Cinthanh1998/Du-an-Foxconn/MVIMG_20251112_134305.jpg

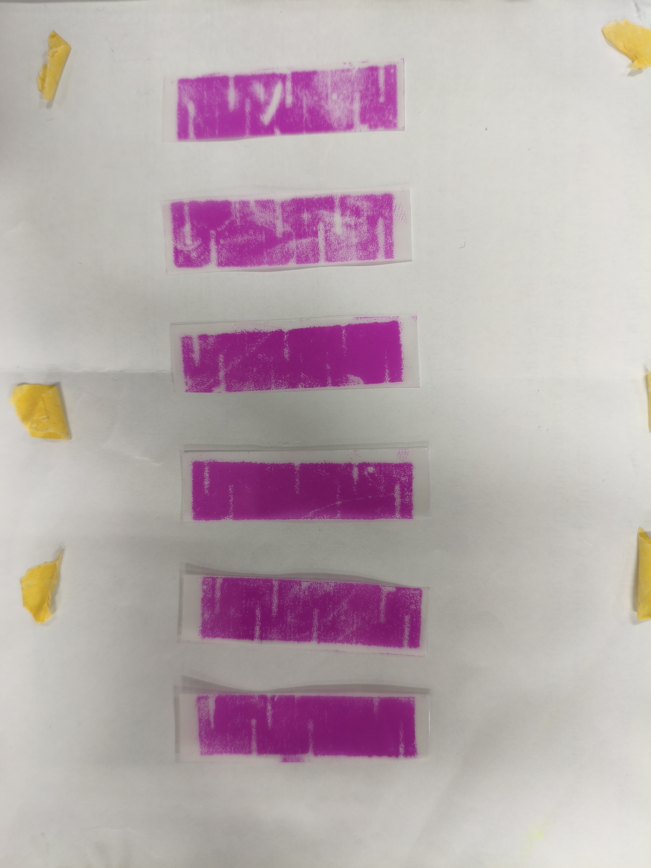
MVIMG_20251112_134305.jpg
