Cinthanh1998/Du-an-Foxconn/IMG_1768631609765_1768632025120.jpg

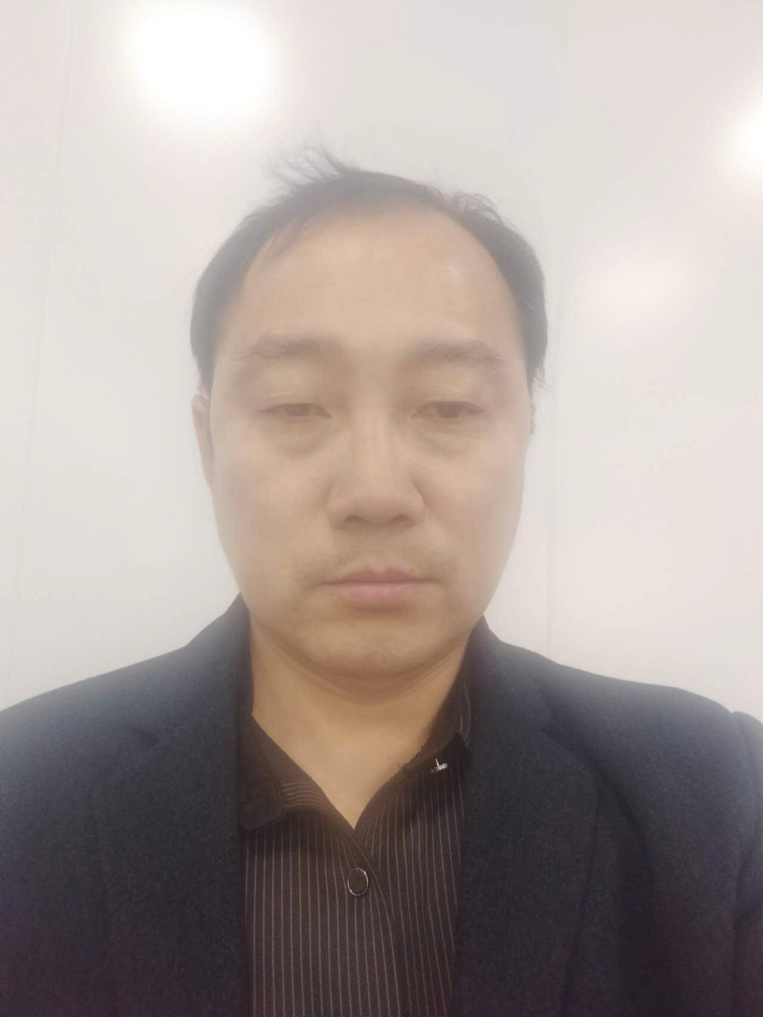
IMG_1768631609765_1768632025120.jpg
