Cinthanh1998/Du-an-Foxconn/ME weekly Report format.pptx

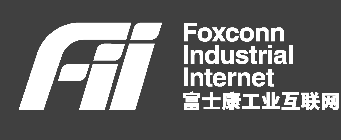
[picture p3: figure]

1.Weekly key job list Owner: Francis

NO | Work content | Description | Owner | status | Due date
1 | Giraffe Auto screw DFM | 1.Get all auto screw machine DFMs and reviewed with Lotus--->2/21 2. Give feedback to screw machine suppliers and ask them to update the DFM based on customer’s requests.---> 2/24 3. Send out the updated auto screw DFMs to customer by 2/28 and waiting for final approval.--->3/2 4. All the auto screw machine DFMs approved by customer--->3/4. | Francis | Closed | 3/2
2 | Giraffe overall auto line DFM | 1.Reviewed with Lotus half of the overall auto line DFMs--->2/21 2.Will plan to review the rest of DFMs with Lotus today--->2/22 3.Will update the DFMs based on customer’s request--->2/25 4.Cusomer has partially approved the overall DFM reports, target to get all machine DFMs approved by 3/5. 5.The overall auto line DFM approved by customer, several open items tracking is in-progress. | Francis/Lan Xiang | On-going | 3/10
3 | Giraffe FPC tray Design | 1.Vendor Mflex emailed us the cost will increase 30% if follow the tray CNT designed.--->2/14 2. Provided to customer an optimized tray design, waiting for customer’s final evaluation--->3/5 3. Mflex provided us an optimized tray design, we gave feedback to supplier, waiting for their modification.--->3/5 4. The final design was locked down and aligned by 2 suppliers.--->3/7 | Francis | Closed | 3/5
4 | FPC press machine meet target UPH solution | 1.Send out Giraffe FPC press machine design& fabrication schedule to customer, need get final press time spec by 4/20, waiting for customer’s DOE trail run plan.--->3/5 | Francis/Lan Xiang | On-going | 4/20
5 | CNT new solder paste validation | 1.The samples for SIR and electron transfer has send out to Su Zhou Lab, waiting for the test result. 1.The system MOC has sign-off --->2/21 2.Will send out the paper MOC to SMT technical department to sign--->2/22 3.The 2nd batch of solder paste cross-section & Dye pry test passed and sent to customer--->2/21 4. Delivered the validation report to Central global purchaser, waiting for her to provide quotation.--->3/15 5.Summaried the validation report and send out to customer, will discuss with Heison within this week, target to get approval by 3/5 5.Get the solder paste quotation from centr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 | Francis | On-going | 3/23
6 | Gazelle MLB & MIC Gerber DFM | 1.Customer has released the V1 of MLB and MIC Gerber.--->2/26 2.Provided the DFMs of MLB and MIC on 2/28, waiting for customer’s feedback.--->3/4 3.MLB and MIC Gerbers are almost locked down, waiting for customer’s final confirmation.--->3/8 | Francis | On-going | 3/4

## Slide 2

2. CNT 2nd solder paste implementation plan

Solder paste validation Milestone:

Scheme kick off

System and Paper MOC sign off

12/25

Validation kick off

1/20

Send customer validation report and approve

Large control run validation

12/5

12/14

3/10

New PN setup in Agile & SAP and maintain

Send report to customer and approve

3/11

3/24

Price and purchase environment maintain

Send control run report to customer and approve

Solder paste implementation completion

3/3

3/15

3/27

No. | Qualification Item | Detailed Qualification Plan | Start date | Due date | Actually Due date | Status
1 | Scheme kick off | 1. Solder paste type evaluation and selection. 2.New solder paste and current solder paste parameters comparison. 3. Improve printing and solder quality. | 12/1 | 12/5 | 12/5 | Closed
2 | Send report to customer and approve | 1.Send new solder paste evaluation report to customers. 2.Setup meeting to discuss with customer for the detailed qualification plan. | 12/6 | 12/14 | 12/14 | Closed
3 | System and Paper MOC sign off | 1.System and paper MOC sign off--->2/21 2.SMT E system new samples application sign off, SMT technical team confirmed the vendor will come to factory for the details to discuss.--->1/15 | 12/15 | 2/21 | 2/21 | On-going
4 | Validation kick off | 1. Small control run WO. 2.ORT test. --->1/20 3.Cross-section & Dye Pry test --->2/22 4.Send samples to Su Zhou Lab for SIR and electron transfer test--->3/23 | 12/26 | 3/23 | | On-going
6 | Send customer validation report and approve | 1.Send out the qualification summary report to customer on 2/25. 2. Waiting for Heison and his team’s final approval. | 2/23 | 3/10 | | On-going
7 | Large control run validation | Large control run WO to run samples. | 3/6 | 3/22
8 | Send control run report to customer and approve | Send yield report to customer and approve. | 3/23 | 3/24
9 | New PN setup in Agile & SAP and maintain | Setup new PN. Upload new PN to Agile and SAP systems. | 2/25 | 3/3 | 2/26 | Closed
9 | Price and purchase environment maintain | Price and purchase environment maintenance | 3/4 | 3/15 | 3/5 | Closed
10 | Solder paste implementation completion | Finished validation, Place PO, OK2P. | 3/11 | 3/27

## Slide 3

Analysis of L930 Damage Problems

Data analysis of L930 damaged parts, 2/28~3/5 cumulative damage parts 75PCS, production information is as follows:

Analysis of the bad phenomenon of L930 damaged parts
Bad pictures
Production source | L930 damaged before HDMI reflow | L930 damaged after HDMI reflow soldering
Non-performing rate | 2.7% | 97.3%

Manual assembly

Abnormal Production

WIP板

Board edge number 1#，2#，11#，12#

The occurrence time of damaged parts is concentrated on 2/28-3/1

Abnormal streamline*6pcs
Manual assembly*2pcs

Quantity

12

15

48

- Manually assembled damaged parts 12pcs, accounting for 18.2%
- After the BFT test, the abnormal flow line is 15pcs, accounting for 22.7%
- The WIP board is 39pcs, accounting for 59.1%, and the damaged parts increase with the increase of the WIP board

- The damaged parts of the main board are concentrated on the edge of the board, with a total of 43pcs, accounting for 57.3%, and the risk of board damage during the turnover process of the WIP board is very high.

Line distribution without concentration

WIP 78K

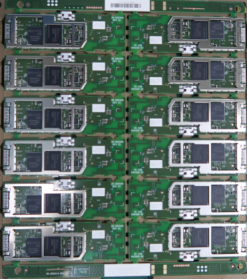
[picture p4: figure]

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
Abnormal streamline*9pcs
Manual assembly*3pcs

EPA7 for manual line

Summary:
1.According to the bad phenomenon analysis, L930 is mainly damaged after reflow and during assembly
2. The board number of defective products is concentrated on the edge of the board, and the risk of picking and placing the board is locked (22.7% of defective products are taken out after BFT test)
3.Through bad data analysis, manual assembly is confirmed, and manual testing is a high-risk workstation;
