Cinthanh1998/Du-an-Foxconn/Stick T-side heat sink Machine-DFM-20260123.pptx

CBD Calla panel
Automatic assembly line
--- Stick T-side heat sink Machine

Jan 23, 2026

## Slide 2

CBD Calla PCBA Assembly Line（New）

Line flow

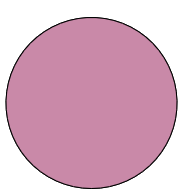
[picture p40: figure]

800

unit：mm

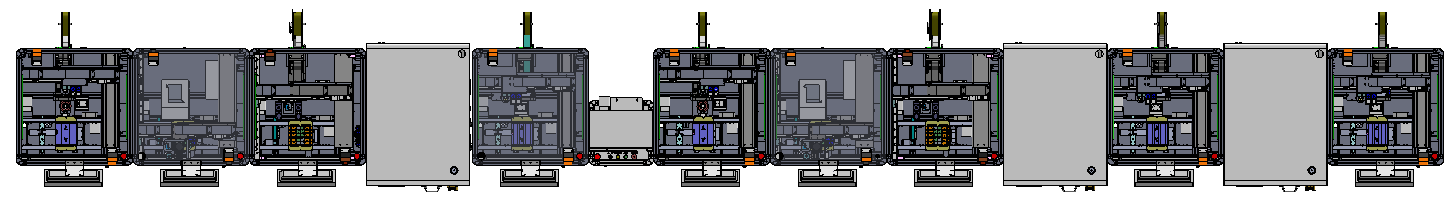
[picture p41: figure]

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
Item | 1 | 2 | 3 | 4 | 5 | 6 | 7 | 8 | 9 | 4 | 11 | 12 | 13
Equipment | Stick B-side EMI Machine | Point B-side heat dissipation paste Machine | Stick B-side heat sink Machine（Robot） | Pressing machine | Stick B-side foam Machine*2 | Flip Over Machine | Stick T-side EMI Machine | Point T-side heat dissipation paste Machine | Stick T-side heat sink Machine（Robot） | Pressing machine | Stick FSS Machine | Pressing FSS machine | Stick T-side foam Machine*2
New /Old | old | old | old | Gs | old | Gs | old | old | old | Gs | new | Gs | old
CT(S) | 6 | 6 | 6 | 4 | 6 | 6 | 6 | 6 | 6 | 4 | 6 | 4 | 6
Feeding method | reel | Plastic bucket | reel | / | reel | reel | / | Plastic bucket | reel | / | reel | / | reel

Automation Assembly Line UPH ：500PCS/H
Automation Assembly Line Dimension ： L 11020mm * W 1500mm * H 1620mm (For reference, according to the actual)

Auto machine(new)

Auto machine(old)

Auto machine（Guest supply）

## Slide 3

CBD Cony PCBA Assembly Line（Old）

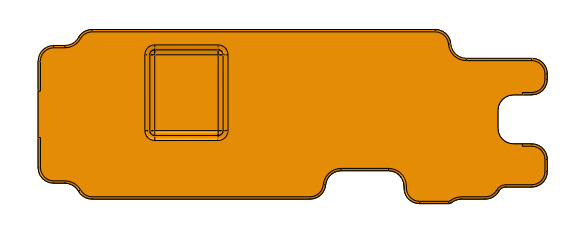
[picture p42: figure]
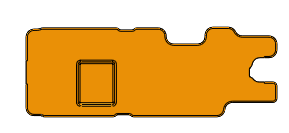
[picture p43: figure]

Line flow

Auto machine(old)

unit：mm

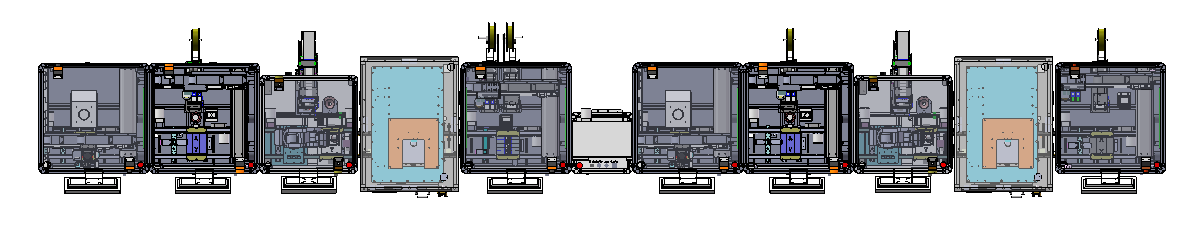
[picture p44: figure]

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
Item | 1 | 2 | 3 | 4 | 5 | 7 | 8 | 9 | 10 | 11 | 12
Equipment | Point B-side heat dissipation paste Machine | Stick B-side EMI Machine | Stick B-side heat sink Machine | Pressing machine | Stick B-side foam Machine*2 | Flip Over Machine | Point T-side heat dissipation paste Machine | Stick T-side EMI Machine | Stick T-side heat sink Machine | Pressing machine | Stick T-side foam Machine*1
New /Old | old | old | old | new | old | Gs | old | old | old | new | old
CT(S) | 4 | 5 | 6 | 3 | 6 | | 6 | 5 | 6 | 3 | 6
Feeding method | Plastic bucket | reel | reel | / | reel | / | Plastic bucket | reel | reel | / | reel

Automation Assembly Line UPH ：500PCS/H
Automation Assembly Line Dimension ： L 9300mm * W 1500mm * H 1620mm (For reference, according to the actual)

Auto machine(new)

Auto machine（Guest supply）

## Slide 4

Contents

Item | Description | DRI
1 | Historical Versions | Wang hao
2 | Machine performance design | Wang hao
3 | Product Change | Wang hao
4 | Equipment Layout | Wang hao
5 | The key components | Wang hao
6 | Key Fixture Design | Wang hao
7 | Action flow design | Wang hao
8 | Timing diagram | Wang hao

unit：mm

3

## Slide 5

1. Historical Versions

Version | Description | Date | DRI | Remark
V01 | Initial design version | 2026/01/23 | Wang hao

unit：mm

4

## Slide 6

2. Machine performance design

Function ：

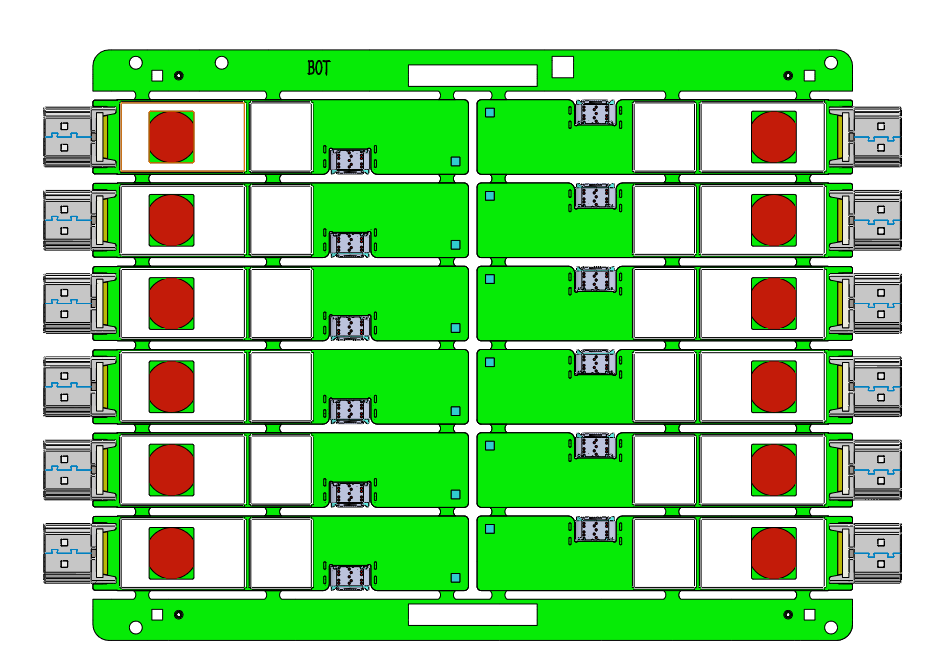
[picture p45: figure]
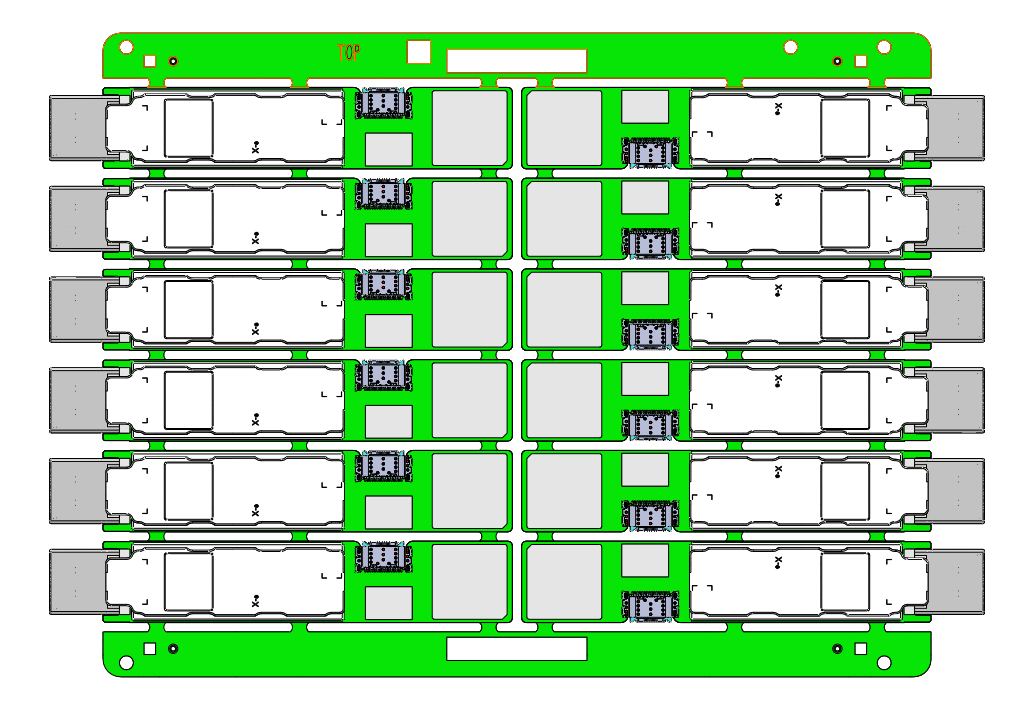
[picture p46: figure]

Attach the heat dissipation sheet*12 to the PCBA board

unit：mm

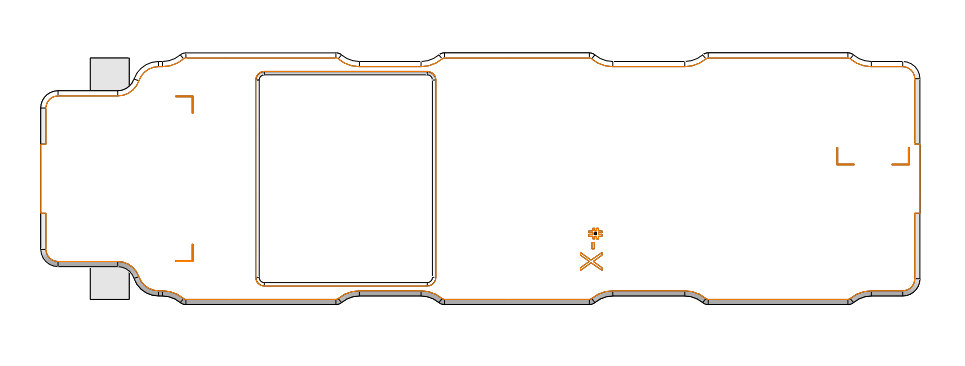
[picture p47: figure]

Heat sinks*12

PCBA board

purpose | Remove the heat dissipator*12 from the label dispenser and attach it to the PCBA board
PCBA board | 137.6*199.8mm
tool | TABLE Transfer components，Nozzle，CCD，Bid dispenser，Actuators
process | CCD calibration
UPH requirements | 900PCS

5

## Slide 7

3.Product Change

PCBA：

unit：mm

Cony

Calla

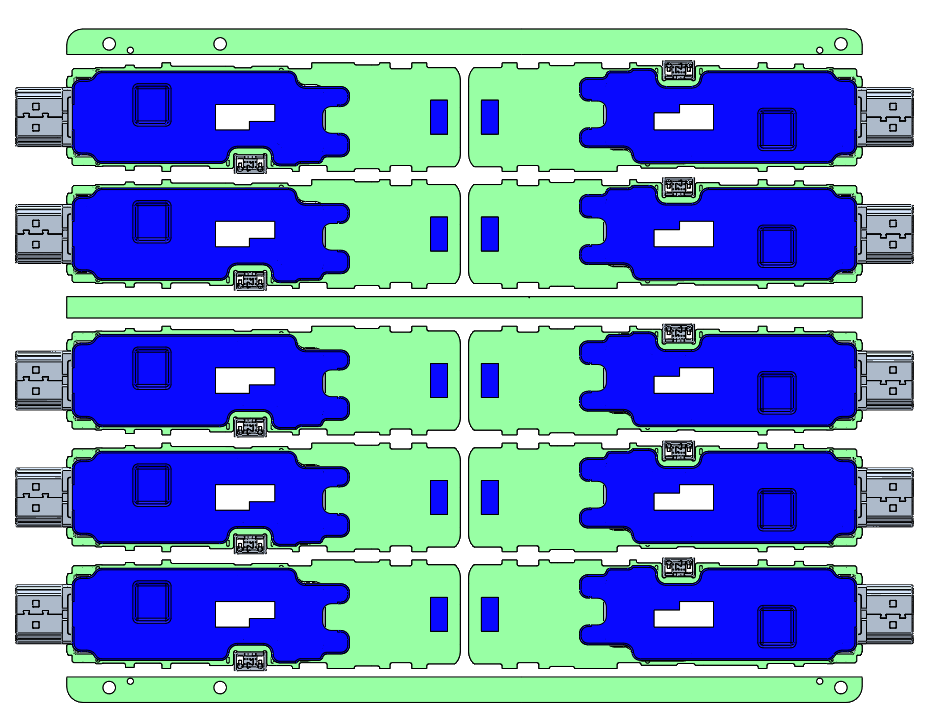
[picture p48: figure]

187.8mm

159mm

Need to change the image from Calla newest panel design Drw, the W reduce from 184mm to 177 mm

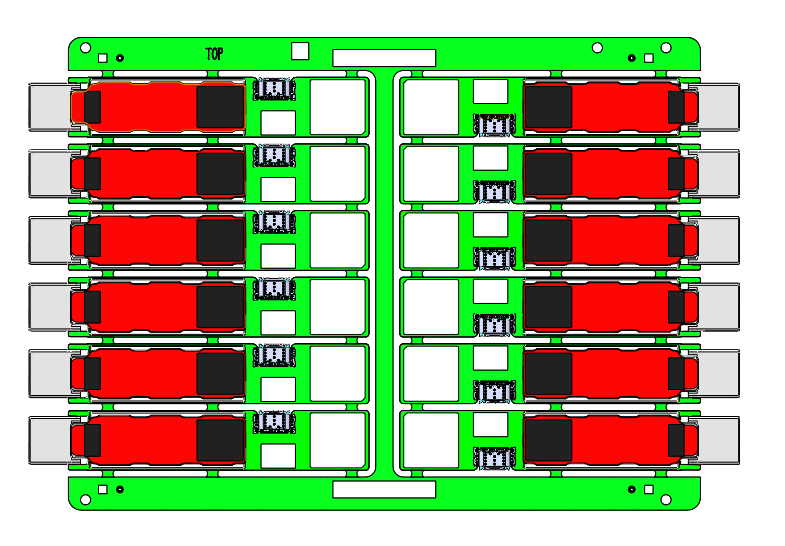
[picture p49: figure]

184mm

137.6mm

6

## Slide 8

4. Machine layout

335mm

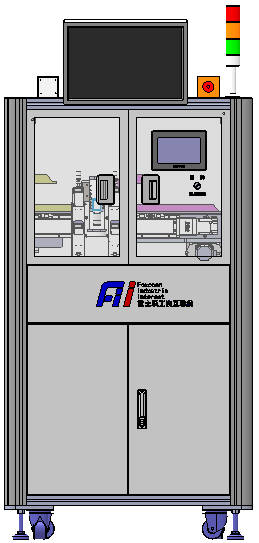
[picture p50: figure]
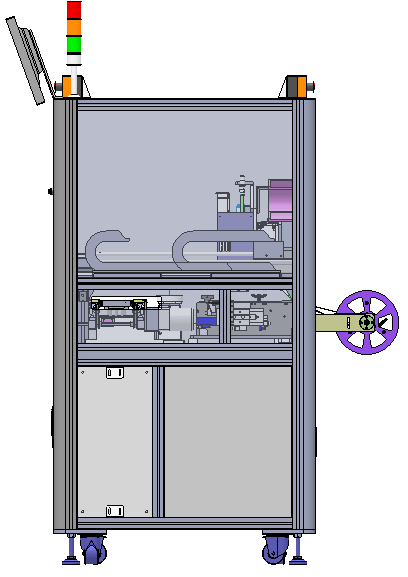
[picture p51: figure]

unit：mm

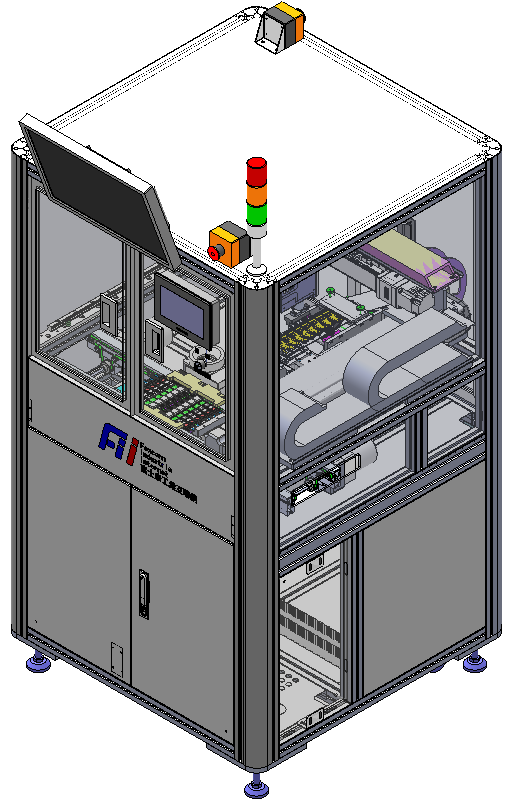
[picture p52: figure]

| automatic | manual
CT | 48.0S | /
UPH | 500PCS | /

PC

Touch screen

Tricolor lamp

1630mm

500mm

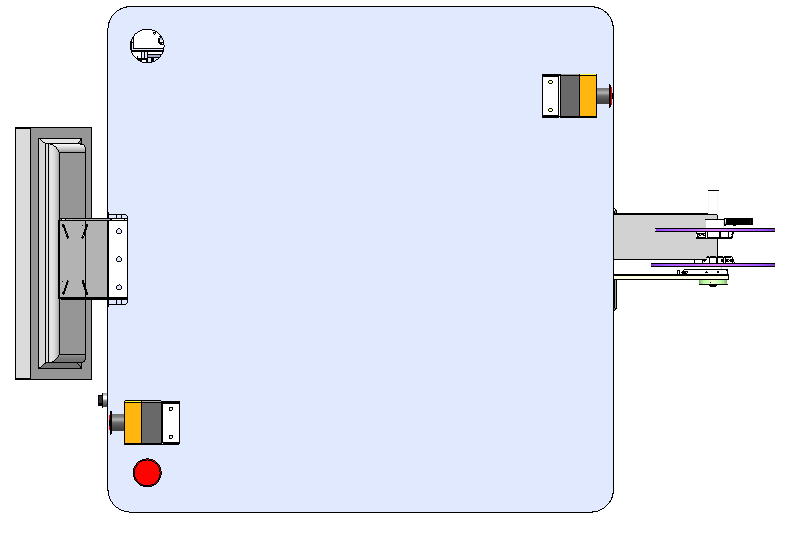
[picture p53: figure]

287.5mm

165.5mm

7

## Slide 9

4. Machine layout

unit：mm

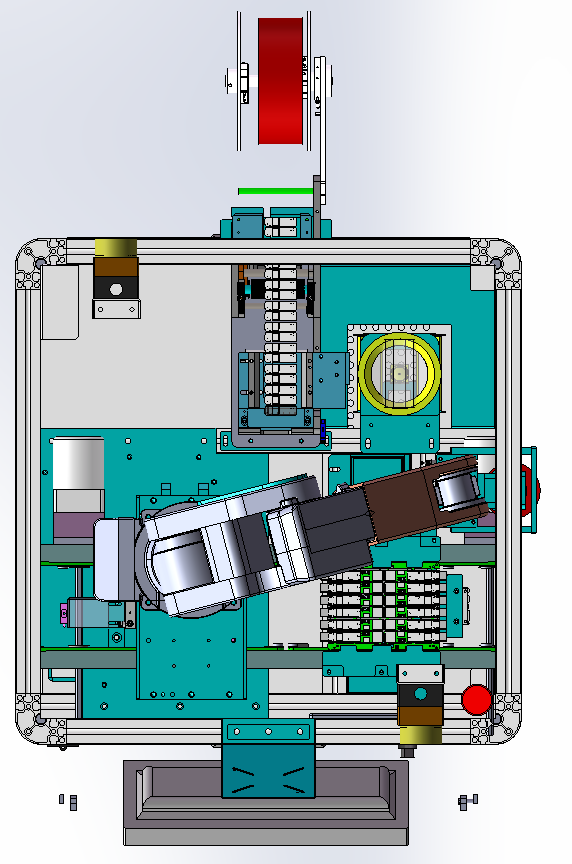
[picture p54: figure]

5

Bidding machine (feeding)

item | Process flow
1 | Conveyor line flow buffer
2 | Infeed conveyor line
3 | Position the component(Clamp the PCBA board)
4 | Robot
5 | Bidding machine (feeding)
6 | under CCD components(Label fills ）
7 | Upper CCD & Reclaiming Assembly(Product positioning ）
8 | Buffer after the flow of the conveyor line

4

Robot

6

under CCD components(Label fills ）

7

Upper CCD & Reclaiming Assembly(Product positioning ）

3

Position the component(Clamp the PCBA board)

8

Buffer after the flow of the conveyor line

2

Infeed conveyor line

1

Conveyor line flow buffer

8

## Slide 10

4. Machine layout

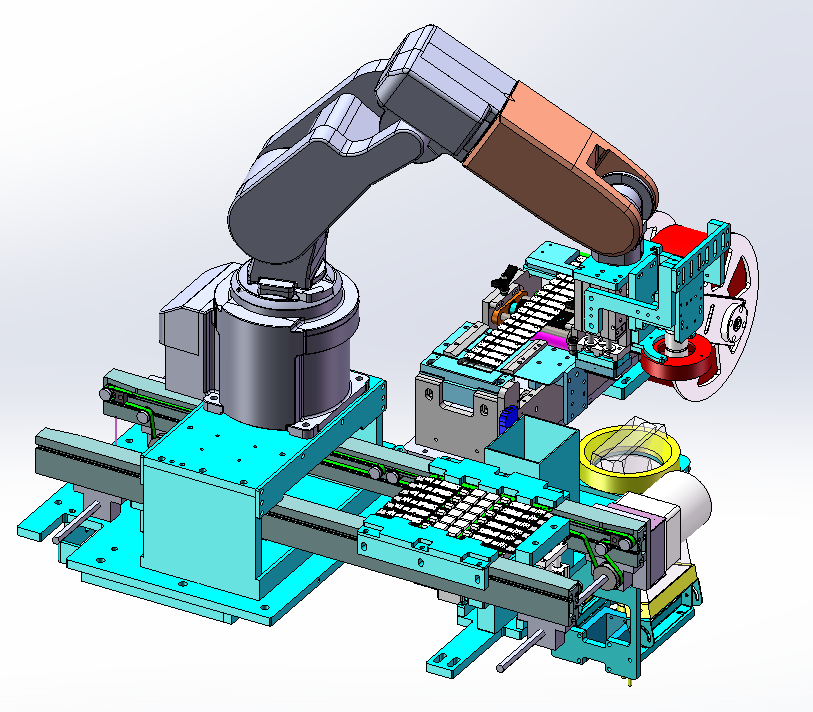
[picture p55: figure]

2

Robot

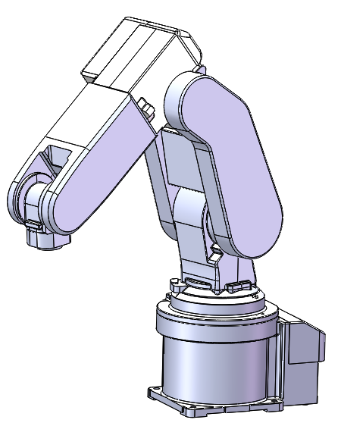
[picture p56: figure]

3

Upper CCD & Reclaiming Assembly

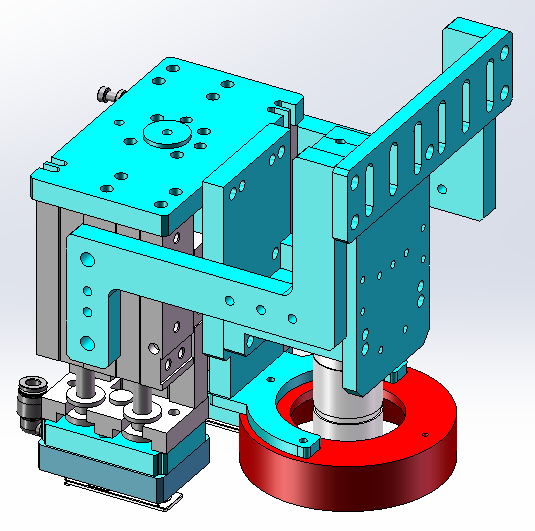
[picture p57: figure]

unit：mm

4

Bid dispenser

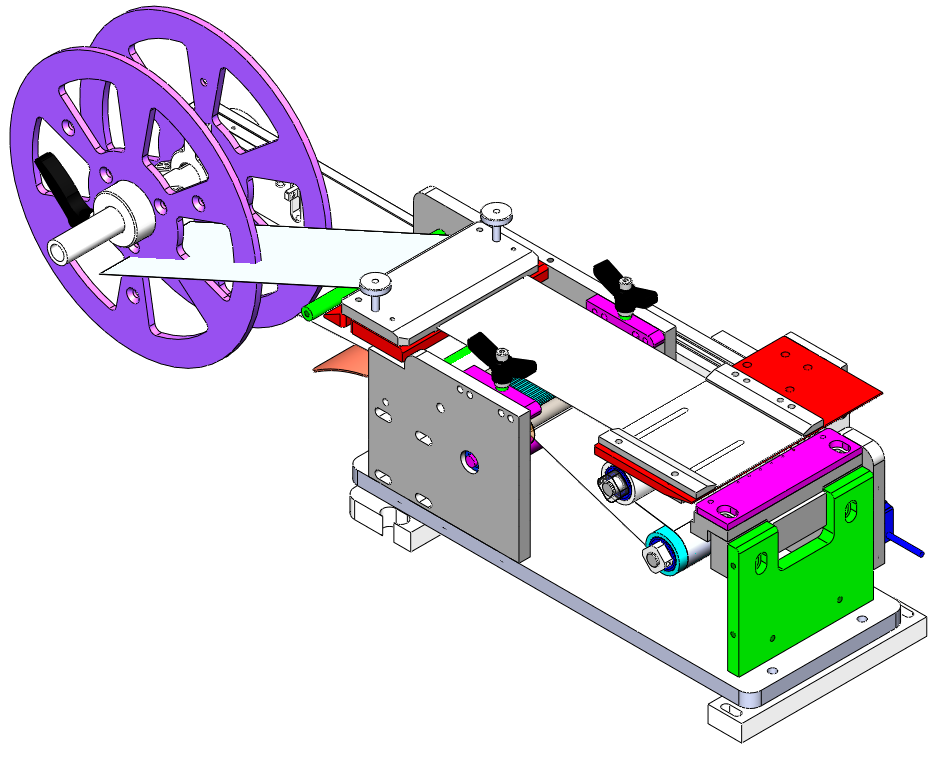
[picture p58: figure]

1

Infeed conveyor line

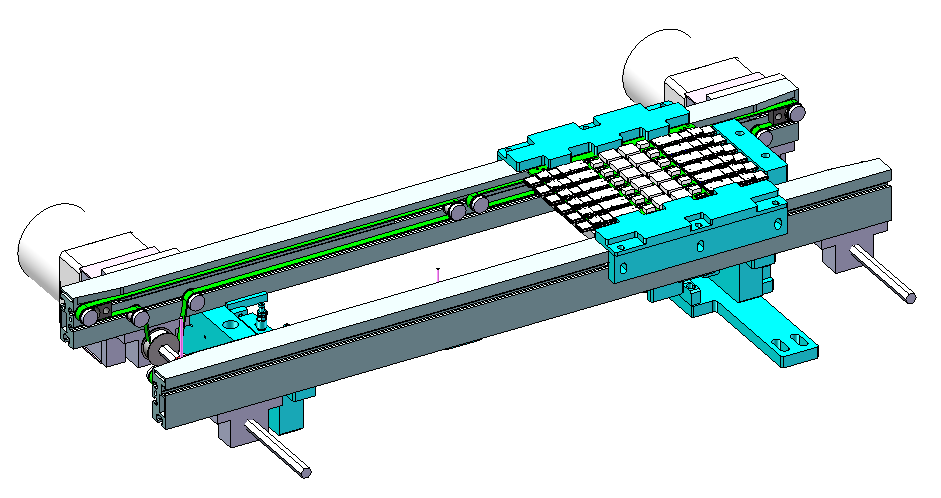
[picture p59: figure]

5

Under CCD

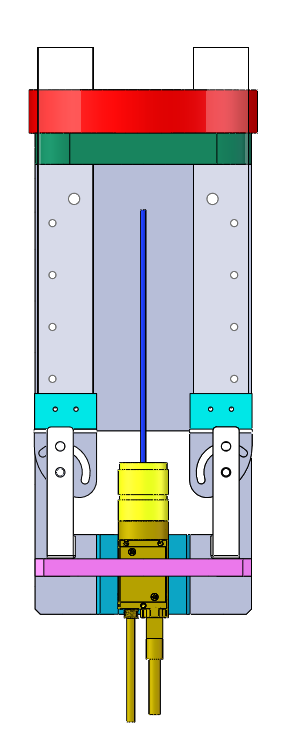
[picture p60: figure]

9

## Slide 11

5. The key components

5.1 Feed conveyor line

PCBA in place deceleration sensor

PCBA blocking cylinder

PCBA jacking cylinder

Motor

PCBA lifting limit component

PCBA support board

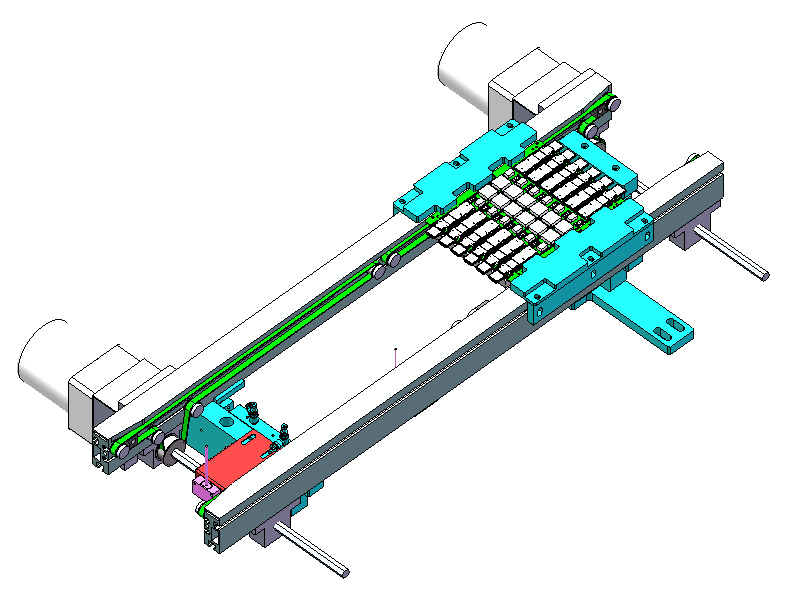
[picture p61: figure]

PCBA board positioning process:
1.The PCBA board flows into the conveyor line, and the CX-461A senses that the conveyor line
slows down and blocks the PCBA board from the blocking cylinder.
2.The lifting cylinder is pushed out to position the PCBA board.

Due to changes in the length
of the PCBA, need to
change the blocking block of
the blocking cylinder

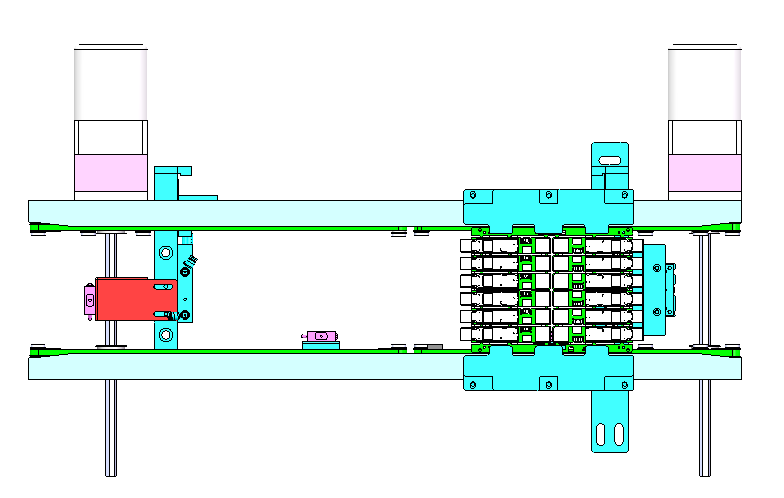
[picture p62: figure]

138.6mm

Sensor CX-461A
Detect whether the PCBA drives into the conveyor line

Sensor CX-461A
Detect whether the PCBA drives into the conveyor line

10

## Slide 12

5. The key components

5.1 Feed conveyor line

clamping position

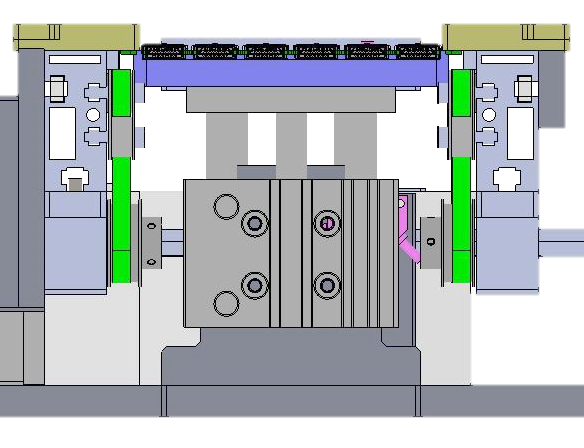
[picture p63: figure]

PCBA board clamping:
1. PCBA board arrives at the assembly position;
2, the block cylinder is blocked out3. At the same time, the support plate rises to support the PCBA board.

unit：mm

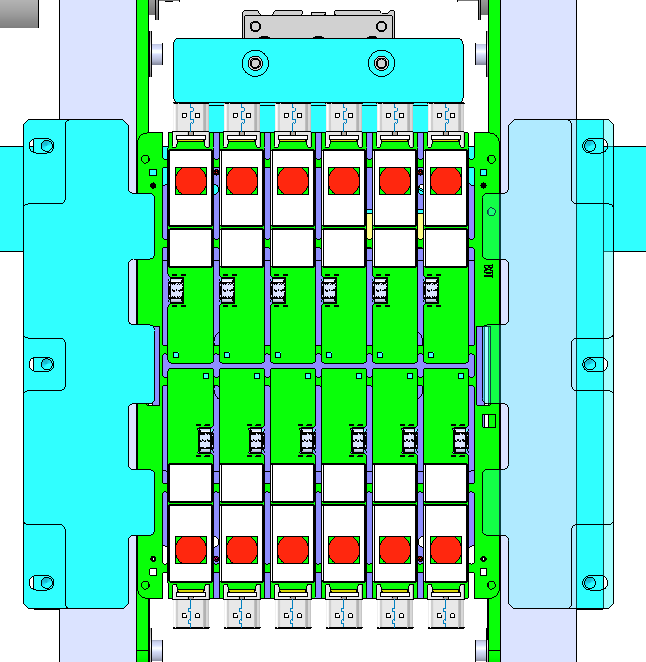
[picture p64: figure]

The clamp block is in contact with the edge strip of the connecting plate 3.8mm

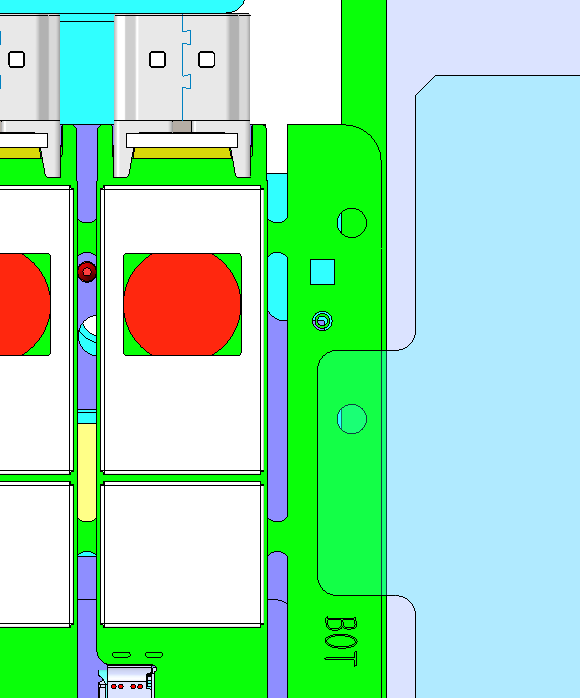
[picture p65: figure]

The distance between the connecting plate and the edge of the conveyor line is 0.5mm

11

## Slide 13

5. The key components

The PCB foam on the
front end is 1.1mm
away from the edge
of the avoidance slot

1.1mm

1.3mm

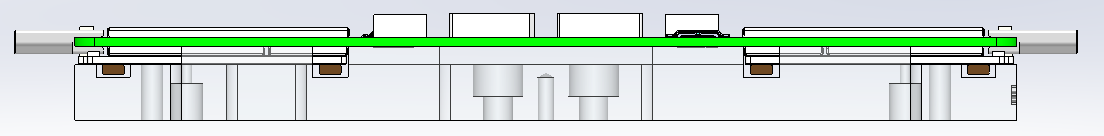
[picture p66: figure]

40mm

The size of the
scanner avoidance
slot is 18x40mm

The PCB foam on the
rear end is 1.3mm
away from the edge
of the avoidance slot

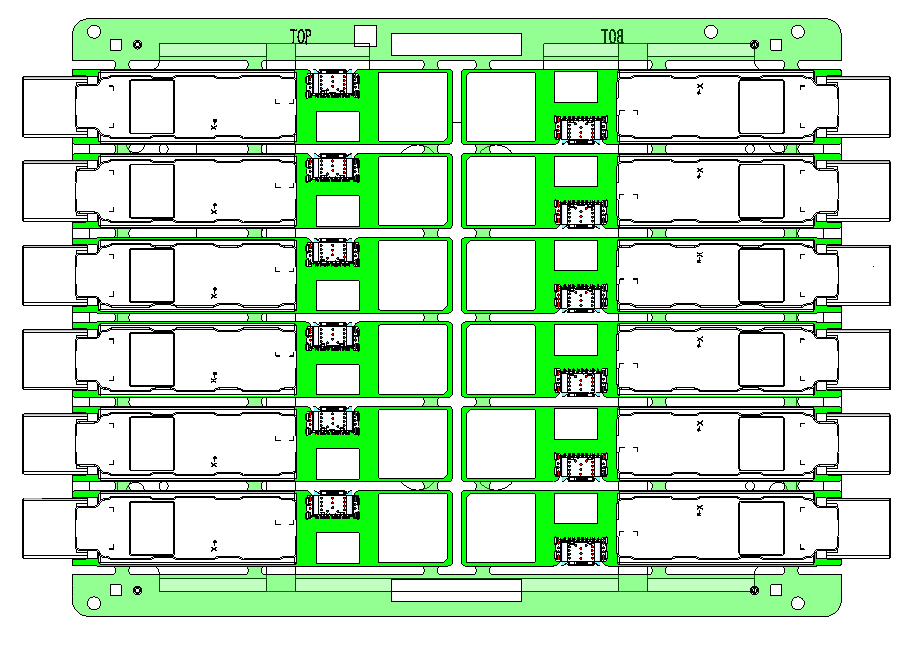
[picture p67: figure]

5.1 Feed conveyor line

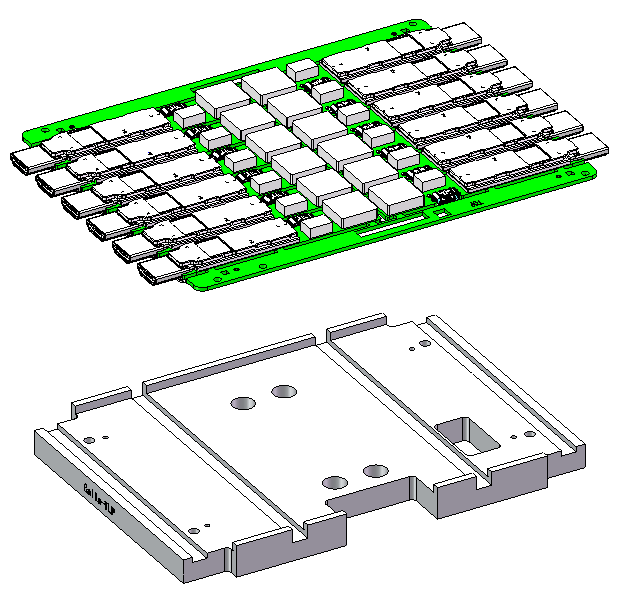
[picture p68: figure]

T-side jacking plate(A6061)

unit：mm

12

## Slide 14

5. The key components

5.2 Robot

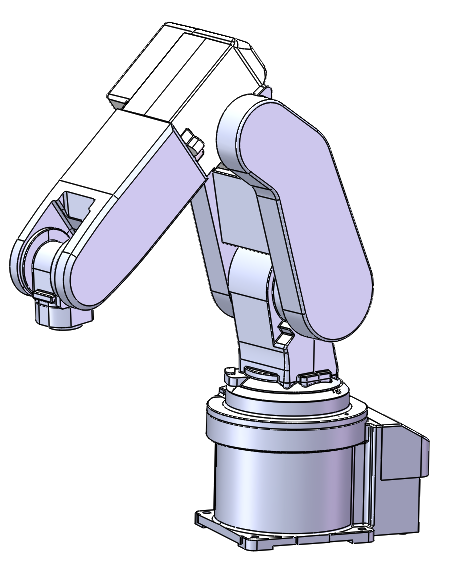
[picture p69: figure]

1

unit：mm

Maximum lifting weight 最大可搬重量 | 3KG
Arm length 臂長 | 504mm
Positional repeatability 位置重複精度 | ±0.02mm
Accuracy of software algorithm 软件算法精度 | ±0.02

位置重複精度 =±0.02mm；
Positional repeatability =±0.02mm；
組裝精度=位置重複精度 +下蓋CCD识别精度+PCB CCD识别精度+软件算法精度：±（0.02+0.0025+0.0025+0.02）=0.045mm。
Assembly accuracy = Positional repeatability + front housing CCD identification accuracy + PCB CCD identification accuracy+softwarealgorithmaccuracy:±(0.02+0.0025+0.0025+0.02) =0.045mm。

RV-2FR

13

## Slide 15

5. The key components

5.3 Material Fetching Component

Upper CCD

light source

Nozzle

1

unit：mm

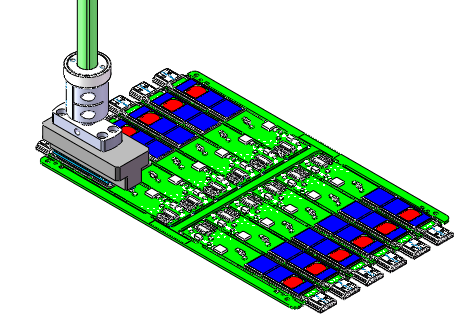
[picture p70: figure]

14

## Slide 16

5. The key components

5.4 Feeder

2

Bid dispenser
category | 120-Forward push type bid dispensing machine (standard machine）
UPH | 1s/pcs
The maximum diameter of the coil | 76mm
Maximum strip width | 69.855mm
The quantity of a single roll of material | estimate500

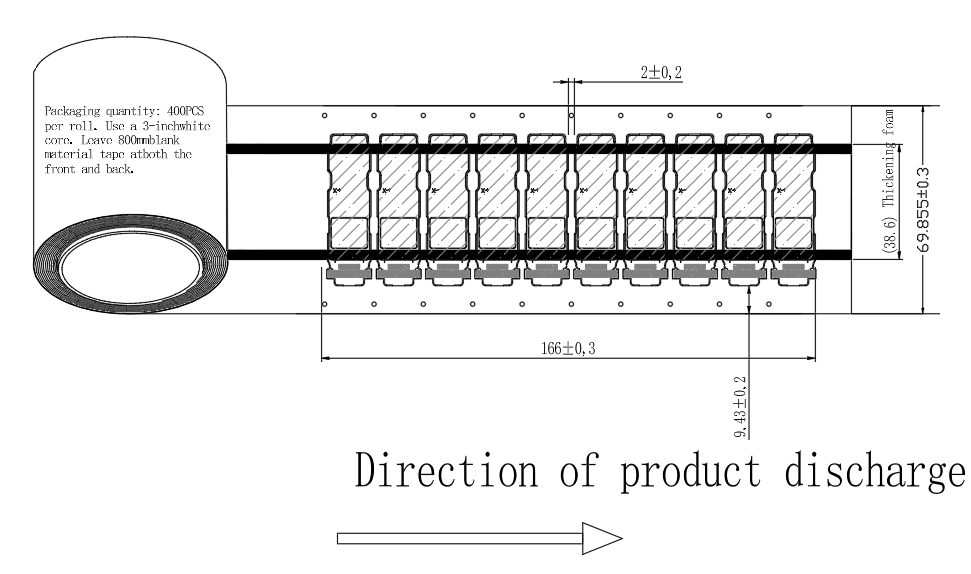
[picture p71: figure]

unit：mm

Schematic of coil material

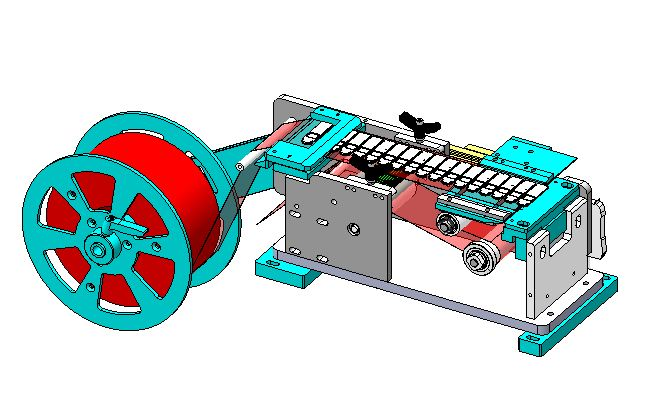
[picture p72: figure]

Material-sensing optical fibers

Reclaiming area

Note: It is recommended to manually wipe and clean the bidding platform with a dust-free cloth once per shift.

15

## Slide 17

5. The key components

5.5 Upper CCD

Hardware name | Model | quantity
camera | FM-GE500-22M | 1
lens | RICOH/FL-CC2514-2M | 1
Lap pick-up | not | 0
light source | Light source/Hua Zhou/LRS-90W60 | 1
Light source controller | DKZ2-24V-2-AC | 1

Camera mounting orientation | Turn your back to the man-machine↑
The distance between the camera surface → the product | 350±10 mm
The light source → the camera surface | 50±10mm
visual field | 72mm*54mm
Image pixel size | 2592*1944
Camera single-pixel accuracy | 0.028

1

layout：

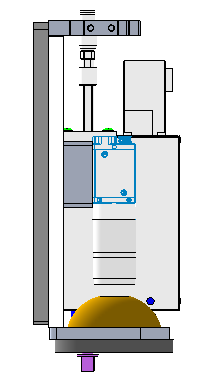
[picture p73: figure]

camera：FM-GE500-22M

camera lens：FL-CC1214A-2M

optical source：DRL-80W

50±10mm

350±10mm

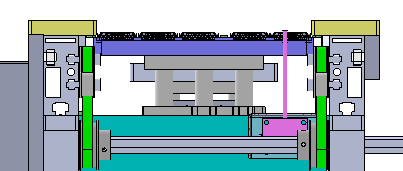
[picture p74: figure]

PCBA

unit：mm

## Slide 18

5. The key components

1.Take Mark1 and Mark2 to calculate the Mark center of the camera to find the position.
The image processing method is NCC Pattern + Fit Circle

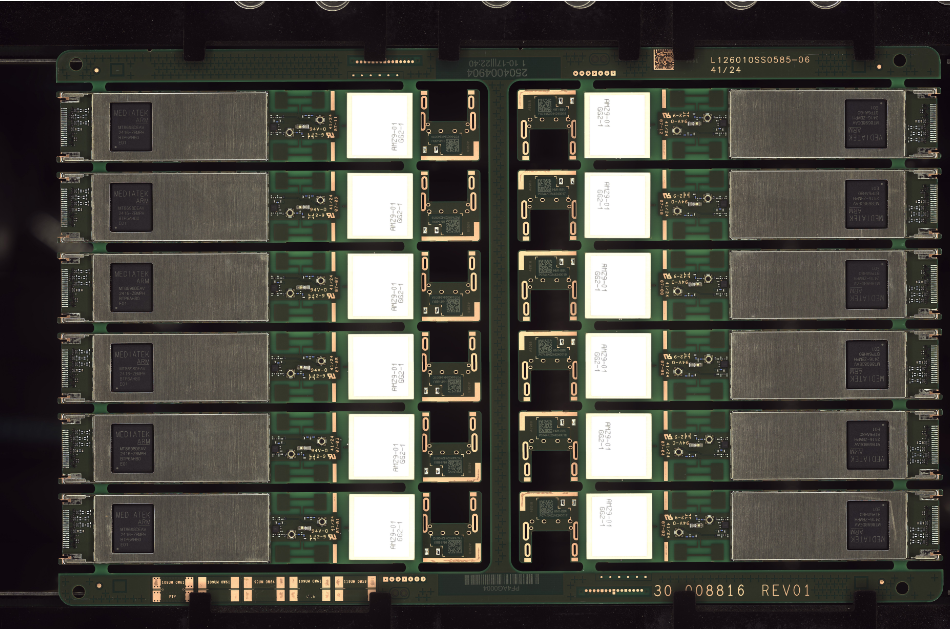
[picture p75: figure]

CCDUPMark1

CCDUPMark2

Need to change the image from Calla newest panel design Drw, the W reduce from 184mm to 177 mm

5.5 Upper CCD

UpCCD image processing:
1.UpCCDMark Photo Location
2.Check for putting EMI
3.Check for putting Heat sinks

2

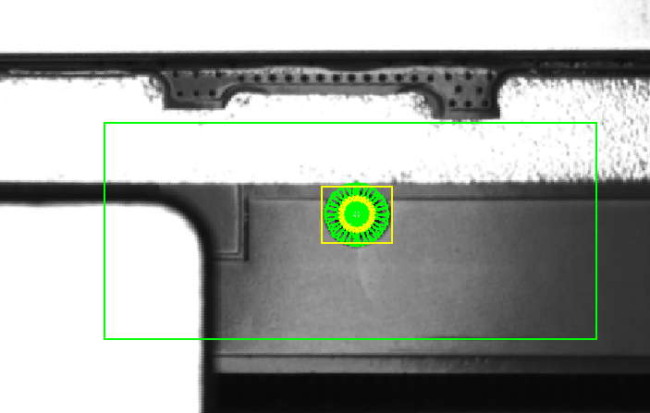
[picture p76: figure]

Mark image processing

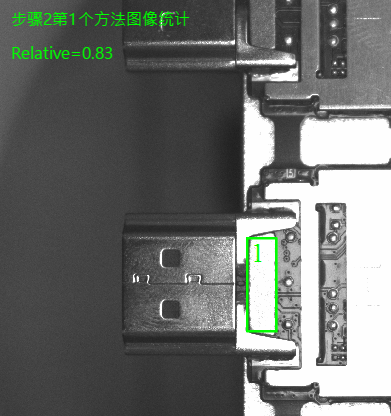
[picture p77: figure]

Bot Side

2.Check：Whether there is EMI & Heat sinks
The image processing method is Image Statistic / YoloV5 Object Detection

## Slide 19

5. The key components

5.5 Lower CCD

Hardware name | Model | quantity
camera | FM-GE500-22M | 1
lens | RICOH/FL-CC2514-2M | 1
Lap pick-up | not | 0
light source | Light source/Hua Zhou/LRS-132W30 | 1
| Light source/Hua Zhou/BAR-108W30 | 2
Light source controller | DKZ2-24V-2-AC | 1

Camera mounting orientation | Turn your back to the man-machine↓
The distance between the camera surface → the product | 350±10 mm
The light source → the camera surface | 40±10mm
The camera surface → a ring-light source | 215±10mm
visual field | 72mm*54mm
Image pixel size | 2592*1944
Camera single-pixel accuracy | 0.028

3

camera：FM-GE500-22M

layout：

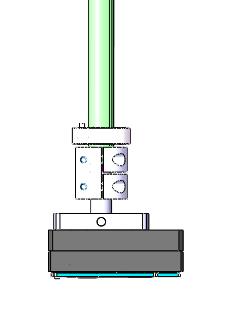
[picture p78: figure]

unit：mm

material
Heat sinks

215±10mm

optical source：LRS-132W30

350±10mm

optical source： BAR-108W30

40±10mm

camera lens：FL-CC3516-2M

## Slide 20

5. The key components

5.5 Lower CCD

DnCCD image processing:
1.DnCCDMark Photo Location

4

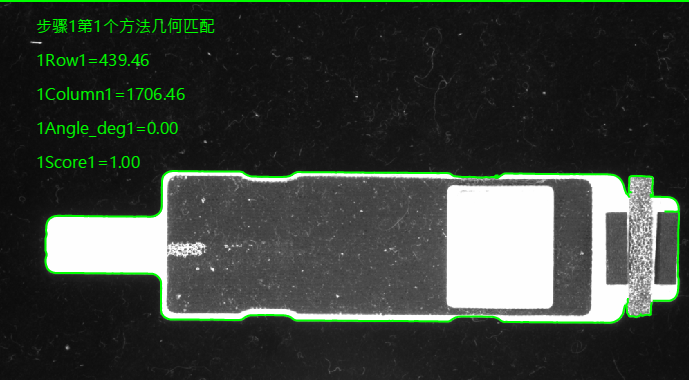
[picture p79: figure]

Take Mark1 to calculate the Mark center of the camera and the angle to find the position.
The image processing method is Shape Pattern

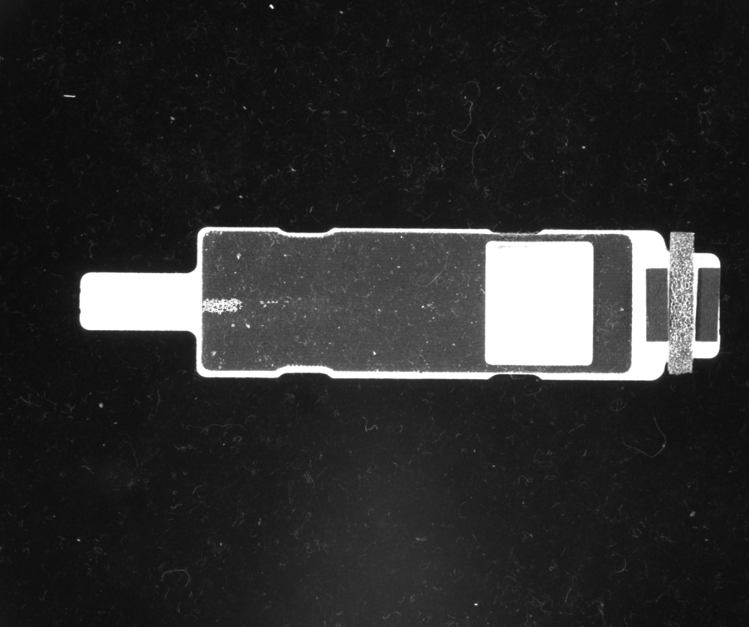
[picture p80: figure]

Need to change the Heatsink image of Calla instead of Cony

## Slide 21

6. The key components

6.1 Feed suction nozzle

1

unit：mm

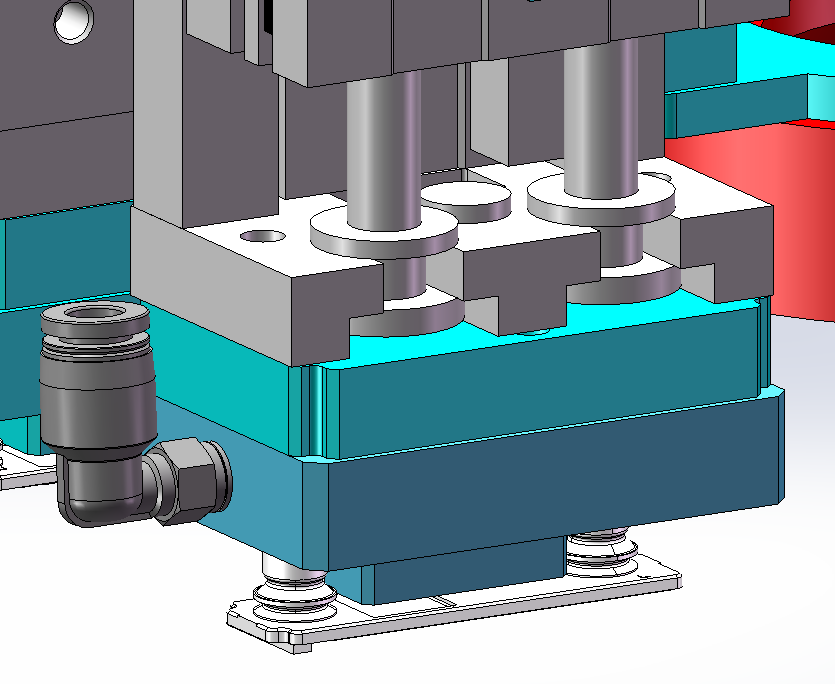
[picture p81: figure]
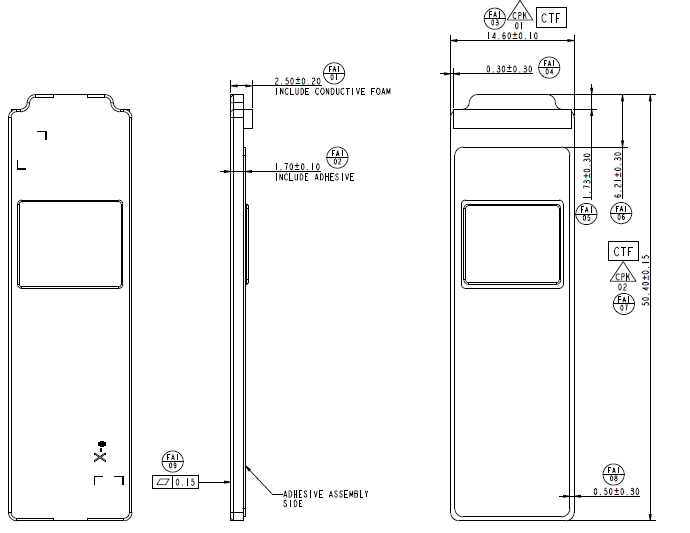
[picture p82: figure]
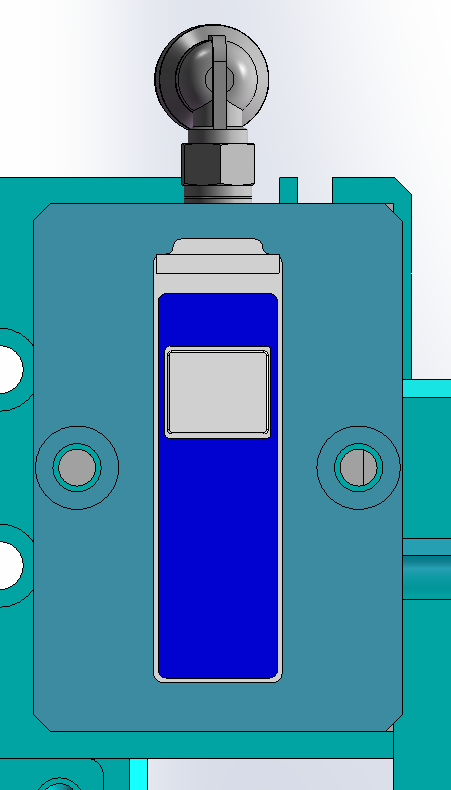
[picture p83: figure]

The adsorption surface is customized according to the shape of each excipient

20

## Slide 22

7. Action flow design

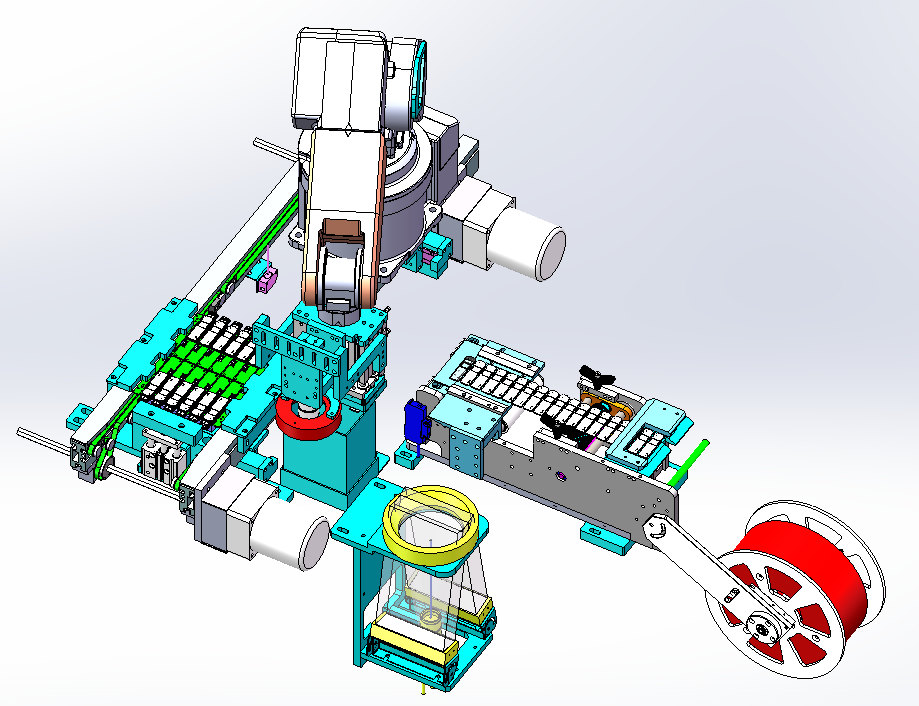
[picture p84: figure]

Step1: The PCBA board of the front transmission line flows in, blocking the cylinder from rising, the sensor in place responds, and the top cylinder rises, and the PCBA link is clamped to block the cylinder from descending

Step2: The CCD identifies and locates the Mark point of the PCBA

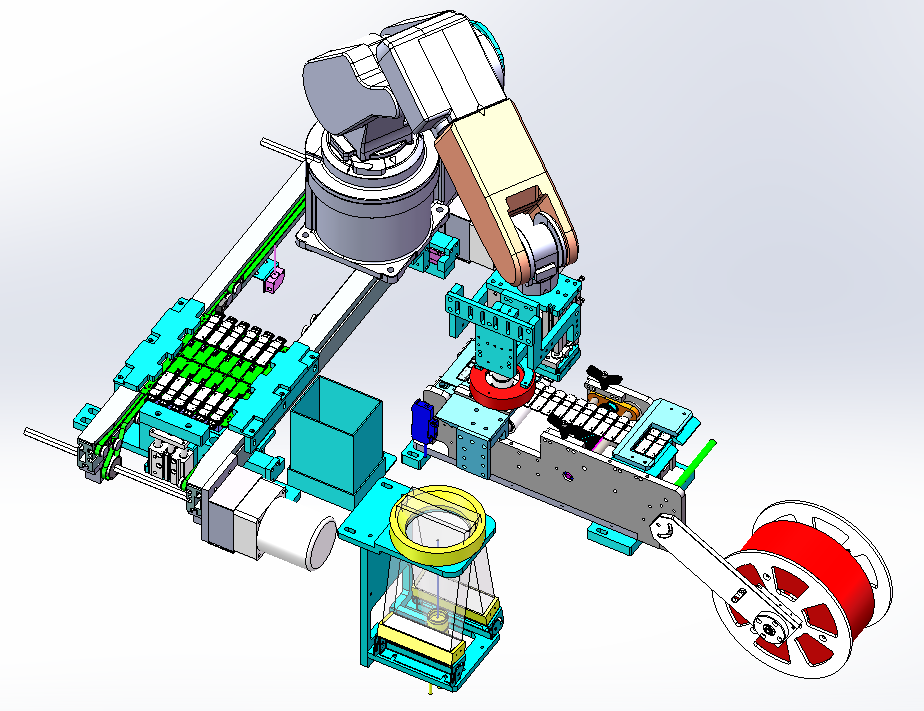
[picture p85: figure]

Step3: The placement head moves to the reclaiming area to pick up the loose heat sheets

unit：mm

Step5: The jacking cylinder descends, and the conveyor line at the back section of the PCBA board enters the next process

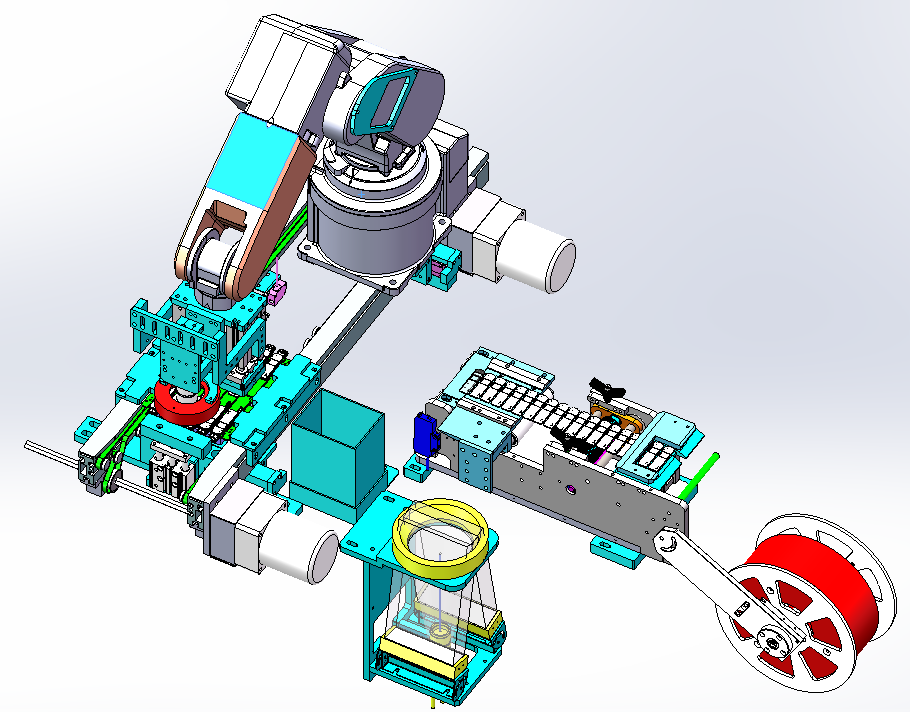
[picture p86: figure]

Step5: The placement head is moved to the placement area for placement

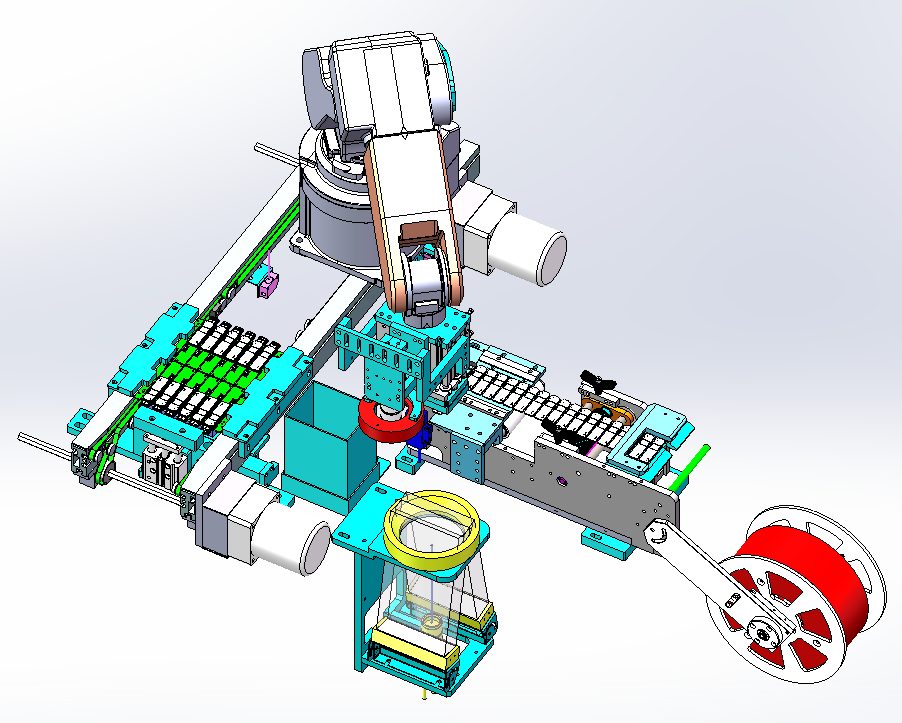
[picture p87: figure]

Step4: The placement head is moved to the lower CCD to identify EMI

21

## Slide 23

8. Timing diagram

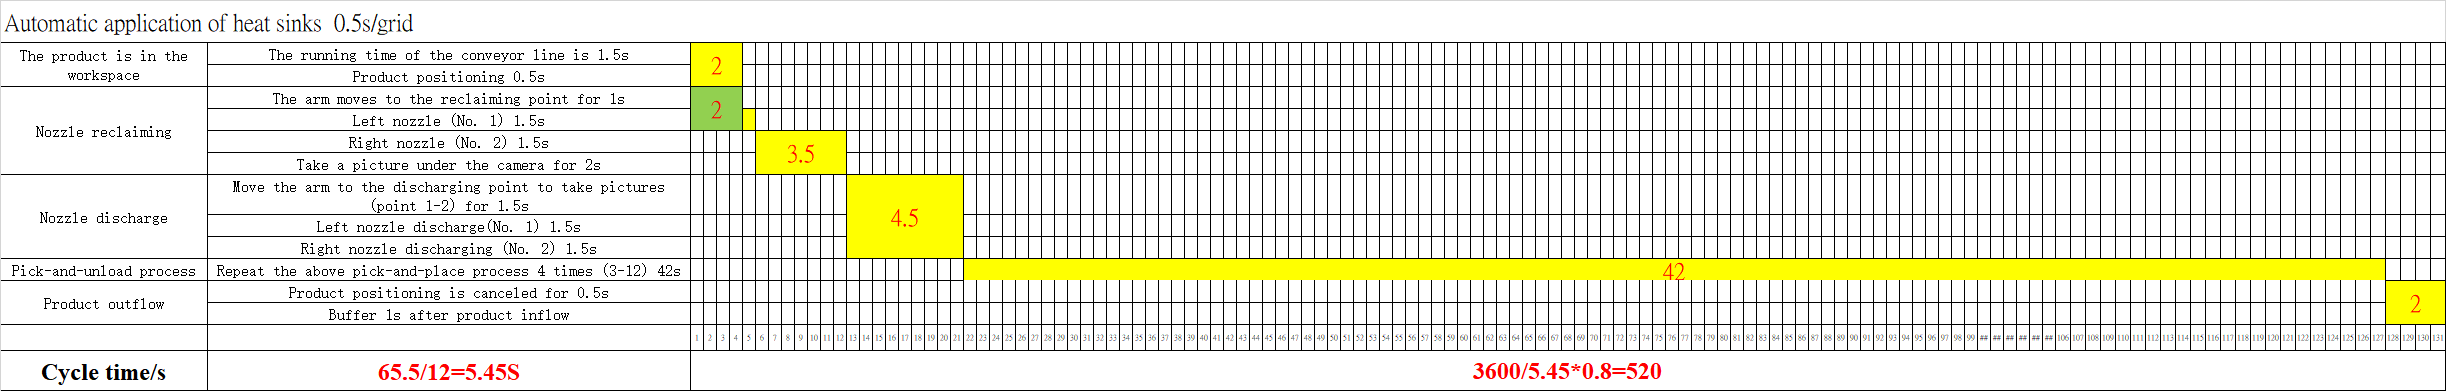
[picture p88: figure]

unit：mm

UPH≈3600/(65.5/12)*0.8 ≈520
Note：80% is estimated OEE, only for UPH calculation. not real product data

22

## Slide 24

Thank you

23
