Cinthanh1998/Du-an-Foxconn/Stick B-side EMI  Machine-DFM-20260123 .pptx

CBD Calla panel
Automatic assembly line
--- Stick B-side EMI Machine

Jan 23, 2026

## Slide 2

CBD Calla PCBA Assembly Line（New）

Line flow

900


unit：mm


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
Item | 1 | 2 | 3 | 4 | 5 | 6 | 7 | 8 | 9 | 4 | 11 | 12 | 13
Equipment | Stick B-side EMI Machine | Point B-side heat dissipation paste Machine | Stick B-side heat sink Machine（Robot） | Pressing machine | Stick B-side foam Machine*2 | Flip Over Machine | Stick T-side EMI Machine | Point T-side heat dissipation paste Machine | Stick T-side heat sink Machine（Robot） | Pressing machine | Stick FSS Machine | Pressing FSS machine | Stick T-side foam Machine*2
New /Old | old | old | old | Gs | old | Gs | old | old | old | Gs | new | Gs | old
CT(S) | 6 | 6 | 6 | 4 | 6 | 6 | 6 | 6 | 6 | 4 | 6 | 4 | 6
Feeding method | reel | Plastic bucket | reel | / | reel | reel | / | Plastic bucket | reel | / | reel | / | reel

Automation Assembly Line UPH ：500PCS/H
Automation Assembly Line Dimension ： L 11020mm * W 1500mm * H 1620mm (For reference, according to the actual)

Auto machine(new)

Auto machine(old)

Auto machine（Guest supply）

## Slide 3

CBD Cony PCBA Assembly Line（Old）


Line flow

unit：mm


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
Item | 1 | 2 | 3 | 4 | 5 | 7 | 8 | 9 | 10 | 11 | 12
Equipment | Point B-side heat dissipation paste Machine | Stick B-side EMI Machine | Stick B-side heat sink Machine | Pressing machine | Stick B-side foam Machine*2 | Flip Over Machine | Point T-side heat dissipation paste Machine | Stick T-side EMI Machine | Stick T-side heat sink Machine | Pressing machine | Stick T-side foam Machine*1
New /Old | old | old | old | new | old | Gs | old | old | old | new | old
CT(S) | 4 | 5 | 6 | 3 | 6 | | 6 | 5 | 6 | 3 | 6
Feeding method | Plastic bucket | reel | reel | / | reel | / | Plastic bucket | reel | reel | / | reel

Automation Assembly Line UPH ：500PCS/H
Automation Assembly Line Dimension ： L 9300mm * W 1500mm * H 1620mm (For reference, according to the actual)

Auto machine(new)

Auto machine(old)

Auto machine（Guest supply）

## Slide 4

Contents

Item | Description | DRI
1 | Historical version | Wang hao
2 | Machine performance design | Wang hao
3 | Product Change | Wang hao
4 | Equipment Layout | Wang hao
5 | The key components | Wang hao
6 | Key Fixture Design | Wang hao
7 | Action flow design | Wang hao
8 | Timing diagram | Wang hao

unit：mm

3

## Slide 5

1. Historical version

Version | Description | Date | DRI | Remark
V01 | Initial design version | 2026/01/23 | Wang hao

unit：mm

4

## Slide 6

2. Machine Performance Design

Function:

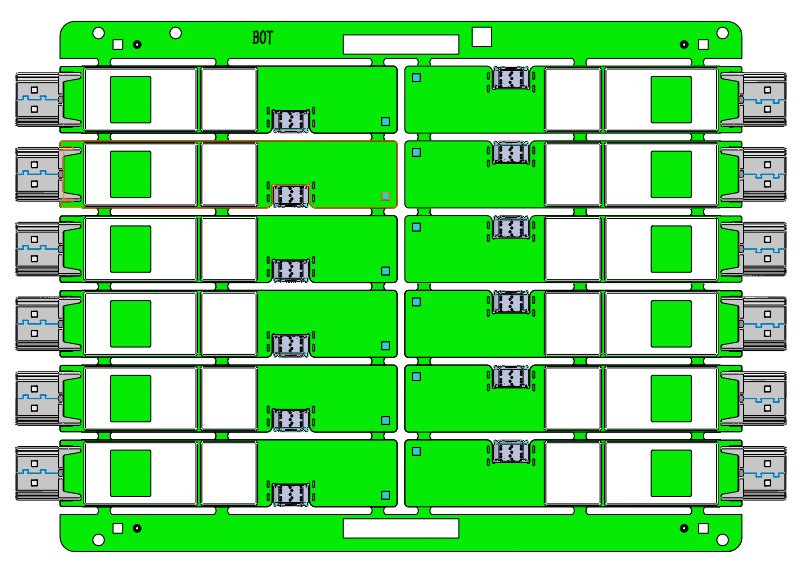
[picture p89: figure]
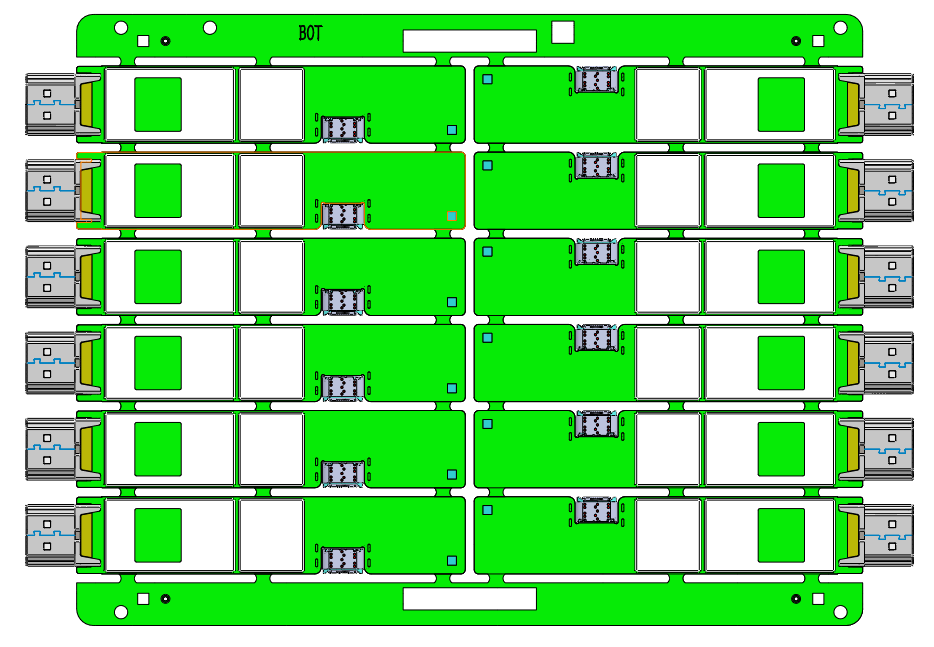
[picture p90: figure]

Attach EMI to PCBA board B-side

unit：mm

PCBA board

EMI

Purpose | Take out EMI from the Feeder and attach it to the PCBA board B-side
PCBA board | 137.6*199.8mm
Tool | TABLE Load transfer component，Suction nozzle，CCD，Feeder，Actuator
Process | CCD calibration
Process requirements | Alignment tolerance: +/- 0.13mm
UPH requirements | 640PCS

5

## Slide 7

3.Product Change

Need to change the image from newst Calla panel design Drw, the dimension from 184mm to 177 mm

PCBA：

unit：mm

Cony

Calla


187.8mm

159mm


184mm

137.6mm

6

## Slide 8

4.Equipment Layout

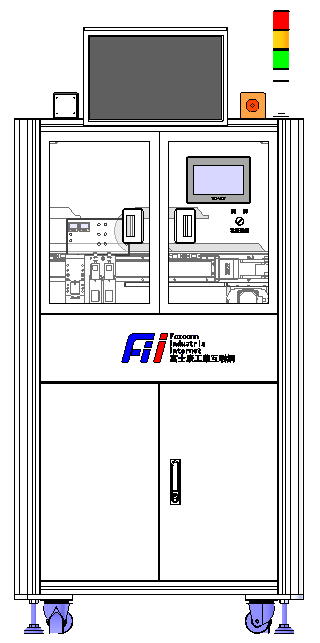
[picture p91: figure]
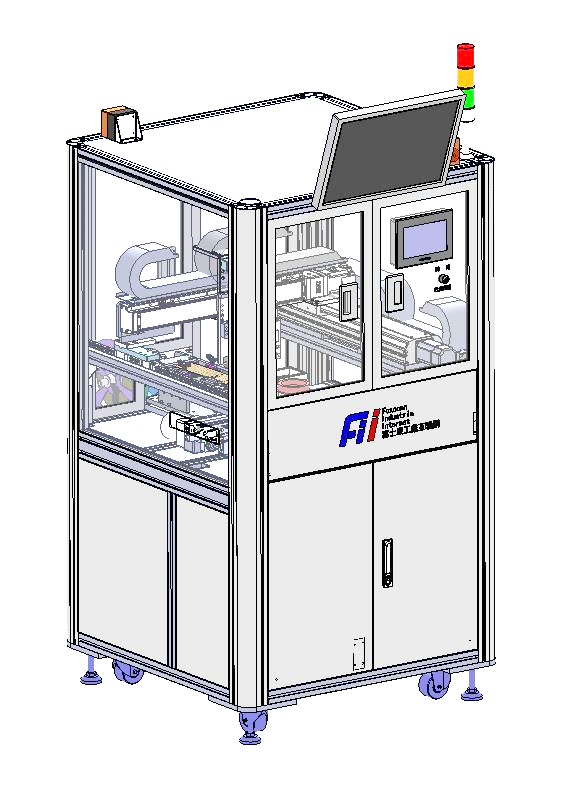
[picture p92: figure]

| automatic
CT | 4.5S
UPH | 640PCS

unit：mm

unit：mm

Tricolor lamp

PC

Touch screen

1600mm

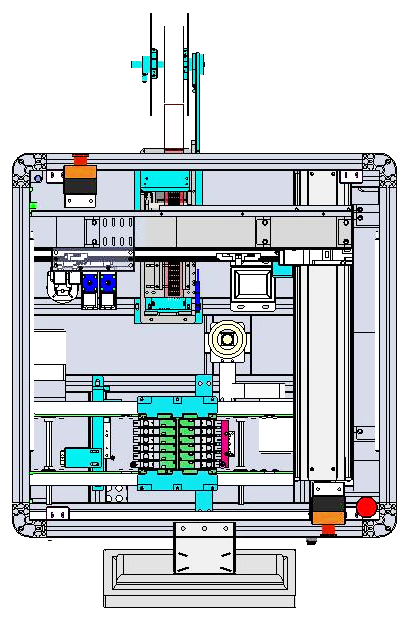
[picture p93: figure]

900mm

900mm

7

## Slide 9

4.Equipment Layout

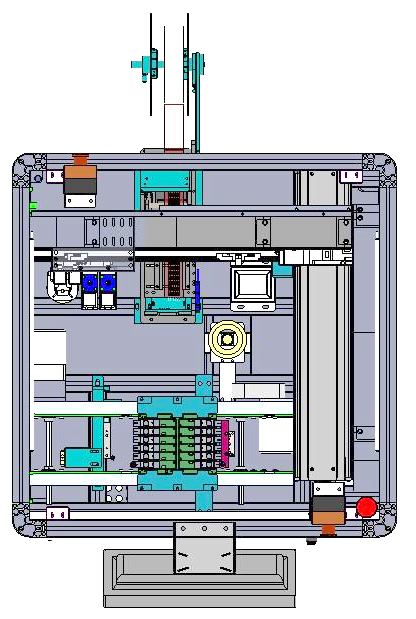
[picture p94: figure]

unit：mm

4

Feeder（Feeding）

3

X/Y TABLE Load transfer component
(material fetching

6

Upper CCD
(product positioning)

Lower CCD
(Label compensation position）

5

Positioning PCBA
(Clamping PCBA）

2

1

Into the PCBA
conveyor line(feed)

7

Conveyor line outflowPCBA

Item | Components
1 | Into the PCBA conveyor line(feed)
2 | Positioning PCBA (Clamping PCBA）
3 | X/Y TABLE Load transfer component (material fetching)
4 | Feeder（Feeding）
5 | Lower CCD (Label compensation position）
6 | Upper CCD (product positioning)
7 | Conveyor line outflowPCBA

8

## Slide 10

4.Equipment Layout

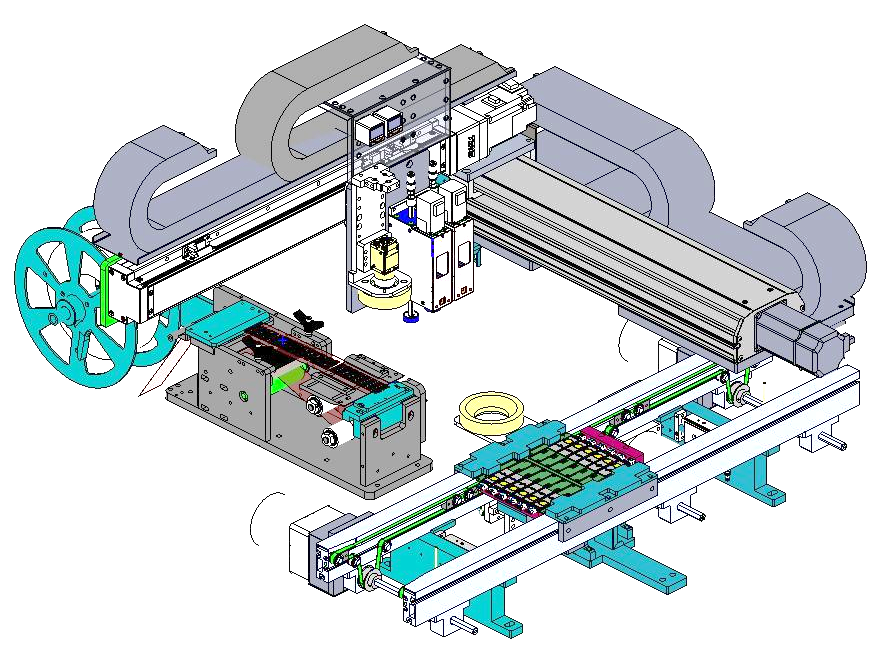
[picture p95: figure]

X-axis

3

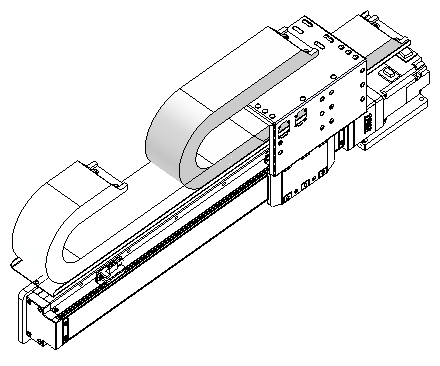
[picture p96: figure]

Transport module

6

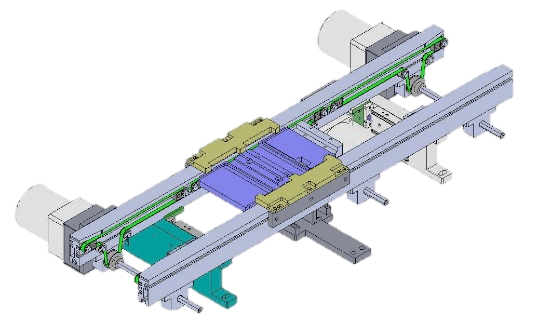
[picture p97: figure]
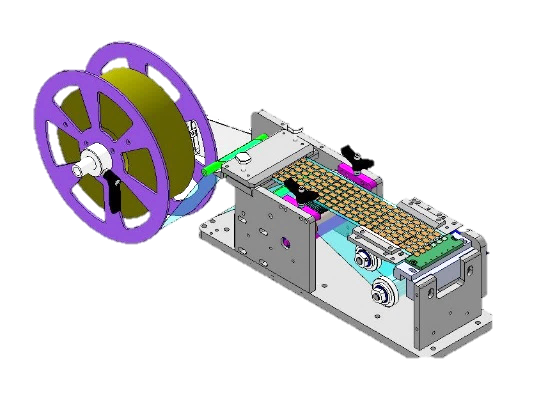
[picture p98: figure]

1

Feeder

Placement head

2

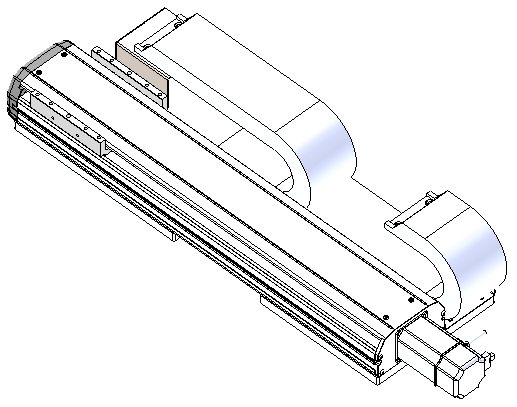
[picture p99: figure]

4

Y-axis

Lower CCD

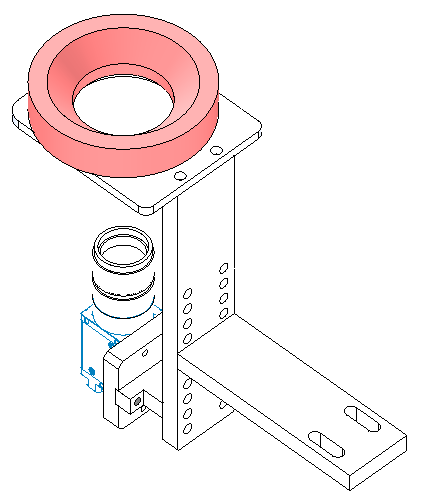
[picture p100: figure]

5

unit：mm

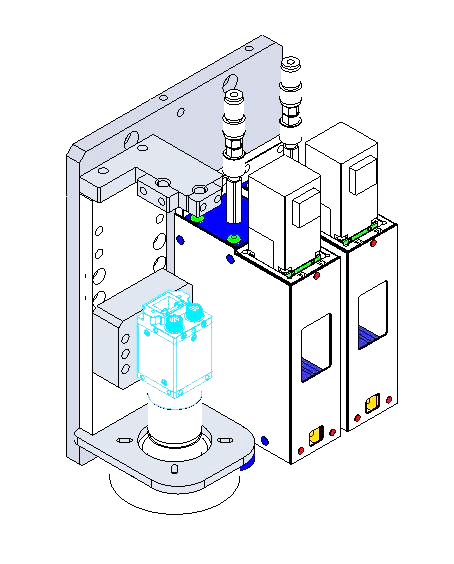
[picture p101: figure]

9

## Slide 11

5. The key components

5.1 Feed conveyor line

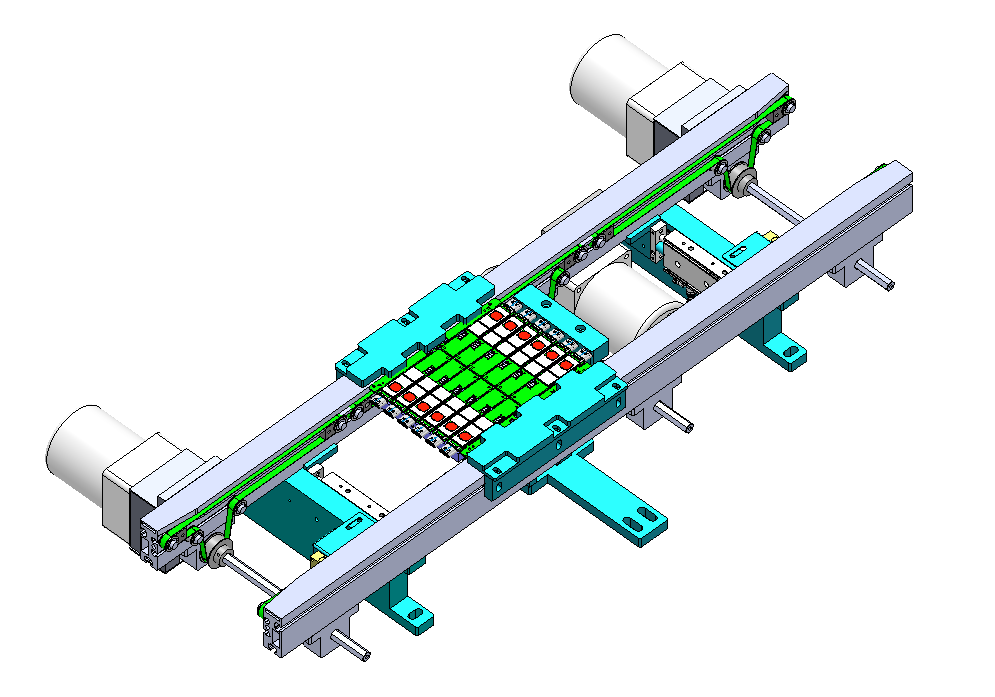
[picture p102: figure]

PCBA in place deceleration sensor

PCBA blocking cylinder

PCBA jacking cylinder

Motor

PCBA lifting limit component

PCBA support board

PCBA board positioning process:
1.The PCBA board flows into the conveyor line, and the CX-461A senses that the conveyor line
slows down and blocks the PCBA board from the blocking cylinder.
2.The lifting cylinder is pushed out to position the PCBA board.

Due to changes in the length
of the PCBA, need to
change the blocking block of
the blocking cylinder

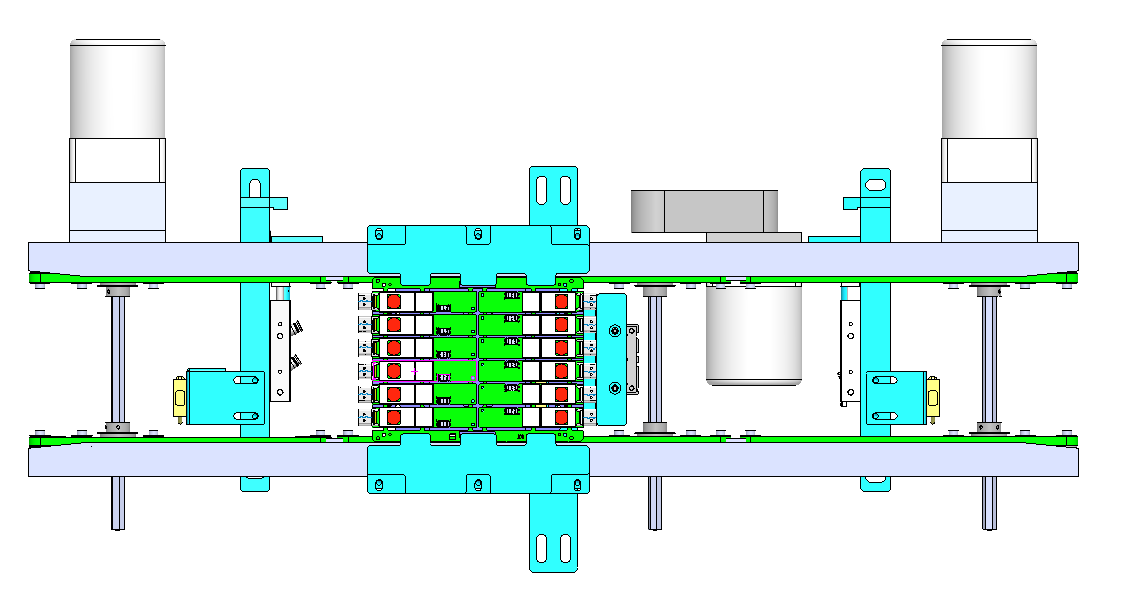
[picture p103: figure]

138.6mm

Sensor CX-461A
Detect whether the PCBA drives into the conveyor line

Sensor CX-461A
Detect whether the PCBA drives into the conveyor line

10

## Slide 12

5. The key components

5.1 Feed conveyor line

clamping position


PCBA board clamping:
1. PCBA board arrives at the assembly position;
2, the block cylinder is blocked out3. At the same time, the support plate rises to support the PCBA board.

unit：mm


The clamp block is in contact with the edge strip of the connecting plate 3.8mm


The distance between the connecting plate and the edge of the conveyor line is 0.5mm

11

## Slide 13

5. The key components

5.1 Feed conveyor line

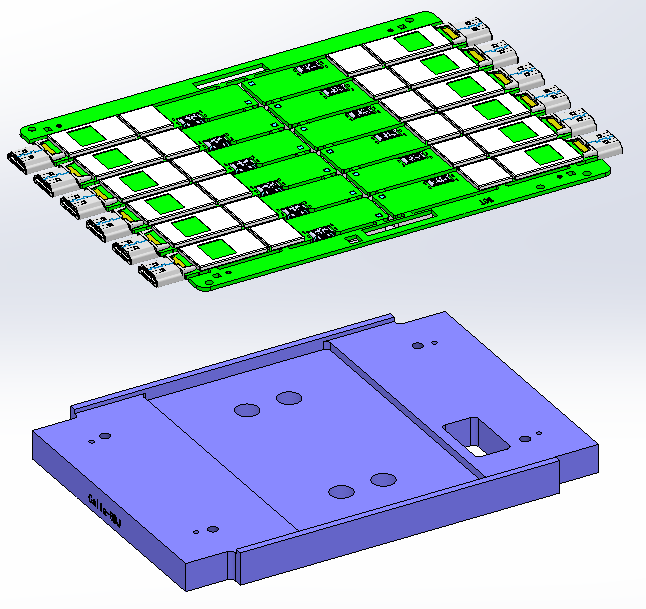
[picture p104: figure]

B-side jacking plate(A6061)

5.5mm

The TPYE-C port is
5.5mm from the front
of the avoidance slot

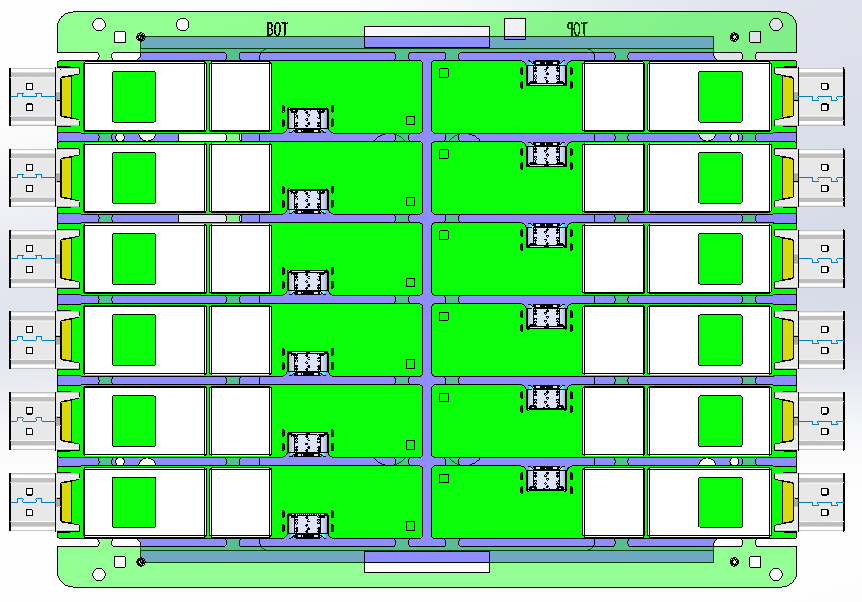
[picture p105: figure]

unit：mm

12

## Slide 14

5. The key components

5.2 TABLE Load transfer component

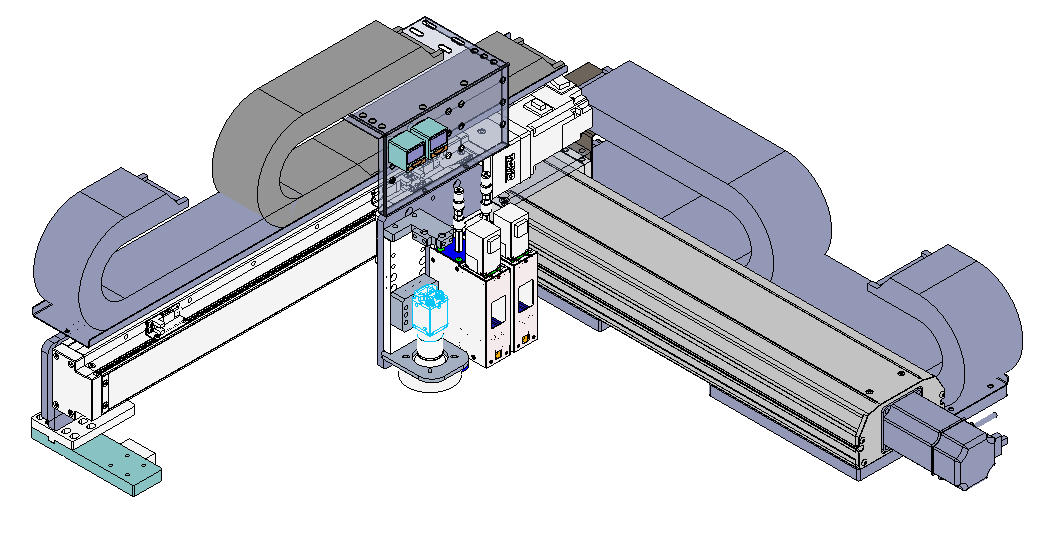
[picture p106: figure]

Vacuum negative pressure gauge

Y-axis slide table

X-axis transfer
Type | GTH8-L20-400-BC-S20-C4
Brand | TOYO
repeatability | ±0.005mm
Position accuracy | ±0.01mm
Travel distance | 250mm
Max speed | 1000mm/s
Work speed | 800mm/s
Maximum load | 18kg
Work load | 5kg

Y-axis transfer
Type | ETH14-L32-500-BC-S40-A2
Brand | TOYO
repeatability | ±0.005mm
Position accuracy | ±0.01mm
Travel distance | 500mm
Max speed | 1600mm/s
Work speed | 1280mm/s
Maximum load | 15kg
Work load | 10.5kg

unit：mm

X-axis slide table

Servo actuator

Upper CCD

Suction nozzle

Z-axis transfer
Type | ZRB-MM8-P10-S50-M28-EC
Brand | SCAUTO
repeatability | ±0.01mm
Position accuracy | ±0.02mm
Travel distance | 50mm
Max speed | 200mm/s
Work speed | 150mm/s
Maximum load | 300g
Work load | 50g

Main structure: sliding table, servo actuator, CCD, suction nozzle

13

## Slide 15

5. The key components

5.2 TABLE Load transfer component

X-axis GTH8-L20-400-BC-S20-C4

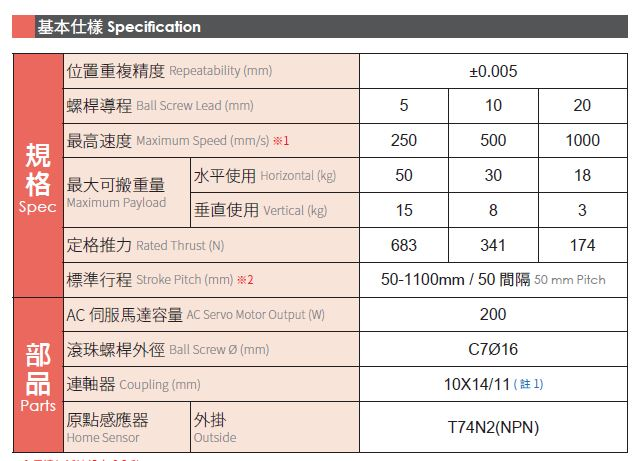
[picture p107: figure]

unit：mm

Y-axis ETH14-L32-500-BC-S40-A2

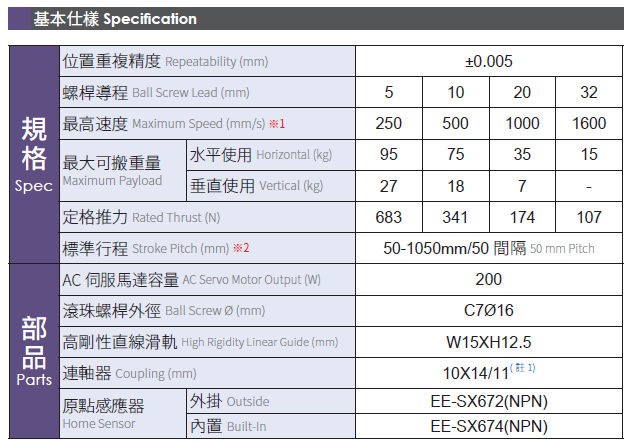
[picture p108: figure]

14

## Slide 16

5. The key components

5.3 Feeder

Feeder
category | 120- Pullback marking machine (standard machine)
UPH | 1s/pcs
Diameter of roll | 180mm
Strip width | 44mm
Quantity | Estimated 10K

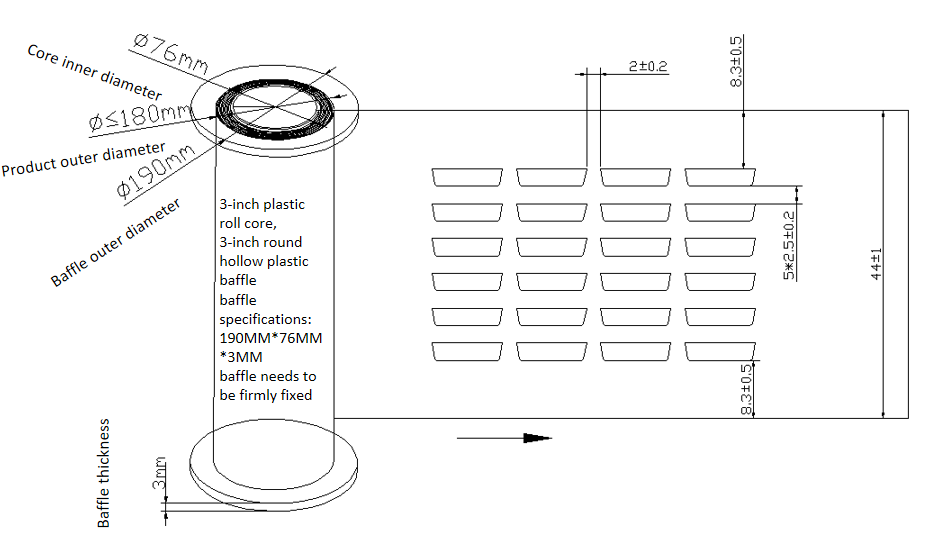
[picture p109: figure]

unit：mm

Roll material indication

sensing fiber

Retrieval area

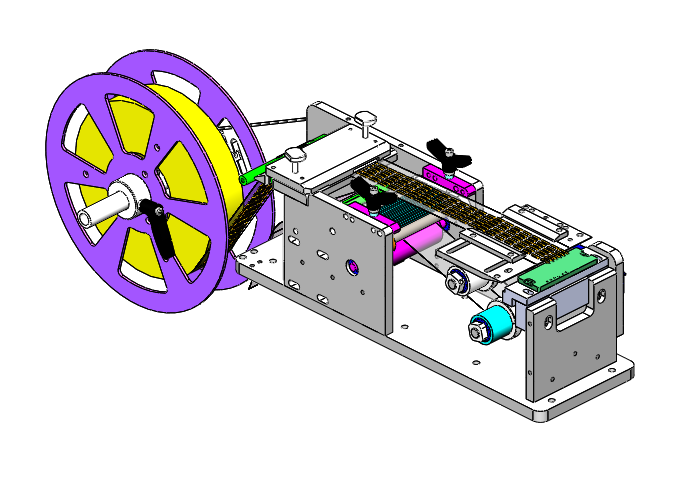
[picture p110: figure]

Note: It is recommended that the bidding platform be manually wiped and cleaned with a dust-free cloth once per shift.

15

## Slide 17

5. The key components

5.4 Upper CCD

Hardware name | Model | quantity
camera | FM-GE500-22M | 1
lens | RICOH/FL-CC1214A-2M | 1
Close up adaptor | 无 | 0
optical source | 光源/華周/HRS-70R60 | 1
optical source controller | DKZ2-24V-2-AC | 1

Camera mounting orientation | back to the human machine ↑
The distance between the camera surface → the product | 135±10 mm
The distance between the camera surface → optical source | 30±10mm
visual field | 56*42mm
Image pixel size | 2592*1944
Camera single-pixel accuracy | 0.021

layout：

camera：FM-GE500-22M

lens：FL-CC1214A-2M

optical source：HRS-70R60

30±10mm

135±10mm

PCBA

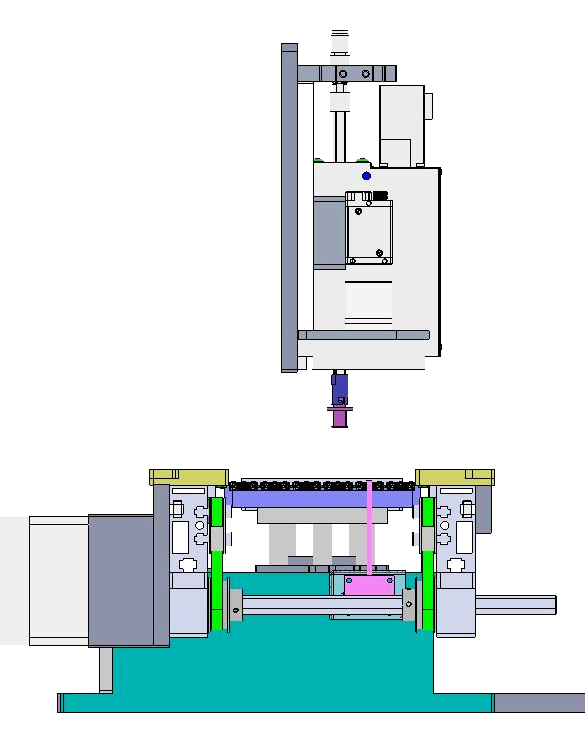
[picture p111: figure]

unit：mm

## Slide 18

5. The key components

5.4 Lower CCD

Hardware name | Model | quantity
camera | FM-GE500-22M | 1
lens | RICOH/FL-CC3516-2M | 1
Close up adaptor | 5mm | 1
optical source | 光源/華周LRS-90R30 | 1
optical source controller | DKZ2-24V-2-AC | 1

Camera mounting orientation | against sheet metal ↓
The distance between the camera surface → the product | 195±10 mm
The distance between the camera surface → optical source | 30±10mm
visual field | 27*20mm
Image pixel size | 2592*1944
Camera single-pixel accuracy | 0.01

ingredients

camera：FM-GE500-22M

layout：

optical source：LRS-90R30

30±10mm

195±10mm

lens：FL-CC3516-2M

unit：mm

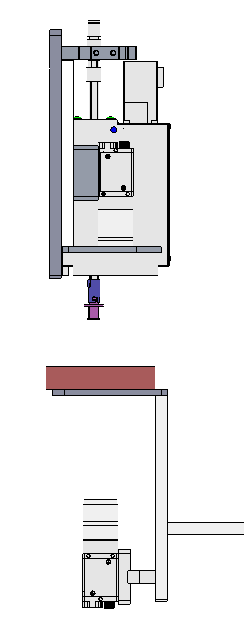
[picture p112: figure]

## Slide 19

5. The key components

5.5 Process requirements

unit：mm

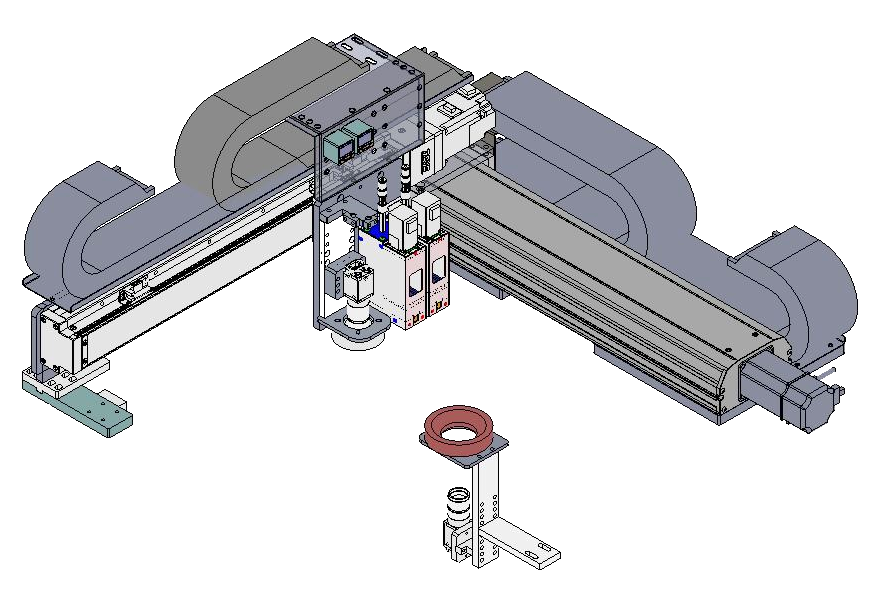
[picture p113: figure]

X axis module accuracy | ±0.01
Y axis module accuracy | ±0.01
Z axis module accuracy | ±0.02
Upper CCD Recognition accuracy | ±0.06
Lower CCD Recognition accuracy | ±0.03

Positioning accuracy = X axis module accuracy + Y axis module accuracy + Z axis module accuracy：±（0.01+0.01+0.02）= ±0.04mm；
Placement accuracy = Positioning accuracy + Upper CCD Recognition accuracy + Lower CCD Recognition accuracy ：±（0.04+0.06+0.03）= ± 0.13mm。

18

## Slide 20

6.Key fixture design

6.1Material fetching mechanism

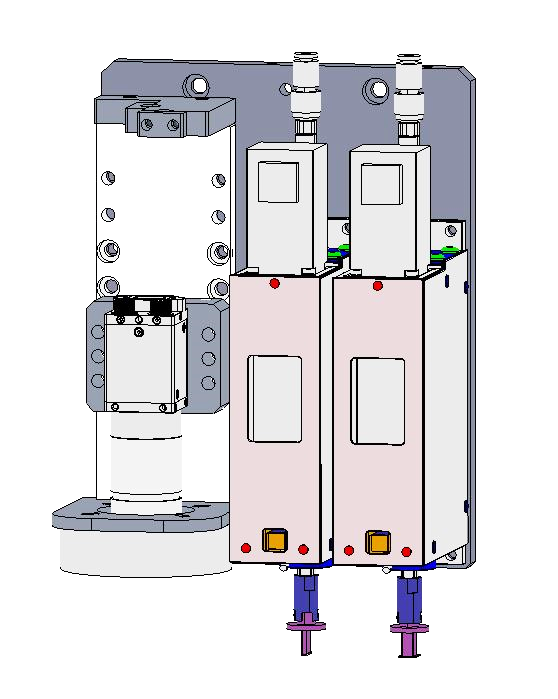
[picture p114: figure]

Upper CCD

ZRB-MM8-P10-S50-M28-EC
（ Rated thrust20N ）

optical source

Suction nozzle

unit：mm

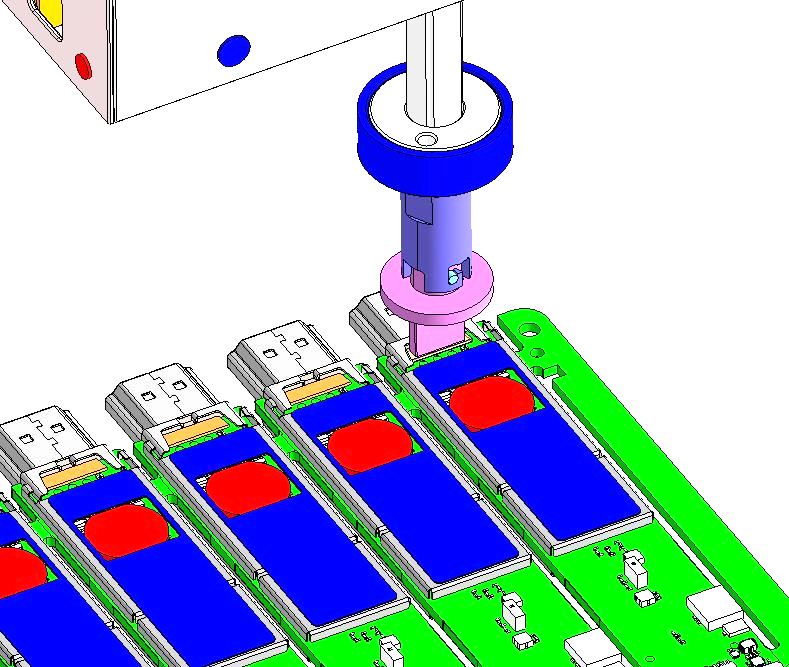
[picture p115: figure]

19

## Slide 21

6.Key fixture design

6.1Material fetching mechanism

unit：mm

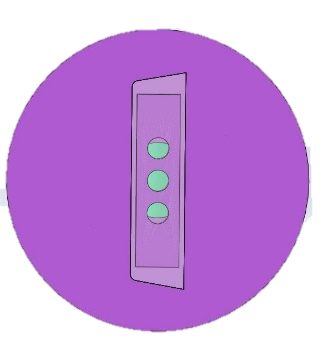
[picture p116: figure]

8mm

2mm

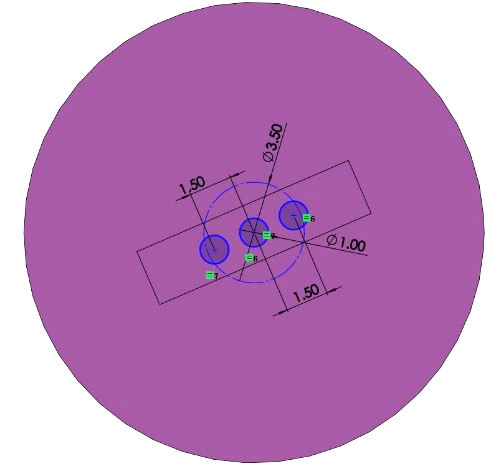
[picture p117: figure]

Universal structure, built-in spring as placement buffer, placement pressure of 8-16N.

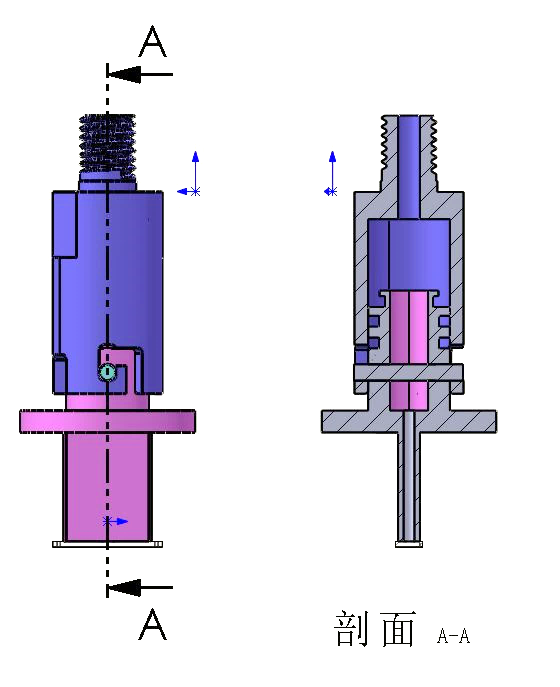
[picture p118: figure]

The adsorption surface is customized according to the shape of each excipient

9mm

2.48mm

10.07mm

EMI

20

## Slide 22

7.Action flow design

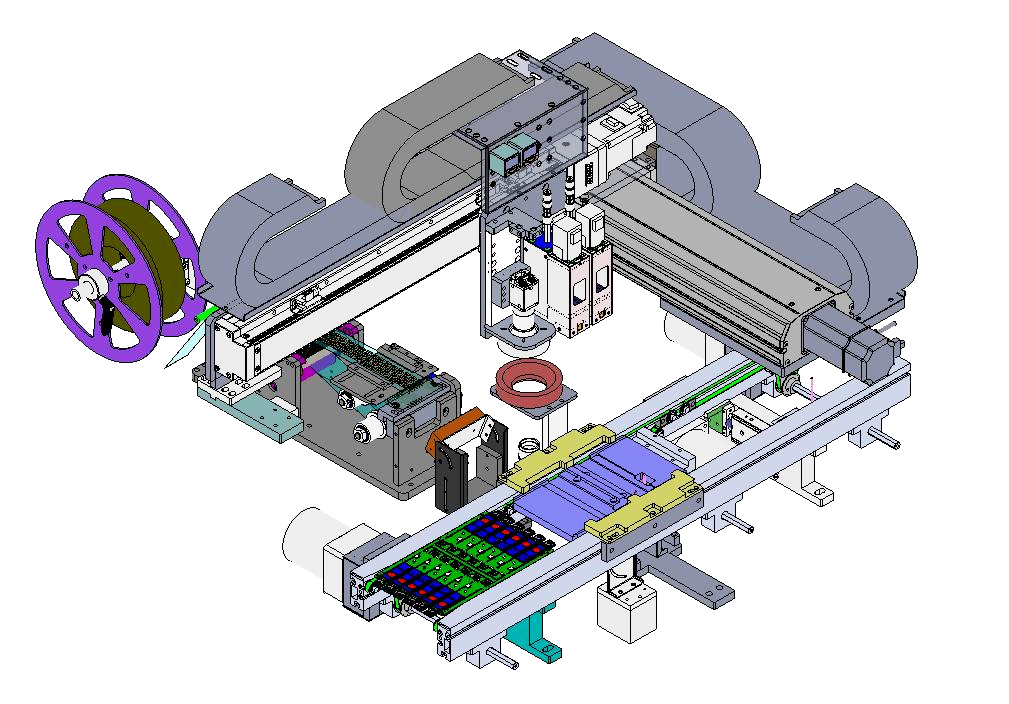
[picture p119: figure]
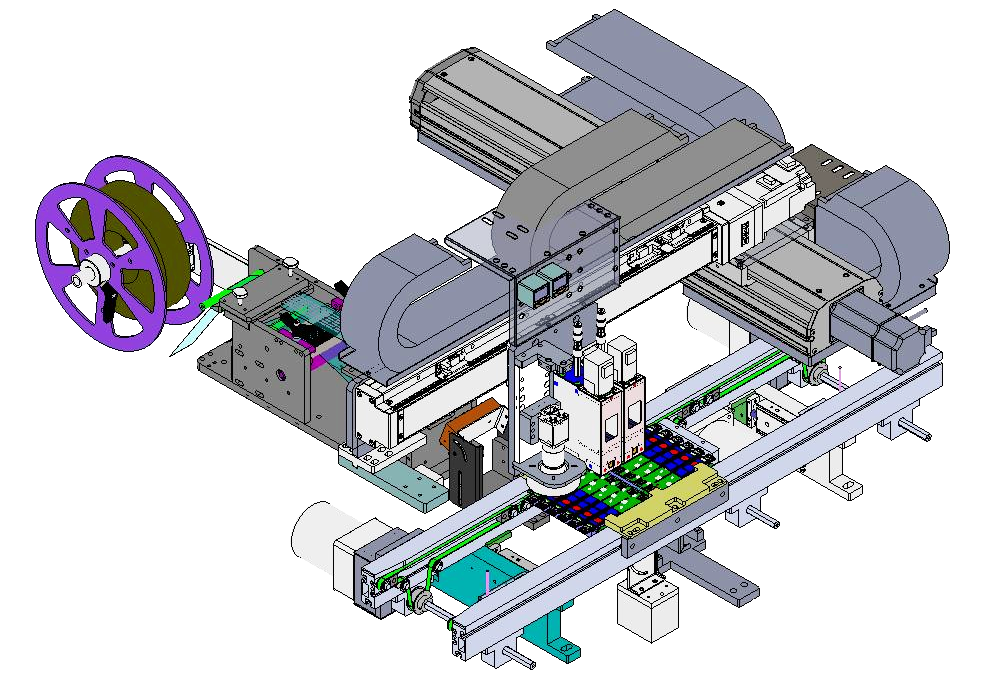
[picture p120: figure]
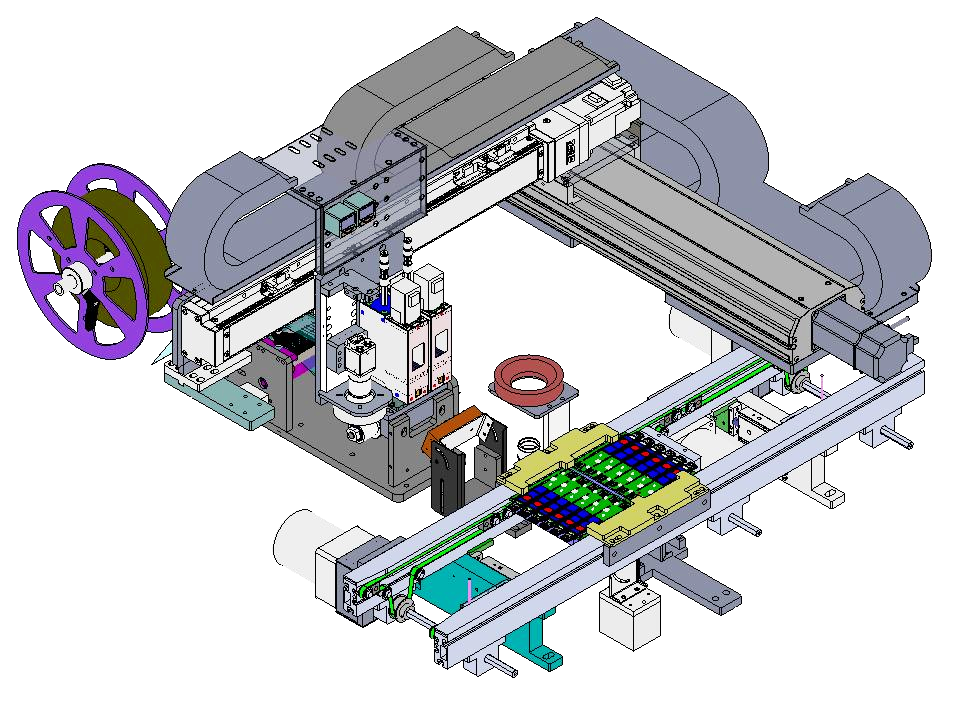
[picture p121: figure]

unit：mm

Step1: The PCBA board of the front conveyor line flows in, blocking the cylinder from rising, and the sensor responds in place, and the jacking cylinder rises and clamps the PCBA continuous wrench

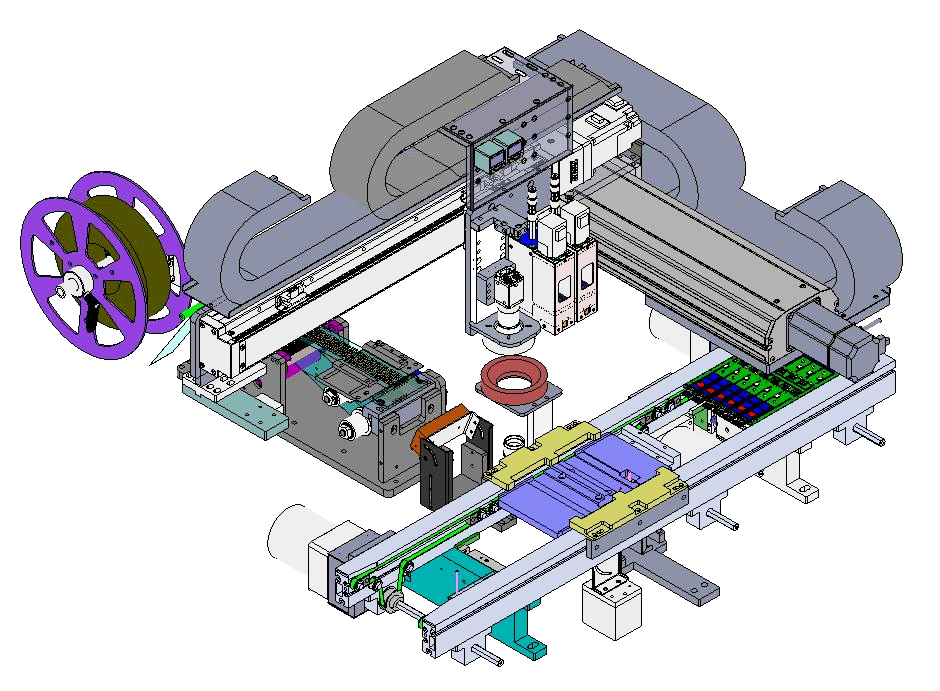
[picture p122: figure]

Step6: Blocking the cylinder and jacking cylinder to descend, the PCBA board flows out of the equipment and enters the next process

Step2: Upper CCD identifies and locates the Mark point of the PCBA

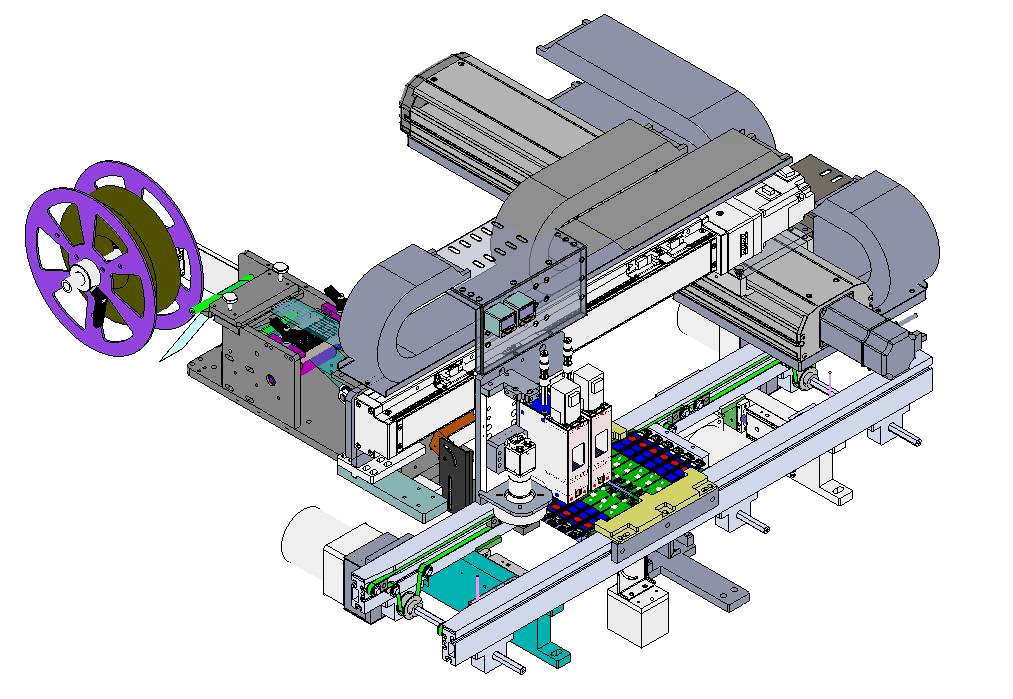
[picture p123: figure]

Step5:The placement head is moved to the placement area for placement

Step3: The placement head moves to the reclaiming area to absorb EMI

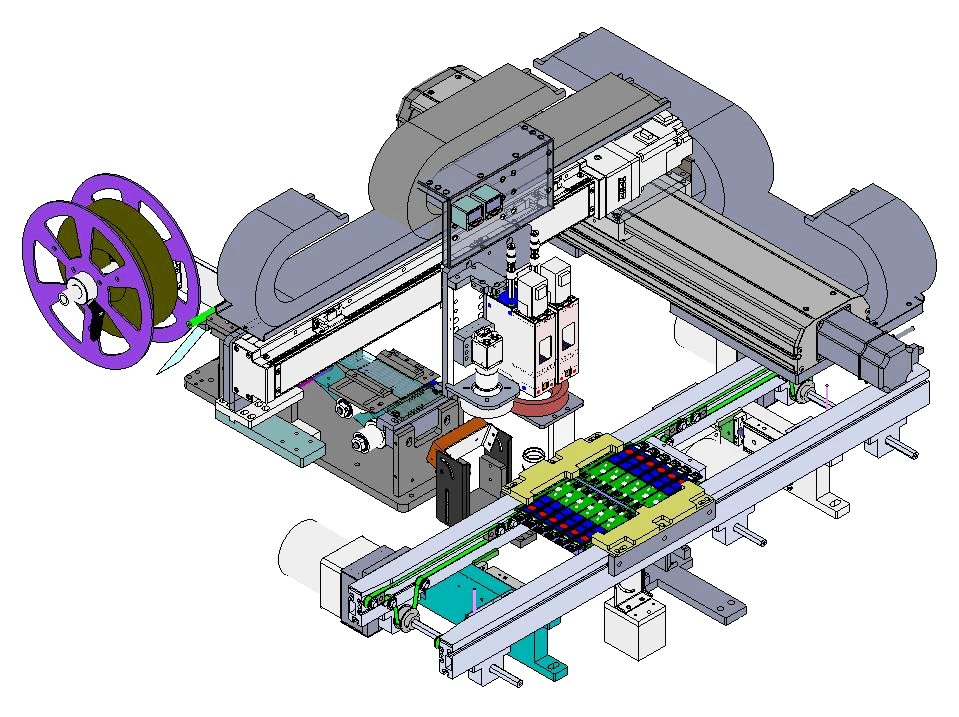
[picture p124: figure]

Step4:The placement head is moved to the lower CCD to identify EMI

21

## Slide 23

8. Timing diagram

Automatic EMI 0.5s/grid
Product entry into the workspace 產品入工作區 | Running time of the conveyor line is 1.5 seconds 輸送線運轉時間1.5s | 2
| Product positioning 0.5s 產品定位 0.5s
Take photos of the material collection point 取料點拍照 | Move the slide to the material collection point for 0.5s 滑台移動至取料點 0.5s | 1.5
| Take photos of the material collection point for 1 second 取料點拍照 1s
Suction nozzle feeding 吸嘴取料 | Left suction nozzle feeding (No.1) for 1.5s 左吸嘴取料（1號） 1.5s | | | | | 3
| Right suction nozzle feeding (No.2) for 1.5s 右吸嘴取料（2號） 1.5s
Product photography 產品拍照 | Slide moves to Mark point for 1.5s to take photos 滑台移動至Mark點拍照 1.5s | | | | | | | | | | 1.5
| Take photos of the discharge point (points 1-10) for 8 seconds 放料點拍照（1-10號點）8s | | | | | | | | | | | | | 8
Suction nozzle discharge 吸嘴放料 | Left suction nozzle discharge (No.1) for 1.5s 左吸嘴放料（1號） 1.5s | | | | | | | | | | | | | | | | | | | | | | | | | | | | | 3
| Right suction nozzle discharge (No.2) for 1.5s 右吸嘴放料（2號） 1.5s
Material collection and discharge process 取放料流程 | Move the slide to the material collection point for 0.5s 滑台移動至取料點 0.5s | | | | | | | | | | | | | | | | | | | | | | | | | | | | | | | | | | | 35
| Left suction nozzle feeding (No.3) for 1.5s 左吸嘴取料（3號） 1.5s
| Right suction nozzle feeding (No. 4) for 1.5s 右吸嘴取料（4號） 1.5s
| Move the slide to the discharge point for 0.5s 滑台移動至放料點 0.5s
| Left suction nozzle discharge (No.3) for 1.5s 左吸嘴放料（3號） 1.5s
| Right suction nozzle discharge (No. 4) for 1.5s 右吸嘴放料（4號） 1.5s
| Repeat the above material collection and discharge process 3 times (No. 5-10) for 21 seconds 重複以上取放料流程3次(5-10號) 21s
Product outflow 產品流出 | Cancel product positioning for 0.5s 產品定位取消 0.5s | | | | | | | | | | | | | | | | | | | | | | | | | | | | | | | | | | | | | | | | | | | | | | | | | | | | | | | | | | | | | | | | | | | | | | | | | | | | | | | | | | | | | | | | | | | | | | | | | | | | | | | | | 1.5
| Buffer 1 second after product inflow 產品流入后buffer 1s
| | 1 | 2 | 3 | 4 | 5 | 6 | 7 | 8 | 9 | 10 | 11 | 12 | 13 | 14 | 15 | 16 | 17 | 18 | 19 | 20 | 21 | 22 | 23 | 24 | 25 | 26 | 27 | 28 | 29 | 30 | 31 | 32 | 33 | 34 | 35 | 36 | 37 | 38 | 39 | 40 | 41 | 42 | 43 | 44 | 45 | 46 | 47 | 48 | 49 | 50 | 51 | 52 | 53 | 54 | 55 | 56 | 57 | 58 | 59 | 60 | 61 | 62 | 63 | 64 | 65 | 66 | 67 | 68 | 69 | 70 | 71 | 72 | 73 | 74 | 75 | 76 | 77 | 78 | 79 | 80 | 81 | 82 | 83 | 84 | 85 | 86 | 87 | 88 | 89 | 90 | 91 | 92 | 93 | 94 | 95 | 96 | 97 | 98 | 99 | ## | ## | ## | ## | ## | ## | ## | ##
Cycle time/s | 53.5/12=4.5S | UPH: 3600/4.5*0.8=640 (Pcs)

UPH≈3600/4.5*0.8=640
Note：80% is estimated OEE, only for UPH calculation. not real product data

unit：mm

22

## Slide 24

Thank you

23
