Cinthanh1998/Du-an-Foxconn/治具修改问题点11026.pptx

第三压合治具

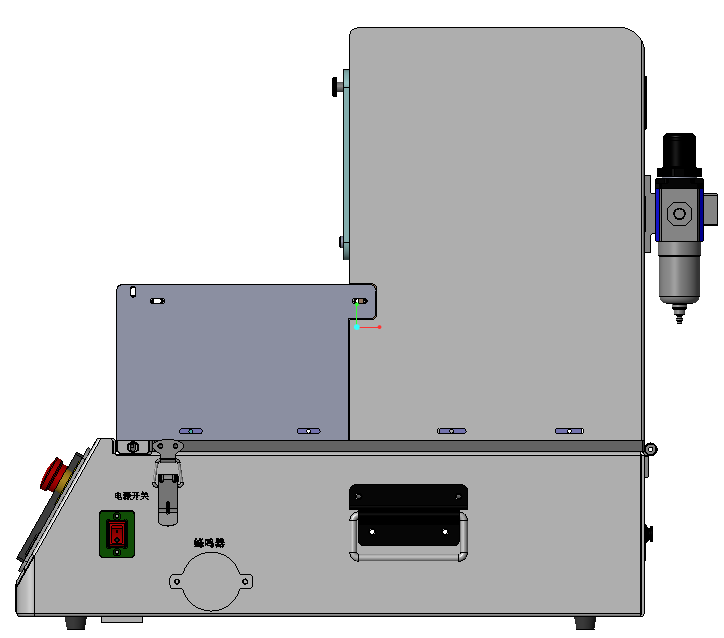
[picture p154: figure]
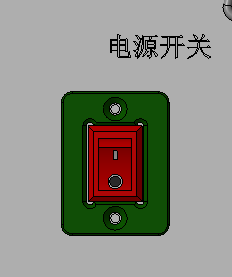
[picture p155: figure]

没有电源开关

距离太大（ 1.438mm）需要增加固定点在两边左右保证距离是0.075mm

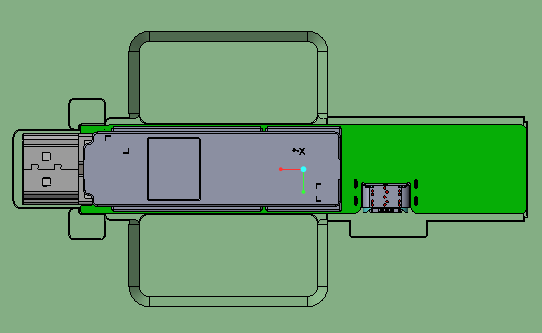
[picture p156: figure]
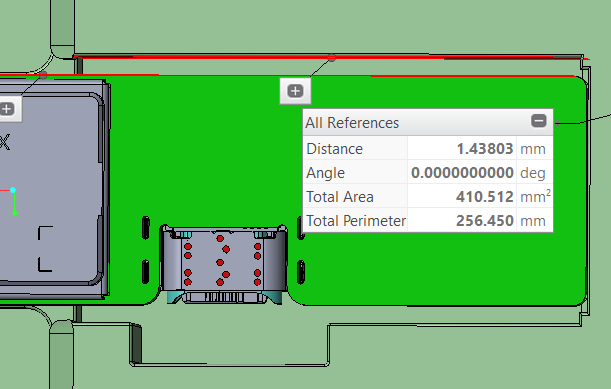
[picture p157: figure]
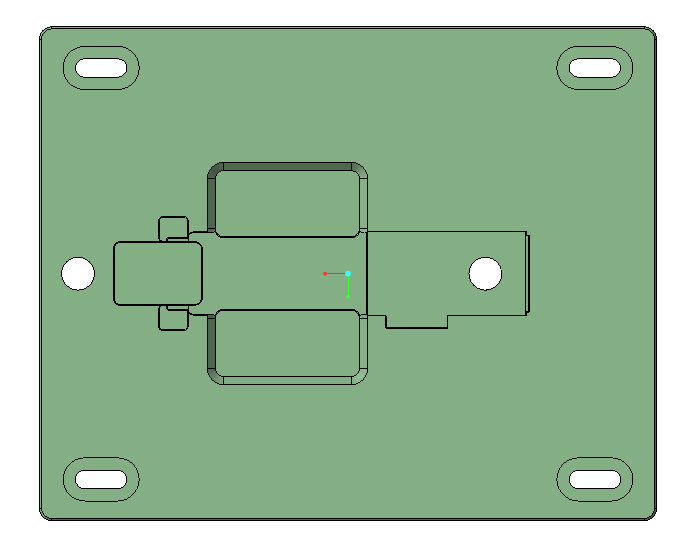
[picture p158: figure]
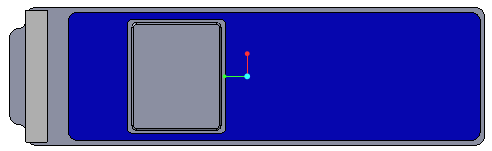
[picture p159: figure]
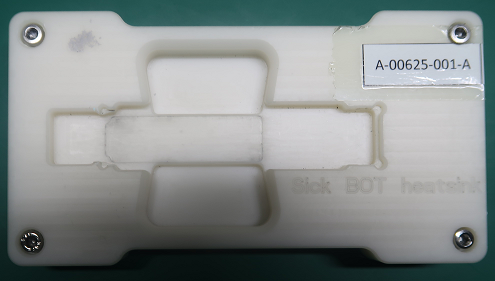
[picture p160: figure]

辅助治具要打孔在里面中间保证能把散热铝片固定然后装PCBA上面的。

## Slide 2

第五压合治具

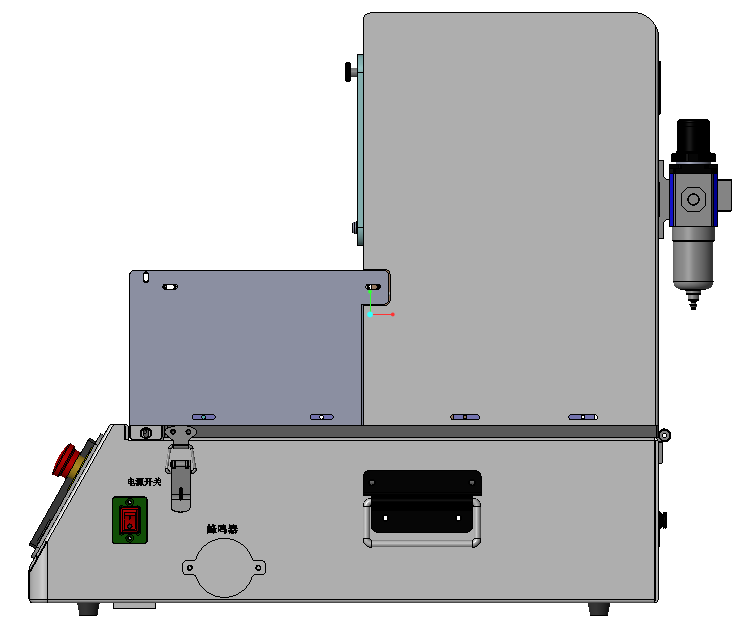
[picture p161: figure]

没有电源开关

距离太大（ 1.438mm）需要增加固定点在两边左右保证距离是0.075mm

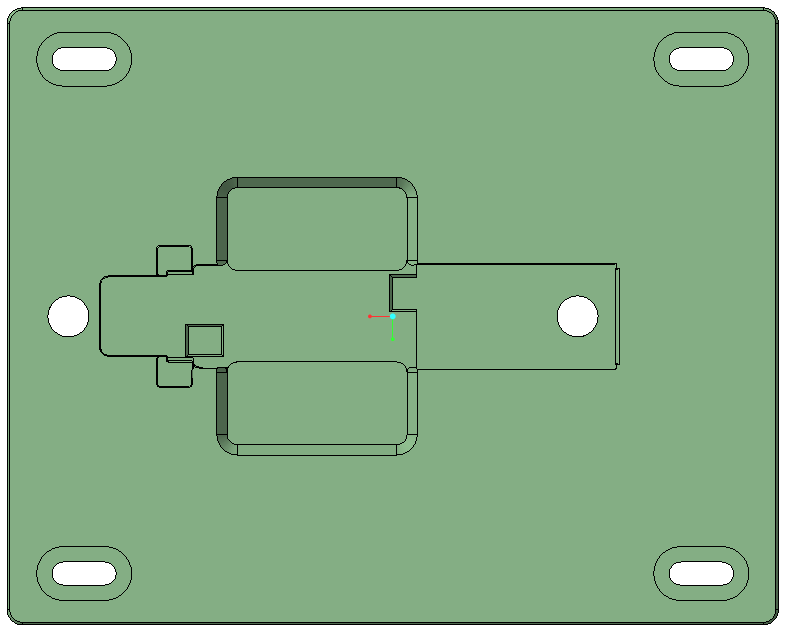
[picture p162: figure]
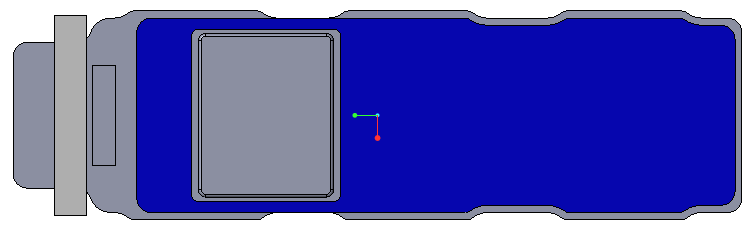
[picture p163: figure]

辅助治具要打孔在里面中间保证能把散热铝片固定然后装PCBA上面的。

## Slide 3

第六压合治具

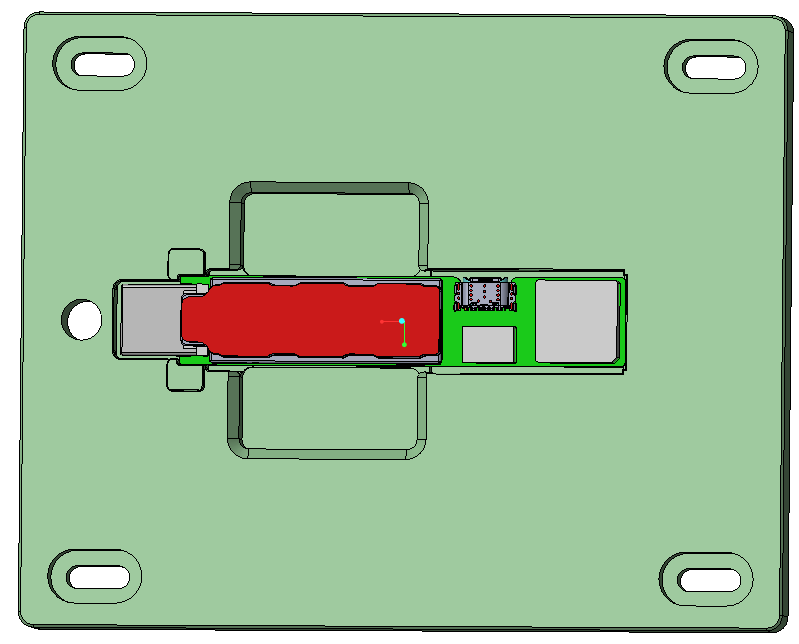
[picture p164: figure]
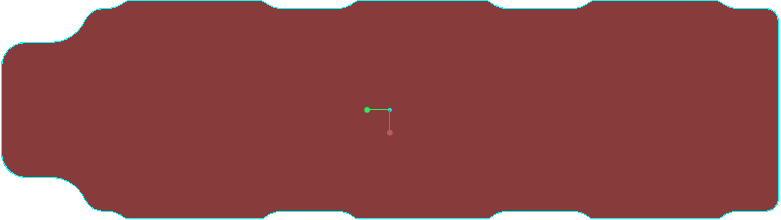
[picture p165: figure]

辅助治具要打孔在里面中间保证能把散热铝片固定然后装PCBA上面的。

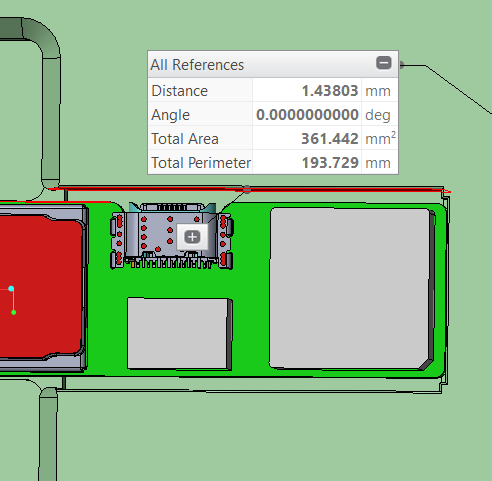
[picture p166: figure]

距离太大（ 1.438mm）需要增加固定点在两边左右保证距离是0.075mm

## Slide 4

第八压合治具

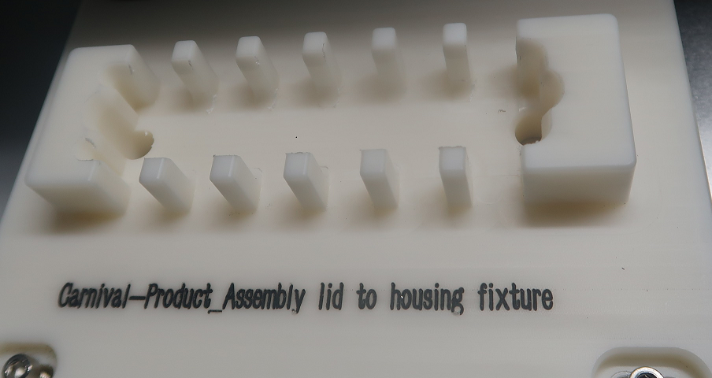
[picture p167: figure]

这个HDMI位置需要开孔才能放产品进去

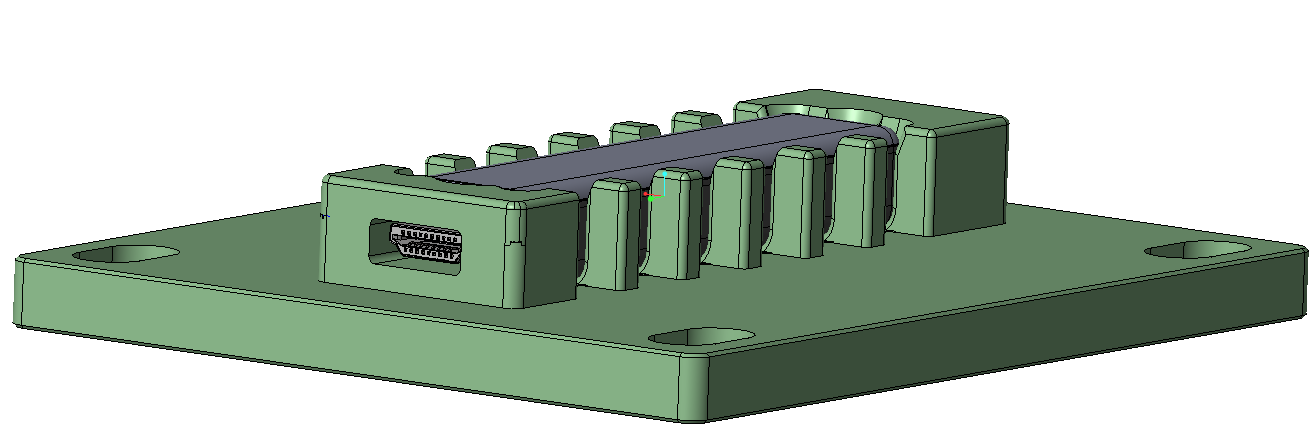
[picture p168: figure]
