Cinthanh1998/Du-an-Foxconn/Calgary_Press_Bot_Copper_Foil_Fixture_DFM_20250630.pptx

Calgary Press Bot Copper Foil Fixture DFM
Ver 2.0

CNT
2025.06.30

## Calgary Press Bot Copper Foil Fixture

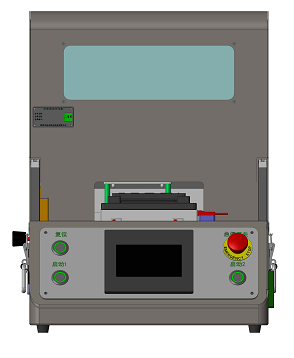
[picture p169: figure]
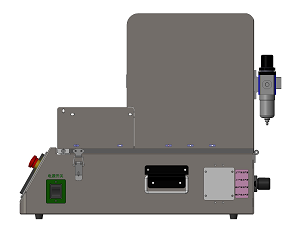
[picture p170: figure]
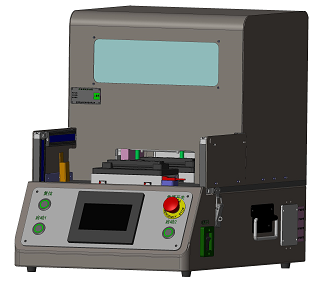
[picture p171: figure]

overview

471mm

350mm

573mm

Summary: The dimension of this fixture is L*W*H=350mm*573mm*471mm.

## Slide 3

Calgary Press Bot Copper Foil Fixture

- Electric control module

Air structure

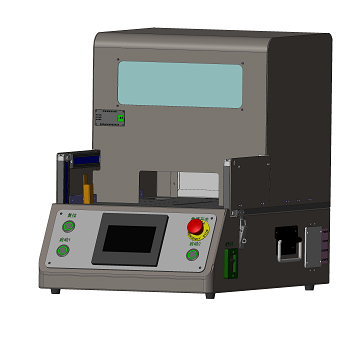
[picture p172: figure]

Protect

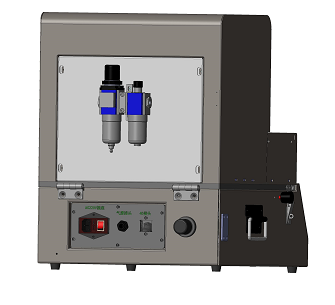
[picture p173: figure]

Electric control box

Light curtain

Power outlet

Control button

Internet connector

Air connector

Touch screen

Power button

Air pressure control valve

Regulator

Barometer

## Slide 4

Calgary Press Bot Copper Foil Fixture

- Press module

Press cylinder

PLC

Backplane（A7075）

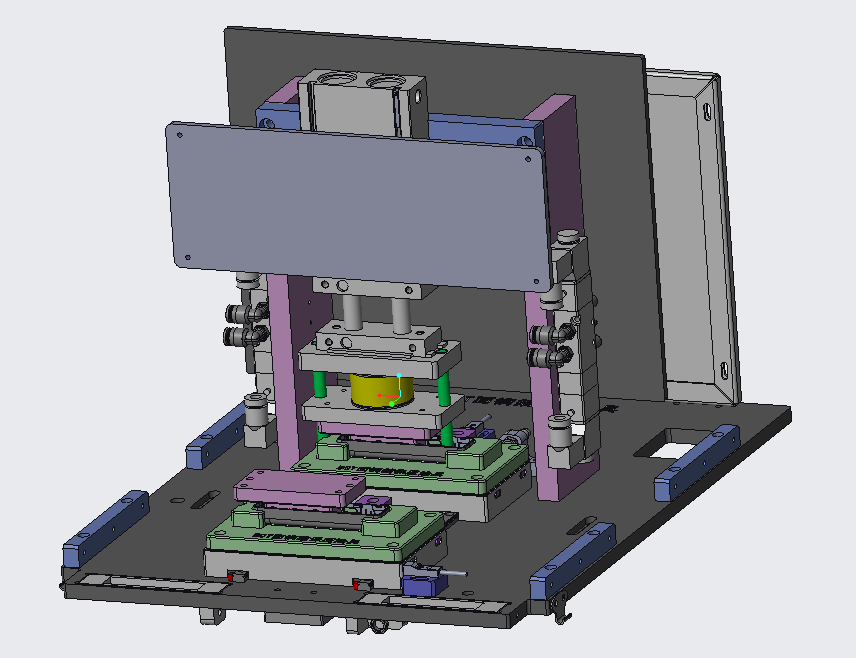
[picture p174: figure]

Electric control plate

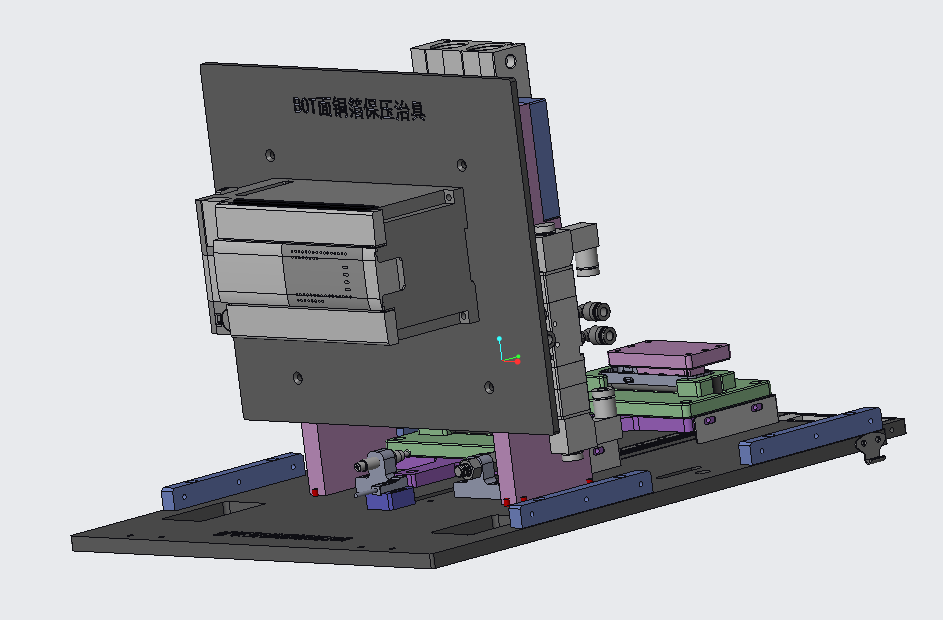
[picture p175: figure]

Vertical plate（A7075）

Bottom plate
(A7075)

Pressure sensor

Cylinder

Solenoid valve

Limitation module

Location sensor

Linear guide

## Slide 5

Calgary Press Bot Copper Foil Fixture

- Press cylinder size(TR25x50s)

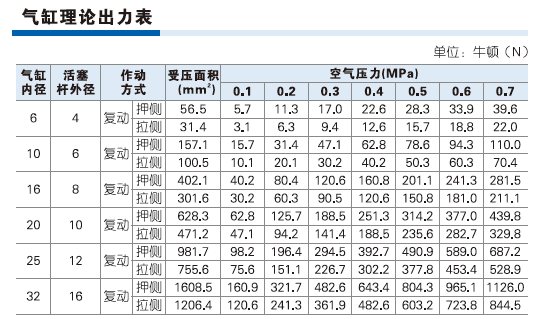
[picture p176: figure]

Air pressure | 0.38Mpa
Press force | 37kg

## Slide 6

Calgary Press Bot Copper Foil Fixture

- Holder design

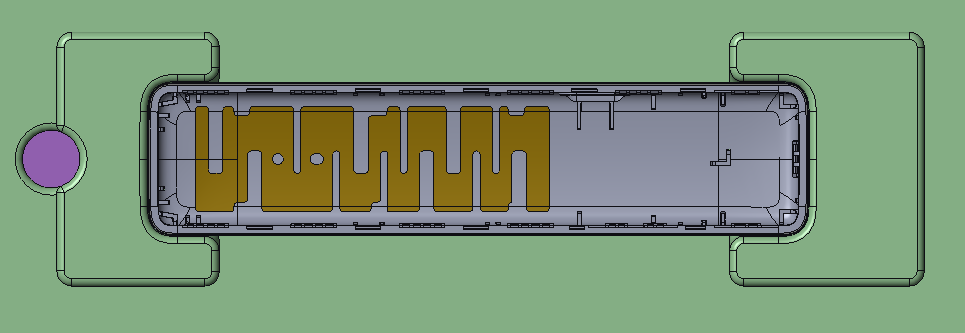
[picture p177: figure]

- Press head design

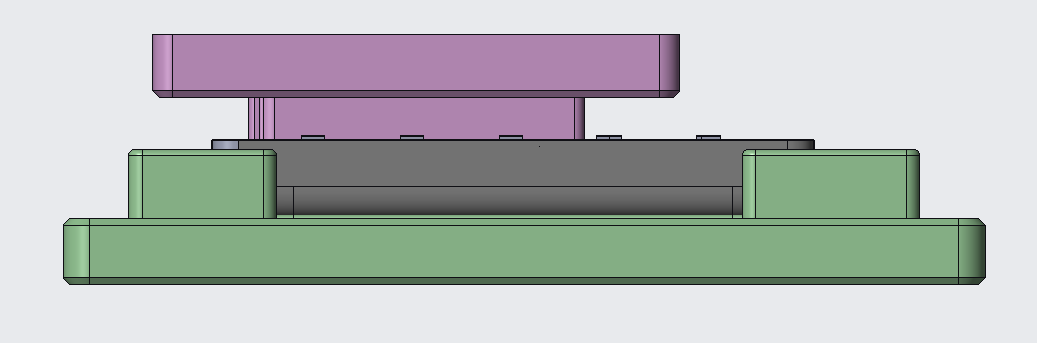
[picture p178: figure]
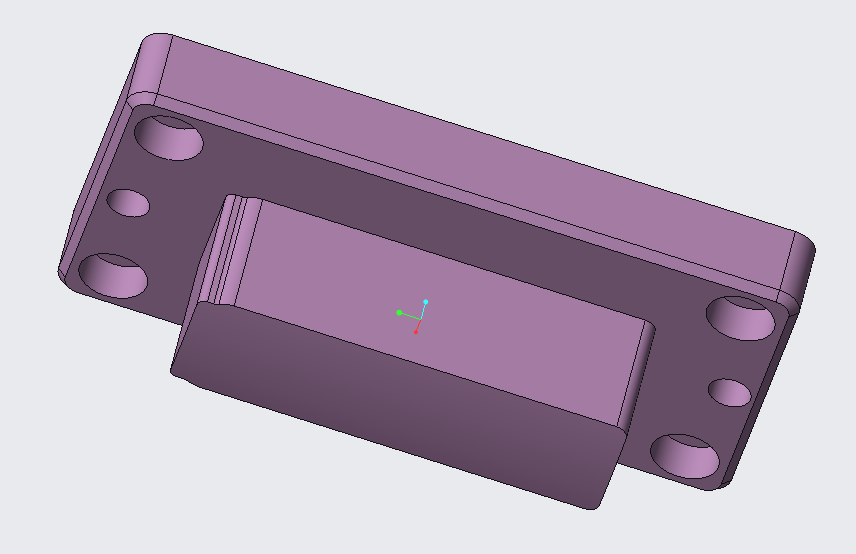
[picture p179: figure]

Al+1mm rubber, 70A

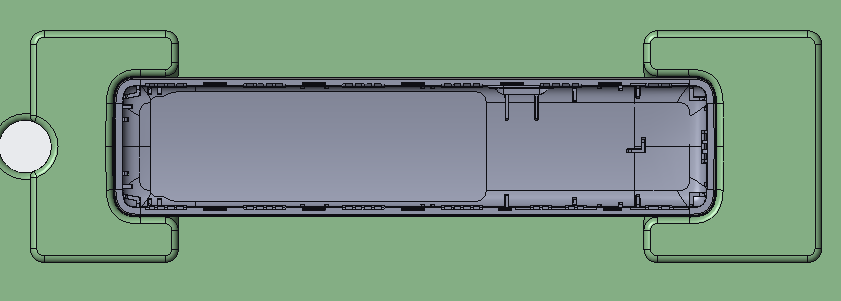
[picture p180: figure]
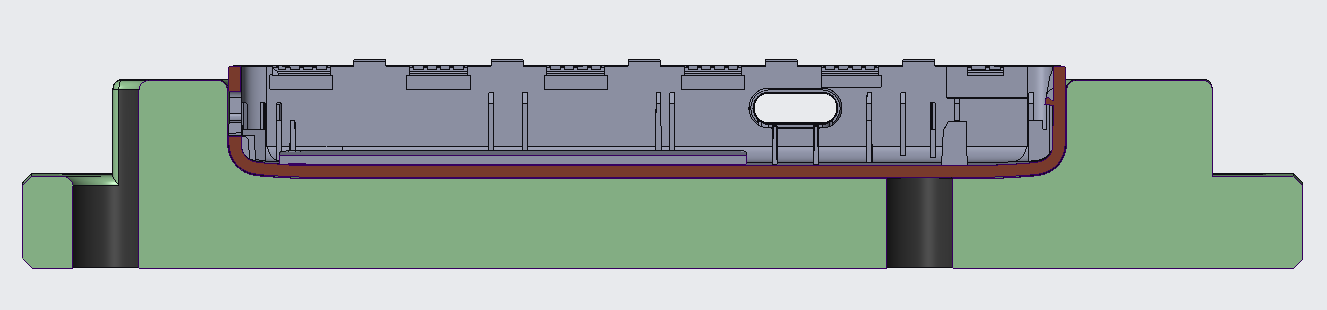
[picture p181: figure]

X direction

Y direction

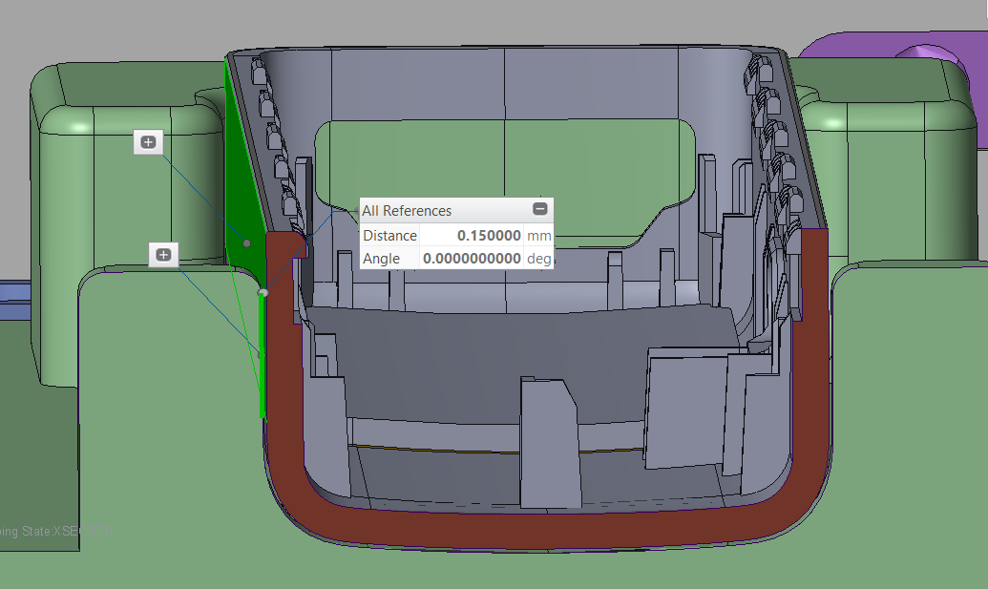
[picture p182: figure]

The gap between housing and holder is 0.15mm.

No interference with housing

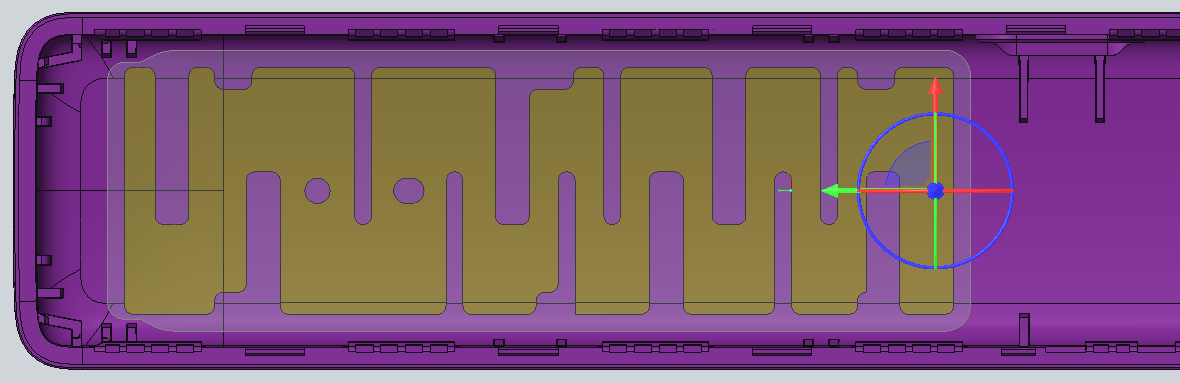
[picture p183: figure]

Press head is 0.5mm larger then copper foil.

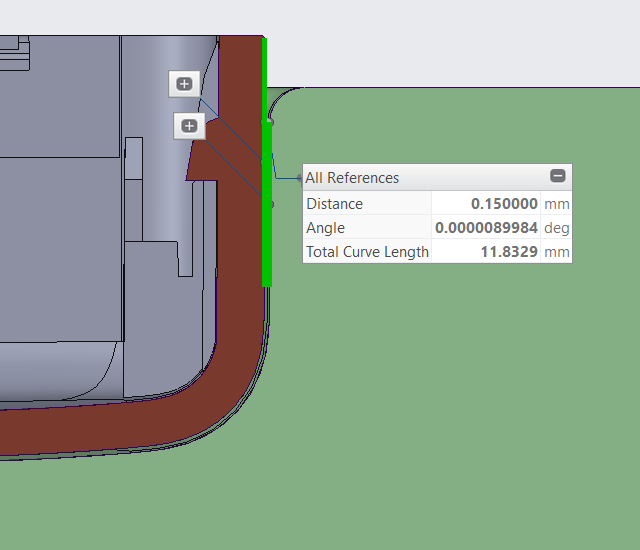
[picture p184: figure]

## Slide 7

Calgary Press Bot Copper Foil Fixture

- Holder and press head alignment

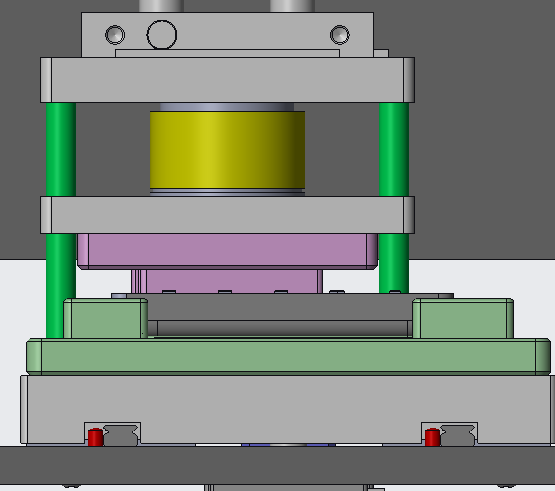
[picture p185: figure]
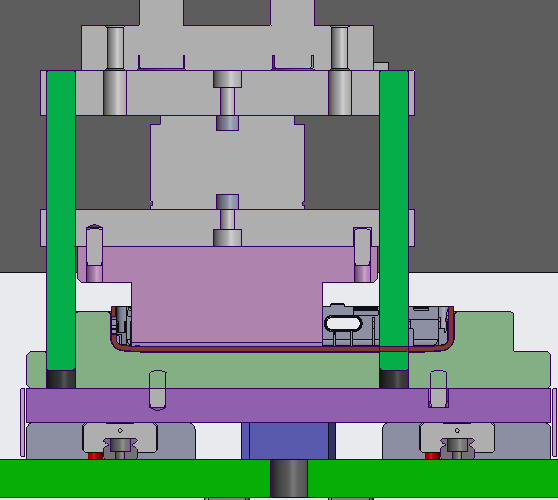
[picture p186: figure]

Alignment pin.

Press head plate

Press head

pin

The press head is aligned with press head plate by pin, then we use alignment pin to do alignment during fixture adjustment.

## Slide 8

Calgary Press Bot Copper Foil Fixture

- Work procedures

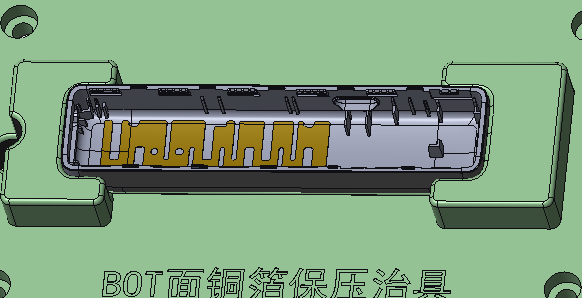
[picture p187: figure]

1.Put housing on holder

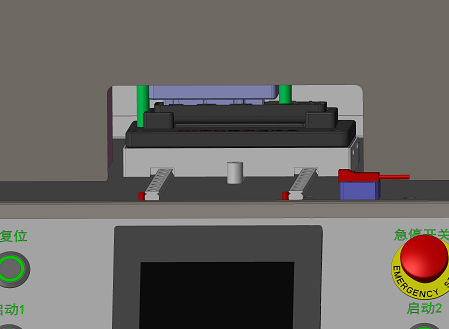
[picture p188: figure]

3.Press copper foil

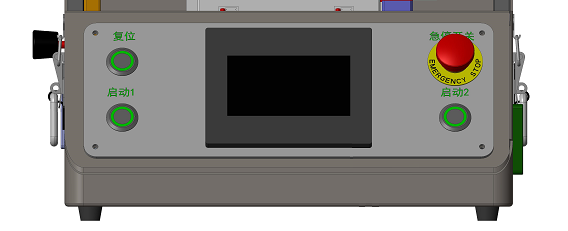
[picture p189: figure]

2.Press start button to start fixture

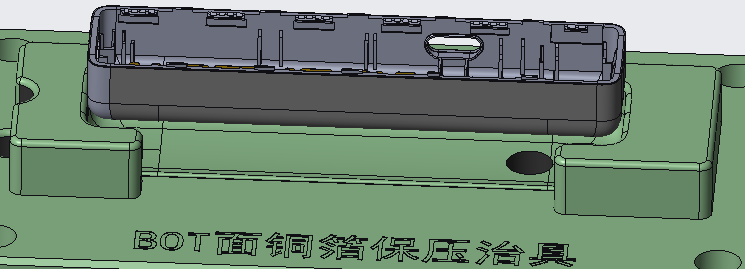
[picture p190: figure]

4.Take out device
