Cinthanh1998/Du-an-Foxconn/Calgary_Dispensing_Bot_Thermal_Gel_Fixture_DFM_20240911.pptx

Dispensing bot thermal gel fixture Ver2.0

CNT
2025.07.11

## Dispensing bot thermal gel fixture

- Fixture overview

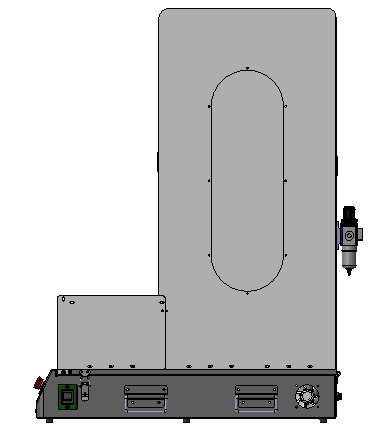
[picture p191: figure]
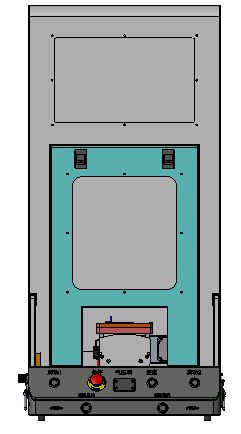
[picture p192: figure]

360mm

975mm

767mm

Summary: The fixture size is L*W*H=360mm*767mm*975mm.

## Dispensing bot thermal gel fixture

- Fixture parts

Protect

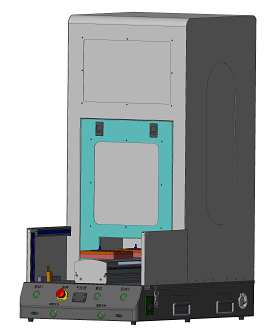
[picture p193: figure]

Extrude cylinder

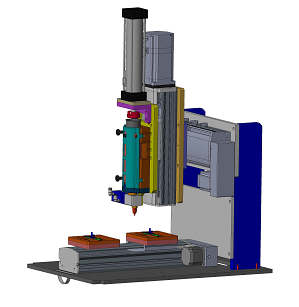
[picture p194: figure]

Light curtain

Z axis motor

Putty bottle fix structure

Vacuum value

X axis

Control button

Dispensing nozzle

Emergency stop

Power button

Y axis

holder

Y axis motor

## Slide 4

Dispensing bot thermal gel fixture

- Holder design

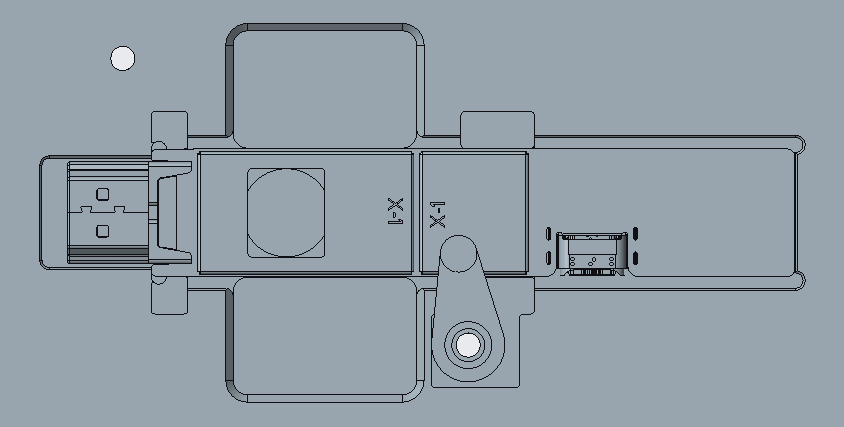
[picture p195: figure]
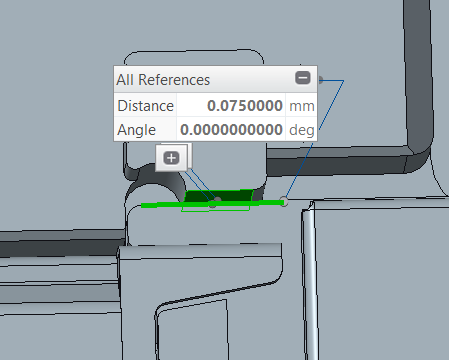
[picture p196: figure]
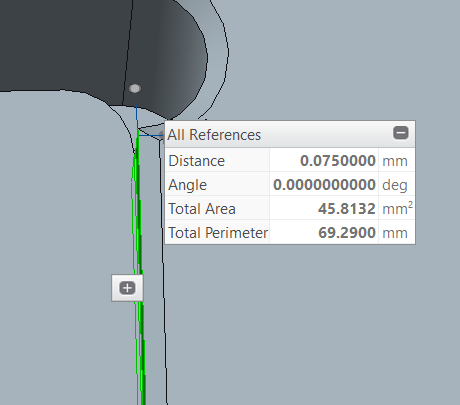
[picture p197: figure]

The gap between PCBA and holder is 0.075mm.

Material: AL7075

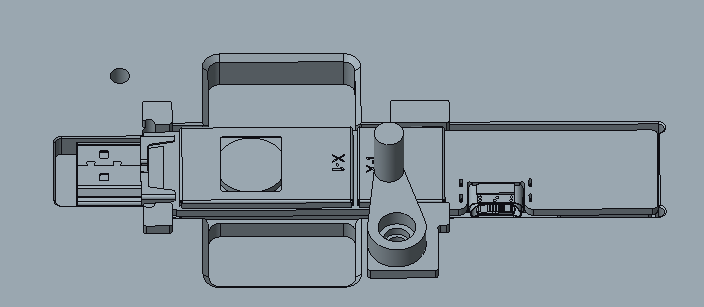
[picture p198: figure]

Added a buckle to press PCBA

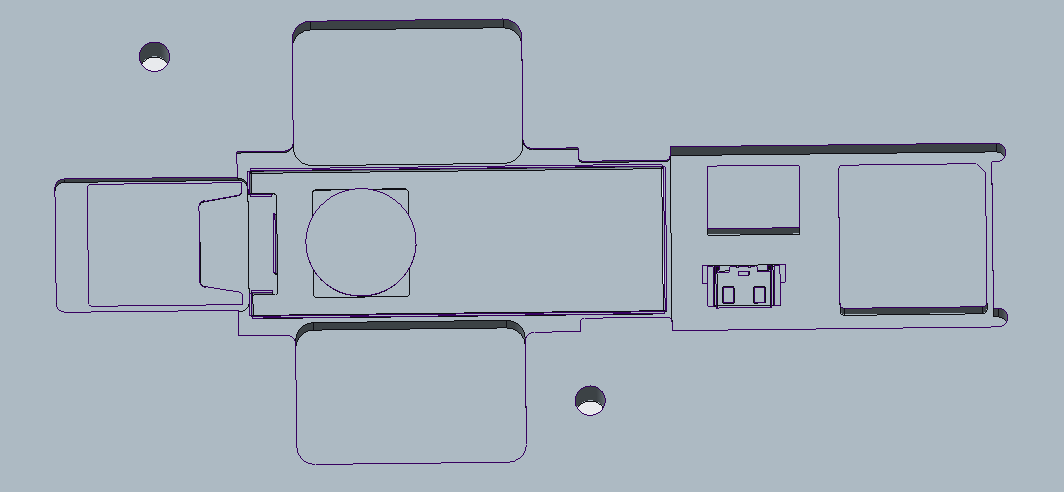
[picture p199: figure]

No interference between PCBA and holder

## Slide 5

Dispensing bot thermal gel fixture

- Work procedures

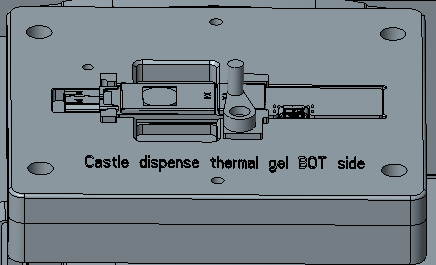
[picture p200: figure]

1.Put PCBA to holder and using buckle to press PCBA

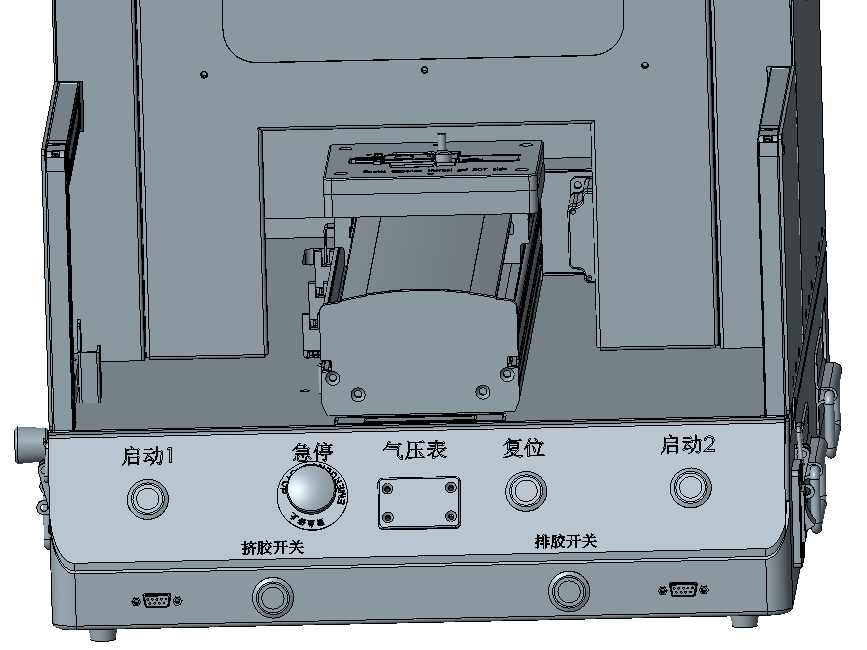
[picture p201: figure]

2.Press start button to start dispensing

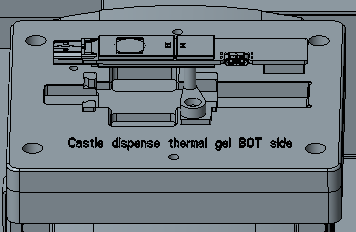
[picture p202: figure]

3.Take out PCBA
