Cinthanh1998/Du-an-Foxconn/30_bai_giao_tiep_thong_dung_nhat_0106.pdf

## Bài học 2 Bạn có nói tiếng Anh không?

Xin l i, b n là ng i M ph i không? ỗ ạ | ườ | ỹ ả
Excuse (http://vdict.com/Excuse,1,0,0.html) me, (http://vdict.com/me,1,0,0.html) are (http://vdict.com/are,1,0,0.html) you (http://vdict.com/you,1,0,0.html) American? (http://vdict.com/American,1,0,0.html)
Không.

## No. (http://vdict.com/No,1,0,0.html)

B n có nói ti ng Anh khôn ạ | ế | g?
Do (http://vdict.com/Do,1,0,0.html) you (http://vdict.com/you,1,0,0.html) speak (http://vdict.com/speak,1,0,0.html) English? (http://vdict.com/English,1,0,0.html)
M t chút, nh ng không gi i l m. ộ | ư | ỏ ắ
A (http://vdict.com/A,1,0,0.html) little, (http://vdict.com/little,1,0,0.html) but (http://vdict.com/but,1,0,0.html) not (http://vdict.com/not,1,0,0.html) very (http://vdict.com/very,1,0,0.html) well. (http://vdict.com/well,1,0,0.html)
B n đây bao lâu r i? ạ ở | ồ
How (http://vdict.com/How,1,0,0.html) long (http://vdict.com/long,1,0,0.html) have (http://vdict.com/have,1,0,0.html) you (http://vdict.com/you,1,0,0.html) been (http://vdict.com/been,1,0,0.html) here? (http://vdict.com/here,1,0,0.html)
Hai tháng.

## 2 (http://vdict.com/2,1,0,0.html) months. (http://vdict.com/months,1,0,0.html)

B n làm ngh gì? ạ | ề
What (http://vdict.com/What,1,0,0.html) do (http://vdict.com/do,1,0,0.html) you (http://vdict.com/you,1,0,0.html) do (http://vdict.com/do,1,0,0.html) for (http://vdict.com/for,1,0,0.html) work? (http://vdict.com/work,1,0,0.html)
Tôi là m t h c sinh. Còn b n? ộ ọ | ạ
I'm (http://vdict.com/I'm,1,0,0.html) a (http://vdict.com/a,1,0,0.html) student. (http://vdict.com/student,1,0,0.html) How (http://vdict.com/How,1,0,0.html) about (http://vdict.com/about,1,0,0.html) you? (http://vdict.com/you,1,0,0.html)
Tôi cũng là m t h c sinh. ộ ọ
I'm (http://vdict.com/I'm,1,0,0.html) a (http://vdict.com/a,1,0,0.html) student (http://vdict.com/student,1,0,0.html) too. (http://vdict.com/too,1,0,0.html)

## Bài học 3 Tên bạn là gì?

## John (http://vdict.com/John,1,0,0.html)

Xin l i, b n tên là gì? ỗ ạ
Excuse (http://vdict.com/Excuse,1,0,0.html) me, (http://vdict.com/me,1,0,0.html) what's (http://vdict.com/what's,1,0,0.html) your (http://vdict.com/your,1,0,0.html) name? (http://vdict.com/name,1,0,0.html)
Jessica (http://vdict.com/Jessica,1,0,0.html) | Tên tôi là Jessica. Còn tên c a b n? ủ ạ My (http://vdict.com/My,1,0,0.html) name (http://vdict.com/name,1,0,0.html) is (http://vdict.com/is,1,0,0.html) Jessica. (http://vdict.com/Jessica,1,0,0.html) What's (http://vdict.com/What's,1,0,0.html) yours? (http://vdict.com/yours,1,0,0.html)
John (http://vdict.com/John,1,0,0.html) | John. John. (http://vdict.com/John,1,0,0.html)
Jessica (http://vdict.com/Jessica,1,0,0.html) | B n nói ti ng Anh r t gi i. ạ ế ấ ỏ You (http://vdict.com/You,1,0,0.html) speak (http://vdict.com/speak,1,0,0.html) English (http://vdict.com/English,1,0,0.html) very (http://vdict.com/very,1,0,0.html) well. (http://vdict.com/well,1,0,0.html)
John (http://vdict.com/John,1,0,0.html) | Cám n. ơ Thank (http://vdict.com/Thank,1,0,0.html) you. (http://vdict.com/you,1,0,0.html)
Jessica (http://vdict.com/Jessica,1,0,0.html) | B n bi t bây gi là m y gi không? ạ ế ờ ấ ờ Do (http://vdict.com/Do,1,0,0.html) you (http://vdict.com/you,1,0,0.html) know (http://vdict.com/know,1,0,0.html) what (http://vdict.com/what,1,0,0.html) time (http://vdict.com/time,1,0,0.html) it (http://vdict.com/it,1,0,0.html) is? (http://vdict.com/is,1,0,0.html)
John (http://vdict.com/John,1,0,0.html) | Ch c r i. Bây gi là 5:10 chi u. ắ ồ ờ ề Sure. (http://vdict.com/Sure,1,0,0.html) It's (http://vdict.com/It's,1,0,0.html) 5:10PM. (http://vdict.com/510PM,1,0,0.html)
Jessica (http://vdict.com/Jessica,1,0,0.html) | B n nói gì? ạ What (http://vdict.com/What,1,0,0.html) did (http://vdict.com/did,1,0,0.html) you (http://vdict.com/you,1,0,0.html) say? (http://vdict.com/say,1,0,0.html)
John (http://vdict.com/John,1,0,0.html) | Tôi nói bây gi là 5:10 chi u. ờ ề I (http://vdict.com/I,1,0,0.html) said (http://vdict.com/said,1,0,0.html) it's (http://vdict.com/it's,1,0,0.html) 5:10PM. (http://vdict.com/510PM,1,0,0.html)
Jessica (http://vdict.com/Jessica,1,0,0.html) | Cám n. ơ Thanks. (http://vdict.com/Thanks,1,0,0.html)
John (http://vdict.com/John,1,0,0.html) | Không có gì. You're (http://vdict.com/You're,1,0,0.html) welcome. (http://vdict.com/welcome,1,0,0.html)

Bài học 4 Hỏi đường.

Amy (http://vdict.com/Amy,1,0,0.html) | Chào Michael. Hi (http://vdict.com/Hi,1,0,0.html) Michael.
Michael (http://vdict.com/Michael,1,0,0.html) | Chào Amy. Có chuy n gì v y? ệ ậ Hi (http://vdict.com/Hi,1,0,0.html) Amy. (http://vdict.com/Amy,1,0,0.html) What's (http://vdict.com/What's,1,0,0.html) up? (http://vdict.com/up,1,0,0.html)

## Amy (http://vdict.com/Amy,1,0,0.html)

Tôi đang tìm phi tr ng. B n có th nói cho ườ | ạ | ể
tôi bi t làm cách nào đ n đó đ c không? ế | | | ế | ượ
I'm (http://vdict.com/I'm,1,0,0.html) looking (http://vdict.com/looking,1,0,0.html) for (http://vdict.com/for,1,0,0.html) the (http://vdict.com/the,1,0,0.html) airport. (http://vdict.com/airport,1,0,0.html) Can (http://vdict.com/Can,1,0,0.html) you (http://vdict.com/you,1,0,0.html) tell (http://vdict.com/tell,1,0,0.html) me (http://vdict.com/me,1,0,0.html) how (http://vdict.com/how,1,0,0.html) to (http://vdict.com/to,1,0,0.html) get (http://vdict.com/get,1,0,0.html) there? (http://vdict.com/there,1,0,0.html)

## Michael (http://vdict.com/Michael,1,0,0.html)

Không, r t ti c. Tôi không bi t. ấ ế | ế
No, (http://vdict.com/No,1,0,0.html) sorry. (http://vdict.com/sorry,1,0,0.html) I (http://vdict.com/I,1,0,0.html) don't (http://vdict.com/don't,1,0,0.html) know. (http://vdict.com/know,1,0,0.html)

## Amy (http://vdict.com/Amy,1,0,0.html)

Tôi nghĩ tôi có th đi xe đi n ng m đ t i phi ể | ệ | ầ | ể ớ
tr ng. B n có bi t đu ng xe đi n ng m ườ | ạ | ế | ờ | ệ | ầ ở
đâu không?
I (http://vdict.com/I,1,0,0.html) think (http://vdict.com/think,1,0,0.html) I (http://vdict.com/I,1,0,0.html) can (http://vdict.com/can,1,0,0.html) take (http://vdict.com/take,1,0,0.html) the (http://vdict.com/the,1,0,0.html) subway (http://vdict.com/subway,1,0,0.html) to (http://vdict.com/to,1,0,0.html) the (http://vdict.com/the,1,0,0.html) airport. (http://vdict.com/airport,1,0,0.html) Do (http://vdict.com/Do,1,0,0.html) you (http://vdict.com/you,1,0,0.html) know (http://vdict.com/know,1,0,0.html) where (http://vdict.com/where,1,0,0.html) the (http://vdict.com/the,1,0,0.html) subway (http://vdict.com/subway,1,0,0.html) is? (http://vdict.com/is,1,0,0.html)
Michael (http://vdict.com/Michael,1,0,0.html) | Ch c r i. Nó đ ng kia. ắ ổ ở ằ Sure, (http://vdict.com/Sure,1,0,0.html) it's (http://vdict.com/it's,1,0,0.html) over (http://vdict.com/over,1,0,0.html) there. (http://vdict.com/there,1,0,0.html)
Amy (http://vdict.com/Amy,1,0,0.html) | Ở ấ đâu? Tôi không th y nó. Where? (http://vdict.com/Where,1,0,0.html) I (http://vdict.com/I,1,0,0.html) don't (http://vdict.com/don't,1,0,0.html) see (http://vdict.com/see,1,0,0.html) it. (http://vdict.com/it,1,0,0.html)
Michael (http://vdict.com/Michael,1,0,0.html) | Phía bên kia đ ng. ườ Across (http://vdict.com/Across,1,0,0.html) the (http://vdict.com/the,1,0,0.html) street. (http://vdict.com/street,1,0,0.html)
Amy (http://vdict.com/Amy,1,0,0.html) | Ô, bây gi tôi th y r i. Cám n. ờ ấ ồ ơ Oh, (http://vdict.com/Oh,1,0,0.html) I (http://vdict.com/I,1,0,0.html) see (http://vdict.com/see,1,0,0.html) it (http://vdict.com/it,1,0,0.html) now. (http://vdict.com/now,1,0,0.html) Thanks. (http://vdict.com/Thanks,1,0,0.html)

## Bai 1 ban tu dau toi

Xin chào.

## Hello. (http://vdict.com/Hello,1,0,0.html)

Xin chào.

## Hi. (http://vdict.com/Hi,1,0,0.html)

B n kh e không? ạ ỏ
How (http://vdict.com/How,1,0,0.html) are (http://vdict.com/are,1,0,0.html) you? (http://vdict.com/you,1,0,0.html)
Tôi kh e. B n kh e không? ỏ | ạ | ỏ
I'm (http://vdict.com/I'm,1,0,0.html) good. (http://vdict.com/good,1,0,0.html) How (http://vdict.com/How,1,0,0.html) are (http://vdict.com/are,1,0,0.html) you? (http://vdict.com/you,1,0,0.html)
Kh e. B n có nói ti ng An ỏ | ạ | ế | h không?
Good. (http://vdict.com/Good,1,0,0.html) Do (http://vdict.com/Do,1,0,0.html) you (http://vdict.com/you,1,0,0.html) speak (http://vdict.com/speak,1,0,0.html) English? (http://vdict.com/English,1,0,0.html)
M t chút. B n là ng i M h ? ộ | ạ | ườ | ỹ ả
A (http://vdict.com/A,1,0,0.html) little. (http://vdict.com/little,1,0,0.html) Are (http://vdict.com/Are,1,0,0.html) you (http://vdict.com/you,1,0,0.html) American? (http://vdict.com/American,1,0,0.html)
Vâng.

## Yes. (http://vdict.com/Yes,1,0,0.html)

B n t đâu t i? ạ ừ ớ
Where (http://vdict.com/Where,1,0,0.html) are (http://vdict.com/are,1,0,0.html) you (http://vdict.com/you,1,0,0.html) from? (http://vdict.com/from,1,0,0.html)
Tôi t California. ừ
I'm (http://vdict.com/I'm,1,0,0.html) from (http://vdict.com/from,1,0,0.html) California. (http://vdict.com/California,1,0,0.html)
R t vui đ c g p b n. ấ ượ ặ ạ
Nice (http://vdict.com/Nice,1,0,0.html) to (http://vdict.com/to,1,0,0.html) meet (http://vdict.com/meet,1,0,0.html) you. (http://vdict.com/you,1,0,0.html)
Tôi cũng r t vui đ c g p b n ấ ượ ặ ạ
Nice (http://vdict.com/Nice,1,0,0.html) to (http://vdict.com/to,1,0,0.html) meet (http://vdict.com/meet,1,0,0.html) you (http://vdict.com/you,1,0,0.html) too. (http://vdict.com/too,1,0,0.html)

## Michael (http://vdict.com/Michael,1,0,0.html)

Không có gì.

## No (http://vdict.com/No,1,0,0.html) problem. (http://vdict.com/problem,1,0,0.html)

## Amy (http://vdict.com/Amy,1,0,0.html)

B n bi t có nhà v sinh nào quanh đây không? ạ | ế | ệ
Do (http://vdict.com/Do,1,0,0.html) you (http://vdict.com/you,1,0,0.html) know (http://vdict.com/know,1,0,0.html) if (http://vdict.com/if,1,0,0.html) there's (http://vdict.com/there's,1,0,0.html) a (http://vdict.com/a,1,0,0.html) restroom (http://vdict.com/restroom,1,0,0.html) around (http://vdict.com/around,1,0,0.html)

## here? (http://vdict.com/here,1,0,0.html)

Michael (http://vdict.com/Michael,1,0,0.html) | Vâng. Có m t cái đây. Nó trong c a hàng. ộ ở ở ử Yes, (http://vdict.com/Yes,1,0,0.html) there's (http://vdict.com/there's,1,0,0.html) one (http://vdict.com/one,1,0,0.html) here. (http://vdict.com/here,1,0,0.html) It's (http://vdict.com/It's,1,0,0.html) in (http://vdict.com/in,1,0,0.html) the (http://vdict.com/the,1,0,0.html) store. (http://vdict.com/store,1,0,0.html)
Amy (http://vdict.com/Amy,1,0,0.html) | Cám n. ơ Thank (http://vdict.com/Thank,1,0,0.html) you. (http://vdict.com/you,1,0,0.html)
Michael (http://vdict.com/Michael,1,0,0.html) | T m bi t. ạ ệ Bye. (http://vdict.com/Bye,1,0,0.html)
Amy (http://vdict.com/Amy,1,0,0.html) | T m bi t. ạ ệ Bye (http://vdict.com/Bye,1,0,0.html) bye. (http://vdict.com/bye,1,0,0.html)

Bài học 5 Tôi đói.

Thomas (http://vdict.com/Thomas,1,0,0.html) | Chào Sarah, b n kh e không? ạ ỏ Hi (http://vdict.com/Hi,1,0,0.html) Sarah, (http://vdict.com/Sarah,1,0,0.html) how (http://vdict.com/how,1,0,0.html) are (http://vdict.com/are,1,0,0.html) you? (http://vdict.com/you,1,0,0.html)
Sarah (http://vdict.com/Sarah,1,0,0.html) | Kh e, b n th nào? ỏ ạ ế Fine, (http://vdict.com/Fine,1,0,0.html) how (http://vdict.com/how,1,0,0.html) are (http://vdict.com/are,1,0,0.html) you (http://vdict.com/you,1,0,0.html) doing? (http://vdict.com/doing,1,0,0.html)
Thomas (http://vdict.com/Thomas,1,0,0.html) | Đ c. ượ OK. (http://vdict.com/OK,1,0,0.html)
Sarah (http://vdict.com/Sarah,1,0,0.html) | B n mu n làm gì? ạ ố What (http://vdict.com/What,1,0,0.html) do (http://vdict.com/do,1,0,0.html) you (http://vdict.com/you,1,0,0.html) want (http://vdict.com/want,1,0,0.html) to (http://vdict.com/to,1,0,0.html) do? (http://vdict.com/do,1,0,0.html)
Thomas (http://vdict.com/Thomas,1,0,0.html) | Tôi đói. Tôi mu n ăn th gì đó. ố ứ I'm (http://vdict.com/I'm,1,0,0.html) hungry. (http://vdict.com/hungry,1,0,0.html) I'd (http://vdict.com/I'd,1,0,0.html) like (http://vdict.com/like,1,0,0.html) to (http://vdict.com/to,1,0,0.html) eat (http://vdict.com/eat,1,0,0.html) something. (http://vdict.com/something,1,0,0.html)
Sarah (http://vdict.com/Sarah,1,0,0.html) | B n mu n đi đâu? ạ ố Where (http://vdict.com/Where,1,0,0.html) do (http://vdict.com/do,1,0,0.html) you (http://vdict.com/you,1,0,0.html) want (http://vdict.com/want,1,0,0.html) to (http://vdict.com/to,1,0,0.html) go? (http://vdict.com/go,1,0,0.html)
Thomas (http://vdict.com/Thomas,1,0,0.html) | Tôi mu n đi t i m t nhà hàng Ý ố ớ ộ I'd (http://vdict.com/I'd,1,0,0.html) like (http://vdict.com/like,1,0,0.html) to (http://vdict.com/to,1,0,0.html) go (http://vdict.com/go,1,0,0.html) to (http://vdict.com/to,1,0,0.html) an (http://vdict.com/an,1,0,0.html) Italian (http://vdict.com/Italian,1,0,0.html) restaurant. (http://vdict.com/restaurant,1,0,0.html)
Sarah (http://vdict.com/Sarah,1,0,0.html) | B n thích lo i món ăn Ý nào? ạ ạ What (http://vdict.com/What,1,0,0.html) kind (http://vdict.com/kind,1,0,0.html) of (http://vdict.com/of,1,0,0.html) Italian (http://vdict.com/Italian,1,0,0.html) food (http://vdict.com/food,1,0,0.html) do (http://vdict.com/do,1,0,0.html) you (http://vdict.com/you,1,0,0.html) like? (http://vdict.com/like,1,0,0.html)
Thomas (http://vdict.com/Thomas,1,0,0.html) | Tôi thích spaghetti. B n có thích spaghetti ạ không? I (http://vdict.com/I,1,0,0.html) like (http://vdict.com/like,1,0,0.html) spaghetti. (http://vdict.com/spaghetti,1,0,0.html) Do (http://vdict.com/Do,1,0,0.html) you (http://vdict.com/you,1,0,0.html) like (http://vdict.com/like,1,0,0.html) spaghetti? (http://vdict.com/spaghetti,1,0,0.html)
Sara | Không, tôi không thích, nh ng tôi thích pizza. ư No, (http://vdict.com/No,1,0,0.html) I (http://vdict.com/I,1,0,0.html) don't, (http://vdict.com/don't,1,0,0.html) but (http://vdict.com/but,1,0,0.html) I (http://vdict.com/I,1,0,0.html) like (http://vdict.com/like,1,0,0.html) pizza. (http://vdict.com/pizza,1,0,0.html)

## Bài học 6 Bạn có muốn uống gì không?

Susan (http://vdict.com/Susan,1,0,0.html) | David, b n mu n ăn món gì không? ạ ố David, (http://vdict.com/David,1,0,0.html) would (http://vdict.com/would,1,0,0.html) you (http://vdict.com/you,1,0,0.html) like (http://vdict.com/like,1,0,0.html) something (http://vdict.com/something,1,0,0.html) to (http://vdict.com/to,1,0,0.html) eat? (http://vdict.com/eat,1,0,0.html)
David (http://vdict.com/David,1,0,0.html) | Không, tôi no r i. ồ No, (http://vdict.com/No,1,0,0.html) I'm (http://vdict.com/I'm,1,0,0.html) full. (http://vdict.com/full,1,0,0.html)

## Susan (http://vdict.com/Susan,1,0,0.html)

B n mu n u ng th gì không? ạ | ố ố | ứ
Do (http://vdict.com/Do,1,0,0.html) you (http://vdict.com/you,1,0,0.html) want (http://vdict.com/want,1,0,0.html) something (http://vdict.com/something,1,0,0.html) to (http://vdict.com/to,1,0,0.html) drink? (http://vdict.com/drink,1,0,0.html)

## David (http://vdict.com/David,1,0,0.html)

Vâng, tôi mu n m t ít cà phê. ố ộ
Yes, (http://vdict.com/Yes,1,0,0.html) I'd (http://vdict.com/I'd,1,0,0.html) like (http://vdict.com/like,1,0,0.html) some (http://vdict.com/some,1,0,0.html) coffee. (http://vdict.com/coffee,1,0,0.html)
Susan (http://vdict.com/Susan,1,0,0.html) | R t ti c, tôi không có cà phê. ấ ế Sorry, (http://vdict.com/Sorry,1,0,0.html) I (http://vdict.com/I,1,0,0.html) don't (http://vdict.com/don't,1,0,0.html) have (http://vdict.com/have,1,0,0.html) any (http://vdict.com/any,1,0,0.html) coffee. (http://vdict.com/coffee,1,0,0.html)
David (http://vdict.com/David,1,0,0.html) | Đ c thôi. Tôi s u ng m t ly n c. ượ ẽ ố ộ ướ That's (http://vdict.com/That's,1,0,0.html) OK. (http://vdict.com/OK,1,0,0.html) I'll (http://vdict.com/I'll,1,0,0.html) have (http://vdict.com/have,1,0,0.html) a (http://vdict.com/a,1,0,0.html) glass (http://vdict.com/glass,1,0,0.html) of (http://vdict.com/of,1,0,0.html) water. (http://vdict.com/water,1,0,0.html)
Susan (http://vdict.com/Susan,1,0,0.html) | Ly nh hay ly l n. ỏ ớ A (http://vdict.com/A,1,0,0.html) small (http://vdict.com/small,1,0,0.html) glass, (http://vdict.com/glass,1,0,0.html) or (http://vdict.com/or,1,0,0.html) a (http://vdict.com/a,1,0,0.html) big (http://vdict.com/big,1,0,0.html) one? (http://vdict.com/one,1,0,0.html)
David (http://vdict.com/David,1,0,0.html) | Làm n cho ly nh . ơ ỏ Small (http://vdict.com/Small,1,0,0.html) please. (http://vdict.com/please,1,0,0.html)
Susan (http://vdict.com/Susan,1,0,0.html) | Đây. Here (http://vdict.com/Here,1,0,0.html) you (http://vdict.com/you,1,0,0.html) go. (http://vdict.com/go,1,0,0.html)
David (http://vdict.com/David,1,0,0.html) | Cám n. ơ Thanks. (http://vdict.com/Thanks,1,0,0.html)
Susan (http://vdict.com/Susan,1,0,0.html) | Không có gì. You're (http://vdict.com/You're,1,0,0.html) welcome. (http://vdict.com/welcome,1,0,0.html)

Bài học 7 Muộn quá.

Richard (http://vdict.com/Richard,1,0,0.html) | Mary, b n mu n mua th gì đ ăn cùng v i ạ ố ứ ể ớ tôi không? Mary, (http://vdict.com/Mary,1,0,0.html) would (http://vdict.com/would,1,0,0.html) you (http://vdict.com/you,1,0,0.html) like (http://vdict.com/like,1,0,0.html) to (http://vdict.com/to,1,0,0.html) get (http://vdict.com/get,1,0,0.html) something (http://vdict.com/something,1,0,0.html) to (http://vdict.com/to,1,0,0.html) eat (http://vdict.com/eat,1,0,0.html) with (http://vdict.com/with,1,0,0.html) me? (http://vdict.com/me,1,0,0.html)
Mary (http://vdict.com/Mary,1,0,0.html) | Đ c, khi nào? ượ OK. (http://vdict.com/OK,1,0,0.html) When? (http://vdict.com/When,1,0,0.html)
Richard (http://vdict.com/Richard,1,0,0.html) | Lúc 10 giờ At (http://vdict.com/At,1,0,0.html) 10 (http://vdict.com/10,1,0,0.html) O'clock. (http://vdict.com/O'clock,1,0,0.html)
Mary (http://vdict.com/Mary,1,0,0.html) | 10 gi sáng h ? ờ ả 10 (http://vdict.com/10,1,0,0.html) in (http://vdict.com/in,1,0,0.html) the (http://vdict.com/the,1,0,0.html) morning? (http://vdict.com/morning,1,0,0.html)
Richard (http://vdict.com/Richard,1,0,0.html) | Không, t i. ố No, (http://vdict.com/No,1,0,0.html) at (http://vdict.com/at,1,0,0.html) night. (http://vdict.com/night,1,0,0.html)
Mary (http://vdict.com/Mary,1,0,0.html) | R t ti c, tr quá. Tôi th ng đi ng kho ng ấ ế ễ ườ ủ ả 10 gi t i. ờ ố Sorry, (http://vdict.com/Sorry,1,0,0.html) that's (http://vdict.com/that's,1,0,0.html) too (http://vdict.com/too,1,0,0.html) late. (http://vdict.com/late,1,0,0.html) I (http://vdict.com/I,1,0,0.html) usually (http://vdict.com/usually,1,0,0.html) go (http://vdict.com/go,1,0,0.html) to (http://vdict.com/to,1,0,0.html) bed (http://vdict.com/bed,1,0,0.html) around (http://vdict.com/around,1,0,0.html) 10:00PM. (http://vdict.com/1000PM,1,0,0.html)
Richard (http://vdict.com/Richard,1,0,0.html) | Đ c, 1:30 chi u thì sao? ượ ề OK, (http://vdict.com/OK,1,0,0.html) how (http://vdict.com/how,1,0,0.html) about (http://vdict.com/about,1,0,0.html) 1:30 (http://vdict.com/130,1,0,0.html) PM? (http://vdict.com/PM,1,0,0.html)
Mary (http://vdict.com/Mary,1,0,0.html) | Không, nh v y s m quá. Tôi v n còn đang ư ậ ớ ẫ làm vi c lúc đó. ệ No, (http://vdict.com/No,1,0,0.html) that's (http://vdict.com/that's,1,0,0.html) too (http://vdict.com/too,1,0,0.html) early. (http://vdict.com/early,1,0,0.html) I'll (http://vdict.com/I'll,1,0,0.html) still (http://vdict.com/still,1,0,0.html) be (http://vdict.com/be,1,0,0.html) at (http://vdict.com/at,1,0,0.html) work (http://vdict.com/work,1,0,0.html) then. (http://vdict.com/then,1,0,0.html)
Richard (http://vdict.com/Richard,1,0,0.html) | V y 5 gi chi u? ậ ờ ề How (http://vdict.com/How,1,0,0.html) about (http://vdict.com/about,1,0,0.html) 5:00PM? (http://vdict.com/500PM,1,0,0.html)
Mary (http://vdict.com/Mary,1,0,0.html) | T t l m. ố ắ That's (http://vdict.com/That's,1,0,0.html) fine. (http://vdict.com/fine,1,0,0.html)
Richard (http://vdict.com/Richard,1,0,0.html) | T t, g p b n lúc đó. ố ặ ạ OK, (http://vdict.com/OK,1,0,0.html) see (http://vdict.com/see,1,0,0.html) you (http://vdict.com/you,1,0,0.html) then. (http://vdict.com/then,1,0,0.html)

## Mary (http://vdict.com/Mary,1,0,0.html)

Đ c, t m bi t. ượ ạ ệ

## Alright. (http://vdict.com/Alright,1,0,0.html) Bye. (http://vdict.com/Bye,1,0,0.html)

Bài học 8 Định thời gian gặp nhau.

Charles (http://vdict.com/Charles,1,0,0.html) | Jennifer, b n có mu n ăn t i v i tôi không? ạ ố ố ớ Jennifer, (http://vdict.com/Jennifer,1,0,0.html) would (http://vdict.com/would,1,0,0.html) you (http://vdict.com/you,1,0,0.html) like (http://vdict.com/like,1,0,0.html) to (http://vdict.com/to,1,0,0.html) have (http://vdict.com/have,1,0,0.html) dinner (http://vdict.com/dinner,1,0,0.html) with (http://vdict.com/with,1,0,0.html) me? (http://vdict.com/me,1,0,0.html)
Jennifer (http://vdict.com/Jennifer,1,0,0.html) | Vâng, t t l m. B n mu n đi khi nào? ố ắ ạ ố Yes. (http://vdict.com/Yes,1,0,0.html) That (http://vdict.com/That,1,0,0.html) would (http://vdict.com/would,1,0,0.html) be (http://vdict.com/be,1,0,0.html) nice. (http://vdict.com/nice,1,0,0.html) When (http://vdict.com/When,1,0,0.html) do (http://vdict.com/do,1,0,0.html) you (http://vdict.com/you,1,0,0.html) want (http://vdict.com/want,1,0,0.html) to (http://vdict.com/to,1,0,0.html) go? (http://vdict.com/go,1,0,0.html)
Charles (http://vdict.com/Charles,1,0,0.html) | Hôm nay đ c không? ượ Is (http://vdict.com/Is,1,0,0.html) today (http://vdict.com/today,1,0,0.html) OK? (http://vdict.com/OK,1,0,0.html)
Jennifer (http://vdict.com/Jennifer,1,0,0.html) | R t ti c, tôi không th đi hôm nay. ấ ế ể Sorry, (http://vdict.com/Sorry,1,0,0.html) I (http://vdict.com/I,1,0,0.html) can't (http://vdict.com/can't,1,0,0.html) go (http://vdict.com/go,1,0,0.html) today. (http://vdict.com/today,1,0,0.html)
Charles (http://vdict.com/Charles,1,0,0.html) | T i mai thì sao? ố How (http://vdict.com/How,1,0,0.html) about (http://vdict.com/about,1,0,0.html) tomorrow (http://vdict.com/tomorrow,1,0,0.html) night? (http://vdict.com/night,1,0,0.html)
Jennifer (http://vdict.com/Jennifer,1,0,0.html) | Đ c, m y gi ? ượ ấ ờ Ok. (http://vdict.com/Ok,1,0,0.html) What (http://vdict.com/What,1,0,0.html) time? (http://vdict.com/time,1,0,0.html)
Charles (http://vdict.com/Charles,1,0,0.html) | 9 gi t i đ c không? ờ ố ượ Is (http://vdict.com/Is,1,0,0.html) 9:00PM (http://vdict.com/900PM,1,0,0.html) all (http://vdict.com/all,1,0,0.html) right? (http://vdict.com/right,1,0,0.html)
Jennifer (http://vdict.com/Jennifer,1,0,0.html) | Tôi nghĩ nh v y tr quá. ư ậ ễ I (http://vdict.com/I,1,0,0.html) think (http://vdict.com/think,1,0,0.html) that's (http://vdict.com/that's,1,0,0.html) too (http://vdict.com/too,1,0,0.html) late. (http://vdict.com/late,1,0,0.html)
Charles (http://vdict.com/Charles,1,0,0.html) | 6 gi chi u đ c không? ờ ề ượ Is (http://vdict.com/Is,1,0,0.html) 6:00PM (http://vdict.com/600PM,1,0,0.html) OK? (http://vdict.com/OK,1,0,0.html)
Jennifer (http://vdict.com/Jennifer,1,0,0.html) | T t r i. B n mu n đi đâu? ố ồ ạ ố Yes, (http://vdict.com/Yes,1,0,0.html) that's (http://vdict.com/that's,1,0,0.html) good. (http://vdict.com/good,1,0,0.html) Where (http://vdict.com/Where,1,0,0.html) would (http://vdict.com/would,1,0,0.html) you (http://vdict.com/you,1,0,0.html) like (http://vdict.com/like,1,0,0.html) to (http://vdict.com/to,1,0,0.html) go? (http://vdict.com/go,1,0,0.html)
Charles (http://vdict.com/Charles,1,0,0.html) | Nhà hàng Ý trên đ ng s 5. ườ ố The (http://vdict.com/The,1,0,0.html) Italian (http://vdict.com/Italian,1,0,0.html) restaurant (http://vdict.com/restaurant,1,0,0.html) on (http://vdict.com/on,1,0,0.html) 5th (http://vdict.com/5th,1,0,0.html) street. (http://vdict.com/street,1,0,0.html)
Jennifer (http://vdict.com/Jennifer,1,0,0.html) | Ồ, tôi không thích nhà hàng đó. Tôi không mu n đi t i đó. ố ớ Oh, (http://vdict.com/Oh,1,0,0.html) I (http://vdict.com/I,1,0,0.html) don't (http://vdict.com/don't,1,0,0.html) like (http://vdict.com/like,1,0,0.html) that (http://vdict.com/that,1,0,0.html) Restaurant. (http://vdict.com/Restaurant,1,0,0.html) I (http://vdict.com/I,1,0,0.html) don't (http://vdict.com/don't,1,0,0.html) want (http://vdict.com/want,1,0,0.html) to (http://vdict.com/to,1,0,0.html) go (http://vdict.com/go,1,0,0.html) there. (http://vdict.com/there,1,0,0.html)
Charles (http://vdict.com/Charles,1,0,0.html) | V y nhà hàng Hàn Qu c c nh đó thì sao? ậ ố ạ How (http://vdict.com/How,1,0,0.html) about (http://vdict.com/about,1,0,0.html) the (http://vdict.com/the,1,0,0.html) Korean (http://vdict.com/Korean,1,0,0.html) restaurant (http://vdict.com/restaurant,1,0,0.html) next (http://vdict.com/next,1,0,0.html) to (http://vdict.com/to,1,0,0.html) it? (http://vdict.com/it,1,0,0.html)
Jennifer (http://vdict.com/Jennifer,1,0,0.html) | Đ c, tôi thích n i đó. ượ ơ OK, (http://vdict.com/OK,1,0,0.html) I (http://vdict.com/I,1,0,0.html) like (http://vdict.com/like,1,0,0.html) that (http://vdict.com/that,1,0,0.html) place. (http://vdict.com/place,1,0,0.html)

## Bài học 9 Khi nào bạn muốn đi?

Linda (http://vdict.com/Linda,1,0,0.html) | Chào Mark. Hi (http://vdict.com/Hi,1,0,0.html) Mark.
Mark (http://vdict.com/Mark,1,0,0.html) | Chào. Hi. (http://vdict.com/Hi,1,0,0.html)
Linda (http://vdict.com/Linda,1,0,0.html) | B n d tính làm gì hôm nay? ạ ự What (http://vdict.com/What,1,0,0.html) are (http://vdict.com/are,1,0,0.html) you (http://vdict.com/you,1,0,0.html) planning (http://vdict.com/planning,1,0,0.html) to (http://vdict.com/to,1,0,0.html) do (http://vdict.com/do,1,0,0.html) today? (http://vdict.com/today,1,0,0.html)

## Mark (http://vdict.com/Mark,1,0,0.html)

Tôi ch a bi t ch c. ư | ế | ắ
I'm (http://vdict.com/I'm,1,0,0.html) not (http://vdict.com/not,1,0,0.html) sure (http://vdict.com/sure,1,0,0.html) yet. (http://vdict.com/yet,1,0,0.html)
Linda (http://vdict.com/Linda,1,0,0.html) | B n mu n ăn tr a v i tôi không? ạ ố ư ớ Would (http://vdict.com/Would,1,0,0.html) you (http://vdict.com/you,1,0,0.html) like (http://vdict.com/like,1,0,0.html) to (http://vdict.com/to,1,0,0.html) have (http://vdict.com/have,1,0,0.html) lunch (http://vdict.com/lunch,1,0,0.html) with (http://vdict.com/with,1,0,0.html) me? (http://vdict.com/me,1,0,0.html)
Mark (http://vdict.com/Mark,1,0,0.html) | Vâng, khi nào? Yes. (http://vdict.com/Yes,1,0,0.html) When? (http://vdict.com/When,1,0,0.html)
Linda (http://vdict.com/Linda,1,0,0.html) | 11:30 sáng đ c không? ượ Is (http://vdict.com/Is,1,0,0.html) 11:30AM (http://vdict.com/1130AM,1,0,0.html) OK? (http://vdict.com/OK,1,0,0.html)
Mark (http://vdict.com/Mark,1,0,0.html) | Xin l i tôi không nghe rõ. B n nói l i đ c ỗ ạ ạ ượ không? Sorry, (http://vdict.com/Sorry,1,0,0.html) I (http://vdict.com/I,1,0,0.html) didn't (http://vdict.com/didn't,1,0,0.html) hear (http://vdict.com/hear,1,0,0.html) you. (http://vdict.com/you,1,0,0.html) Can (http://vdict.com/Can,1,0,0.html) you (http://vdict.com/you,1,0,0.html) say (http://vdict.com/say,1,0,0.html) that (http://vdict.com/that,1,0,0.html) again (http://vdict.com/again,1,0,0.html) please? (http://vdict.com/please,1,0,0.html)
Linda (http://vdict.com/Linda,1,0,0.html) | Tôi nói là 11:30 sáng. I (http://vdict.com/I,1,0,0.html) said, (http://vdict.com/said,1,0,0.html) 11:30AM. (http://vdict.com/1130AM,1,0,0.html)
Mark (http://vdict.com/Mark,1,0,0.html) | Ồ ậ ể ặ ễ , khi đó tôi b n. Chúng ta có th g p nhau tr h n m t chút đ c không? ơ ộ ượ Oh, (http://vdict.com/Oh,1,0,0.html) I'm (http://vdict.com/I'm,1,0,0.html) busy (http://vdict.com/busy,1,0,0.html) then. (http://vdict.com/then,1,0,0.html) Can (http://vdict.com/Can,1,0,0.html) we (http://vdict.com/we,1,0,0.html) meet (http://vdict.com/meet,1,0,0.html) a (http://vdict.com/a,1,0,0.html) little (http://vdict.com/little,1,0,0.html) later? (http://vdict.com/later,1,0,0.html)
Linda (http://vdict.com/Linda,1,0,0.html) | Đ c, 12:30 tr a thì sao? ượ ư OK, (http://vdict.com/OK,1,0,0.html) how (http://vdict.com/how,1,0,0.html) about (http://vdict.com/about,1,0,0.html) 12:30PM? (http://vdict.com/1230PM,1,0,0.html)
Mark (http://vdict.com/Mark,1,0,0.html) | Đ c, đâu? ượ ở OK. (http://vdict.com/OK,1,0,0.html) Where? (http://vdict.com/Where,1,0,0.html)
Linda (http://vdict.com/Linda,1,0,0.html) | Nhà hàng h i s n Bill thì sao? ả ả How (http://vdict.com/How,1,0,0.html) about (http://vdict.com/about,1,0,0.html) Bill's (http://vdict.com/Bill's,1,0,0.html) Seafood (http://vdict.com/Seafood,1,0,0.html) Restaurant? (http://vdict.com/Restaurant,1,0,0.html)
Mark (http://vdict.com/Mark,1,0,0.html) | Đ c. Nó đâu? ượ ở Oh, (http://vdict.com/Oh,1,0,0.html) Where (http://vdict.com/Where,1,0,0.html) is (http://vdict.com/is,1,0,0.html) that? (http://vdict.com/that,1,0,0.html)
Linda (http://vdict.com/Linda,1,0,0.html) | Nó trên đ ng s 7. ở ườ ố It's (http://vdict.com/It's,1,0,0.html) on (http://vdict.com/on,1,0,0.html) 7th (http://vdict.com/7th,1,0,0.html) Street. (http://vdict.com/Street,1,0,0.html)
Mark (http://vdict.com/Mark,1,0,0.html) | Đ c, tôi s g p b n đó. ượ ẽ ặ ạ ở OK, (http://vdict.com/OK,1,0,0.html) I'll (http://vdict.com/I'll,1,0,0.html) meet (http://vdict.com/meet,1,0,0.html) you (http://vdict.com/you,1,0,0.html) there. (http://vdict.com/there,1,0,0.html)

Bài học 10 Gọi thức ăn.

Host (http://vdict.com/Host,1,0,0.html) | Xin chào ông, chào m ng đ n v i nhà hàng ừ ế ớ V n Pháp. Bao nhiêu ng i? ườ ườ Hello (http://vdict.com/Hello,1,0,0.html) sir, (http://vdict.com/sir,1,0,0.html) welcome (http://vdict.com/welcome,1,0,0.html) to (http://vdict.com/to,1,0,0.html) the (http://vdict.com/the,1,0,0.html) French (http://vdict.com/French,1,0,0.html) Garden (http://vdict.com/Garden,1,0,0.html) Restaurant. (http://vdict.com/Restaurant,1,0,0.html) How (http://vdict.com/How,1,0,0.html) many? (http://vdict.com/many,1,0,0.html)
Charles (http://vdict.com/Charles,1,0,0.html) | M t. ộ One. (http://vdict.com/One,1,0,0.html)

## Host (http://vdict.com/Host,1,0,0.html)

Ngay l i này. Xin m i ông ng i. M t lúc ố | ờ | ồ | ộ
n a cô ph c v s ti p ông. ữ | ụ ụ ẽ ế
Right (http://vdict.com/Right,1,0,0.html) this (http://vdict.com/this,1,0,0.html) way. (http://vdict.com/way,1,0,0.html) Please (http://vdict.com/Please,1,0,0.html) have (http://vdict.com/have,1,0,0.html) a (http://vdict.com/a,1,0,0.html) seat. (http://vdict.com/seat,1,0,0.html) Your (http://vdict.com/Your,1,0,0.html) waitress (http://vdict.com/waitress,1,0,0.html) will (http://vdict.com/will,1,0,0.html) be (http://vdict.com/be,1,0,0.html) with (http://vdict.com/with,1,0,0.html) you (http://vdict.com/you,1,0,0.html) in (http://vdict.com/in,1,0,0.html) a (http://vdict.com/a,1,0,0.html) moment. (http://vdict.com/moment,1,0,0.html)
Waitress (http://vdict.com/Waitress,1,0,0.html) | Xin chào ông, ông mu n g i món ăn bây gi ố ọ ờ không? Hello (http://vdict.com/Hello,1,0,0.html) sir, (http://vdict.com/sir,1,0,0.html) would (http://vdict.com/would,1,0,0.html) you (http://vdict.com/you,1,0,0.html) like (http://vdict.com/like,1,0,0.html) to (http://vdict.com/to,1,0,0.html) order (http://vdict.com/order,1,0,0.html) now? (http://vdict.com/now,1,0,0.html)
Charles (http://vdict.com/Charles,1,0,0.html) | Vâng, làm n. ơ Yes (http://vdict.com/Yes,1,0,0.html) please. (http://vdict.com/please,1,0,0.html)

## Waitress (http://vdict.com/Waitress,1,0,0.html)

Ông mu n u ng gì? ố ố
What (http://vdict.com/What,1,0,0.html) would (http://vdict.com/would,1,0,0.html) you (http://vdict.com/you,1,0,0.html) like (http://vdict.com/like,1,0,0.html) to (http://vdict.com/to,1,0,0.html) drink? (http://vdict.com/drink,1,0,0.html)
Charles (http://vdict.com/Charles,1,0,0.html) | Cô có nh ng th c u ng gì? ữ ứ ố What (http://vdict.com/What,1,0,0.html) do (http://vdict.com/do,1,0,0.html) you (http://vdict.com/you,1,0,0.html) have? (http://vdict.com/have,1,0,0.html)
Waitress (http://vdict.com/Waitress,1,0,0.html) | Chúng tôi có n c đóng chai, n c trái cây, ướ ướ và cô ca. We (http://vdict.com/We,1,0,0.html) have (http://vdict.com/have,1,0,0.html) bottled (http://vdict.com/bottled,1,0,0.html) water, (http://vdict.com/water,1,0,0.html) juice, (http://vdict.com/juice,1,0,0.html) and (http://vdict.com/and,1,0,0.html) Coke. (http://vdict.com/Coke,1,0,0.html)
Charles (http://vdict.com/Charles,1,0,0.html) | Làm n cho tôi m t chai n c. ơ ộ ướ I'll (http://vdict.com/I'll,1,0,0.html) have (http://vdict.com/have,1,0,0.html) a (http://vdict.com/a,1,0,0.html) bottle (http://vdict.com/bottle,1,0,0.html) of (http://vdict.com/of,1,0,0.html) water (http://vdict.com/water,1,0,0.html) please. (http://vdict.com/please,1,0,0.html)
Waitress (http://vdict.com/Waitress,1,0,0.html) | Ông mu n dùng món gì? ố What (http://vdict.com/What,1,0,0.html) would (http://vdict.com/would,1,0,0.html) you (http://vdict.com/you,1,0,0.html) like (http://vdict.com/like,1,0,0.html) to (http://vdict.com/to,1,0,0.html) eat? (http://vdict.com/eat,1,0,0.html)
Charles (http://vdict.com/Charles,1,0,0.html) | Tôi s dùng món bánh xăng uých cá ng và ẽ ừ m t chén súp rau. ộ I'll (http://vdict.com/I'll,1,0,0.html) have (http://vdict.com/have,1,0,0.html) a (http://vdict.com/a,1,0,0.html) tuna (http://vdict.com/tuna,1,0,0.html) fish (http://vdict.com/fish,1,0,0.html) sandwich (http://vdict.com/sandwich,1,0,0.html) and (http://vdict.com/and,1,0,0.html) a (http://vdict.com/a,1,0,0.html) bowl (http://vdict.com/bowl,1,0,0.html) of (http://vdict.com/of,1,0,0.html) vegetable (http://vdict.com/vegetable,1,0,0.html) soup. (http://vdict.com/soup,1,0,0.html)

## Bài học 11 Bây giờ hoặc sau?

Elizabeth (http://vdict.com/Elizabeth,1,0,0.html) | Chris, b n đang đi đâu v y? ạ ậ Chris, (http://vdict.com/Chris,1,0,0.html) where (http://vdict.com/where,1,0,0.html) are (http://vdict.com/are,1,0,0.html) you (http://vdict.com/you,1,0,0.html) going? (http://vdict.com/going,1,0,0.html)
Chris (http://vdict.com/Chris,1,0,0.html) | Tôi đi c a hàng. Tôi c n mua vài th . ử ầ ứ I'm (http://vdict.com/I'm,1,0,0.html) going (http://vdict.com/going,1,0,0.html) to (http://vdict.com/to,1,0,0.html) the (http://vdict.com/the,1,0,0.html) store. (http://vdict.com/store,1,0,0.html) I (http://vdict.com/I,1,0,0.html) need (http://vdict.com/need,1,0,0.html) to (http://vdict.com/to,1,0,0.html) buy (http://vdict.com/buy,1,0,0.html) something. (http://vdict.com/something,1,0,0.html)
Elizabeth (http://vdict.com/Elizabeth,1,0,0.html) | V y h ? Tôi cũng c n đi ra c a hàng. ậ ả ầ ử Really? (http://vdict.com/Really,1,0,0.html) I (http://vdict.com/I,1,0,0.html) need (http://vdict.com/need,1,0,0.html) to (http://vdict.com/to,1,0,0.html) go (http://vdict.com/go,1,0,0.html) to (http://vdict.com/to,1,0,0.html) the (http://vdict.com/the,1,0,0.html) store (http://vdict.com/store,1,0,0.html) too. (http://vdict.com/too,1,0,0.html)
Chris (http://vdict.com/Chris,1,0,0.html) | B n mu n đi v i tôi không? ạ ố ớ Would (http://vdict.com/Would,1,0,0.html) you (http://vdict.com/you,1,0,0.html) like (http://vdict.com/like,1,0,0.html) to (http://vdict.com/to,1,0,0.html) come (http://vdict.com/come,1,0,0.html) with (http://vdict.com/with,1,0,0.html) me? (http://vdict.com/me,1,0,0.html)

## Elizabeth (http://vdict.com/Elizabeth,1,0,0.html)

Vâng, chúng ta cùng đi.
Yeah, (http://vdict.com/Yeah,1,0,0.html) let's (http://vdict.com/let's,1,0,0.html) go (http://vdict.com/go,1,0,0.html) together. (http://vdict.com/together,1,0,0.html)
Chris (http://vdict.com/Chris,1,0,0.html) | B n mu n đi bây gi hay lát n a? ạ ố ờ ữ Would (http://vdict.com/Would,1,0,0.html) you (http://vdict.com/you,1,0,0.html) like (http://vdict.com/like,1,0,0.html) to (http://vdict.com/to,1,0,0.html) go (http://vdict.com/go,1,0,0.html) now (http://vdict.com/now,1,0,0.html) or (http://vdict.com/or,1,0,0.html) later? (http://vdict.com/later,1,0,0.html)
Elizabeth (http://vdict.com/Elizabeth,1,0,0.html) | Bây gi . ờ Now. (http://vdict.com/Now,1,0,0.html)
Chris (http://vdict.com/Chris,1,0,0.html) | Cái gì? What? (http://vdict.com/What,1,0,0.html)
Elizabeth (http://vdict.com/Elizabeth,1,0,0.html) | Bây gi thì t t h n. ờ ố ơ Now (http://vdict.com/Now,1,0,0.html) would (http://vdict.com/would,1,0,0.html) be (http://vdict.com/be,1,0,0.html) better. (http://vdict.com/better,1,0,0.html)
Chris (http://vdict.com/Chris,1,0,0.html) | Đ c, chúng ta hãy đi. ượ OK, (http://vdict.com/OK,1,0,0.html) let's (http://vdict.com/let's,1,0,0.html) go. (http://vdict.com/go,1,0,0.html)
Elizabeth (http://vdict.com/Elizabeth,1,0,0.html) | Chúng ta nên đi b không? ộ Should (http://vdict.com/Should,1,0,0.html) we (http://vdict.com/we,1,0,0.html) walk? (http://vdict.com/walk,1,0,0.html)
Chris (http://vdict.com/Chris,1,0,0.html) | Không, xa l m. Chúng ta hãy lái xe đi. ắ No, (http://vdict.com/No,1,0,0.html) it's (http://vdict.com/it's,1,0,0.html) too (http://vdict.com/too,1,0,0.html) far. (http://vdict.com/far,1,0,0.html) Let's (http://vdict.com/Let's,1,0,0.html) drive. (http://vdict.com/drive,1,0,0.html)

## Bài học 12 Bạn có đủ tiền không?

## Joe (http://vdict.com/Joe,1,0,0.html) Laura, bạn sẽ làm gì hôm nay?

Laura, (http://vdict.com/Laura,1,0,0.html) what (http://vdict.com/what,1,0,0.html) are (http://vdict.com/are,1,0,0.html) you (http://vdict.com/you,1,0,0.html) going (http://vdict.com/going,1,0,0.html) to (http://vdict.com/to,1,0,0.html) do (http://vdict.com/do,1,0,0.html)

## today? (http://vdict.com/today,1,0,0.html)

Laura (http://vdict.com/Laura,1,0,0.html) | Tôi sẽ đi mua sắm. I'm (http://vdict.com/I'm,1,0,0.html) going (http://vdict.com/going,1,0,0.html) shopping. (http://vdict.com/shopping,1,0,0.html)
Joe (http://vdict.com/Joe,1,0,0.html) | Mấy giờ bạn đi? What (http://vdict.com/What,1,0,0.html) time (http://vdict.com/time,1,0,0.html) are (http://vdict.com/are,1,0,0.html) you (http://vdict.com/you,1,0,0.html) leaving? (http://vdict.com/leaving,1,0,0.html)
Laura (http://vdict.com/Laura,1,0,0.html) | Tôi sẽ đi khoảng 4 giờ. I'm (http://vdict.com/I'm,1,0,0.html) going (http://vdict.com/going,1,0,0.html) to (http://vdict.com/to,1,0,0.html) leave (http://vdict.com/leave,1,0,0.html) around (http://vdict.com/around,1,0,0.html) 4 (http://vdict.com/4,1,0,0.html) O'clock. (http://vdict.com/O'clock,1,0,0.html)
Joe (http://vdict.com/Joe,1,0,0.html) | Bạn có thể mua cho tôi ổ bánh mì xăng uých giăm bông ở cửa hàng được không? Will (http://vdict.com/Will,1,0,0.html) you (http://vdict.com/you,1,0,0.html) buy (http://vdict.com/buy,1,0,0.html) a (http://vdict.com/a,1,0,0.html) ham (http://vdict.com/ham,1,0,0.html) sandwich (http://vdict.com/sandwich,1,0,0.html) for (http://vdict.com/for,1,0,0.html) me (http://vdict.com/me,1,0,0.html) at (http://vdict.com/at,1,0,0.html) the (http://vdict.com/the,1,0,0.html) store? (http://vdict.com/store,1,0,0.html)
Laura (http://vdict.com/Laura,1,0,0.html) | Được. OK. (http://vdict.com/OK,1,0,0.html)
Joe (http://vdict.com/Joe,1,0,0.html) | Bạn có đủ tiền không? Do (http://vdict.com/Do,1,0,0.html) you (http://vdict.com/you,1,0,0.html) have (http://vdict.com/have,1,0,0.html) enough (http://vdict.com/enough,1,0,0.html) money? (http://vdict.com/money,1,0,0.html)
Laura (http://vdict.com/Laura,1,0,0.html) | Tôi không chắc. I'm (http://vdict.com/I'm,1,0,0.html) not (http://vdict.com/not,1,0,0.html) sure. (http://vdict.com/sure,1,0,0.html)
Joe (http://vdict.com/Joe,1,0,0.html) | Bạn có bao nhiêu? How (http://vdict.com/How,1,0,0.html) much (http://vdict.com/much,1,0,0.html) do (http://vdict.com/do,1,0,0.html) you (http://vdict.com/you,1,0,0.html) have? (http://vdict.com/have,1,0,0.html)

## Laura (http://vdict.com/Laura,1,0,0.html)

## 25 đô. Bạn nghĩ rằng như vậy đủ không?

25 (http://vdict.com/25,1,0,0.html) dollars. (http://vdict.com/dollars,1,0,0.html) Do (http://vdict.com/Do,1,0,0.html) you (http://vdict.com/you,1,0,0.html) think (http://vdict.com/think,1,0,0.html) that's (http://vdict.com/that's,1,0,0.html)

## enough? (http://vdict.com/enough,1,0,0.html)

Joe (http://vdict.com/Joe,1,0,0.html) | Như vậy không nhiều lắm. That’s (http://vdict.com/That%E2%80%99s,1,0,0.html) not (http://vdict.com/not,1,0,0.html) very (http://vdict.com/very,1,0,0.html) much. (http://vdict.com/much,1,0,0.html)
Laura (http://vdict.com/Laura,1,0,0.html) | Tôi nghĩ được. Tôi cũng có 2 thẻ tín dụng. I (http://vdict.com/I,1,0,0.html) think (http://vdict.com/think,1,0,0.html) it's (http://vdict.com/it's,1,0,0.html) OK. (http://vdict.com/OK,1,0,0.html) I (http://vdict.com/I,1,0,0.html) also (http://vdict.com/also,1,0,0.html) have (http://vdict.com/have,1,0,0.html) two (http://vdict.com/two,1,0,0.html) credit (http://vdict.com/credit,1,0,0.html) cards. (http://vdict.com/cards,1,0,0.html)
Joe (http://vdict.com/Joe,1,0,0.html) | Để tôi đưa bạn thêm 10 đô. Let (http://vdict.com/Let,1,0,0.html) me (http://vdict.com/me,1,0,0.html) give (http://vdict.com/give,1,0,0.html) you (http://vdict.com/you,1,0,0.html) another (http://vdict.com/another,1,0,0.html) ten (http://vdict.com/ten,1,0,0.html) dollars. (http://vdict.com/dollars,1,0,0.html)
Laura (http://vdict.com/Laura,1,0,0.html) | Cám ơn. Gặp lại sau. Thanks. (http://vdict.com/Thanks,1,0,0.html) See (http://vdict.com/See,1,0,0.html) you (http://vdict.com/you,1,0,0.html) later. (http://vdict.com/later,1,0,0.html)
Joe (http://vdict.com/Joe,1,0,0.html) | Tạm biệt. Bye. (http://vdict.com/Bye,1,0,0.html)

## Bài học 13 Bạn đã ra sao?

Karen (http://vdict.com/Karen,1,0,0.html) | Chào Richard. Hello (http://vdict.com/Hello,1,0,0.html) Richard.
Richard (http://vdict.com/Richard,1,0,0.html) | Chào Karen. Hi (http://vdict.com/Hi,1,0,0.html) Karen.
Karen (http://vdict.com/Karen,1,0,0.html) | Bạn thế nào? How (http://vdict.com/How,1,0,0.html) have (http://vdict.com/have,1,0,0.html) you (http://vdict.com/you,1,0,0.html) been? (http://vdict.com/been,1,0,0.html)
Richard (http://vdict.com/Richard,1,0,0.html) | Không khỏe lắm. Not (http://vdict.com/Not,1,0,0.html) too (http://vdict.com/too,1,0,0.html) good. (http://vdict.com/good,1,0,0.html)
Karen (http://vdict.com/Karen,1,0,0.html) | Tại sao vậy? Why? (http://vdict.com/Why,1,0,0.html)
Richard (http://vdict.com/Richard,1,0,0.html) | Tôi bị ốm. I'm (http://vdict.com/I'm,1,0,0.html) sick. (http://vdict.com/sick,1,0,0.html)
Karen (http://vdict.com/Karen,1,0,0.html) | Rất tiếc nghe bạn ốm. Sorry (http://vdict.com/Sorry,1,0,0.html) to (http://vdict.com/to,1,0,0.html) hear (http://vdict.com/hear,1,0,0.html) that. (http://vdict.com/that,1,0,0.html)

## Richard (http://vdict.com/Richard,1,0,0.html)

## Được thôi. Không nghiêm trọng

đâu.
Its (http://vdict.com/Its,1,0,0.html) OK. (http://vdict.com/OK,1,0,0.html) Its (http://vdict.com/Its,1,0,0.html) not (http://vdict.com/not,1,0,0.html) serious. (http://vdict.com/serious,1,0,0.html)
Karen (http://vdict.com/Karen,1,0,0.html) | Tốt. Còn bà xã bạn khỏe không? That’s (http://vdict.com/That%E2%80%99s,1,0,0.html) good. (http://vdict.com/good,1,0,0.html) How's (http://vdict.com/How's,1,0,0.html) your (http://vdict.com/your,1,0,0.html) wife? (http://vdict.com/wife,1,0,0.html)
Richard (http://vdict.com/Richard,1,0,0.html) | Bà ấy khỏe. She's (http://vdict.com/She's,1,0,0.html) good. (http://vdict.com/good,1,0,0.html)
Karen (http://vdict.com/Karen,1,0,0.html) | Bây giờ bà ấy có ở Mỹ không? Is (http://vdict.com/Is,1,0,0.html) she (http://vdict.com/she,1,0,0.html) in (http://vdict.com/in,1,0,0.html) America (http://vdict.com/America,1,0,0.html) now? (http://vdict.com/now,1,0,0.html)
Richard (http://vdict.com/Richard,1,0,0.html) | Không, bà ấy chưa qua đây. No, (http://vdict.com/No,1,0,0.html) she's (http://vdict.com/she's,1,0,0.html) not (http://vdict.com/not,1,0,0.html) here (http://vdict.com/here,1,0,0.html) yet. (http://vdict.com/yet,1,0,0.html)
Karen (http://vdict.com/Karen,1,0,0.html) | Bà ấy ở đâu? Where (http://vdict.com/Where,1,0,0.html) is (http://vdict.com/is,1,0,0.html) she? (http://vdict.com/she,1,0,0.html)

## Richard (http://vdict.com/Richard,1,0,0.html)

## Bà ấy ở Canada với mấy đứa nhóc

của chúng tôi.
She's (http://vdict.com/She's,1,0,0.html) in (http://vdict.com/in,1,0,0.html) Canada (http://vdict.com/Canada,1,0,0.html) with (http://vdict.com/with,1,0,0.html) our (http://vdict.com/our,1,0,0.html) kids. (http://vdict.com/kids,1,0,0.html)
Karen (http://vdict.com/Karen,1,0,0.html) | Tôi hiểu. Tôi phải đi bây giờ. Cho tôi gửi lời chào bà xã của bạn. I (http://vdict.com/I,1,0,0.html) see. (http://vdict.com/see,1,0,0.html) I (http://vdict.com/I,1,0,0.html) have (http://vdict.com/have,1,0,0.html) to (http://vdict.com/to,1,0,0.html) go (http://vdict.com/go,1,0,0.html) now. (http://vdict.com/now,1,0,0.html) Please (http://vdict.com/Please,1,0,0.html) tell (http://vdict.com/tell,1,0,0.html) your (http://vdict.com/your,1,0,0.html) wife (http://vdict.com/wife,1,0,0.html) I (http://vdict.com/I,1,0,0.html) said (http://vdict.com/said,1,0,0.html) hi. (http://vdict.com/hi,1,0,0.html)
Richard (http://vdict.com/Richard,1,0,0.html) | Được, tôi sẽ nói chuyện với bạn
| sau. OK, (http://vdict.com/OK,1,0,0.html) I'll (http://vdict.com/I'll,1,0,0.html) talk (http://vdict.com/talk,1,0,0.html) to (http://vdict.com/to,1,0,0.html) you (http://vdict.com/you,1,0,0.html) later. (http://vdict.com/later,1,0,0.html)
Karen (http://vdict.com/Karen,1,0,0.html) | Tôi hy vọng bạn sẽ cảm thấy khỏe hơn. I (http://vdict.com/I,1,0,0.html) hope (http://vdict.com/hope,1,0,0.html) you (http://vdict.com/you,1,0,0.html) feel (http://vdict.com/feel,1,0,0.html) better. (http://vdict.com/better,1,0,0.html)

## Richard (http://vdict.com/Richard,1,0,0.html)

Cám ơn.

## Thanks. (http://vdict.com/Thanks,1,0,0.html)

Bài học 14 Giới thiệu một người bạn.

Michael (http://vdict.com/Michael,1,0,0.html) | Robert, đây là b n tôi, bà Smith. ạ Robert, (http://vdict.com/Robert,1,0,0.html) this (http://vdict.com/this,1,0,0.html) is (http://vdict.com/is,1,0,0.html) my (http://vdict.com/my,1,0,0.html) friend, (http://vdict.com/friend,1,0,0.html) Mrs. (http://vdict.com/Mrs,1,0,0.html) Smith. (http://vdict.com/Smith,1,0,0.html)
Robert (http://vdict.com/Robert,1,0,0.html) | Chào, r t vui g p b n. ấ ặ ạ Hi, (http://vdict.com/Hi,1,0,0.html) Nice (http://vdict.com/Nice,1,0,0.html) to (http://vdict.com/to,1,0,0.html) meet (http://vdict.com/meet,1,0,0.html) you. (http://vdict.com/you,1,0,0.html)
Mrs. (http://vdict.com/Mrs,1,0,0.html) Smith (http://vdict.com/Smith,1,0,0.html) | Cũng r t vui g p b n. ấ ặ ạ Nice (http://vdict.com/Nice,1,0,0.html) to (http://vdict.com/to,1,0,0.html) meet (http://vdict.com/meet,1,0,0.html) you (http://vdict.com/you,1,0,0.html) too. (http://vdict.com/too,1,0,0.html)
Robert (http://vdict.com/Robert,1,0,0.html) | Bà Smith, b n làm ngh gì? ạ ề Mrs. (http://vdict.com/Mrs,1,0,0.html) Smith, (http://vdict.com/Smith,1,0,0.html) what (http://vdict.com/what,1,0,0.html) do (http://vdict.com/do,1,0,0.html) you (http://vdict.com/you,1,0,0.html) do (http://vdict.com/do,1,0,0.html) for (http://vdict.com/for,1,0,0.html) work? (http://vdict.com/work,1,0,0.html)

## Mrs. (http://vdict.com/Mrs,1,0,0.html) Smith (http://vdict.com/Smith,1,0,0.html)

Tôi là bác sĩ.
I'm (http://vdict.com/I'm,1,0,0.html) a (http://vdict.com/a,1,0,0.html) doctor. (http://vdict.com/doctor,1,0,0.html)
Robert (http://vdict.com/Robert,1,0,0.html) | Ô, b n làm vi c đâu? ạ ệ ở Oh. (http://vdict.com/Oh,1,0,0.html) Where (http://vdict.com/Where,1,0,0.html) do (http://vdict.com/do,1,0,0.html) you (http://vdict.com/you,1,0,0.html) work? (http://vdict.com/work,1,0,0.html)
Mrs. (http://vdict.com/Mrs,1,0,0.html) Smith (http://vdict.com/Smith,1,0,0.html) | B nh vi n đ i h c New York thành ph ệ ệ ạ ọ ở ố New York. B n làm ngh gì? ạ ề New (http://vdict.com/New,1,0,0.html) York (http://vdict.com/York,1,0,0.html) University (http://vdict.com/University,1,0,0.html) hospital (http://vdict.com/hospital,1,0,0.html) in (http://vdict.com/in,1,0,0.html) New (http://vdict.com/New,1,0,0.html) York (http://vdict.com/York,1,0,0.html) City. (http://vdict.com/City,1,0,0.html) What (http://vdict.com/What,1,0,0.html) do (http://vdict.com/do,1,0,0.html) you (http://vdict.com/you,1,0,0.html) do? (http://vdict.com/do,1,0,0.html)
Robert (http://vdict.com/Robert,1,0,0.html) | Tôi là thày giáo. I'm (http://vdict.com/I'm,1,0,0.html) a (http://vdict.com/a,1,0,0.html) teacher. (http://vdict.com/teacher,1,0,0.html)
Mrs. (http://vdict.com/Mrs,1,0,0.html) Smith (http://vdict.com/Smith,1,0,0.html) | B n d y môn gì? ạ ạ What (http://vdict.com/What,1,0,0.html) do (http://vdict.com/do,1,0,0.html) you (http://vdict.com/you,1,0,0.html) teach? (http://vdict.com/teach,1,0,0.html)
Robert (http://vdict.com/Robert,1,0,0.html) | Tôi d y ti ng Anh. ạ ế I (http://vdict.com/I,1,0,0.html) teach (http://vdict.com/teach,1,0,0.html) English. (http://vdict.com/English,1,0,0.html)
Mrs. (http://vdict.com/Mrs,1,0,0.html) Smith (http://vdict.com/Smith,1,0,0.html) | Ở đâu? Where? (http://vdict.com/Where,1,0,0.html)

## Robert (http://vdict.com/Robert,1,0,0.html)

T i m t tr ng trung h c New Jersey. ạ ộ ườ | ọ ở
At (http://vdict.com/At,1,0,0.html) a (http://vdict.com/a,1,0,0.html) high (http://vdict.com/high,1,0,0.html) school (http://vdict.com/school,1,0,0.html) in (http://vdict.com/in,1,0,0.html) New (http://vdict.com/New,1,0,0.html) Jersey. (http://vdict.com/Jersey,1,0,0.html)
Mrs. (http://vdict.com/Mrs,1,0,0.html) Smith (http://vdict.com/Smith,1,0,0.html) | Th c là t t. B n bao nhiêu tu i? ự ố ạ ổ That's (http://vdict.com/That's,1,0,0.html) nice. (http://vdict.com/nice,1,0,0.html) How (http://vdict.com/How,1,0,0.html) old (http://vdict.com/old,1,0,0.html) are (http://vdict.com/are,1,0,0.html) you? (http://vdict.com/you,1,0,0.html)
Robert (http://vdict.com/Robert,1,0,0.html) | Tôi 32. I'm (http://vdict.com/I'm,1,0,0.html) 32. (http://vdict.com/32,1,0,0.html)

Bài học 15 Mua một cái áo sơ mi.

Dan (http://vdict.com/Dan,1,0,0.html) Xin l i. ỗ

## Excuse (http://vdict.com/Excuse,1,0,0.html) me. (http://vdict.com/me,1,0,0.html)

Maria (http://vdict.com/Maria,1,0,0.html) | Xin chào ông, tôi có th giúp gì ông? ể Hello (http://vdict.com/Hello,1,0,0.html) sir, (http://vdict.com/sir,1,0,0.html) may (http://vdict.com/may,1,0,0.html) I (http://vdict.com/I,1,0,0.html) help (http://vdict.com/help,1,0,0.html) you? (http://vdict.com/you,1,0,0.html)
Dan (http://vdict.com/Dan,1,0,0.html) | Vâng, tôi có th xem cái áo s mi trên k trên ể ơ ở ệ cùng không? Yes. (http://vdict.com/Yes,1,0,0.html) Can (http://vdict.com/Can,1,0,0.html) I (http://vdict.com/I,1,0,0.html) see (http://vdict.com/see,1,0,0.html) that (http://vdict.com/that,1,0,0.html) shirt (http://vdict.com/shirt,1,0,0.html) on (http://vdict.com/on,1,0,0.html) the (http://vdict.com/the,1,0,0.html) top (http://vdict.com/top,1,0,0.html) shelf (http://vdict.com/shelf,1,0,0.html) please? (http://vdict.com/please,1,0,0.html)
Maria (http://vdict.com/Maria,1,0,0.html) | Dĩ nhiên, nó đây. Sure. (http://vdict.com/Sure,1,0,0.html) Here (http://vdict.com/Here,1,0,0.html) it (http://vdict.com/it,1,0,0.html) is. (http://vdict.com/is,1,0,0.html)
Dan (http://vdict.com/Dan,1,0,0.html) | Nó giá bao nhiêu? How (http://vdict.com/How,1,0,0.html) much (http://vdict.com/much,1,0,0.html) does (http://vdict.com/does,1,0,0.html) it (http://vdict.com/it,1,0,0.html) cost? (http://vdict.com/cost,1,0,0.html)
Maria (http://vdict.com/Maria,1,0,0.html) | 50 đô. 50 (http://vdict.com/50,1,0,0.html) dollars. (http://vdict.com/dollars,1,0,0.html)
Dan (http://vdict.com/Dan,1,0,0.html) | 50 đô. Nh v y m c quá. ư ậ ắ 50 (http://vdict.com/50,1,0,0.html) dollars. (http://vdict.com/dollars,1,0,0.html) That's (http://vdict.com/That's,1,0,0.html) too (http://vdict.com/too,1,0,0.html) much. (http://vdict.com/much,1,0,0.html)
Maria (http://vdict.com/Maria,1,0,0.html) | Cái này thì sao? Nó gi m giá ch có 35 đô. ả ỉ How (http://vdict.com/How,1,0,0.html) about (http://vdict.com/about,1,0,0.html) this (http://vdict.com/this,1,0,0.html) one? (http://vdict.com/one,1,0,0.html) It's (http://vdict.com/It's,1,0,0.html) on (http://vdict.com/on,1,0,0.html) sale (http://vdict.com/sale,1,0,0.html) for (http://vdict.com/for,1,0,0.html) only (http://vdict.com/only,1,0,0.html) 35 (http://vdict.com/35,1,0,0.html) dollars. (http://vdict.com/dollars,1,0,0.html)

## Dan (http://vdict.com/Dan,1,0,0.html)

Tôi không thích cái đó.
I (http://vdict.com/I,1,0,0.html) don't (http://vdict.com/don't,1,0,0.html) like (http://vdict.com/like,1,0,0.html) that (http://vdict.com/that,1,0,0.html) one. (http://vdict.com/one,1,0,0.html)

## Maria (http://vdict.com/Maria,1,0,0.html)

Còn cái c nh đôi găng tay đen thì sao? Nó r t ạ | ấ
gi ng cái ông thích. ố
How (http://vdict.com/How,1,0,0.html) about (http://vdict.com/about,1,0,0.html) the (http://vdict.com/the,1,0,0.html) one (http://vdict.com/one,1,0,0.html) next (http://vdict.com/next,1,0,0.html) to (http://vdict.com/to,1,0,0.html) the (http://vdict.com/the,1,0,0.html) black (http://vdict.com/black,1,0,0.html) gloves? (http://vdict.com/gloves,1,0,0.html) It's (http://vdict.com/It's,1,0,0.html) very (http://vdict.com/very,1,0,0.html) similar (http://vdict.com/similar,1,0,0.html) to (http://vdict.com/to,1,0,0.html) the (http://vdict.com/the,1,0,0.html) one (http://vdict.com/one,1,0,0.html) you (http://vdict.com/you,1,0,0.html) like. (http://vdict.com/like,1,0,0.html)

## Dan (http://vdict.com/Dan,1,0,0.html)

Nó đ p đ y. Nó giá bao nhiêu? ẹ ấ
That’s (http://vdict.com/That%E2%80%99s,1,0,0.html) nice. (http://vdict.com/nice,1,0,0.html) How (http://vdict.com/How,1,0,0.html) much (http://vdict.com/much,1,0,0.html) is (http://vdict.com/is,1,0,0.html) it? (http://vdict.com/it,1,0,0.html)
Maria (http://vdict.com/Maria,1,0,0.html) | 30 đô. 30 (http://vdict.com/30,1,0,0.html) dollars. (http://vdict.com/dollars,1,0,0.html)
Dan (http://vdict.com/Dan,1,0,0.html) | T t l m. ố ắ That'll (http://vdict.com/That'll,1,0,0.html) be (http://vdict.com/be,1,0,0.html) fine. (http://vdict.com/fine,1,0,0.html)
Maria (http://vdict.com/Maria,1,0,0.html) | Màu này đ c không, hay ông thích màu khác? ượ Is (http://vdict.com/Is,1,0,0.html) this (http://vdict.com/this,1,0,0.html) color (http://vdict.com/color,1,0,0.html) OK, (http://vdict.com/OK,1,0,0.html) or (http://vdict.com/or,1,0,0.html) would (http://vdict.com/would,1,0,0.html) you (http://vdict.com/you,1,0,0.html) like (http://vdict.com/like,1,0,0.html) a (http://vdict.com/a,1,0,0.html) different (http://vdict.com/different,1,0,0.html) color? (http://vdict.com/color,1,0,0.html)

## Dan (http://vdict.com/Dan,1,0,0.html)

Cái màu xanh đó đ c r i. ượ ồ
That (http://vdict.com/That,1,0,0.html) blue (http://vdict.com/blue,1,0,0.html) one's (http://vdict.com/one's,1,0,0.html) fine. (http://vdict.com/fine,1,0,0.html)
Maria (http://vdict.com/Maria,1,0,0.html) | Ông còn c n thêm cái áo s mi nào gi ng nh ầ ơ ố ư v y n a không? ậ ữ Do (http://vdict.com/Do,1,0,0.html) you (http://vdict.com/you,1,0,0.html) need (http://vdict.com/need,1,0,0.html) any (http://vdict.com/any,1,0,0.html) more (http://vdict.com/more,1,0,0.html) of (http://vdict.com/of,1,0,0.html) these (http://vdict.com/these,1,0,0.html) shirts? (http://vdict.com/shirts,1,0,0.html)
Dan (http://vdict.com/Dan,1,0,0.html) | Vâng. Yes. (http://vdict.com/Yes,1,0,0.html)
Maria (http://vdict.com/Maria,1,0,0.html) | Ông mu n m y cái? ố ấ How (http://vdict.com/How,1,0,0.html) many (http://vdict.com/many,1,0,0.html) do (http://vdict.com/do,1,0,0.html) you (http://vdict.com/you,1,0,0.html) want? (http://vdict.com/want,1,0,0.html)
Dan (http://vdict.com/Dan,1,0,0.html) | Tôi s l y thêm 2 cái n a, m t cái đ và m t ẽ ấ ữ ộ ỏ ộ cái tr ng. ắ I'll (http://vdict.com/I'll,1,0,0.html) take (http://vdict.com/take,1,0,0.html) two (http://vdict.com/two,1,0,0.html) more, (http://vdict.com/more,1,0,0.html) a (http://vdict.com/a,1,0,0.html) red (http://vdict.com/red,1,0,0.html) one (http://vdict.com/one,1,0,0.html) and (http://vdict.com/and,1,0,0.html) a (http://vdict.com/a,1,0,0.html) white (http://vdict.com/white,1,0,0.html) one. (http://vdict.com/one,1,0,0.html)

Bài học 16 Hỏi địa điểm.

## Paul (http://vdict.com/Paul,1,0,0.html)

Xin l i, tôi đang tìm L Quán Holiday. B n ỗ | ữ | ạ
bi t nó đâu không? ế | ở
Excuse (http://vdict.com/Excuse,1,0,0.html) me, (http://vdict.com/me,1,0,0.html) I'm (http://vdict.com/I'm,1,0,0.html) looking (http://vdict.com/looking,1,0,0.html) for (http://vdict.com/for,1,0,0.html) the (http://vdict.com/the,1,0,0.html) Holiday (http://vdict.com/Holiday,1,0,0.html) Inn. (http://vdict.com/Inn,1,0,0.html) Do (http://vdict.com/Do,1,0,0.html) you (http://vdict.com/you,1,0,0.html) know (http://vdict.com/know,1,0,0.html) where (http://vdict.com/where,1,0,0.html) it (http://vdict.com/it,1,0,0.html) is? (http://vdict.com/is,1,0,0.html)
Nancy (http://vdict.com/Nancy,1,0,0.html) | Ch c r i. Nó d i con đ ng này phía bên ắ ồ ở ướ ườ trái. Sure. (http://vdict.com/Sure,1,0,0.html) It's (http://vdict.com/It's,1,0,0.html) down (http://vdict.com/down,1,0,0.html) this (http://vdict.com/this,1,0,0.html) street (http://vdict.com/street,1,0,0.html) on (http://vdict.com/on,1,0,0.html) the (http://vdict.com/the,1,0,0.html) left. (http://vdict.com/left,1,0,0.html)
Paul (http://vdict.com/Paul,1,0,0.html) | Nó có xa đây không? Is (http://vdict.com/Is,1,0,0.html) it (http://vdict.com/it,1,0,0.html) far (http://vdict.com/far,1,0,0.html) from (http://vdict.com/from,1,0,0.html) here? (http://vdict.com/here,1,0,0.html)
Nancy (http://vdict.com/Nancy,1,0,0.html) | Không, không xa đâu. No, (http://vdict.com/No,1,0,0.html) it's (http://vdict.com/it's,1,0,0.html) not (http://vdict.com/not,1,0,0.html) far. (http://vdict.com/far,1,0,0.html)
Paul (http://vdict.com/Paul,1,0,0.html) | Bao xa? How (http://vdict.com/How,1,0,0.html) far (http://vdict.com/far,1,0,0.html) is (http://vdict.com/is,1,0,0.html) it? (http://vdict.com/it,1,0,0.html)
Nancy (http://vdict.com/Nancy,1,0,0.html) | Kho ng m t d m r i. ả ộ ặ ưỡ About (http://vdict.com/About,1,0,0.html) a (http://vdict.com/a,1,0,0.html) mile (http://vdict.com/mile,1,0,0.html) and (http://vdict.com/and,1,0,0.html) a (http://vdict.com/a,1,0,0.html) half. (http://vdict.com/half,1,0,0.html)
Paul (http://vdict.com/Paul,1,0,0.html) | M t bao lâu đ t i đó? ấ ể ớ How (http://vdict.com/How,1,0,0.html) long (http://vdict.com/long,1,0,0.html) does (http://vdict.com/does,1,0,0.html) it (http://vdict.com/it,1,0,0.html) take (http://vdict.com/take,1,0,0.html) to (http://vdict.com/to,1,0,0.html) get (http://vdict.com/get,1,0,0.html) there? (http://vdict.com/there,1,0,0.html)
Nancy (http://vdict.com/Nancy,1,0,0.html) | Kho ng năm phút. ả 5 (http://vdict.com/5,1,0,0.html) minutes (http://vdict.com/minutes,1,0,0.html) or (http://vdict.com/or,1,0,0.html) so. (http://vdict.com/so,1,0,0.html)

## Paul (http://vdict.com/Paul,1,0,0.html)

Nó có g n đ ng xe đi n ng m không? ầ ườ | ệ | ầ
Is (http://vdict.com/Is,1,0,0.html) it (http://vdict.com/it,1,0,0.html) close (http://vdict.com/close,1,0,0.html) to (http://vdict.com/to,1,0,0.html) the (http://vdict.com/the,1,0,0.html) subway (http://vdict.com/subway,1,0,0.html) station? (http://vdict.com/station,1,0,0.html)

## Nancy (http://vdict.com/Nancy,1,0,0.html)

Vâng r t g n. Nhà ga xe đi n ng m bên c nh ấ ầ | ệ | ầ ở | ạ
khách s n. B n có th đi b t i đó. ạ | ạ | ể | ộ ớ
Yes, (http://vdict.com/Yes,1,0,0.html) it's (http://vdict.com/it's,1,0,0.html) very (http://vdict.com/very,1,0,0.html) close. (http://vdict.com/close,1,0,0.html) The (http://vdict.com/The,1,0,0.html) subway (http://vdict.com/subway,1,0,0.html) station (http://vdict.com/station,1,0,0.html) is (http://vdict.com/is,1,0,0.html) next (http://vdict.com/next,1,0,0.html) to (http://vdict.com/to,1,0,0.html) the (http://vdict.com/the,1,0,0.html) hotel. (http://vdict.com/hotel,1,0,0.html) You (http://vdict.com/You,1,0,0.html) can (http://vdict.com/can,1,0,0.html) walk (http://vdict.com/walk,1,0,0.html) there. (http://vdict.com/there,1,0,0.html)

## Paul (http://vdict.com/Paul,1,0,0.html)

Cám n r t nhi u. ơ ấ ề
Thanks (http://vdict.com/Thanks,1,0,0.html) a (http://vdict.com/a,1,0,0.html) lot. (http://vdict.com/lot,1,0,0.html)

## Bài học 17 Bạn có biết địa chỉ không?

Mark (http://vdict.com/Mark,1,0,0.html) | Xin l i. B n bi t đ ng nào đi t i khu mua ỗ ạ ế ườ ớ s m không? ắ Excuse (http://vdict.com/Excuse,1,0,0.html) me. (http://vdict.com/me,1,0,0.html) Do (http://vdict.com/Do,1,0,0.html) you (http://vdict.com/you,1,0,0.html) know (http://vdict.com/know,1,0,0.html) how (http://vdict.com/how,1,0,0.html) to (http://vdict.com/to,1,0,0.html) get (http://vdict.com/get,1,0,0.html) to (http://vdict.com/to,1,0,0.html) the (http://vdict.com/the,1,0,0.html) mall? (http://vdict.com/mall,1,0,0.html)

## Betty (http://vdict.com/Betty,1,0,0.html)

Bi t ch . Tôi t ng làm vi c đó. Đi th ng ế | ứ | ừ | ệ ở | ẳ
kho ng m t d m r i r trái ch đèn xanh đ . ả | ộ ặ ồ ẽ | ỗ | ỏ
Khu mua s m bên tay ph i. ắ ở | ả
Sure, (http://vdict.com/Sure,1,0,0.html) I (http://vdict.com/I,1,0,0.html) used (http://vdict.com/used,1,0,0.html) to (http://vdict.com/to,1,0,0.html) work (http://vdict.com/work,1,0,0.html) there. (http://vdict.com/there,1,0,0.html) Go (http://vdict.com/Go,1,0,0.html) straight (http://vdict.com/straight,1,0,0.html) for (http://vdict.com/for,1,0,0.html) about (http://vdict.com/about,1,0,0.html) a (http://vdict.com/a,1,0,0.html) mile, (http://vdict.com/mile,1,0,0.html) then (http://vdict.com/then,1,0,0.html) turn (http://vdict.com/turn,1,0,0.html) left (http://vdict.com/left,1,0,0.html) at (http://vdict.com/at,1,0,0.html) the (http://vdict.com/the,1,0,0.html) light. (http://vdict.com/light,1,0,0.html) The (http://vdict.com/The,1,0,0.html) mall (http://vdict.com/mall,1,0,0.html) will (http://vdict.com/will,1,0,0.html) be (http://vdict.com/be,1,0,0.html) on (http://vdict.com/on,1,0,0.html) the (http://vdict.com/the,1,0,0.html) right. (http://vdict.com/right,1,0,0.html)
Mark (http://vdict.com/Mark,1,0,0.html) | B n có bi t đ a ch không? ạ ế ị ỉ Do (http://vdict.com/Do,1,0,0.html) you (http://vdict.com/you,1,0,0.html) know (http://vdict.com/know,1,0,0.html) the (http://vdict.com/the,1,0,0.html) address? (http://vdict.com/address,1,0,0.html)
Betty (http://vdict.com/Betty,1,0,0.html) | Vâng, đ a ch là 541 đ ng Main. ị ỉ ườ Yes, (http://vdict.com/Yes,1,0,0.html) the (http://vdict.com/the,1,0,0.html) address (http://vdict.com/address,1,0,0.html) is (http://vdict.com/is,1,0,0.html) 541 (http://vdict.com/541,1,0,0.html) Main (http://vdict.com/Main,1,0,0.html) street. (http://vdict.com/street,1,0,0.html)
Mark (http://vdict.com/Mark,1,0,0.html) | B n có th vi t ra gi y cho tôi đ c không? ạ ể ế ấ ượ Can (http://vdict.com/Can,1,0,0.html) you (http://vdict.com/you,1,0,0.html) write (http://vdict.com/write,1,0,0.html) it (http://vdict.com/it,1,0,0.html) down (http://vdict.com/down,1,0,0.html) for (http://vdict.com/for,1,0,0.html) me (http://vdict.com/me,1,0,0.html) please? (http://vdict.com/please,1,0,0.html)
Betty (http://vdict.com/Betty,1,0,0.html) | Không thành v n đ . ấ ề No (http://vdict.com/No,1,0,0.html) problem. (http://vdict.com/problem,1,0,0.html)

## Mark (http://vdict.com/Mark,1,0,0.html)

Tôi đi theo đ i l Highland có nhanh h n ạ ộ | ơ
không?
Is (http://vdict.com/Is,1,0,0.html) it (http://vdict.com/it,1,0,0.html) faster (http://vdict.com/faster,1,0,0.html) if (http://vdict.com/if,1,0,0.html) I (http://vdict.com/I,1,0,0.html) take (http://vdict.com/take,1,0,0.html) Highland (http://vdict.com/Highland,1,0,0.html) avenue? (http://vdict.com/avenue,1,0,0.html)
Betty (http://vdict.com/Betty,1,0,0.html) | Không, l i đó lâu h n. Có nhi u đèn đ h n ố ơ ề ỏ ơ trên đ ng đó. ườ No, (http://vdict.com/No,1,0,0.html) that (http://vdict.com/that,1,0,0.html) way (http://vdict.com/way,1,0,0.html) is (http://vdict.com/is,1,0,0.html) longer. (http://vdict.com/longer,1,0,0.html) There (http://vdict.com/There,1,0,0.html) are (http://vdict.com/are,1,0,0.html) more (http://vdict.com/more,1,0,0.html) stop (http://vdict.com/stop,1,0,0.html) lights (http://vdict.com/lights,1,0,0.html) on (http://vdict.com/on,1,0,0.html) that (http://vdict.com/that,1,0,0.html) street. (http://vdict.com/street,1,0,0.html)
Mark (http://vdict.com/Mark,1,0,0.html) | Tôi nghĩ b n đúng. Cám n. ạ ơ I (http://vdict.com/I,1,0,0.html) think (http://vdict.com/think,1,0,0.html) you're (http://vdict.com/you're,1,0,0.html) right. (http://vdict.com/right,1,0,0.html) Thank (http://vdict.com/Thank,1,0,0.html) you. (http://vdict.com/you,1,0,0.html)

Bài học 18 Đi nghỉ mát ở Canada.

## George (http://vdict.com/George,1,0,0.html)

Hôm nay ngày m y? ấ
What's (http://vdict.com/What's,1,0,0.html) today's (http://vdict.com/today's,1,0,0.html) date? (http://vdict.com/date,1,0,0.html)

## Sandra (http://vdict.com/Sandra,1,0,0.html)

Mùng năm tháng b y. ả
It's (http://vdict.com/It's,1,0,0.html) July (http://vdict.com/July,1,0,0.html) 5th. (http://vdict.com/5th,1,0,0.html)

## George (http://vdict.com/George,1,0,0.html)

Khi nào b n đi ngh mát? ạ ỉ
When (http://vdict.com/When,1,0,0.html) are (http://vdict.com/are,1,0,0.html) you (http://vdict.com/you,1,0,0.html) going (http://vdict.com/going,1,0,0.html) on (http://vdict.com/on,1,0,0.html) vacation? (http://vdict.com/vacation,1,0,0.html)

## Sandra (http://vdict.com/Sandra,1,0,0.html)

Tôi s đi vào ch nh t. Chúng tôi s đi ẽ | ủ ậ | ẽ
Canada.
I'm (http://vdict.com/I'm,1,0,0.html) leaving (http://vdict.com/leaving,1,0,0.html) on (http://vdict.com/on,1,0,0.html) Sunday. (http://vdict.com/Sunday,1,0,0.html) We're (http://vdict.com/We're,1,0,0.html) going (http://vdict.com/going,1,0,0.html) to (http://vdict.com/to,1,0,0.html)

## Canada. (http://vdict.com/Canada,1,0,0.html)

## George (http://vdict.com/George,1,0,0.html)

V y h ? Ngày kia? Nh v y r t s m. ậ ả | | ư ậ ấ ớ
Really? (http://vdict.com/Really,1,0,0.html) The (http://vdict.com/The,1,0,0.html) day (http://vdict.com/day,1,0,0.html) after (http://vdict.com/after,1,0,0.html) tomorrow? (http://vdict.com/tomorrow,1,0,0.html) That's (http://vdict.com/That's,1,0,0.html) very (http://vdict.com/very,1,0,0.html)

## soon. (http://vdict.com/soon,1,0,0.html)

Sandra (http://vdict.com/Sandra,1,0,0.html) | Vâng tôi bi t. ế Yeah (http://vdict.com/Yeah,1,0,0.html) I (http://vdict.com/I,1,0,0.html) know. (http://vdict.com/know,1,0,0.html)
George (http://vdict.com/George,1,0,0.html) | B n s đó bao lâu? ạ ẽ ở How (http://vdict.com/How,1,0,0.html) long (http://vdict.com/long,1,0,0.html) are (http://vdict.com/are,1,0,0.html) you (http://vdict.com/you,1,0,0.html) going (http://vdict.com/going,1,0,0.html) to (http://vdict.com/to,1,0,0.html) stay (http://vdict.com/stay,1,0,0.html) there? (http://vdict.com/there,1,0,0.html)
Sandra (http://vdict.com/Sandra,1,0,0.html) | Kho ng 2 tu n. ả ầ About (http://vdict.com/About,1,0,0.html) 2 (http://vdict.com/2,1,0,0.html) weeks. (http://vdict.com/weeks,1,0,0.html)
George (http://vdict.com/George,1,0,0.html) | Khi nào b n tr v ? ạ ở ề When (http://vdict.com/When,1,0,0.html) are (http://vdict.com/are,1,0,0.html) you (http://vdict.com/you,1,0,0.html) coming (http://vdict.com/coming,1,0,0.html) back? (http://vdict.com/back,1,0,0.html)
Sandra (http://vdict.com/Sandra,1,0,0.html) | Tôi s tr v vào ngày 17. ẽ ở ề I'm (http://vdict.com/I'm,1,0,0.html) coming (http://vdict.com/coming,1,0,0.html) back (http://vdict.com/back,1,0,0.html) on (http://vdict.com/on,1,0,0.html) the (http://vdict.com/the,1,0,0.html) 17th. (http://vdict.com/17th,1,0,0.html)
George (http://vdict.com/George,1,0,0.html) | T t. Chúc b n có m t chuy n đi vui v . ố ạ ộ ế ẻ Alright. (http://vdict.com/Alright,1,0,0.html) Have (http://vdict.com/Have,1,0,0.html) a (http://vdict.com/a,1,0,0.html) nice (http://vdict.com/nice,1,0,0.html) trip. (http://vdict.com/trip,1,0,0.html)

## Bài học 19 Người phụ nữ đó là ai?

Donna (http://vdict.com/Donna,1,0,0.html) | Joseph, ng i ph n đó là ai v y? ườ ụ ữ ậ Joseph, (http://vdict.com/Joseph,1,0,0.html) who (http://vdict.com/who,1,0,0.html) is (http://vdict.com/is,1,0,0.html) that (http://vdict.com/that,1,0,0.html) woman? (http://vdict.com/woman,1,0,0.html)
Joseph (http://vdict.com/Joseph,1,0,0.html) | Đó là Susan. That's (http://vdict.com/That's,1,0,0.html) Susan. (http://vdict.com/Susan,1,0,0.html)
Donna (http://vdict.com/Donna,1,0,0.html) | Cô ta làm ngh gì? ề What (http://vdict.com/What,1,0,0.html) does (http://vdict.com/does,1,0,0.html) she (http://vdict.com/she,1,0,0.html) do (http://vdict.com/do,1,0,0.html) for (http://vdict.com/for,1,0,0.html) work? (http://vdict.com/work,1,0,0.html)
Joseph (http://vdict.com/Joseph,1,0,0.html) | Cô ta là lu t s . ậ ư She's (http://vdict.com/She's,1,0,0.html) a (http://vdict.com/a,1,0,0.html) lawyer. (http://vdict.com/lawyer,1,0,0.html)

## Donna (http://vdict.com/Donna,1,0,0.html)

Cô ta có ph i là ng i M không? ả | ườ | ỹ
Is (http://vdict.com/Is,1,0,0.html) she (http://vdict.com/she,1,0,0.html) American? (http://vdict.com/American,1,0,0.html)
Joseph (http://vdict.com/Joseph,1,0,0.html) | Không, nh ng cô ta nói ti ng Anh l u loát. ư ế ư No, (http://vdict.com/No,1,0,0.html) but (http://vdict.com/but,1,0,0.html) she (http://vdict.com/she,1,0,0.html) speaks (http://vdict.com/speaks,1,0,0.html) English (http://vdict.com/English,1,0,0.html) fluently. (http://vdict.com/fluently,1,0,0.html)
Donna (http://vdict.com/Donna,1,0,0.html) | Cô ta r t cao. B n có quen cô ta không? ấ ạ She's (http://vdict.com/She's,1,0,0.html) really (http://vdict.com/really,1,0,0.html) tall. (http://vdict.com/tall,1,0,0.html) Do (http://vdict.com/Do,1,0,0.html) you (http://vdict.com/you,1,0,0.html) know (http://vdict.com/know,1,0,0.html) her? (http://vdict.com/her,1,0,0.html)
Joseph (http://vdict.com/Joseph,1,0,0.html) | Có, tôi có quen cô ta. Chúng tôi là b n. ạ Yes, (http://vdict.com/Yes,1,0,0.html) I (http://vdict.com/I,1,0,0.html) know (http://vdict.com/know,1,0,0.html) her. (http://vdict.com/her,1,0,0.html) We're (http://vdict.com/We're,1,0,0.html) friends. (http://vdict.com/friends,1,0,0.html)
Donna (http://vdict.com/Donna,1,0,0.html) | Còn ng i đàn ông đ ng c nh cô ta là ai? ườ ứ ạ Who's (http://vdict.com/Who's,1,0,0.html) that (http://vdict.com/that,1,0,0.html) man (http://vdict.com/man,1,0,0.html) standing (http://vdict.com/standing,1,0,0.html) next (http://vdict.com/next,1,0,0.html) to (http://vdict.com/to,1,0,0.html) her? (http://vdict.com/her,1,0,0.html)
Joseph (http://vdict.com/Joseph,1,0,0.html) | Ng i đàn ông nào? ườ Which (http://vdict.com/Which,1,0,0.html) man? (http://vdict.com/man,1,0,0.html)

## Donna (http://vdict.com/Donna,1,0,0.html)

Ng i đàn ông th p phía bên trái cô ta. Tên ườ | ấ
anh ta là gì?
That (http://vdict.com/That,1,0,0.html) short (http://vdict.com/short,1,0,0.html) guy (http://vdict.com/guy,1,0,0.html) on (http://vdict.com/on,1,0,0.html) her (http://vdict.com/her,1,0,0.html) right. (http://vdict.com/right,1,0,0.html) What's (http://vdict.com/What's,1,0,0.html) his (http://vdict.com/his,1,0,0.html)

## name? (http://vdict.com/name,1,0,0.html) Joseph (http://vdict.com/Joseph,1,0,0.html)

Ô, đó là Matt.
Oh, (http://vdict.com/Oh,1,0,0.html) that's (http://vdict.com/that's,1,0,0.html) Matt. (http://vdict.com/Matt,1,0,0.html)

## Donna (http://vdict.com/Donna,1,0,0.html)

Anh ta th c s đ p trai. ự ự ẹ
He's (http://vdict.com/He's,1,0,0.html) really (http://vdict.com/really,1,0,0.html) good (http://vdict.com/good,1,0,0.html) looking. (http://vdict.com/looking,1,0,0.html)

## Joseph (http://vdict.com/Joseph,1,0,0.html)

Vâng.

## Yeah. (http://vdict.com/Yeah,1,0,0.html) Donna (http://vdict.com/Donna,1,0,0.html)

B n có quen anh ta không? ạ
Do (http://vdict.com/Do,1,0,0.html) you (http://vdict.com/you,1,0,0.html) know (http://vdict.com/know,1,0,0.html) him? (http://vdict.com/him,1,0,0.html)
Joseph (http://vdict.com/Joseph,1,0,0.html) | Tôi không quen anh ta, nh ng tôi nghĩ em gái ư tôi có quen. I (http://vdict.com/I,1,0,0.html) don't (http://vdict.com/don't,1,0,0.html) know (http://vdict.com/know,1,0,0.html) him, (http://vdict.com/him,1,0,0.html) but (http://vdict.com/but,1,0,0.html) I (http://vdict.com/I,1,0,0.html) think (http://vdict.com/think,1,0,0.html) my (http://vdict.com/my,1,0,0.html) sister (http://vdict.com/sister,1,0,0.html) does. (http://vdict.com/does,1,0,0.html)
Donna (http://vdict.com/Donna,1,0,0.html) | Anh ta có gia đình ch a? ư Is (http://vdict.com/Is,1,0,0.html) he (http://vdict.com/he,1,0,0.html) married? (http://vdict.com/married,1,0,0.html)
Joseph (http://vdict.com/Joseph,1,0,0.html) | Có, anh ta có gia đình. Yes, (http://vdict.com/Yes,1,0,0.html) he's (http://vdict.com/he's,1,0,0.html) married. (http://vdict.com/married,1,0,0.html)
Donna (http://vdict.com/Donna,1,0,0.html) | Bây gi tôi nh r i. Tôi đã g p anh ta tr c ờ ớ ồ ặ ướ đây. I (http://vdict.com/I,1,0,0.html) remember (http://vdict.com/remember,1,0,0.html) now. (http://vdict.com/now,1,0,0.html) I (http://vdict.com/I,1,0,0.html) met (http://vdict.com/met,1,0,0.html) him (http://vdict.com/him,1,0,0.html) before. (http://vdict.com/before,1,0,0.html)

Bài học 20 Những câu hỏi thông thường.

Carol (http://vdict.com/Carol,1,0,0.html) | Brian, b n bi t nói ti ng Anh không? ạ ế ế Brian, (http://vdict.com/Brian,1,0,0.html) do (http://vdict.com/do,1,0,0.html) you (http://vdict.com/you,1,0,0.html) know (http://vdict.com/know,1,0,0.html) how (http://vdict.com/how,1,0,0.html) to (http://vdict.com/to,1,0,0.html) speak (http://vdict.com/speak,1,0,0.html) English? (http://vdict.com/English,1,0,0.html)
Brian (http://vdict.com/Brian,1,0,0.html) | Có. Yes. (http://vdict.com/Yes,1,0,0.html)
Carol (http://vdict.com/Carol,1,0,0.html) | B n đã h c đâu? ạ ọ ở Where (http://vdict.com/Where,1,0,0.html) did (http://vdict.com/did,1,0,0.html) you (http://vdict.com/you,1,0,0.html) learn? (http://vdict.com/learn,1,0,0.html)
Brian (http://vdict.com/Brian,1,0,0.html) | Tôi h c đ i h c. ọ ở ạ ọ I (http://vdict.com/I,1,0,0.html) learned (http://vdict.com/learned,1,0,0.html) in (http://vdict.com/in,1,0,0.html) college. (http://vdict.com/college,1,0,0.html)
Carol (http://vdict.com/Carol,1,0,0.html) | B n nói gi i l m. ạ ỏ ắ You (http://vdict.com/You,1,0,0.html) speak (http://vdict.com/speak,1,0,0.html) really (http://vdict.com/really,1,0,0.html) well. (http://vdict.com/well,1,0,0.html)

## Brian (http://vdict.com/Brian,1,0,0.html)

Cám n. ơ

## Thank (http://vdict.com/Thank,1,0,0.html) you. (http://vdict.com/you,1,0,0.html) Carol (http://vdict.com/Carol,1,0,0.html)

B n đã M bao lâu r i? ạ | ở ỹ | ồ
How (http://vdict.com/How,1,0,0.html) long (http://vdict.com/long,1,0,0.html) have (http://vdict.com/have,1,0,0.html) you (http://vdict.com/you,1,0,0.html) been (http://vdict.com/been,1,0,0.html) in (http://vdict.com/in,1,0,0.html) the (http://vdict.com/the,1,0,0.html) US? (http://vdict.com/US,1,0,0.html)

## Brian (http://vdict.com/Brian,1,0,0.html)

3 tu n. ầ

## 3 (http://vdict.com/3,1,0,0.html) weeks. (http://vdict.com/weeks,1,0,0.html) Carol (http://vdict.com/Carol,1,0,0.html)

V b n có đi v i b n không? ợ ạ | | ớ ạ
Is (http://vdict.com/Is,1,0,0.html) your (http://vdict.com/your,1,0,0.html) wife (http://vdict.com/wife,1,0,0.html) with (http://vdict.com/with,1,0,0.html) you? (http://vdict.com/you,1,0,0.html)

## Brian (http://vdict.com/Brian,1,0,0.html)

Có, cô y v a t i đây hôm qua. ấ ừ ớ
Yes, (http://vdict.com/Yes,1,0,0.html) she (http://vdict.com/she,1,0,0.html) just (http://vdict.com/just,1,0,0.html) got (http://vdict.com/got,1,0,0.html) here (http://vdict.com/here,1,0,0.html) yesterday. (http://vdict.com/yesterday,1,0,0.html)

## Carol (http://vdict.com/Carol,1,0,0.html)

Tr c đây b n có t i California ch a? ướ | ạ | ớ | ư
Have (http://vdict.com/Have,1,0,0.html) you (http://vdict.com/you,1,0,0.html) been (http://vdict.com/been,1,0,0.html) to (http://vdict.com/to,1,0,0.html) California (http://vdict.com/California,1,0,0.html) before? (http://vdict.com/before,1,0,0.html)
Brian (http://vdict.com/Brian,1,0,0.html) | Ch a, tôi ch a bao gi t i đó. ư ư ờ ớ No. (http://vdict.com/No,1,0,0.html) I've (http://vdict.com/I've,1,0,0.html) never (http://vdict.com/never,1,0,0.html) been (http://vdict.com/been,1,0,0.html) there. (http://vdict.com/there,1,0,0.html)
Carol (http://vdict.com/Carol,1,0,0.html) | B n đã t ng t i Las Vegas ch a? ạ ừ ớ ư Have (http://vdict.com/Have,1,0,0.html) you (http://vdict.com/you,1,0,0.html) ever (http://vdict.com/ever,1,0,0.html) been (http://vdict.com/been,1,0,0.html) to (http://vdict.com/to,1,0,0.html) Las (http://vdict.com/Las,1,0,0.html) Vegas? (http://vdict.com/Vegas,1,0,0.html)
Brian (http://vdict.com/Brian,1,0,0.html) | Có. Tôi đã t i đó m t l n khi đi công vi c. ớ ộ ầ ệ Yes. (http://vdict.com/Yes,1,0,0.html) I (http://vdict.com/I,1,0,0.html) went (http://vdict.com/went,1,0,0.html) there (http://vdict.com/there,1,0,0.html) once (http://vdict.com/once,1,0,0.html) on (http://vdict.com/on,1,0,0.html) a (http://vdict.com/a,1,0,0.html) business (http://vdict.com/business,1,0,0.html) trip. (http://vdict.com/trip,1,0,0.html)

Bài học 21 Siêu thị đã đóng cửa.

## Sharon (http://vdict.com/Sharon,1,0,0.html)

Jeff, tôi s p đi siêu th . B n mu n đi v i tôi ắ | ị ạ | ố | ớ
không?
Jeff, (http://vdict.com/Jeff,1,0,0.html) I'm (http://vdict.com/I'm,1,0,0.html) going (http://vdict.com/going,1,0,0.html) to (http://vdict.com/to,1,0,0.html) the (http://vdict.com/the,1,0,0.html) supermarket. (http://vdict.com/supermarket,1,0,0.html) Do (http://vdict.com/Do,1,0,0.html) you (http://vdict.com/you,1,0,0.html) want (http://vdict.com/want,1,0,0.html) to (http://vdict.com/to,1,0,0.html) come (http://vdict.com/come,1,0,0.html) with (http://vdict.com/with,1,0,0.html) me? (http://vdict.com/me,1,0,0.html)

## Jeff (http://vdict.com/Jeff,1,0,0.html)

Tôi nghĩ gi này siêu th đóng c a r i. ờ | ị | ử ồ
I (http://vdict.com/I,1,0,0.html) think (http://vdict.com/think,1,0,0.html) the (http://vdict.com/the,1,0,0.html) supermarket (http://vdict.com/supermarket,1,0,0.html) is (http://vdict.com/is,1,0,0.html) closed (http://vdict.com/closed,1,0,0.html) now. (http://vdict.com/now,1,0,0.html)

## Sharon (http://vdict.com/Sharon,1,0,0.html)

Ô. Nó đóng c a lúc m y gi ? ử | ấ | ờ
Oh, (http://vdict.com/Oh,1,0,0.html) When (http://vdict.com/When,1,0,0.html) does (http://vdict.com/does,1,0,0.html) it (http://vdict.com/it,1,0,0.html) close? (http://vdict.com/close,1,0,0.html)

## Jeff (http://vdict.com/Jeff,1,0,0.html)

Nó đóng c a lúc 7 gi vào ch nh t ử | ờ | ủ ậ
It (http://vdict.com/It,1,0,0.html) closes (http://vdict.com/closes,1,0,0.html) at (http://vdict.com/at,1,0,0.html) 7:00 (http://vdict.com/700,1,0,0.html) on (http://vdict.com/on,1,0,0.html) Sundays. (http://vdict.com/Sundays,1,0,0.html)

## Sharon (http://vdict.com/Sharon,1,0,0.html)

T quá. ệ
That's (http://vdict.com/That's,1,0,0.html) too (http://vdict.com/too,1,0,0.html) bad. (http://vdict.com/bad,1,0,0.html)

## Jeff (http://vdict.com/Jeff,1,0,0.html)

Đ ng lo, chúng ta có th đi vào sáng mai. Nó ừ | ể
m c a lúc 8 gi . ở ử | ờ
Don't (http://vdict.com/Don't,1,0,0.html) worry, (http://vdict.com/worry,1,0,0.html) we (http://vdict.com/we,1,0,0.html) can (http://vdict.com/can,1,0,0.html) go (http://vdict.com/go,1,0,0.html) tomorrow (http://vdict.com/tomorrow,1,0,0.html) morning. (http://vdict.com/morning,1,0,0.html) It (http://vdict.com/It,1,0,0.html) opens (http://vdict.com/opens,1,0,0.html) at (http://vdict.com/at,1,0,0.html) 8:00. (http://vdict.com/800,1,0,0.html)

## Sharon (http://vdict.com/Sharon,1,0,0.html)

Thôi đ c. Bây gi b n mu n làm gì? ượ | ờ ạ | ố
Alright. (http://vdict.com/Alright,1,0,0.html) What (http://vdict.com/What,1,0,0.html) do (http://vdict.com/do,1,0,0.html) you (http://vdict.com/you,1,0,0.html) want (http://vdict.com/want,1,0,0.html) to (http://vdict.com/to,1,0,0.html) do (http://vdict.com/do,1,0,0.html) now? (http://vdict.com/now,1,0,0.html)

## Jeff (http://vdict.com/Jeff,1,0,0.html)

Chúng ta hãy đi d o n a ti ng. Em gái tôi s ạ ử ế | ẽ
t i đây kho ng 8:30 t i và r i t t c chúng ta ớ | ả | ố | ồ ấ ả
có th đi ra ngoài ăn t i. ể | ố
Lets (http://vdict.com/Lets,1,0,0.html) take (http://vdict.com/take,1,0,0.html) a (http://vdict.com/a,1,0,0.html) walk (http://vdict.com/walk,1,0,0.html) for (http://vdict.com/for,1,0,0.html) a (http://vdict.com/a,1,0,0.html) half (http://vdict.com/half,1,0,0.html) an (http://vdict.com/an,1,0,0.html) hour. (http://vdict.com/hour,1,0,0.html) My (http://vdict.com/My,1,0,0.html) sister (http://vdict.com/sister,1,0,0.html) will (http://vdict.com/will,1,0,0.html) get (http://vdict.com/get,1,0,0.html) here (http://vdict.com/here,1,0,0.html) at (http://vdict.com/at,1,0,0.html) about (http://vdict.com/about,1,0,0.html) 8:30PM (http://vdict.com/830PM,1,0,0.html) and (http://vdict.com/and,1,0,0.html) then (http://vdict.com/then,1,0,0.html) we (http://vdict.com/we,1,0,0.html) can (http://vdict.com/can,1,0,0.html) all (http://vdict.com/all,1,0,0.html) go (http://vdict.com/go,1,0,0.html) out (http://vdict.com/out,1,0,0.html) to (http://vdict.com/to,1,0,0.html) dinner. (http://vdict.com/dinner,1,0,0.html)
Sharon (http://vdict.com/Sharon,1,0,0.html) | Cô ta s ng đâu? ố ở Where (http://vdict.com/Where,1,0,0.html) does (http://vdict.com/does,1,0,0.html) she (http://vdict.com/she,1,0,0.html) live? (http://vdict.com/live,1,0,0.html)

## Jeff (http://vdict.com/Jeff,1,0,0.html)

Cô ta s ng San Francisco. ố ở
She (http://vdict.com/She,1,0,0.html) lives (http://vdict.com/lives,1,0,0.html) in (http://vdict.com/in,1,0,0.html) San (http://vdict.com/San,1,0,0.html) Francisco. (http://vdict.com/Francisco,1,0,0.html)

## Sharon (http://vdict.com/Sharon,1,0,0.html)

Cô ta đã s ng đó bao lâu r i? ố ở | ồ
How (http://vdict.com/How,1,0,0.html) long (http://vdict.com/long,1,0,0.html) has (http://vdict.com/has,1,0,0.html) she (http://vdict.com/she,1,0,0.html) lived (http://vdict.com/lived,1,0,0.html) there? (http://vdict.com/there,1,0,0.html)

## Jeff (http://vdict.com/Jeff,1,0,0.html)

Tôi nghĩ cô ta đã s ng đó kho ng 10 năm. ố ở ả
I (http://vdict.com/I,1,0,0.html) think (http://vdict.com/think,1,0,0.html) she's (http://vdict.com/she's,1,0,0.html) lived (http://vdict.com/lived,1,0,0.html) there (http://vdict.com/there,1,0,0.html) for (http://vdict.com/for,1,0,0.html) about (http://vdict.com/about,1,0,0.html) 10 (http://vdict.com/10,1,0,0.html) years. (http://vdict.com/years,1,0,0.html)

## Sharon (http://vdict.com/Sharon,1,0,0.html)

Đó là m t quãng th i gian dài. Tr c đó cô ta ộ | ờ | ướ
s ng đâu? ố ở
That's (http://vdict.com/That's,1,0,0.html) a (http://vdict.com/a,1,0,0.html) long (http://vdict.com/long,1,0,0.html) time. (http://vdict.com/time,1,0,0.html) Where (http://vdict.com/Where,1,0,0.html) did (http://vdict.com/did,1,0,0.html) she (http://vdict.com/she,1,0,0.html) live (http://vdict.com/live,1,0,0.html) before (http://vdict.com/before,1,0,0.html)

## that? (http://vdict.com/that,1,0,0.html) Jeff (http://vdict.com/Jeff,1,0,0.html)

San Diego.

## San (http://vdict.com/San,1,0,0.html) Diego. (http://vdict.com/Diego,1,0,0.html)

## Bài học 22 Bạn có con không?

Michelle (http://vdict.com/Michelle,1,0,0.html) | Charles, b n có con không? ạ Charles, (http://vdict.com/Charles,1,0,0.html) do (http://vdict.com/do,1,0,0.html) you (http://vdict.com/you,1,0,0.html) have (http://vdict.com/have,1,0,0.html) any (http://vdict.com/any,1,0,0.html) children? (http://vdict.com/children,1,0,0.html)
Charles (http://vdict.com/Charles,1,0,0.html) | Có. Yes. (http://vdict.com/Yes,1,0,0.html)
Michelle (http://vdict.com/Michelle,1,0,0.html) | B n có m y đ a con? ạ ấ ứ How (http://vdict.com/How,1,0,0.html) many (http://vdict.com/many,1,0,0.html) children (http://vdict.com/children,1,0,0.html) do (http://vdict.com/do,1,0,0.html) you (http://vdict.com/you,1,0,0.html) have? (http://vdict.com/have,1,0,0.html)

## Charles (http://vdict.com/Charles,1,0,0.html)

Tôi có hai đ a. M t trai m t gái. ứ | ộ | ộ
I (http://vdict.com/I,1,0,0.html) have (http://vdict.com/have,1,0,0.html) two (http://vdict.com/two,1,0,0.html) kids. (http://vdict.com/kids,1,0,0.html) A (http://vdict.com/A,1,0,0.html) boy (http://vdict.com/boy,1,0,0.html) and (http://vdict.com/and,1,0,0.html) a (http://vdict.com/a,1,0,0.html) girl. (http://vdict.com/girl,1,0,0.html)

## Michelle (http://vdict.com/Michelle,1,0,0.html)

Tên chúng nó là gì?
What (http://vdict.com/What,1,0,0.html) are (http://vdict.com/are,1,0,0.html) their (http://vdict.com/their,1,0,0.html) names? (http://vdict.com/names,1,0,0.html)

## Charles (http://vdict.com/Charles,1,0,0.html)

Jack và Stephanie.
Jack (http://vdict.com/Jack,1,0,0.html) and (http://vdict.com/and,1,0,0.html) Stephanie. (http://vdict.com/Stephanie,1,0,0.html)

## Michelle (http://vdict.com/Michelle,1,0,0.html)

Chúng nó m y tu i? ấ ổ
How (http://vdict.com/How,1,0,0.html) old (http://vdict.com/old,1,0,0.html) are (http://vdict.com/are,1,0,0.html) they? (http://vdict.com/they,1,0,0.html)

## Charles (http://vdict.com/Charles,1,0,0.html)

Stephanie 18 và Jack 24.
Stephanie (http://vdict.com/Stephanie,1,0,0.html) is (http://vdict.com/is,1,0,0.html) 18 (http://vdict.com/18,1,0,0.html) and (http://vdict.com/and,1,0,0.html) Jack (http://vdict.com/Jack,1,0,0.html) is (http://vdict.com/is,1,0,0.html) 24. (http://vdict.com/24,1,0,0.html)

## Michelle (http://vdict.com/Michelle,1,0,0.html)

Chúng nó còn đi h c không? ọ
Are (http://vdict.com/Are,1,0,0.html) they (http://vdict.com/they,1,0,0.html) in (http://vdict.com/in,1,0,0.html) school? (http://vdict.com/school,1,0,0.html)

## Charles (http://vdict.com/Charles,1,0,0.html)

Stephanie còn đi h c. Cô ta đi h c đ i h c ọ | ọ ạ ọ ở
Washington và Jack làm vi c Florida. ệ ở
Stephanie (http://vdict.com/Stephanie,1,0,0.html) is. (http://vdict.com/is,1,0,0.html) She (http://vdict.com/She,1,0,0.html) goes (http://vdict.com/goes,1,0,0.html) to (http://vdict.com/to,1,0,0.html) college (http://vdict.com/college,1,0,0.html) in (http://vdict.com/in,1,0,0.html) Washington (http://vdict.com/Washington,1,0,0.html) and (http://vdict.com/and,1,0,0.html) Jack (http://vdict.com/Jack,1,0,0.html) works (http://vdict.com/works,1,0,0.html) in (http://vdict.com/in,1,0,0.html) Florida. (http://vdict.com/Florida,1,0,0.html)

## Michelle (http://vdict.com/Michelle,1,0,0.html)

Stephanie h c gì? ọ
What (http://vdict.com/What,1,0,0.html) does (http://vdict.com/does,1,0,0.html) Stephanie (http://vdict.com/Stephanie,1,0,0.html) study? (http://vdict.com/study,1,0,0.html)

## Charles (http://vdict.com/Charles,1,0,0.html)

Cô ta h c ti ng Anh. ọ ế
She (http://vdict.com/She,1,0,0.html) studies (http://vdict.com/studies,1,0,0.html) English. (http://vdict.com/English,1,0,0.html)
Michelle (http://vdict.com/Michelle,1,0,0.html) | Bây gi cô ta có đây không? ờ Is (http://vdict.com/Is,1,0,0.html) she (http://vdict.com/she,1,0,0.html) here (http://vdict.com/here,1,0,0.html) now? (http://vdict.com/now,1,0,0.html)
Charles (http://vdict.com/Charles,1,0,0.html) | Không, cô ta đang tr ng. ở ườ No, (http://vdict.com/No,1,0,0.html) she's (http://vdict.com/she's,1,0,0.html) at (http://vdict.com/at,1,0,0.html) school. (http://vdict.com/school,1,0,0.html)

Bài học 23 Giúp phát âm.

## Kim (http://vdict.com/Kim,1,0,0.html)

William, b n có thích h c ti ng Anh không? ạ | ọ ế
William, (http://vdict.com/William,1,0,0.html) do (http://vdict.com/do,1,0,0.html) you (http://vdict.com/you,1,0,0.html) like (http://vdict.com/like,1,0,0.html) studying (http://vdict.com/studying,1,0,0.html) English? (http://vdict.com/English,1,0,0.html)

## William (http://vdict.com/William,1,0,0.html)

Tôi thích h c ti ng Anh, và tôi có th đ c khá, ọ ế | ể ọ
nh ng nói có th khó khăn. ư | | ể
I (http://vdict.com/I,1,0,0.html) like (http://vdict.com/like,1,0,0.html) studying (http://vdict.com/studying,1,0,0.html) English, (http://vdict.com/English,1,0,0.html) and (http://vdict.com/and,1,0,0.html) I (http://vdict.com/I,1,0,0.html) can (http://vdict.com/can,1,0,0.html) read (http://vdict.com/read,1,0,0.html) well, (http://vdict.com/well,1,0,0.html) but (http://vdict.com/but,1,0,0.html) speaking (http://vdict.com/speaking,1,0,0.html) can (http://vdict.com/can,1,0,0.html) be (http://vdict.com/be,1,0,0.html) difficult. (http://vdict.com/difficult,1,0,0.html)

## Kim (http://vdict.com/Kim,1,0,0.html)

Không t nh v y đâu. N u b n nói chuy n ệ ư ậ | ế ạ | ệ
v i nh ng ng i b n M c a b n m i ngày, ớ | ữ | ườ ạ | ỹ ủ ạ | ỗ
b n s h c nhanh. ạ ẽ ọ
It's (http://vdict.com/It's,1,0,0.html) not (http://vdict.com/not,1,0,0.html) that (http://vdict.com/that,1,0,0.html) bad. (http://vdict.com/bad,1,0,0.html) If (http://vdict.com/If,1,0,0.html) you (http://vdict.com/you,1,0,0.html) talk (http://vdict.com/talk,1,0,0.html) to (http://vdict.com/to,1,0,0.html) your (http://vdict.com/your,1,0,0.html) American (http://vdict.com/American,1,0,0.html) friends (http://vdict.com/friends,1,0,0.html) every (http://vdict.com/every,1,0,0.html) day, (http://vdict.com/day,1,0,0.html) you'll (http://vdict.com/you'll,1,0,0.html) learn (http://vdict.com/learn,1,0,0.html) quickly. (http://vdict.com/quickly,1,0,0.html)
William (http://vdict.com/William,1,0,0.html) | Tôi có th h i b n m t câu h i đ c không? ể ỏ ạ ộ ỏ ượ Can (http://vdict.com/Can,1,0,0.html) I (http://vdict.com/I,1,0,0.html) ask (http://vdict.com/ask,1,0,0.html) you (http://vdict.com/you,1,0,0.html) a (http://vdict.com/a,1,0,0.html) question? (http://vdict.com/question,1,0,0.html)
Kim (http://vdict.com/Kim,1,0,0.html) | Dĩ nhiên, b n mu n bi t đi u gì? ạ ố ế ề Sure, (http://vdict.com/Sure,1,0,0.html) what (http://vdict.com/what,1,0,0.html) do (http://vdict.com/do,1,0,0.html) you (http://vdict.com/you,1,0,0.html) want (http://vdict.com/want,1,0,0.html) to (http://vdict.com/to,1,0,0.html) know? (http://vdict.com/know,1,0,0.html)
William (http://vdict.com/William,1,0,0.html) | Tôi có quy n sách h c trong l p đây. B n ể ọ ớ ở ạ phát âm ch này nh th nào? ữ ư ế I (http://vdict.com/I,1,0,0.html) have (http://vdict.com/have,1,0,0.html) my (http://vdict.com/my,1,0,0.html) book (http://vdict.com/book,1,0,0.html) from (http://vdict.com/from,1,0,0.html) class (http://vdict.com/class,1,0,0.html) here. (http://vdict.com/here,1,0,0.html) How (http://vdict.com/How,1,0,0.html) do (http://vdict.com/do,1,0,0.html) you (http://vdict.com/you,1,0,0.html) say (http://vdict.com/say,1,0,0.html) this (http://vdict.com/this,1,0,0.html) word? (http://vdict.com/word,1,0,0.html)
Kim (http://vdict.com/Kim,1,0,0.html) | "Laptop" Laptop (http://vdict.com/Laptop,1,0,0.html)
William (http://vdict.com/William,1,0,0.html) | R t ti c, tôi không hi u. Nh v y có nghĩa gì? ấ ế ể ư ậ Sorry, (http://vdict.com/Sorry,1,0,0.html) I (http://vdict.com/I,1,0,0.html) don't (http://vdict.com/don't,1,0,0.html) understand. (http://vdict.com/understand,1,0,0.html) What (http://vdict.com/What,1,0,0.html) does (http://vdict.com/does,1,0,0.html) that (http://vdict.com/that,1,0,0.html) mean? (http://vdict.com/mean,1,0,0.html)

## Kim (http://vdict.com/Kim,1,0,0.html)

Laptop là m t lo i máy tính b n có th mang ộ ạ | ạ | ể
theo cùng v i b n. B n hi u không? ớ ạ | ạ | ể
A (http://vdict.com/A,1,0,0.html) laptop (http://vdict.com/laptop,1,0,0.html) is (http://vdict.com/is,1,0,0.html) a (http://vdict.com/a,1,0,0.html) type (http://vdict.com/type,1,0,0.html) of (http://vdict.com/of,1,0,0.html) computer (http://vdict.com/computer,1,0,0.html) that (http://vdict.com/that,1,0,0.html) you (http://vdict.com/you,1,0,0.html) can (http://vdict.com/can,1,0,0.html) carry (http://vdict.com/carry,1,0,0.html) with (http://vdict.com/with,1,0,0.html) you. (http://vdict.com/you,1,0,0.html) Do (http://vdict.com/Do,1,0,0.html) you (http://vdict.com/you,1,0,0.html) understand? (http://vdict.com/understand,1,0,0.html)

## William (http://vdict.com/William,1,0,0.html)

Vâng, tôi nghĩ v y. B n có th phát âm l i l n ậ | ạ | ể | ạ ầ
n a đ c không? ữ ượ
Yes, (http://vdict.com/Yes,1,0,0.html) I (http://vdict.com/I,1,0,0.html) think (http://vdict.com/think,1,0,0.html) so. (http://vdict.com/so,1,0,0.html) Can (http://vdict.com/Can,1,0,0.html) you (http://vdict.com/you,1,0,0.html) say (http://vdict.com/say,1,0,0.html) it (http://vdict.com/it,1,0,0.html) again? (http://vdict.com/again,1,0,0.html)
Kim (http://vdict.com/Kim,1,0,0.html) | Laptop Laptop. (http://vdict.com/Laptop,1,0,0.html)
William (http://vdict.com/William,1,0,0.html) | Laptop. Tôi phát âm nh v y có đúng không? ư ậ Laptop. (http://vdict.com/Laptop,1,0,0.html) Did (http://vdict.com/Did,1,0,0.html) I (http://vdict.com/I,1,0,0.html) pronounce (http://vdict.com/pronounce,1,0,0.html) that (http://vdict.com/that,1,0,0.html) correctly? (http://vdict.com/correctly,1,0,0.html)
Kim (http://vdict.com/Kim,1,0,0.html) | Đúng r i. T t l m. ồ ố ắ Yes, (http://vdict.com/Yes,1,0,0.html) that’s (http://vdict.com/that%E2%80%99s,1,0,0.html) right. (http://vdict.com/right,1,0,0.html) That's (http://vdict.com/That's,1,0,0.html) very (http://vdict.com/very,1,0,0.html) good. (http://vdict.com/good,1,0,0.html)
William (http://vdict.com/William,1,0,0.html) | Cám n. Còn ch này. B n phát âm ch này ơ ữ ạ ữ nh th nào? ư ế Thanks. (http://vdict.com/Thanks,1,0,0.html) And (http://vdict.com/And,1,0,0.html) this (http://vdict.com/this,1,0,0.html) word? (http://vdict.com/word,1,0,0.html) How (http://vdict.com/How,1,0,0.html) do (http://vdict.com/do,1,0,0.html) you (http://vdict.com/you,1,0,0.html) pronounce (http://vdict.com/pronounce,1,0,0.html) this? (http://vdict.com/this,1,0,0.html)
Kim (http://vdict.com/Kim,1,0,0.html) | Ch đó phát âm là "kitchen" ữ That (http://vdict.com/That,1,0,0.html) word (http://vdict.com/word,1,0,0.html) is (http://vdict.com/is,1,0,0.html) pronounced (http://vdict.com/pronounced,1,0,0.html) kitchen. (http://vdict.com/kitchen,1,0,0.html)
William (http://vdict.com/William,1,0,0.html) | Cám n r t nhi u. B n th c là m t thày giáo ơ ấ ề ạ ự ộ gi i. ỏ Thanks (http://vdict.com/Thanks,1,0,0.html) so (http://vdict.com/so,1,0,0.html) much. (http://vdict.com/much,1,0,0.html) You're (http://vdict.com/You're,1,0,0.html) a (http://vdict.com/a,1,0,0.html) good (http://vdict.com/good,1,0,0.html) teacher. (http://vdict.com/teacher,1,0,0.html)
Kim (http://vdict.com/Kim,1,0,0.html) | Cám n. ơ Thanks. (http://vdict.com/Thanks,1,0,0.html)

Bài học 24 Tôi bị mất ví.

## Steve (http://vdict.com/Steve,1,0,0.html)

Hê. M i vi c th nào? ọ ệ ế
Hey, (http://vdict.com/Hey,1,0,0.html) How's (http://vdict.com/How's,1,0,0.html) it (http://vdict.com/it,1,0,0.html) going? (http://vdict.com/going,1,0,0.html)

## Jessica (http://vdict.com/Jessica,1,0,0.html)

Không t t. Tôi m t ví r i. ố | ấ | ồ
Not (http://vdict.com/Not,1,0,0.html) good. (http://vdict.com/good,1,0,0.html) I (http://vdict.com/I,1,0,0.html) lost (http://vdict.com/lost,1,0,0.html) my (http://vdict.com/my,1,0,0.html) wallet. (http://vdict.com/wallet,1,0,0.html)

## Steve (http://vdict.com/Steve,1,0,0.html)

Ô, t quá. Nó b đánh c p h ? ệ | ị | ắ ả
Oh, (http://vdict.com/Oh,1,0,0.html) that’s (http://vdict.com/that%E2%80%99s,1,0,0.html) too (http://vdict.com/too,1,0,0.html) bad. (http://vdict.com/bad,1,0,0.html) Was (http://vdict.com/Was,1,0,0.html) it (http://vdict.com/it,1,0,0.html) stolen? (http://vdict.com/stolen,1,0,0.html)

## Jessica (http://vdict.com/Jessica,1,0,0.html)

Không, tôi nghĩ nó b r i ra kh i túi khi tôi ị ơ | ỏ
ng i trong t c xi. ồ | ắ
No, (http://vdict.com/No,1,0,0.html) I (http://vdict.com/I,1,0,0.html) think (http://vdict.com/think,1,0,0.html) it (http://vdict.com/it,1,0,0.html) came (http://vdict.com/came,1,0,0.html) out (http://vdict.com/out,1,0,0.html) of (http://vdict.com/of,1,0,0.html) my (http://vdict.com/my,1,0,0.html) pocket (http://vdict.com/pocket,1,0,0.html) when (http://vdict.com/when,1,0,0.html) I (http://vdict.com/I,1,0,0.html) was (http://vdict.com/was,1,0,0.html) in (http://vdict.com/in,1,0,0.html) the (http://vdict.com/the,1,0,0.html) taxi. (http://vdict.com/taxi,1,0,0.html)
Steve (http://vdict.com/Steve,1,0,0.html) | Tôi có th làm đi u gì không? ể ề Is (http://vdict.com/Is,1,0,0.html) there (http://vdict.com/there,1,0,0.html) anything (http://vdict.com/anything,1,0,0.html) I (http://vdict.com/I,1,0,0.html) can (http://vdict.com/can,1,0,0.html) do? (http://vdict.com/do,1,0,0.html)
Jessica (http://vdict.com/Jessica,1,0,0.html) | Tôi có th m n m t ít ti n đ c không? ể ượ ộ ề ượ Can (http://vdict.com/Can,1,0,0.html) I (http://vdict.com/I,1,0,0.html) borrow (http://vdict.com/borrow,1,0,0.html) some (http://vdict.com/some,1,0,0.html) money? (http://vdict.com/money,1,0,0.html)
Steve (http://vdict.com/Steve,1,0,0.html) | Dĩ nhiên. B n c n bao nhiêu? ạ ầ Sure, (http://vdict.com/Sure,1,0,0.html) how (http://vdict.com/how,1,0,0.html) much (http://vdict.com/much,1,0,0.html) do (http://vdict.com/do,1,0,0.html) you (http://vdict.com/you,1,0,0.html) need? (http://vdict.com/need,1,0,0.html)
Jessica (http://vdict.com/Jessica,1,0,0.html) | Kho ng 50 đô. ả About (http://vdict.com/About,1,0,0.html) 50 (http://vdict.com/50,1,0,0.html) dollars. (http://vdict.com/dollars,1,0,0.html)
Steve (http://vdict.com/Steve,1,0,0.html) | Không có v n đ gì? ấ ề That’s (http://vdict.com/That%E2%80%99s,1,0,0.html) no (http://vdict.com/no,1,0,0.html) problem. (http://vdict.com/problem,1,0,0.html)

## Jessica (http://vdict.com/Jessica,1,0,0.html)

Cám n. Tôi s tr l i b n vào th sáu. ơ | ẽ ả ạ ạ | | ứ
Thanks. (http://vdict.com/Thanks,1,0,0.html) I'll (http://vdict.com/I'll,1,0,0.html) pay (http://vdict.com/pay,1,0,0.html) you (http://vdict.com/you,1,0,0.html) back (http://vdict.com/back,1,0,0.html) on (http://vdict.com/on,1,0,0.html) Friday. (http://vdict.com/Friday,1,0,0.html)

## Steve (http://vdict.com/Steve,1,0,0.html)

Nh v y t t r i. Ti n đây. ư ậ ố ồ ề
That'll (http://vdict.com/That'll,1,0,0.html) be (http://vdict.com/be,1,0,0.html) fine. (http://vdict.com/fine,1,0,0.html) Here (http://vdict.com/Here,1,0,0.html) you (http://vdict.com/you,1,0,0.html) are. (http://vdict.com/are,1,0,0.html)

## Jessica (http://vdict.com/Jessica,1,0,0.html)

B n s làm gì bây gi . ạ ẽ | ờ
What (http://vdict.com/What,1,0,0.html) are (http://vdict.com/are,1,0,0.html) you (http://vdict.com/you,1,0,0.html) going (http://vdict.com/going,1,0,0.html) to (http://vdict.com/to,1,0,0.html) do (http://vdict.com/do,1,0,0.html) now? (http://vdict.com/now,1,0,0.html)

## Steve (http://vdict.com/Steve,1,0,0.html)

Tôi s mua vài cu n sách r i tôi s đi t i cây ẽ | ố | ồ | ẽ | ớ
xăng.
I'm (http://vdict.com/I'm,1,0,0.html) going (http://vdict.com/going,1,0,0.html) to (http://vdict.com/to,1,0,0.html) buy (http://vdict.com/buy,1,0,0.html) some (http://vdict.com/some,1,0,0.html) books (http://vdict.com/books,1,0,0.html) and (http://vdict.com/and,1,0,0.html) then (http://vdict.com/then,1,0,0.html) I'm (http://vdict.com/I'm,1,0,0.html) going (http://vdict.com/going,1,0,0.html) to (http://vdict.com/to,1,0,0.html) the (http://vdict.com/the,1,0,0.html) gas (http://vdict.com/gas,1,0,0.html) station. (http://vdict.com/station,1,0,0.html)
Jessica (http://vdict.com/Jessica,1,0,0.html) | N u b n ch m t chút tôi có th đi v i b n. ế ạ ờ ộ ể ớ ạ If (http://vdict.com/If,1,0,0.html) you (http://vdict.com/you,1,0,0.html) wait (http://vdict.com/wait,1,0,0.html) a (http://vdict.com/a,1,0,0.html) minute (http://vdict.com/minute,1,0,0.html) I (http://vdict.com/I,1,0,0.html) can (http://vdict.com/can,1,0,0.html) go (http://vdict.com/go,1,0,0.html) with (http://vdict.com/with,1,0,0.html) you. (http://vdict.com/you,1,0,0.html)
Steve (http://vdict.com/Steve,1,0,0.html) | Đ c. Tôi s ch b n. ượ ẽ ờ ạ OK. (http://vdict.com/OK,1,0,0.html) I'll (http://vdict.com/I'll,1,0,0.html) wait (http://vdict.com/wait,1,0,0.html) for (http://vdict.com/for,1,0,0.html) you. (http://vdict.com/you,1,0,0.html)

## Bài học 25 Cuộc gọi điện thoại tại nơi làm

việc.

James (http://vdict.com/James,1,0,0.html) | A lô? Hello? (http://vdict.com/Hello,1,0,0.html)
Linda (http://vdict.com/Linda,1,0,0.html) | Xin chào, James có đó không? Hi, (http://vdict.com/Hi,1,0,0.html) is (http://vdict.com/is,1,0,0.html) James (http://vdict.com/James,1,0,0.html) there (http://vdict.com/there,1,0,0.html) please? (http://vdict.com/please,1,0,0.html)
James (http://vdict.com/James,1,0,0.html) | Vâng, ai g i v y? ọ ậ Yes. (http://vdict.com/Yes,1,0,0.html) Who's (http://vdict.com/Who's,1,0,0.html) calling? (http://vdict.com/calling,1,0,0.html)

## Linda (http://vdict.com/Linda,1,0,0.html)

Linda.

## Linda. (http://vdict.com/Linda,1,0,0.html) James (http://vdict.com/James,1,0,0.html)

Xin ch m t chút. ờ ộ
One (http://vdict.com/One,1,0,0.html) moment (http://vdict.com/moment,1,0,0.html) please. (http://vdict.com/please,1,0,0.html)

## Linda (http://vdict.com/Linda,1,0,0.html)

Đ c. ượ

## OK. (http://vdict.com/OK,1,0,0.html)

James (http://vdict.com/James,1,0,0.html) | A lô? Hello? (http://vdict.com/Hello,1,0,0.html)
Linda (http://vdict.com/Linda,1,0,0.html) | Chào James, Linda đây. Hi (http://vdict.com/Hi,1,0,0.html) James, (http://vdict.com/James,1,0,0.html) it's (http://vdict.com/it's,1,0,0.html) Linda. (http://vdict.com/Linda,1,0,0.html)

## James (http://vdict.com/James,1,0,0.html)

Chào Linda.
Hi (http://vdict.com/Hi,1,0,0.html) Linda.

## Linda (http://vdict.com/Linda,1,0,0.html)

B n đang làm gì v y? ạ | ậ
What (http://vdict.com/What,1,0,0.html) are (http://vdict.com/are,1,0,0.html) you (http://vdict.com/you,1,0,0.html) doing (http://vdict.com/doing,1,0,0.html) now? (http://vdict.com/now,1,0,0.html)

## James (http://vdict.com/James,1,0,0.html)

Tôi đang làm vi c. ệ

## I'm (http://vdict.com/I'm,1,0,0.html) working. (http://vdict.com/working,1,0,0.html) Linda (http://vdict.com/Linda,1,0,0.html)

B n có b n không? ạ ậ
Are (http://vdict.com/Are,1,0,0.html) you (http://vdict.com/you,1,0,0.html) busy? (http://vdict.com/busy,1,0,0.html)
James (http://vdict.com/James,1,0,0.html) | Vâng, công vi c đây b n r n c ngày. ệ ở ậ ộ ả Yes. (http://vdict.com/Yes,1,0,0.html) It's (http://vdict.com/It's,1,0,0.html) been (http://vdict.com/been,1,0,0.html) really (http://vdict.com/really,1,0,0.html) busy (http://vdict.com/busy,1,0,0.html) here (http://vdict.com/here,1,0,0.html) all (http://vdict.com/all,1,0,0.html) day. (http://vdict.com/day,1,0,0.html)
Linda (http://vdict.com/Linda,1,0,0.html) | M y gi b n ngh làm vi c? ấ ờ ạ ỉ ệ What (http://vdict.com/What,1,0,0.html) time (http://vdict.com/time,1,0,0.html) do (http://vdict.com/do,1,0,0.html) you (http://vdict.com/you,1,0,0.html) get (http://vdict.com/get,1,0,0.html) off (http://vdict.com/off,1,0,0.html) of (http://vdict.com/of,1,0,0.html) work? (http://vdict.com/work,1,0,0.html)
James (http://vdict.com/James,1,0,0.html) | 8:30 t i. ố 8:30PM (http://vdict.com/830PM,1,0,0.html)
Linda (http://vdict.com/Linda,1,0,0.html) | Tôi s g i l i cho b n sau 8:30. ẽ ọ ạ ạ I'll (http://vdict.com/I'll,1,0,0.html) call (http://vdict.com/call,1,0,0.html) you (http://vdict.com/you,1,0,0.html) back (http://vdict.com/back,1,0,0.html) after (http://vdict.com/after,1,0,0.html) 8:30PM (http://vdict.com/830PM,1,0,0.html)
James (http://vdict.com/James,1,0,0.html) | Đ c. H n nói chuy n v i b n sau. ượ ẹ ệ ớ ạ OK. (http://vdict.com/OK,1,0,0.html) Talk (http://vdict.com/Talk,1,0,0.html) to (http://vdict.com/to,1,0,0.html) you (http://vdict.com/you,1,0,0.html) later. (http://vdict.com/later,1,0,0.html)
Linda (http://vdict.com/Linda,1,0,0.html) | Bái bai. Bye (http://vdict.com/Bye,1,0,0.html) bye. (http://vdict.com/bye,1,0,0.html)

Bài học 26 Chuyến đi của gia đình.

## Angela (http://vdict.com/Angela,1,0,0.html)

David, d o g n đây b n làm gì? ạ ầ ạ
David, (http://vdict.com/David,1,0,0.html) what (http://vdict.com/what,1,0,0.html) have (http://vdict.com/have,1,0,0.html) you (http://vdict.com/you,1,0,0.html) been (http://vdict.com/been,1,0,0.html) up (http://vdict.com/up,1,0,0.html) to (http://vdict.com/to,1,0,0.html) lately? (http://vdict.com/lately,1,0,0.html)

## David (http://vdict.com/David,1,0,0.html)

Tu n tr c tôi đi du l ch v i gia đình. ầ ướ | ị | ớ
I (http://vdict.com/I,1,0,0.html) went (http://vdict.com/went,1,0,0.html) on (http://vdict.com/on,1,0,0.html) a (http://vdict.com/a,1,0,0.html) trip (http://vdict.com/trip,1,0,0.html) with (http://vdict.com/with,1,0,0.html) my (http://vdict.com/my,1,0,0.html) family (http://vdict.com/family,1,0,0.html) last (http://vdict.com/last,1,0,0.html) week. (http://vdict.com/week,1,0,0.html)

## Angela (http://vdict.com/Angela,1,0,0.html)

V y h ? Các b n đi đâu? ậ ả ạ
Really? (http://vdict.com/Really,1,0,0.html) Where (http://vdict.com/Where,1,0,0.html) did (http://vdict.com/did,1,0,0.html) you (http://vdict.com/you,1,0,0.html) go? (http://vdict.com/go,1,0,0.html)

## David (http://vdict.com/David,1,0,0.html)

Chúng tôi đi Âu Châu.
We (http://vdict.com/We,1,0,0.html) went (http://vdict.com/went,1,0,0.html) to (http://vdict.com/to,1,0,0.html) Europe. (http://vdict.com/Europe,1,0,0.html)

## Angela (http://vdict.com/Angela,1,0,0.html)

Các b n đi thăm nh ng thành ph nào? ạ | ữ | ố
What (http://vdict.com/What,1,0,0.html) cities (http://vdict.com/cities,1,0,0.html) did (http://vdict.com/did,1,0,0.html) you (http://vdict.com/you,1,0,0.html) go (http://vdict.com/go,1,0,0.html) to? (http://vdict.com/to,1,0,0.html)

## David (http://vdict.com/David,1,0,0.html)

Luân Đôn, Pa ri và m t vài thành ph nh h n. ộ | ố ỏ ơ
London, (http://vdict.com/London,1,0,0.html) Paris (http://vdict.com/Paris,1,0,0.html) and (http://vdict.com/and,1,0,0.html) a (http://vdict.com/a,1,0,0.html) few (http://vdict.com/few,1,0,0.html) other (http://vdict.com/other,1,0,0.html) smaller (http://vdict.com/smaller,1,0,0.html) cities. (http://vdict.com/cities,1,0,0.html)

## Angela (http://vdict.com/Angela,1,0,0.html)

Các b n có đi Bá Linh không? ạ
Did (http://vdict.com/Did,1,0,0.html) you (http://vdict.com/you,1,0,0.html) go (http://vdict.com/go,1,0,0.html) to (http://vdict.com/to,1,0,0.html) Berlin? (http://vdict.com/Berlin,1,0,0.html)

## David (http://vdict.com/David,1,0,0.html)

Không, chúng tôi không đi đ n đó. Tôi mu n đi ế | ố
đ n đó l n t i. ế | ầ ớ
No, (http://vdict.com/No,1,0,0.html) We (http://vdict.com/We,1,0,0.html) didn't (http://vdict.com/didn't,1,0,0.html) go (http://vdict.com/go,1,0,0.html) there. (http://vdict.com/there,1,0,0.html) I'd (http://vdict.com/I'd,1,0,0.html) like (http://vdict.com/like,1,0,0.html) to (http://vdict.com/to,1,0,0.html) go (http://vdict.com/go,1,0,0.html) there (http://vdict.com/there,1,0,0.html)

## next (http://vdict.com/next,1,0,0.html) time. (http://vdict.com/time,1,0,0.html)

## Angela (http://vdict.com/Angela,1,0,0.html)

Tôi nghĩ mùa hè là th i đi m t t đ thăm Bá ờ ể ố ể
Linh. Đó là m t n i đ p và dân chúng r t đáng ộ ơ ẹ | ấ
yêu.
I (http://vdict.com/I,1,0,0.html) think (http://vdict.com/think,1,0,0.html) the (http://vdict.com/the,1,0,0.html) summer (http://vdict.com/summer,1,0,0.html) is (http://vdict.com/is,1,0,0.html) a (http://vdict.com/a,1,0,0.html) good (http://vdict.com/good,1,0,0.html) time (http://vdict.com/time,1,0,0.html) to (http://vdict.com/to,1,0,0.html) visit (http://vdict.com/visit,1,0,0.html) Berlin. (http://vdict.com/Berlin,1,0,0.html) It's (http://vdict.com/It's,1,0,0.html) a (http://vdict.com/a,1,0,0.html) beautiful (http://vdict.com/beautiful,1,0,0.html) place (http://vdict.com/place,1,0,0.html) and (http://vdict.com/and,1,0,0.html) the (http://vdict.com/the,1,0,0.html) people (http://vdict.com/people,1,0,0.html) there (http://vdict.com/there,1,0,0.html) are (http://vdict.com/are,1,0,0.html) very (http://vdict.com/very,1,0,0.html) nice. (http://vdict.com/nice,1,0,0.html)

## David (http://vdict.com/David,1,0,0.html)

Tôi đã nghe nh v y. ư ậ
That’s (http://vdict.com/That%E2%80%99s,1,0,0.html) what (http://vdict.com/what,1,0,0.html) I've (http://vdict.com/I've,1,0,0.html) heard. (http://vdict.com/heard,1,0,0.html)

## Angela (http://vdict.com/Angela,1,0,0.html)

Tôi đ n đó năm ngoái. N u b n mu n tôi s ế | ế ạ | ố | ẽ
cho b n m t s thông tin tôi có v thành ph . ạ | ộ ố | ề | ố
I (http://vdict.com/I,1,0,0.html) went (http://vdict.com/went,1,0,0.html) there (http://vdict.com/there,1,0,0.html) last (http://vdict.com/last,1,0,0.html) year. (http://vdict.com/year,1,0,0.html) If (http://vdict.com/If,1,0,0.html) you (http://vdict.com/you,1,0,0.html) want, (http://vdict.com/want,1,0,0.html) I (http://vdict.com/I,1,0,0.html) can (http://vdict.com/can,1,0,0.html) give (http://vdict.com/give,1,0,0.html) you (http://vdict.com/you,1,0,0.html) some (http://vdict.com/some,1,0,0.html) information (http://vdict.com/information,1,0,0.html) I (http://vdict.com/I,1,0,0.html) have (http://vdict.com/have,1,0,0.html) about (http://vdict.com/about,1,0,0.html) the (http://vdict.com/the,1,0,0.html) city. (http://vdict.com/city,1,0,0.html)

## David (http://vdict.com/David,1,0,0.html)

Cám n. ơ

## Thanks. (http://vdict.com/Thanks,1,0,0.html)

Bài học 27 Tôi đi mua sắm.

Tom (http://vdict.com/Tom,1,0,0.html) | Sarah, b n đã làm gì ngày hôm nay? ạ Sarah, (http://vdict.com/Sarah,1,0,0.html) what (http://vdict.com/what,1,0,0.html) did (http://vdict.com/did,1,0,0.html) you (http://vdict.com/you,1,0,0.html) do (http://vdict.com/do,1,0,0.html) today? (http://vdict.com/today,1,0,0.html)
Sarah (http://vdict.com/Sarah,1,0,0.html) | Tôi đi mua s m. ắ I (http://vdict.com/I,1,0,0.html) went (http://vdict.com/went,1,0,0.html) shopping. (http://vdict.com/shopping,1,0,0.html)
Tom (http://vdict.com/Tom,1,0,0.html) | B n đã mua gì không? ạ Did (http://vdict.com/Did,1,0,0.html) you (http://vdict.com/you,1,0,0.html) buy (http://vdict.com/buy,1,0,0.html) anything? (http://vdict.com/anything,1,0,0.html)
Sarah (http://vdict.com/Sarah,1,0,0.html) | Có, tôi mua m t vài món. ộ Yes, (http://vdict.com/Yes,1,0,0.html) I (http://vdict.com/I,1,0,0.html) bought (http://vdict.com/bought,1,0,0.html) a (http://vdict.com/a,1,0,0.html) few (http://vdict.com/few,1,0,0.html) things. (http://vdict.com/things,1,0,0.html)
Tom (http://vdict.com/Tom,1,0,0.html) | B n mua gì? ạ What (http://vdict.com/What,1,0,0.html) did (http://vdict.com/did,1,0,0.html) you (http://vdict.com/you,1,0,0.html) buy? (http://vdict.com/buy,1,0,0.html)
Sarah (http://vdict.com/Sarah,1,0,0.html) | Tôi mua cái áo choàng này. B n thích nó không? ạ I (http://vdict.com/I,1,0,0.html) bought (http://vdict.com/bought,1,0,0.html) this (http://vdict.com/this,1,0,0.html) coat. (http://vdict.com/coat,1,0,0.html) Do (http://vdict.com/Do,1,0,0.html) you (http://vdict.com/you,1,0,0.html) like (http://vdict.com/like,1,0,0.html) it? (http://vdict.com/it,1,0,0.html)

## Tom (http://vdict.com/Tom,1,0,0.html)

Vâng, tôi thích nó l m. Nó r t đ p. B n mua nó ắ | ấ ẹ | ạ
ở đâu?
Yeah, (http://vdict.com/Yeah,1,0,0.html) I (http://vdict.com/I,1,0,0.html) like (http://vdict.com/like,1,0,0.html) it (http://vdict.com/it,1,0,0.html) a (http://vdict.com/a,1,0,0.html) lot. (http://vdict.com/lot,1,0,0.html) It's (http://vdict.com/It's,1,0,0.html) very (http://vdict.com/very,1,0,0.html) pretty. (http://vdict.com/pretty,1,0,0.html) Where (http://vdict.com/Where,1,0,0.html) did (http://vdict.com/did,1,0,0.html) you (http://vdict.com/you,1,0,0.html) buy (http://vdict.com/buy,1,0,0.html) it? (http://vdict.com/it,1,0,0.html)

## Sarah (http://vdict.com/Sarah,1,0,0.html)

Ở | ắ | ườ | ứ khu mua s m trên đ ng th 5.
At (http://vdict.com/At,1,0,0.html) the (http://vdict.com/the,1,0,0.html) mall (http://vdict.com/mall,1,0,0.html) on (http://vdict.com/on,1,0,0.html) 5th (http://vdict.com/5th,1,0,0.html) street. (http://vdict.com/street,1,0,0.html)

## Tom (http://vdict.com/Tom,1,0,0.html)

Nó có đ t không? ắ
Was (http://vdict.com/Was,1,0,0.html) it (http://vdict.com/it,1,0,0.html) expensive? (http://vdict.com/expensive,1,0,0.html)

## Sarah (http://vdict.com/Sarah,1,0,0.html)

Không, nó không đ t. Nó gi m giá ch còn 20 ắ | ả | ỉ
đô.
No, (http://vdict.com/No,1,0,0.html) it (http://vdict.com/it,1,0,0.html) wasn't (http://vdict.com/wasn't,1,0,0.html) expensive. (http://vdict.com/expensive,1,0,0.html) It (http://vdict.com/It,1,0,0.html) was (http://vdict.com/was,1,0,0.html) on (http://vdict.com/on,1,0,0.html) sale (http://vdict.com/sale,1,0,0.html) for (http://vdict.com/for,1,0,0.html) 20 (http://vdict.com/20,1,0,0.html)

## dollars. (http://vdict.com/dollars,1,0,0.html) Tom (http://vdict.com/Tom,1,0,0.html)

R đ y. ẻ ấ

## That's (http://vdict.com/That's,1,0,0.html) cheap. (http://vdict.com/cheap,1,0,0.html)

## Sarah (http://vdict.com/Sarah,1,0,0.html)

Tôi bi t. Nó r t đáng giá. ế ấ
I (http://vdict.com/I,1,0,0.html) know. (http://vdict.com/know,1,0,0.html) It (http://vdict.com/It,1,0,0.html) was (http://vdict.com/was,1,0,0.html) a (http://vdict.com/a,1,0,0.html) really (http://vdict.com/really,1,0,0.html) good (http://vdict.com/good,1,0,0.html) deal. (http://vdict.com/deal,1,0,0.html)

## Tom (http://vdict.com/Tom,1,0,0.html)

Tôi không nghĩ là b n c n m c nó ngay đâu. ạ ầ | ặ
Tr i r t nóng d o g n đây. ờ ấ | ạ ầ
I (http://vdict.com/I,1,0,0.html) don't (http://vdict.com/don't,1,0,0.html) think (http://vdict.com/think,1,0,0.html) you'll (http://vdict.com/you'll,1,0,0.html) need (http://vdict.com/need,1,0,0.html) to (http://vdict.com/to,1,0,0.html) wear (http://vdict.com/wear,1,0,0.html) it (http://vdict.com/it,1,0,0.html) for (http://vdict.com/for,1,0,0.html) a (http://vdict.com/a,1,0,0.html) while. (http://vdict.com/while,1,0,0.html) It's (http://vdict.com/It's,1,0,0.html) been (http://vdict.com/been,1,0,0.html) really (http://vdict.com/really,1,0,0.html) hot (http://vdict.com/hot,1,0,0.html) lately. (http://vdict.com/lately,1,0,0.html)

## Bài học 28 Bạn thích loại nhạc gì?

Amy (http://vdict.com/Amy,1,0,0.html) | Paul, b n thích nghe lo i nh c nào? ạ ạ ạ Paul, (http://vdict.com/Paul,1,0,0.html) what (http://vdict.com/what,1,0,0.html) kind (http://vdict.com/kind,1,0,0.html) of (http://vdict.com/of,1,0,0.html) music (http://vdict.com/music,1,0,0.html) do (http://vdict.com/do,1,0,0.html) you (http://vdict.com/you,1,0,0.html) like (http://vdict.com/like,1,0,0.html) to (http://vdict.com/to,1,0,0.html) listen (http://vdict.com/listen,1,0,0.html) to? (http://vdict.com/to,1,0,0.html)
Paul (http://vdict.com/Paul,1,0,0.html) | M i th lo i, nh ng ph n l n là pop, r c và c ọ ể ạ ư ầ ớ ố ổ đi n. T i sao b n h i? ể ạ ạ ỏ All (http://vdict.com/All,1,0,0.html) kinds, (http://vdict.com/kinds,1,0,0.html) but (http://vdict.com/but,1,0,0.html) mostly (http://vdict.com/mostly,1,0,0.html) Pop, (http://vdict.com/Pop,1,0,0.html) rock (http://vdict.com/rock,1,0,0.html) and (http://vdict.com/and,1,0,0.html) classical. (http://vdict.com/classical,1,0,0.html) Why? (http://vdict.com/Why,1,0,0.html)
Amy (http://vdict.com/Amy,1,0,0.html) | Tôi có vé đ đi xem m t bu i trình di n. B n ể ộ ổ ễ ạ mu n đi v i tôi không? ố ớ I (http://vdict.com/I,1,0,0.html) have (http://vdict.com/have,1,0,0.html) tickets (http://vdict.com/tickets,1,0,0.html) to (http://vdict.com/to,1,0,0.html) a (http://vdict.com/a,1,0,0.html) show. (http://vdict.com/show,1,0,0.html) Do (http://vdict.com/Do,1,0,0.html) you (http://vdict.com/you,1,0,0.html) want (http://vdict.com/want,1,0,0.html) to (http://vdict.com/to,1,0,0.html) go (http://vdict.com/go,1,0,0.html) with (http://vdict.com/with,1,0,0.html) me? (http://vdict.com/me,1,0,0.html)
Paul (http://vdict.com/Paul,1,0,0.html) | Lo i nh c gì v y? ạ ạ ậ What (http://vdict.com/What,1,0,0.html) kind (http://vdict.com/kind,1,0,0.html) of (http://vdict.com/of,1,0,0.html) music (http://vdict.com/music,1,0,0.html) is (http://vdict.com/is,1,0,0.html) it? (http://vdict.com/it,1,0,0.html)
Amy (http://vdict.com/Amy,1,0,0.html) | Pop. Ca sĩ Mariah Carey. Pop. (http://vdict.com/Pop,1,0,0.html) It's (http://vdict.com/It's,1,0,0.html) Mariah (http://vdict.com/Mariah,1,0,0.html) Carey. (http://vdict.com/Carey,1,0,0.html)
Paul (http://vdict.com/Paul,1,0,0.html) | Khi nào v y? ậ When (http://vdict.com/When,1,0,0.html) is (http://vdict.com/is,1,0,0.html) it? (http://vdict.com/it,1,0,0.html)
Amy (http://vdict.com/Amy,1,0,0.html) | 8 gi t i mai. ờ ố At (http://vdict.com/At,1,0,0.html) 8PM (http://vdict.com/8PM,1,0,0.html) tomorrow (http://vdict.com/tomorrow,1,0,0.html) night. (http://vdict.com/night,1,0,0.html)
Paul (http://vdict.com/Paul,1,0,0.html) | Vâng, tôi thích đi. B n có nghĩ r ng chúng ta ạ ằ nên ăn t i tr c không? ố ướ Yeah, (http://vdict.com/Yeah,1,0,0.html) I'd (http://vdict.com/I'd,1,0,0.html) like (http://vdict.com/like,1,0,0.html) to (http://vdict.com/to,1,0,0.html) go. (http://vdict.com/go,1,0,0.html) Do (http://vdict.com/Do,1,0,0.html) you (http://vdict.com/you,1,0,0.html) think (http://vdict.com/think,1,0,0.html) we (http://vdict.com/we,1,0,0.html) should (http://vdict.com/should,1,0,0.html) have (http://vdict.com/have,1,0,0.html) dinner (http://vdict.com/dinner,1,0,0.html) first? (http://vdict.com/first,1,0,0.html)
Amy (http://vdict.com/Amy,1,0,0.html) | Vâng, đó là ý ki n hay. ế Yes, (http://vdict.com/Yes,1,0,0.html) that’s (http://vdict.com/that%E2%80%99s,1,0,0.html) a (http://vdict.com/a,1,0,0.html) good (http://vdict.com/good,1,0,0.html) idea. (http://vdict.com/idea,1,0,0.html)
Paul (http://vdict.com/Paul,1,0,0.html) | Chúng ta hãy ăn nhà hàng đ i di n v i căn h ở ố ệ ớ ộ c a tôi phía bên kia đ ng. ủ ườ Let's (http://vdict.com/Let's,1,0,0.html) eat (http://vdict.com/eat,1,0,0.html) at (http://vdict.com/at,1,0,0.html) the (http://vdict.com/the,1,0,0.html) restaurant (http://vdict.com/restaurant,1,0,0.html) across (http://vdict.com/across,1,0,0.html) the (http://vdict.com/the,1,0,0.html) street (http://vdict.com/street,1,0,0.html) from (http://vdict.com/from,1,0,0.html) my (http://vdict.com/my,1,0,0.html) apartment. (http://vdict.com/apartment,1,0,0.html)

## Amy (http://vdict.com/Amy,1,0,0.html)

Ô, tôi nghĩ tôi bi t n i b n nói r i. Chúng ta đã ế ơ ạ | ồ
ăn đó h i tháng tr c ph i không? ở | ồ | ướ | ả
Oh, (http://vdict.com/Oh,1,0,0.html) I (http://vdict.com/I,1,0,0.html) think (http://vdict.com/think,1,0,0.html) I (http://vdict.com/I,1,0,0.html) know (http://vdict.com/know,1,0,0.html) the (http://vdict.com/the,1,0,0.html) place (http://vdict.com/place,1,0,0.html) you (http://vdict.com/you,1,0,0.html) mean. (http://vdict.com/mean,1,0,0.html) We (http://vdict.com/We,1,0,0.html) ate (http://vdict.com/ate,1,0,0.html) there (http://vdict.com/there,1,0,0.html) last (http://vdict.com/last,1,0,0.html) month, (http://vdict.com/month,1,0,0.html) right? (http://vdict.com/right,1,0,0.html)

## Paul (http://vdict.com/Paul,1,0,0.html)

Đúng r i. B n có trí nh t t đó. ồ | ạ | ớ ố
Yes, (http://vdict.com/Yes,1,0,0.html) that’s (http://vdict.com/that%E2%80%99s,1,0,0.html) right. (http://vdict.com/right,1,0,0.html) You (http://vdict.com/You,1,0,0.html) have (http://vdict.com/have,1,0,0.html) a (http://vdict.com/a,1,0,0.html) good (http://vdict.com/good,1,0,0.html) memory. (http://vdict.com/memory,1,0,0.html) Bài học 29 Đi thư viện.

## Kevin (http://vdict.com/Kevin,1,0,0.html)

Lisa, b n có mu n đi th vi n v i tôi không? ạ | ố | ư ệ ớ
Lisa, (http://vdict.com/Lisa,1,0,0.html) would (http://vdict.com/would,1,0,0.html) you (http://vdict.com/you,1,0,0.html) like (http://vdict.com/like,1,0,0.html) to (http://vdict.com/to,1,0,0.html) go (http://vdict.com/go,1,0,0.html) to (http://vdict.com/to,1,0,0.html) the (http://vdict.com/the,1,0,0.html) library (http://vdict.com/library,1,0,0.html) with (http://vdict.com/with,1,0,0.html)

## me? (http://vdict.com/me,1,0,0.html)

## Lisa (http://vdict.com/Lisa,1,0,0.html)

Đ c, b n có nghĩ r ng chúng ta có th đi mua ượ | ạ | ằ | ể
m t t báo tr c không? ộ ờ | ướ
OK. (http://vdict.com/OK,1,0,0.html) Do (http://vdict.com/Do,1,0,0.html) you (http://vdict.com/you,1,0,0.html) think (http://vdict.com/think,1,0,0.html) we (http://vdict.com/we,1,0,0.html) can (http://vdict.com/can,1,0,0.html) go (http://vdict.com/go,1,0,0.html) buy (http://vdict.com/buy,1,0,0.html) a (http://vdict.com/a,1,0,0.html) newspaper (http://vdict.com/newspaper,1,0,0.html)

## first? (http://vdict.com/first,1,0,0.html)

## Kevin (http://vdict.com/Kevin,1,0,0.html)

Đ c ch . Chúng ta s đi mua báo tr c r i ượ | ứ | ẽ | ướ ồ
chúng ta đi th vi n. ư ệ
Sure. (http://vdict.com/Sure,1,0,0.html) First (http://vdict.com/First,1,0,0.html) we'll (http://vdict.com/we'll,1,0,0.html) go (http://vdict.com/go,1,0,0.html) buy (http://vdict.com/buy,1,0,0.html) a (http://vdict.com/a,1,0,0.html) newspaper (http://vdict.com/newspaper,1,0,0.html) and (http://vdict.com/and,1,0,0.html) then (http://vdict.com/then,1,0,0.html) we'll (http://vdict.com/we'll,1,0,0.html) go (http://vdict.com/go,1,0,0.html) to (http://vdict.com/to,1,0,0.html) the (http://vdict.com/the,1,0,0.html) library. (http://vdict.com/library,1,0,0.html)
Lisa (http://vdict.com/Lisa,1,0,0.html) | Chúng ta s đi b hay đi xe? ẽ ộ Are (http://vdict.com/Are,1,0,0.html) we (http://vdict.com/we,1,0,0.html) going (http://vdict.com/going,1,0,0.html) to (http://vdict.com/to,1,0,0.html) walk (http://vdict.com/walk,1,0,0.html) or (http://vdict.com/or,1,0,0.html) drive? (http://vdict.com/drive,1,0,0.html)
Kevin (http://vdict.com/Kevin,1,0,0.html) | Th i ti t hôm nay r t đ p. Chúng ta đi b đi. ờ ế ấ ẹ ộ The (http://vdict.com/The,1,0,0.html) weather (http://vdict.com/weather,1,0,0.html) is (http://vdict.com/is,1,0,0.html) really (http://vdict.com/really,1,0,0.html) nice (http://vdict.com/nice,1,0,0.html) today. (http://vdict.com/today,1,0,0.html) Let's (http://vdict.com/Let's,1,0,0.html) walk. (http://vdict.com/walk,1,0,0.html)

## Lisa (http://vdict.com/Lisa,1,0,0.html)

Th i ti t đ p ngay lúc này, nh ng tôi nghĩ tr i ờ ế ẹ | ư | ờ
có th m a chi u nay. ể ư | ề
The (http://vdict.com/The,1,0,0.html) weather (http://vdict.com/weather,1,0,0.html) is (http://vdict.com/is,1,0,0.html) good (http://vdict.com/good,1,0,0.html) now, (http://vdict.com/now,1,0,0.html) but (http://vdict.com/but,1,0,0.html) I (http://vdict.com/I,1,0,0.html) think (http://vdict.com/think,1,0,0.html) it's (http://vdict.com/it's,1,0,0.html) suppose (http://vdict.com/suppose,1,0,0.html) to (http://vdict.com/to,1,0,0.html) rain (http://vdict.com/rain,1,0,0.html) this (http://vdict.com/this,1,0,0.html) afternoon. (http://vdict.com/afternoon,1,0,0.html)
Kevin (http://vdict.com/Kevin,1,0,0.html) | Đ c thôi, v y thì chúng ta hãy mang theo dù. ượ ậ Anh c a b n có đi v i chúng ta không? ủ ạ ớ Alright, (http://vdict.com/Alright,1,0,0.html) then (http://vdict.com/then,1,0,0.html) let's (http://vdict.com/let's,1,0,0.html) take (http://vdict.com/take,1,0,0.html) an (http://vdict.com/an,1,0,0.html) umbrella. (http://vdict.com/umbrella,1,0,0.html) Is (http://vdict.com/Is,1,0,0.html) your (http://vdict.com/your,1,0,0.html) brother (http://vdict.com/brother,1,0,0.html) coming (http://vdict.com/coming,1,0,0.html) with (http://vdict.com/with,1,0,0.html) us? (http://vdict.com/us,1,0,0.html)
Lisa (http://vdict.com/Lisa,1,0,0.html) | Không, anh y còn đang ng . ấ ủ No, (http://vdict.com/No,1,0,0.html) he's (http://vdict.com/he's,1,0,0.html) still (http://vdict.com/still,1,0,0.html) sleeping. (http://vdict.com/sleeping,1,0,0.html)
Kevin (http://vdict.com/Kevin,1,0,0.html) | Ôi, 10 gi sáng r i. Ch c ch n là t i hôm qua ờ ồ ắ ắ ố anh ta đã th c khuya l m. ứ ắ Wow, (http://vdict.com/Wow,1,0,0.html) it's (http://vdict.com/it's,1,0,0.html) already (http://vdict.com/already,1,0,0.html) 10:00AM. (http://vdict.com/1000AM,1,0,0.html) He (http://vdict.com/He,1,0,0.html) must (http://vdict.com/must,1,0,0.html) have (http://vdict.com/have,1,0,0.html) been (http://vdict.com/been,1,0,0.html) up (http://vdict.com/up,1,0,0.html) late (http://vdict.com/late,1,0,0.html) last (http://vdict.com/last,1,0,0.html) night. (http://vdict.com/night,1,0,0.html)
Lisa (http://vdict.com/Lisa,1,0,0.html) | Vâng, mãi t i 12 gi đêm anh y m i v nhà. ớ ờ ấ ớ ề Yeah, (http://vdict.com/Yeah,1,0,0.html) he (http://vdict.com/he,1,0,0.html) didn't (http://vdict.com/didn't,1,0,0.html) come (http://vdict.com/come,1,0,0.html) home (http://vdict.com/home,1,0,0.html) until (http://vdict.com/until,1,0,0.html) 12:00AM. (http://vdict.com/1200AM,1,0,0.html)
Kevin (http://vdict.com/Kevin,1,0,0.html) | Tôi hy v ng anh y có th đ n sau. ọ ấ ể ế I (http://vdict.com/I,1,0,0.html) hope (http://vdict.com/hope,1,0,0.html) he (http://vdict.com/he,1,0,0.html) can (http://vdict.com/can,1,0,0.html) come (http://vdict.com/come,1,0,0.html) later. (http://vdict.com/later,1,0,0.html)
Lisa (http://vdict.com/Lisa,1,0,0.html) | Tôi cũng hy v ng v y. Tôi s g i anh y khi ọ ậ ẽ ọ ấ chúng ta t i đó. ớ I (http://vdict.com/I,1,0,0.html) hope (http://vdict.com/hope,1,0,0.html) so (http://vdict.com/so,1,0,0.html) too. (http://vdict.com/too,1,0,0.html) I'll (http://vdict.com/I'll,1,0,0.html) give (http://vdict.com/give,1,0,0.html) him (http://vdict.com/him,1,0,0.html) a (http://vdict.com/a,1,0,0.html) call (http://vdict.com/call,1,0,0.html) when (http://vdict.com/when,1,0,0.html) we (http://vdict.com/we,1,0,0.html) get (http://vdict.com/get,1,0,0.html) there. (http://vdict.com/there,1,0,0.html)
Kevin (http://vdict.com/Kevin,1,0,0.html) | T đây chúng ta đi th vi n l i nào? ừ ư ệ ố How (http://vdict.com/How,1,0,0.html) do (http://vdict.com/do,1,0,0.html) we (http://vdict.com/we,1,0,0.html) get (http://vdict.com/get,1,0,0.html) to (http://vdict.com/to,1,0,0.html) the (http://vdict.com/the,1,0,0.html) library (http://vdict.com/library,1,0,0.html) from (http://vdict.com/from,1,0,0.html) here? (http://vdict.com/here,1,0,0.html)

## Lisa (http://vdict.com/Lisa,1,0,0.html)

Đi th ng xu ng con đ ng này phía bên trái, ằ | ố | ườ
bên c nh b o tàng vi n. M t kho ng 10 phút. ạ | ả | ệ | ấ | ả
It's (http://vdict.com/It's,1,0,0.html) straight (http://vdict.com/straight,1,0,0.html) down (http://vdict.com/down,1,0,0.html) this (http://vdict.com/this,1,0,0.html) road (http://vdict.com/road,1,0,0.html) on (http://vdict.com/on,1,0,0.html) the (http://vdict.com/the,1,0,0.html) left, (http://vdict.com/left,1,0,0.html) next (http://vdict.com/next,1,0,0.html) to (http://vdict.com/to,1,0,0.html) the (http://vdict.com/the,1,0,0.html) museum. (http://vdict.com/museum,1,0,0.html) It (http://vdict.com/It,1,0,0.html) takes (http://vdict.com/takes,1,0,0.html) about (http://vdict.com/about,1,0,0.html) 10 (http://vdict.com/10,1,0,0.html) minutes. (http://vdict.com/minutes,1,0,0.html)

## Bài học 30 Bố mẹ bạn sống ở đâu?

Jason (http://vdict.com/Jason,1,0,0.html) | Chào Melissa, b n s v nhà cu i tu n này ạ ẽ ề | ố ầ
không?

| Hi (http://vdict.com/Hi,1,0,0.html) Melissa, (http://vdict.com/Melissa,1,0,0.html) are (http://vdict.com/are,1,0,0.html) you (http://vdict.com/you,1,0,0.html) going (http://vdict.com/going,1,0,0.html) home (http://vdict.com/home,1,0,0.html) this (http://vdict.com/this,1,0,0.html) weekend? (http://vdict.com/weekend,1,0,0.html)
Melissa (http://vdict.com/Melissa,1,0,0.html) | Không, cu i tu n này thì không. Tôi có nhi u ố ầ ề vi c ph i làm quá. ệ ả No, (http://vdict.com/No,1,0,0.html) not (http://vdict.com/not,1,0,0.html) this (http://vdict.com/this,1,0,0.html) weekend. (http://vdict.com/weekend,1,0,0.html) I (http://vdict.com/I,1,0,0.html) have (http://vdict.com/have,1,0,0.html) too (http://vdict.com/too,1,0,0.html) much (http://vdict.com/much,1,0,0.html) work (http://vdict.com/work,1,0,0.html) to (http://vdict.com/to,1,0,0.html) do. (http://vdict.com/do,1,0,0.html)
Jason (http://vdict.com/Jason,1,0,0.html) | B m b n s ng đâu? ố ẹ ạ ố ở Where (http://vdict.com/Where,1,0,0.html) do (http://vdict.com/do,1,0,0.html) your (http://vdict.com/your,1,0,0.html) parents (http://vdict.com/parents,1,0,0.html) live? (http://vdict.com/live,1,0,0.html)
Melissa (http://vdict.com/Melissa,1,0,0.html) | B tôi s ng Washington DC. ố ố ở My (http://vdict.com/My,1,0,0.html) father (http://vdict.com/father,1,0,0.html) lives (http://vdict.com/lives,1,0,0.html) in (http://vdict.com/in,1,0,0.html) Washington (http://vdict.com/Washington,1,0,0.html) DC. (http://vdict.com/DC,1,0,0.html)
Jason (http://vdict.com/Jason,1,0,0.html) | Còn m b n? ẹ ạ How (http://vdict.com/How,1,0,0.html) about (http://vdict.com/about,1,0,0.html) your (http://vdict.com/your,1,0,0.html) mother? (http://vdict.com/mother,1,0,0.html)
Melissa (http://vdict.com/Melissa,1,0,0.html) | M tôi m t cách đây hai năm r i. ẹ ấ ồ My (http://vdict.com/My,1,0,0.html) mother (http://vdict.com/mother,1,0,0.html) died (http://vdict.com/died,1,0,0.html) two (http://vdict.com/two,1,0,0.html) years (http://vdict.com/years,1,0,0.html) ago. (http://vdict.com/ago,1,0,0.html)
Jason (http://vdict.com/Jason,1,0,0.html) | Ô, tôi r t ti c nghe nh v y. B b n còn đi ấ ế ư ậ ố ạ làm không? Oh, (http://vdict.com/Oh,1,0,0.html) I (http://vdict.com/I,1,0,0.html) am (http://vdict.com/am,1,0,0.html) sorry (http://vdict.com/sorry,1,0,0.html) to (http://vdict.com/to,1,0,0.html) hear (http://vdict.com/hear,1,0,0.html) that. (http://vdict.com/that,1,0,0.html) Is (http://vdict.com/Is,1,0,0.html) your (http://vdict.com/your,1,0,0.html) father (http://vdict.com/father,1,0,0.html) still (http://vdict.com/still,1,0,0.html) working? (http://vdict.com/working,1,0,0.html)
Melissa (http://vdict.com/Melissa,1,0,0.html) | Không, ông y v h u r i. ấ ề ư ồ No, (http://vdict.com/No,1,0,0.html) he's (http://vdict.com/he's,1,0,0.html) retired. (http://vdict.com/retired,1,0,0.html)
Jason (http://vdict.com/Jason,1,0,0.html) | B n có h hàng đây không? ạ ọ ở Do (http://vdict.com/Do,1,0,0.html) you (http://vdict.com/you,1,0,0.html) have (http://vdict.com/have,1,0,0.html) any (http://vdict.com/any,1,0,0.html) family (http://vdict.com/family,1,0,0.html) here? (http://vdict.com/here,1,0,0.html)

## Melissa (http://vdict.com/Melissa,1,0,0.html)

Có, hai ng i trong s anh ch em h c a tôi ườ | ố | ị | ọ ủ
s ng đây và cô chú tôi s ng cách đây ố ở | ố
kho ng 30 d m. ả | ặ
Yes, (http://vdict.com/Yes,1,0,0.html) two (http://vdict.com/two,1,0,0.html) of (http://vdict.com/of,1,0,0.html) my (http://vdict.com/my,1,0,0.html) cousins (http://vdict.com/cousins,1,0,0.html) live (http://vdict.com/live,1,0,0.html) here (http://vdict.com/here,1,0,0.html) and (http://vdict.com/and,1,0,0.html) my (http://vdict.com/my,1,0,0.html) aunt (http://vdict.com/aunt,1,0,0.html) and (http://vdict.com/and,1,0,0.html) uncle (http://vdict.com/uncle,1,0,0.html) live (http://vdict.com/live,1,0,0.html) about (http://vdict.com/about,1,0,0.html) 30 (http://vdict.com/30,1,0,0.html) miles (http://vdict.com/miles,1,0,0.html) from (http://vdict.com/from,1,0,0.html)

## here. (http://vdict.com/here,1,0,0.html) Jason (http://vdict.com/Jason,1,0,0.html)

B n có anh ch em gì không? ạ | ị
Do (http://vdict.com/Do,1,0,0.html) you (http://vdict.com/you,1,0,0.html) have (http://vdict.com/have,1,0,0.html) any (http://vdict.com/any,1,0,0.html) brothers (http://vdict.com/brothers,1,0,0.html) or (http://vdict.com/or,1,0,0.html) sisters? (http://vdict.com/sisters,1,0,0.html)

## Melissa (http://vdict.com/Melissa,1,0,0.html)

Có, tôi có 2 ng i anh (em) s ng New York ườ | ố ở
và m t ng i ch (em gái) s ng Boston. ộ | ườ | ị | ố ở
Yes, (http://vdict.com/Yes,1,0,0.html) I (http://vdict.com/I,1,0,0.html) have (http://vdict.com/have,1,0,0.html) two (http://vdict.com/two,1,0,0.html) brothers (http://vdict.com/brothers,1,0,0.html) who (http://vdict.com/who,1,0,0.html) live (http://vdict.com/live,1,0,0.html) in (http://vdict.com/in,1,0,0.html) New (http://vdict.com/New,1,0,0.html) York (http://vdict.com/York,1,0,0.html) and (http://vdict.com/and,1,0,0.html) a (http://vdict.com/a,1,0,0.html) sister (http://vdict.com/sister,1,0,0.html) who (http://vdict.com/who,1,0,0.html) lives (http://vdict.com/lives,1,0,0.html) in (http://vdict.com/in,1,0,0.html) Boston. (http://vdict.com/Boston,1,0,0.html)

## Jason (http://vdict.com/Jason,1,0,0.html)

B n có th ng g p h không? ạ | ườ | ặ ọ
Do (http://vdict.com/Do,1,0,0.html) you (http://vdict.com/you,1,0,0.html) see (http://vdict.com/see,1,0,0.html) them (http://vdict.com/them,1,0,0.html) a (http://vdict.com/a,1,0,0.html) lot? (http://vdict.com/lot,1,0,0.html)

## Melissa (http://vdict.com/Melissa,1,0,0.html)

Không đ c nhi u nh tôi mu n.Th ng ch ượ | ề | ư | ố | ườ | ỉ
vào nh ng ngày ngh nh L T | n và Giáng ữ | ỉ ư ễ ạ Ơ
Sinh.
Not (http://vdict.com/Not,1,0,0.html) as (http://vdict.com/as,1,0,0.html) much (http://vdict.com/much,1,0,0.html) as (http://vdict.com/as,1,0,0.html) I'd (http://vdict.com/I'd,1,0,0.html) like (http://vdict.com/like,1,0,0.html) to. (http://vdict.com/to,1,0,0.html) Usually (http://vdict.com/Usually,1,0,0.html) just (http://vdict.com/just,1,0,0.html) on (http://vdict.com/on,1,0,0.html) holidays (http://vdict.com/holidays,1,0,0.html) like (http://vdict.com/like,1,0,0.html) Thanksgiving (http://vdict.com/Thanksgiving,1,0,0.html) and (http://vdict.com/and,1,0,0.html) Christmas. (http://vdict.com/Christmas,1,0,0.html)
