Cinthanh1998/Du-an-Foxconn/GRR-LX0959165825I.pdf

## 上海赫立智能机器有限公司

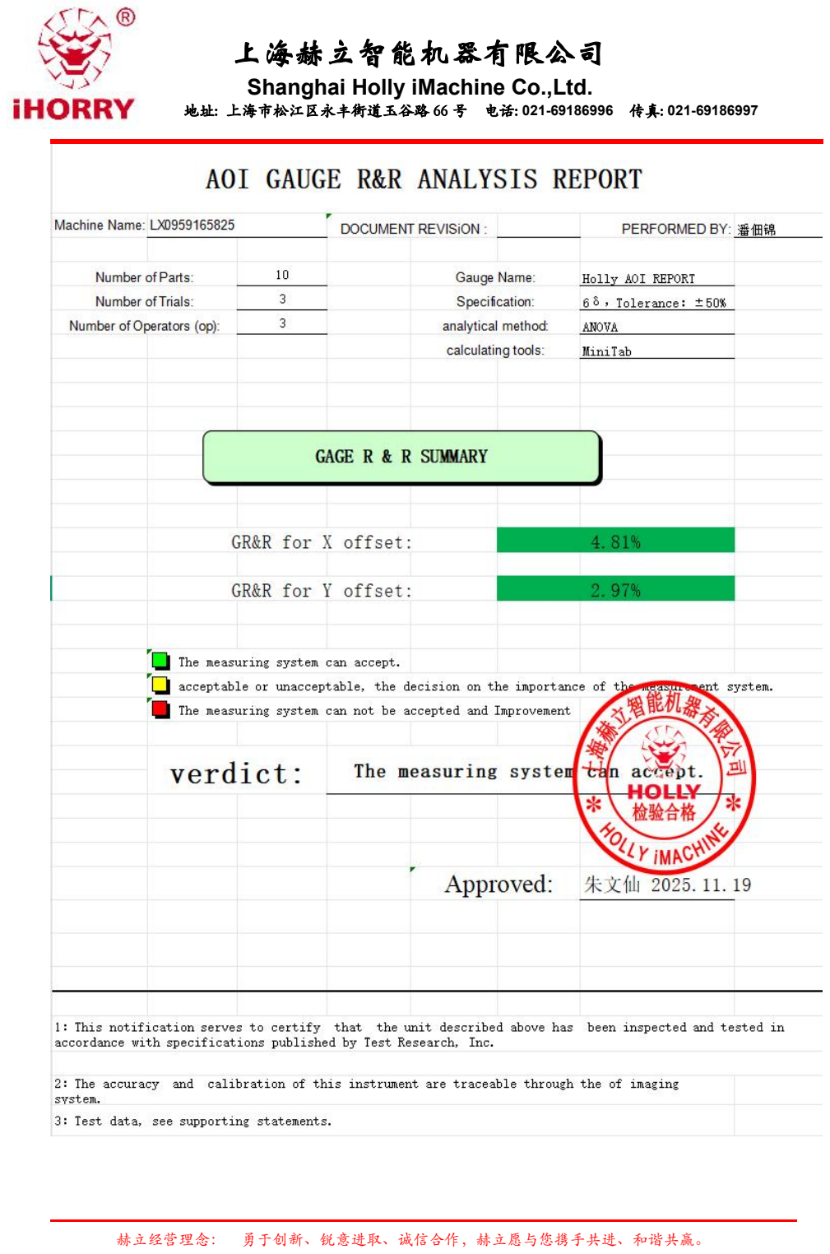
[picture p211: page 1]

Shanghai Holly iMachine Co.,Ltd. 地址: 上海市松江区永丰街道玉谷路 66 号 电话: 021-69186996 传真: 021-69186997

赫立经营理念： 勇于创新、锐意进取、诚信合作，赫立愿与您携手共进、和谐共赢。

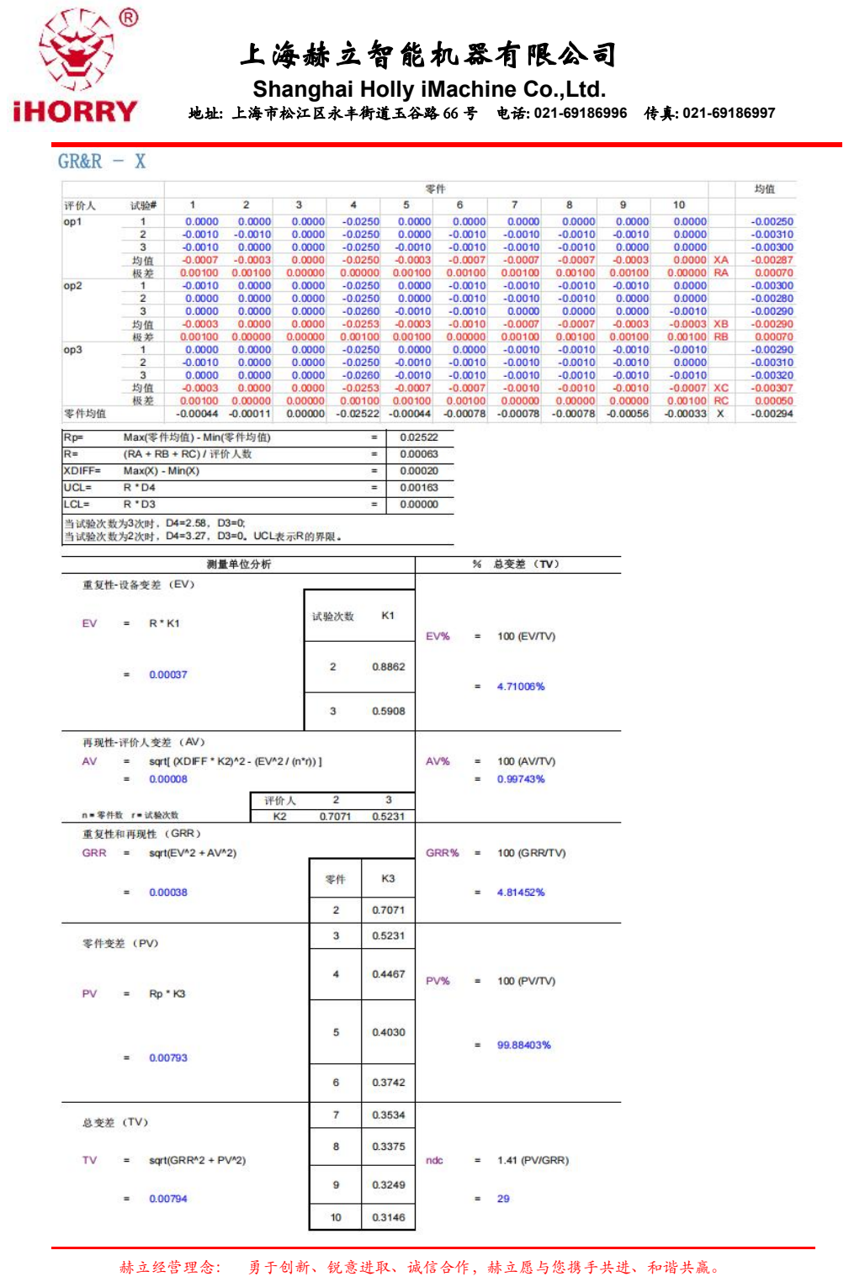
[picture p212: page 2]

Shanghai Holly iMachine Co.,Ltd. 地址: 上海市松江区永丰街道玉谷路 66 号 电话: 021-69186996 传真: 021-69186997

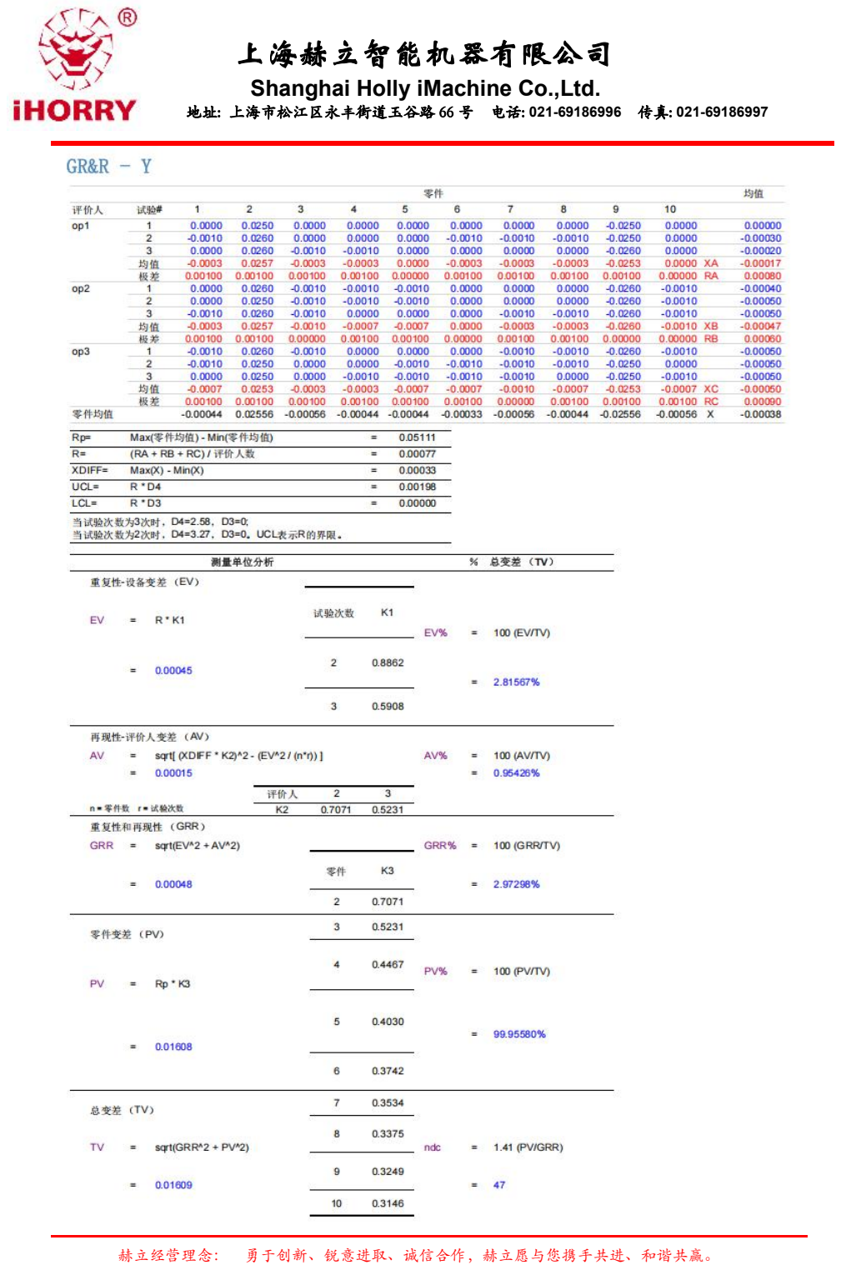
[picture p213: page 3]

Shanghai Holly iMachine Co.,Ltd. 地址: 上海市松江区永丰街道玉谷路 66 号 电话: 021-69186996 传真: 021-69186997
