Cinthanh1998/Du-an-Foxconn/FB_IMG_1772777492808.jpg

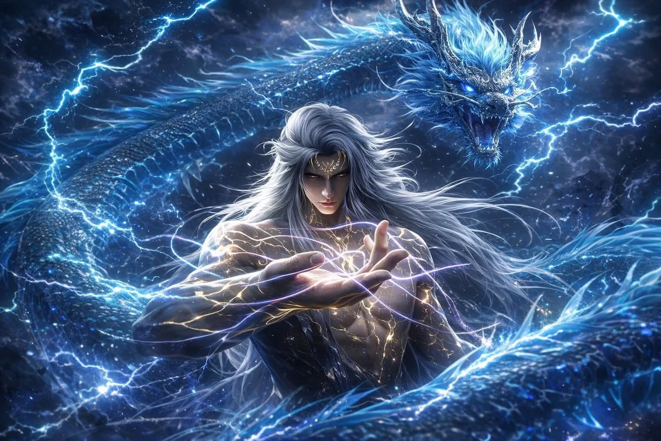
FB_IMG_1772777492808.jpg
