Cinthanh1998/Du-an-Foxconn/FB_IMG_1773026478077.jpg

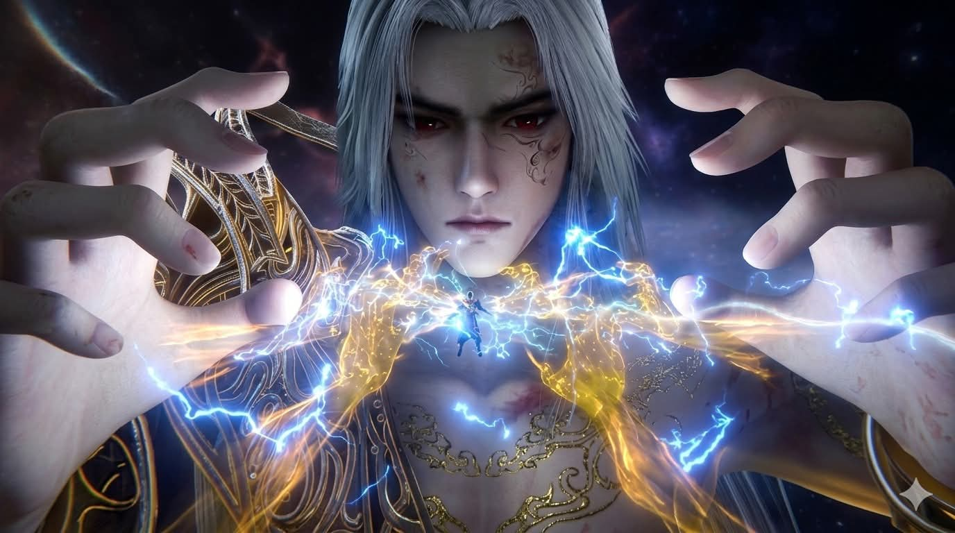
FB_IMG_1773026478077.jpg
