Cinthanh1998/Du-an-Foxconn/IMG_20251107_084648.jpg

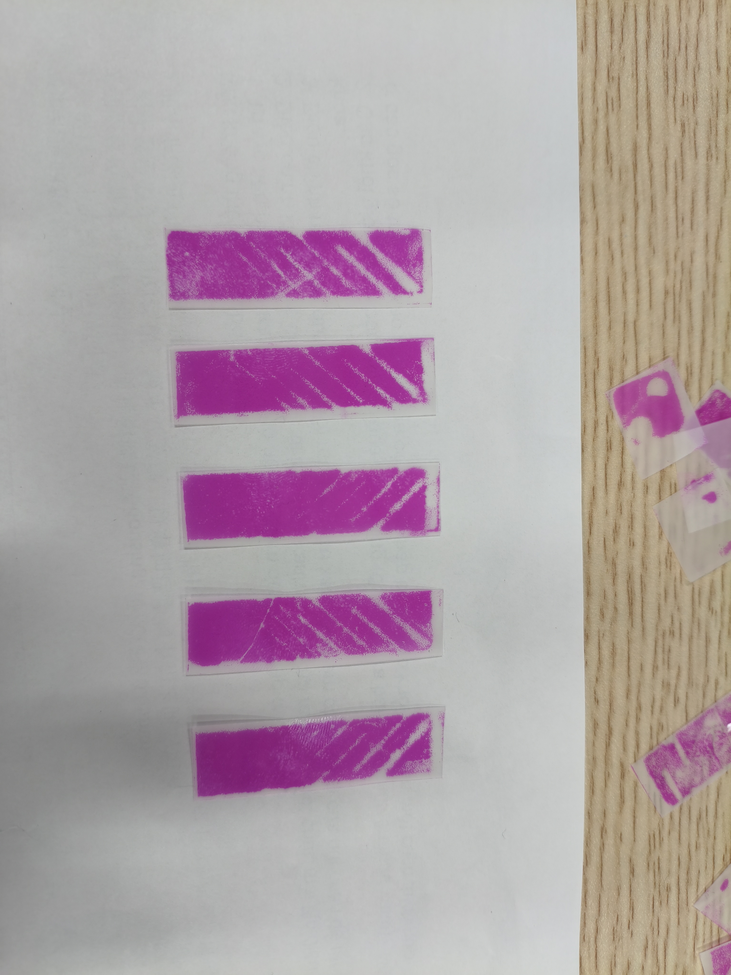
IMG_20251107_084648.jpg
