Cinthanh1998/Du-an-Foxconn/IMG_20251107_084933.jpg

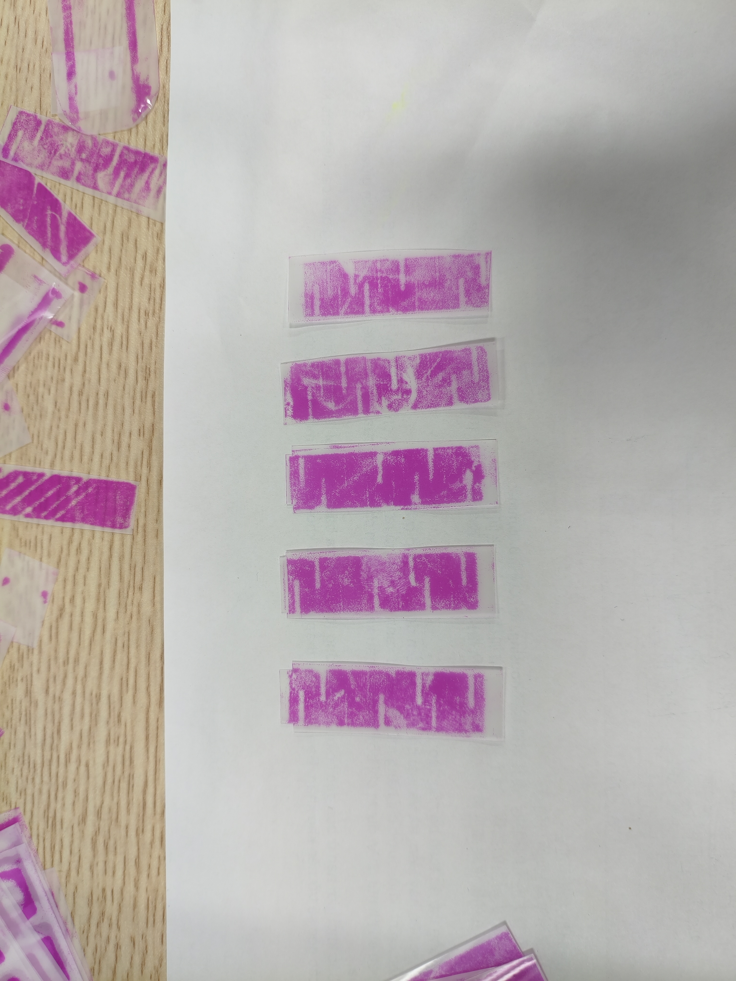
IMG_20251107_084933.jpg
