Cinthanh1998/Du-an-Foxconn/IMG_20251107_085649.jpg

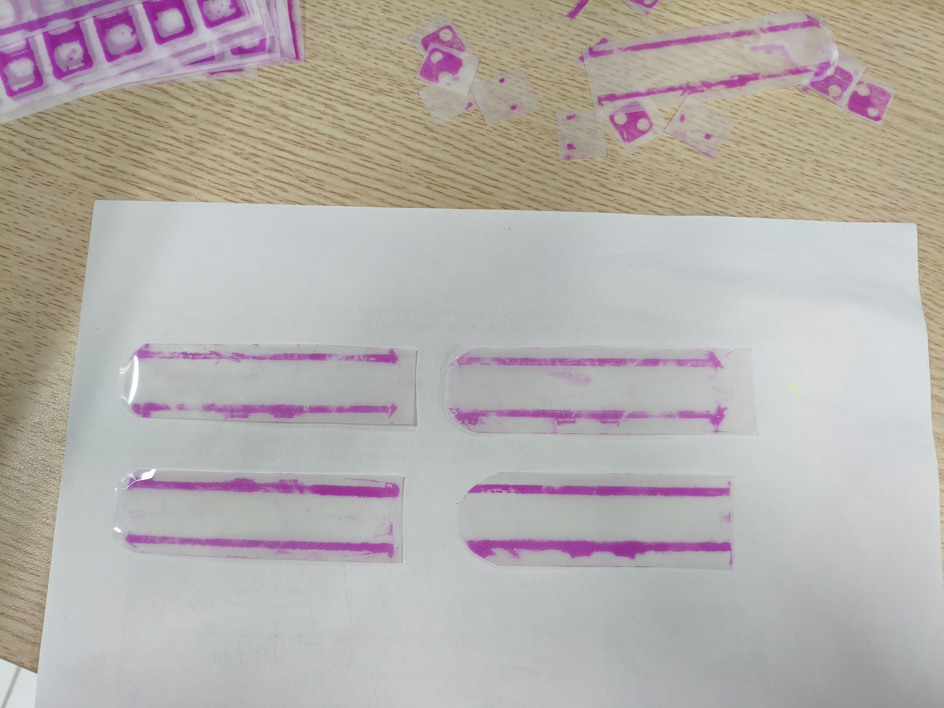
IMG_20251107_085649.jpg
