Cinthanh1998/Du-an-Foxconn/IMG_20251107_085923.jpg

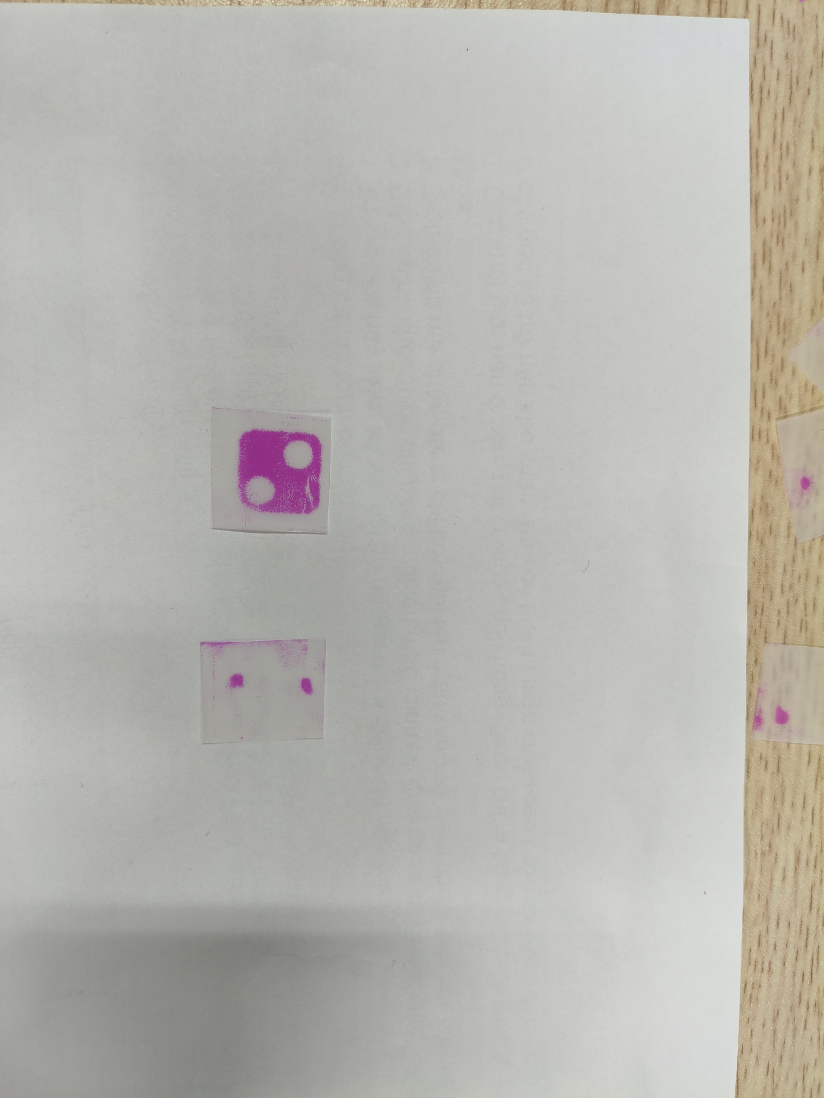
IMG_20251107_085923.jpg
