Cinthanh1998/Du-an-Foxconn/IMG_20251107_090314.jpg

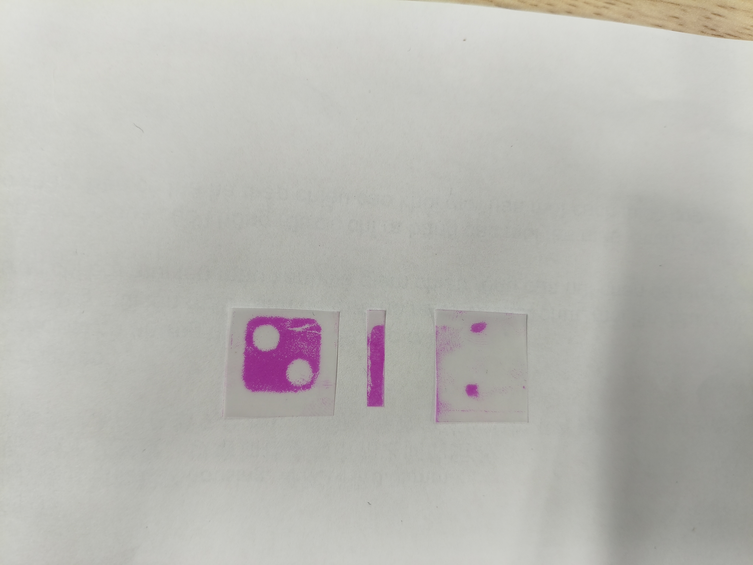
IMG_20251107_090314.jpg
