Cinthanh1998/Du-an-Foxconn/IMG_20251107_091633.jpg

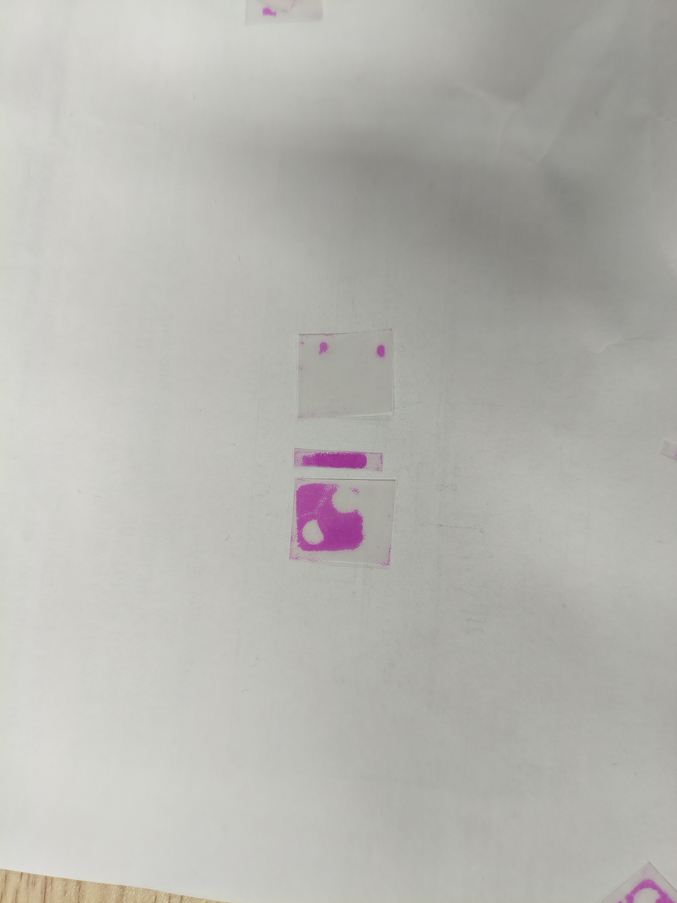
IMG_20251107_091633.jpg
