Cinthanh1998/Du-an-Foxconn/IMG_20251107_092137.jpg

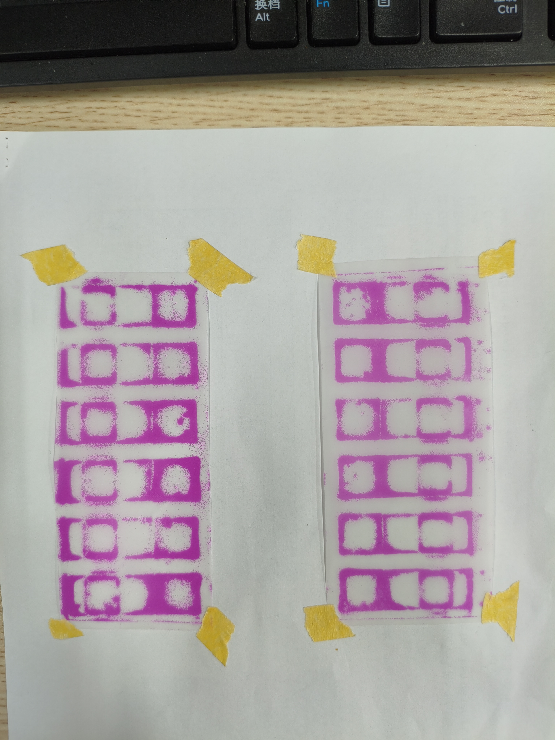
IMG_20251107_092137.jpg
