Cinthanh1998/Du-an-Foxconn/IMG_20251107_094845.jpg

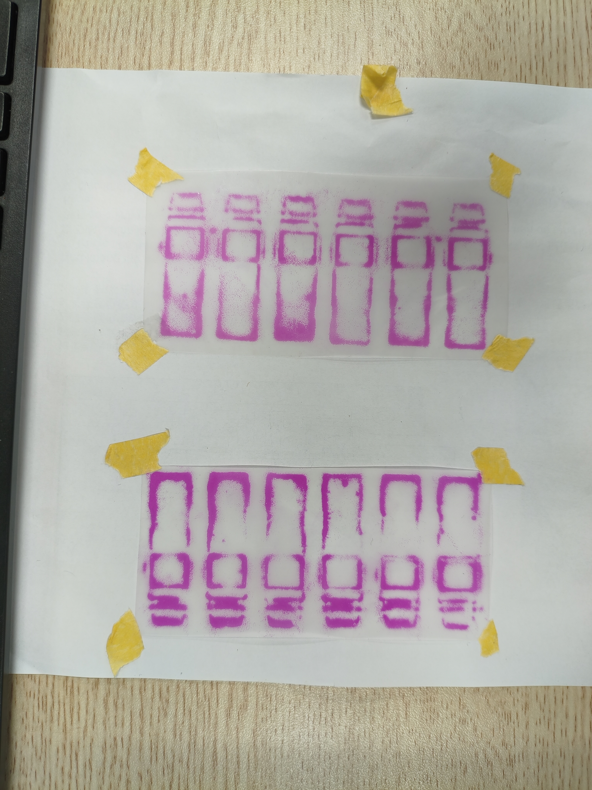
IMG_20251107_094845.jpg
