Cinthanh1998/Du-an-Foxconn/IMG_20251107_101546.jpg

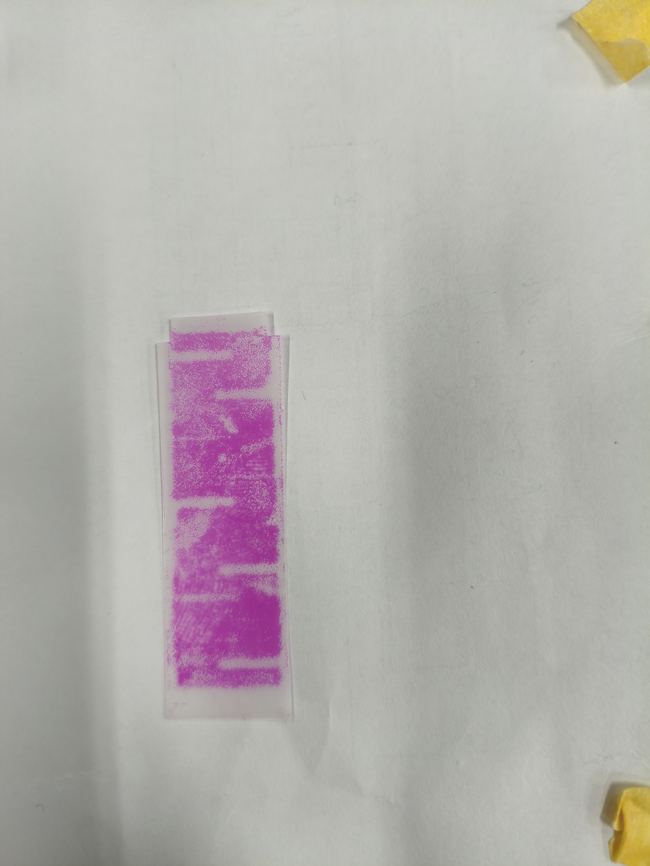
IMG_20251107_101546.jpg
