Cinthanh1998/Du-an-Foxconn/IMG_20251107_102354.jpg

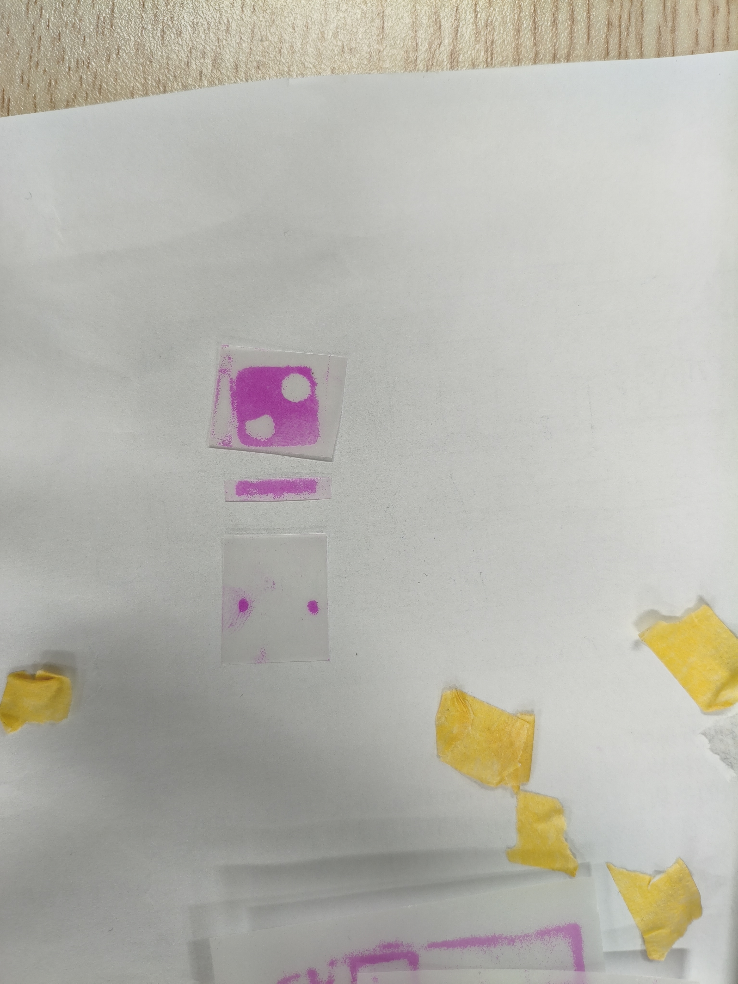
IMG_20251107_102354.jpg
