Cinthanh1998/Du-an-Foxconn/IMG_20251112_133734.jpg

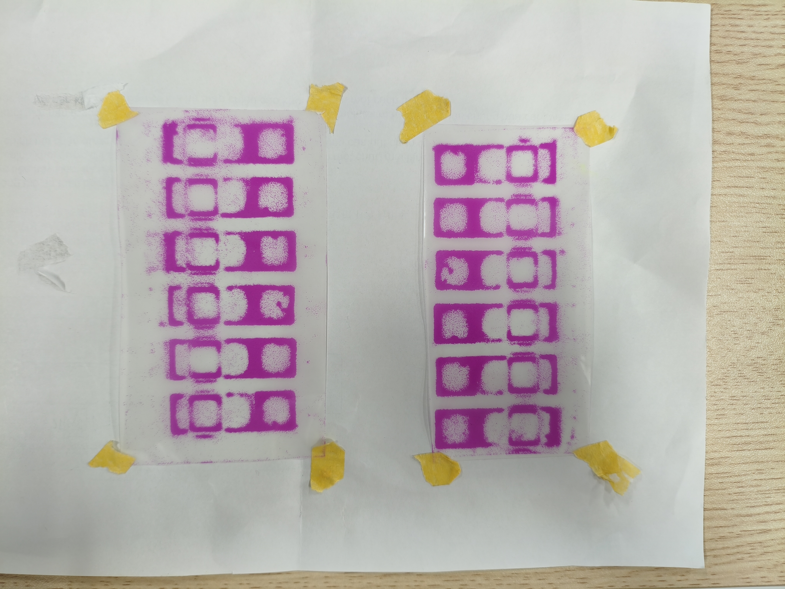
IMG_20251112_133734.jpg
