Cinthanh1998/Du-an-Foxconn/IMG_20260323_084946.jpg

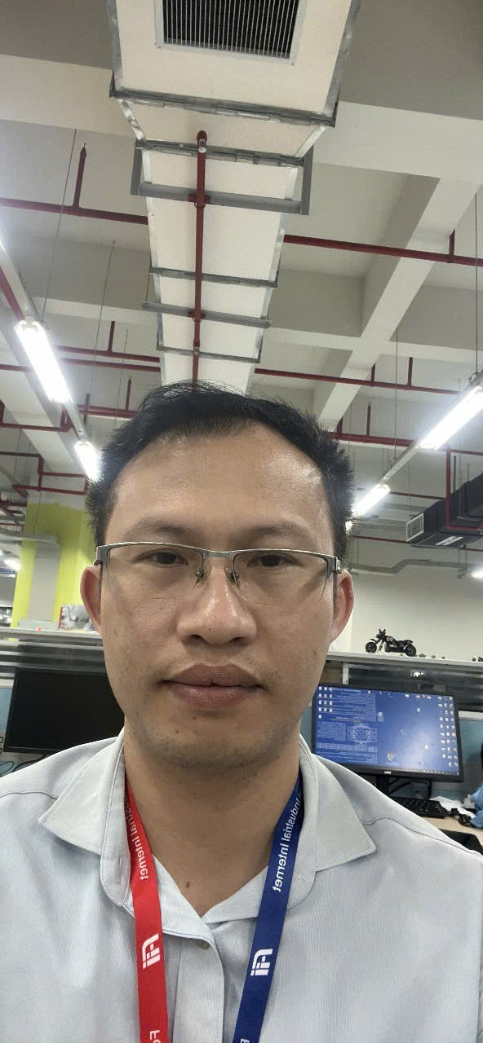
IMG_20260323_084946.jpg
