Cinthanh1998/Du-an-Foxconn/IMG_20260323_185206.jpg

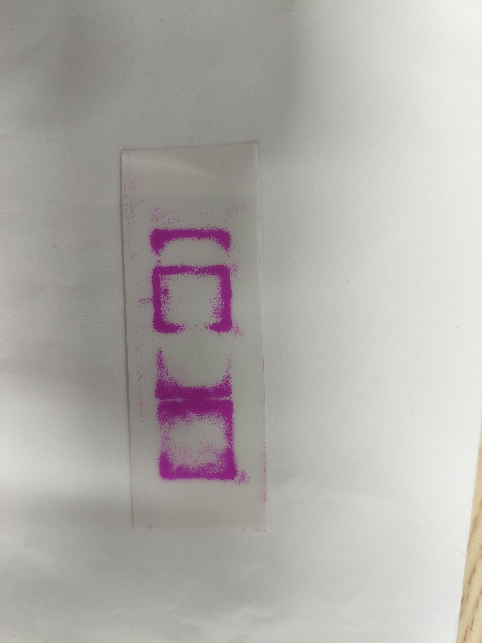
IMG_20260323_185206.jpg
