Cinthanh1998/Du-an-Foxconn/IMG_20260323_185226.jpg

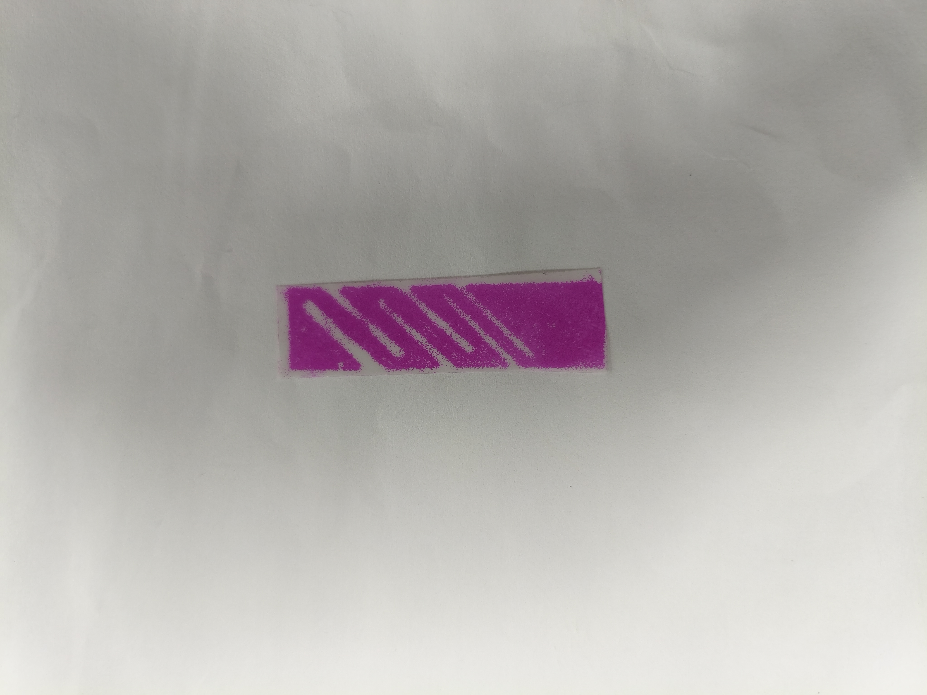
IMG_20260323_185226.jpg
