Cinthanh1998/Du-an-Foxconn/IMG_20260323_200658.jpg

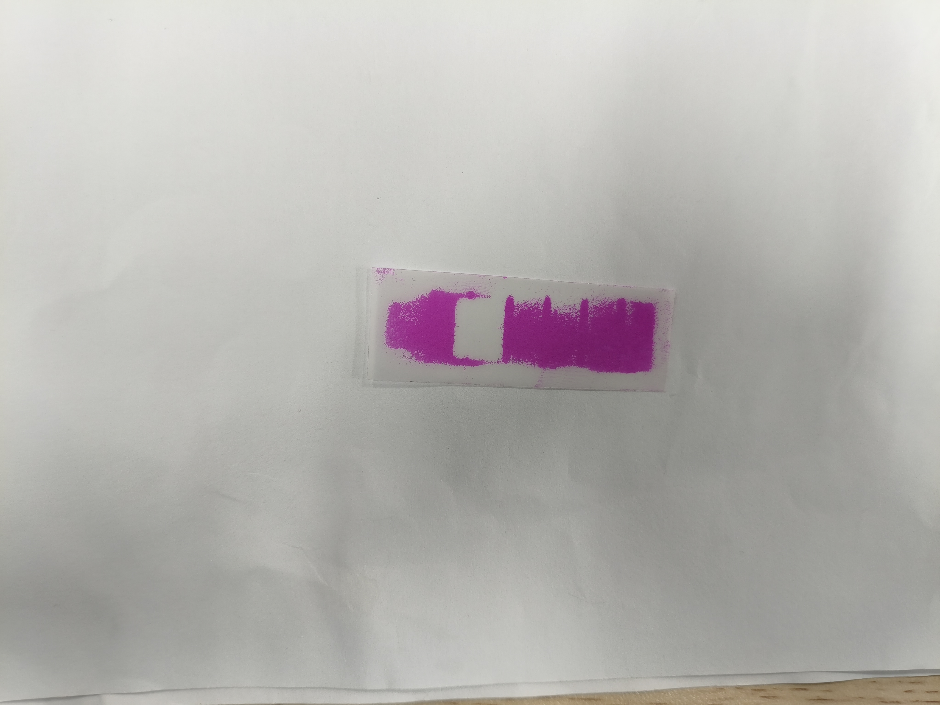
IMG_20260323_200658.jpg
