Cinthanh1998/Du-an-Foxconn/IMG_20260324_112529.jpg

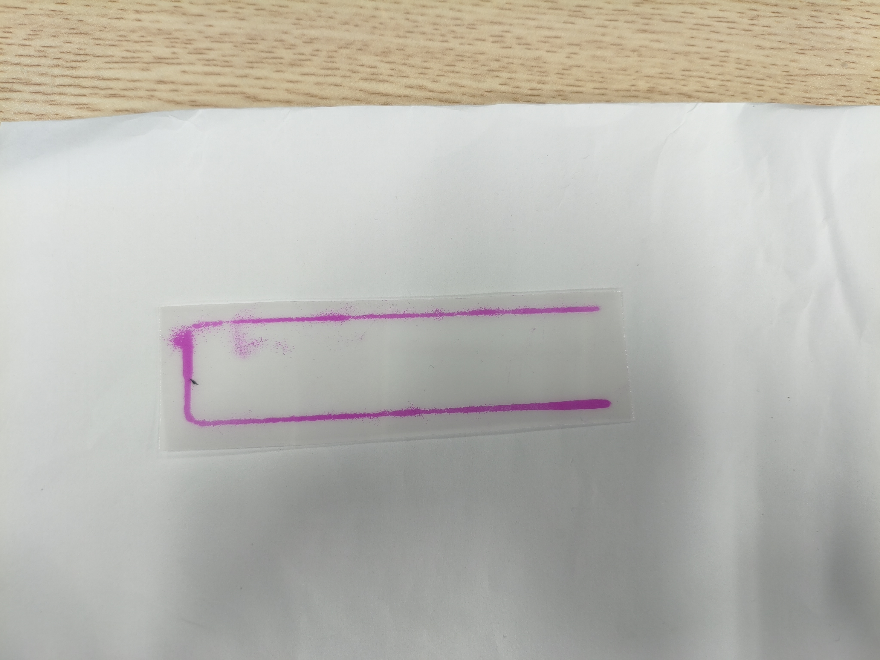
IMG_20260324_112529.jpg
