Cinthanh1998/Du-an-Foxconn/IMG_20260324_112621.jpg

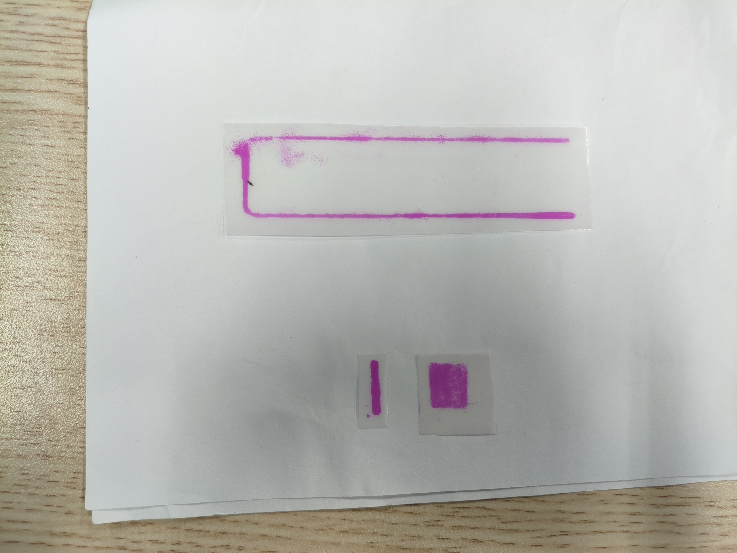
IMG_20260324_112621.jpg
