Cinthanh1998/Du-an-Foxconn/IMG_20260324_131015.jpg

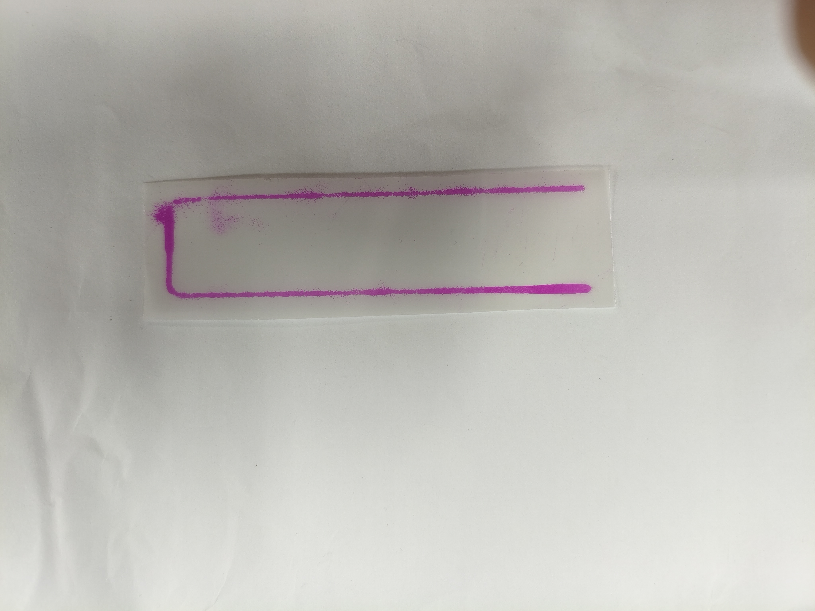
IMG_20260324_131015.jpg
