Cinthanh1998/Du-an-Foxconn/IMG_20260404_082910.jpg

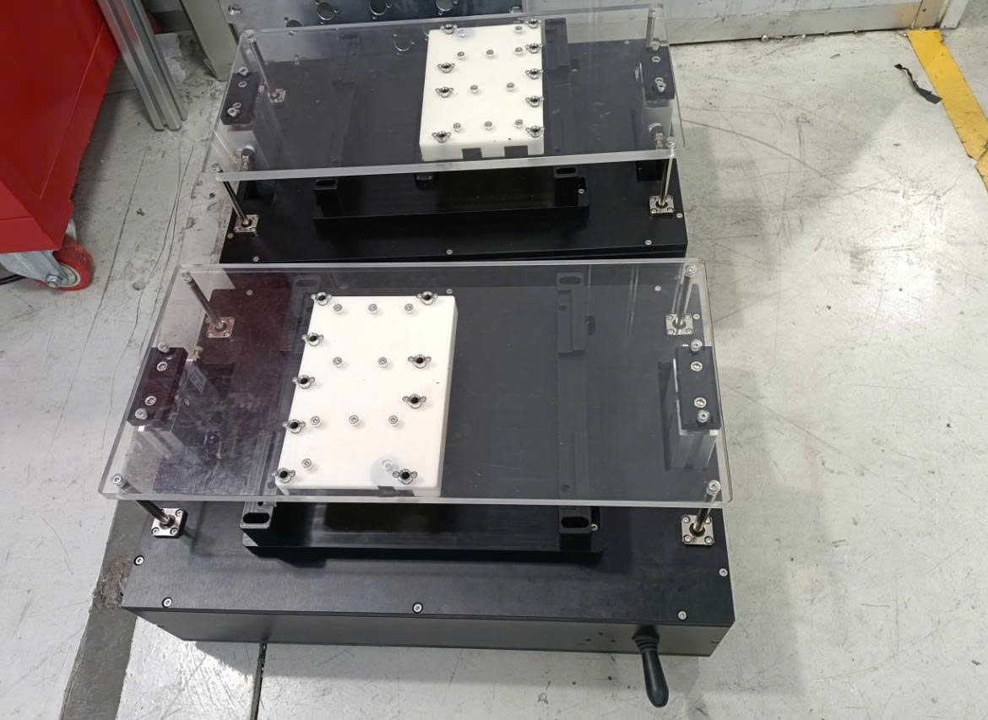
IMG_20260404_082910.jpg
