Cinthanh1998/Du-an-Foxconn/IMG_20260512_150322.jpg

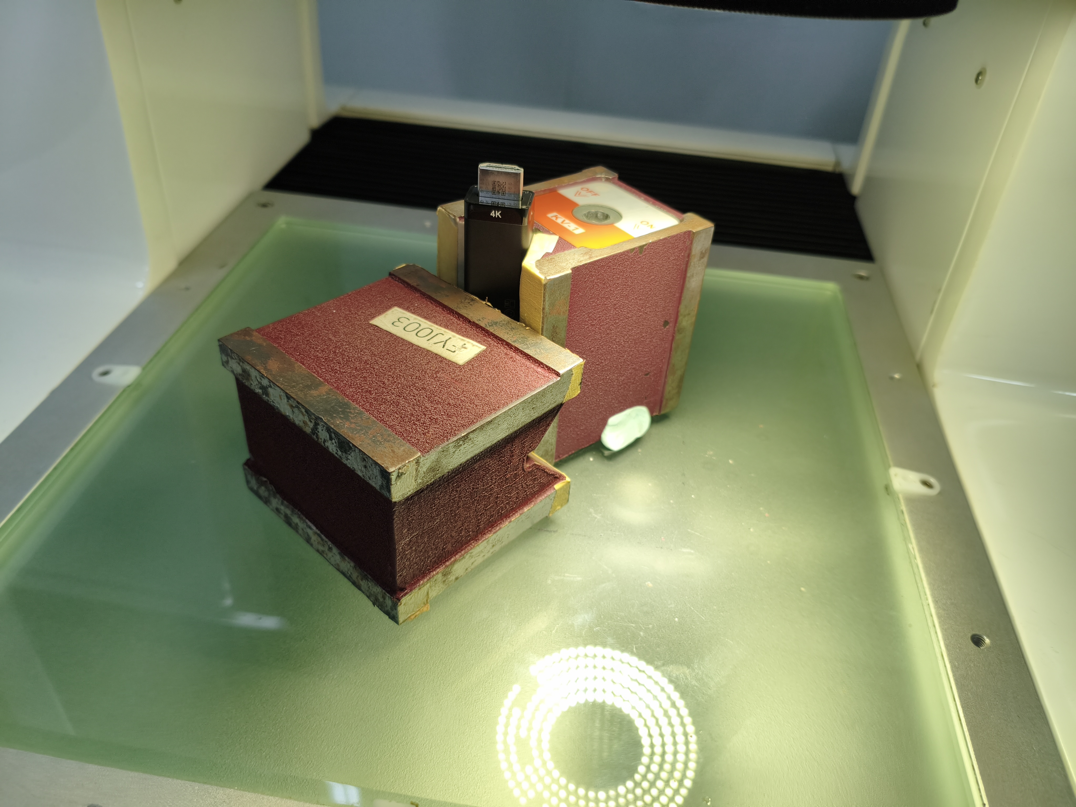
IMG_20260512_150322.jpg
