Cinthanh1998/Du-an-Foxconn/IMG_20260512_150334.jpg

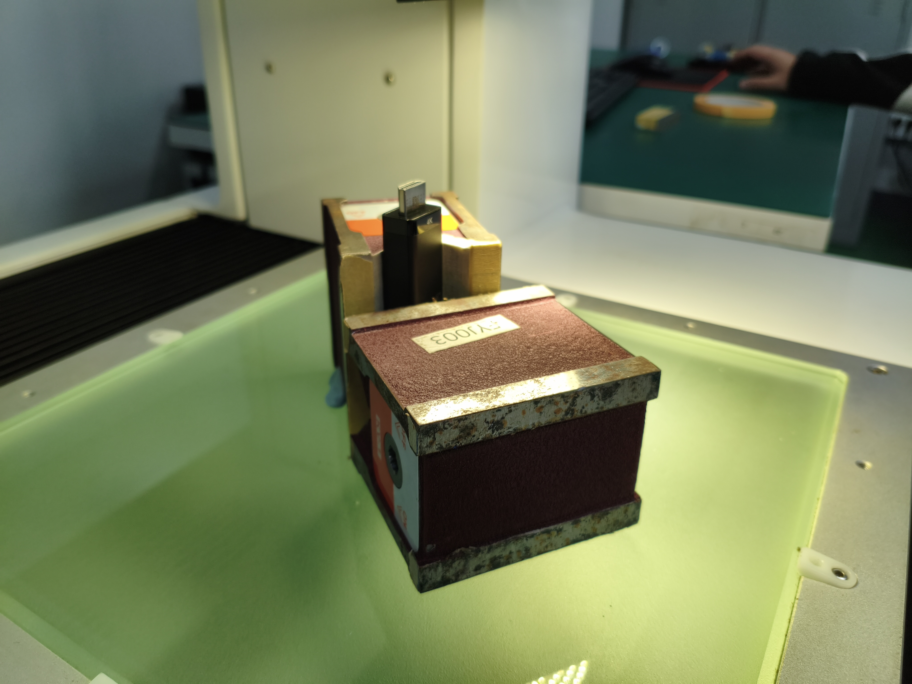
IMG_20260512_150334.jpg
