Cinthanh1998/Du-an-Foxconn/IMG_20260512_152406.jpg

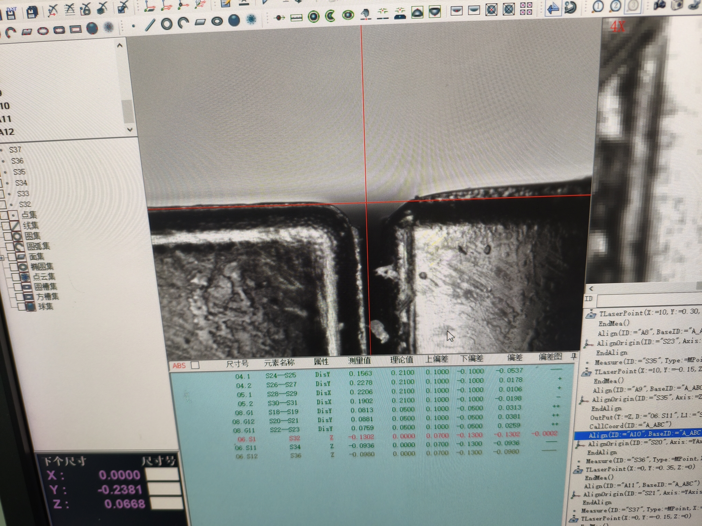
IMG_20260512_152406.jpg
