Cinthanh1998/Du-an-Foxconn/IMG_20260512_155213.jpg

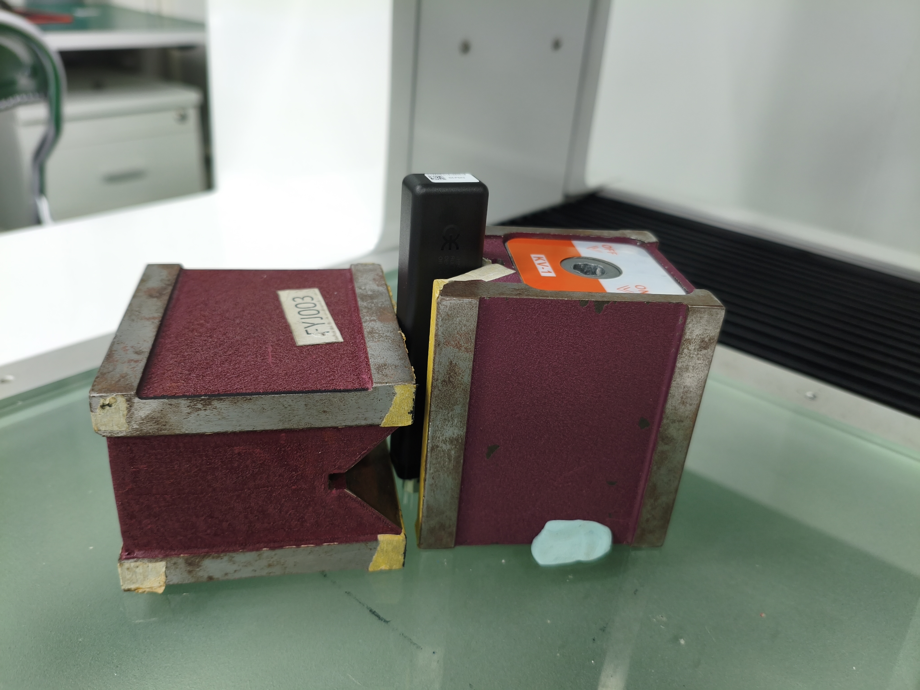
IMG_20260512_155213.jpg
