Cinthanh1998/Du-an-Foxconn/IMG_20260512_155958.jpg

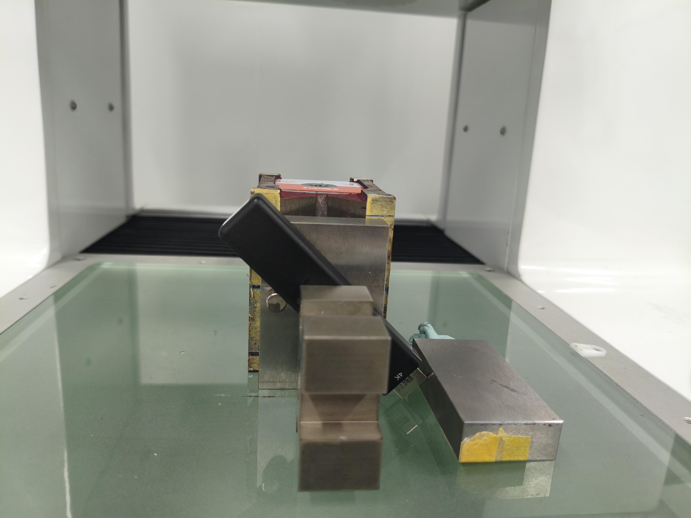
IMG_20260512_155958.jpg
