Cinthanh1998/Du-an-Foxconn/IMG_20260512_161253.jpg

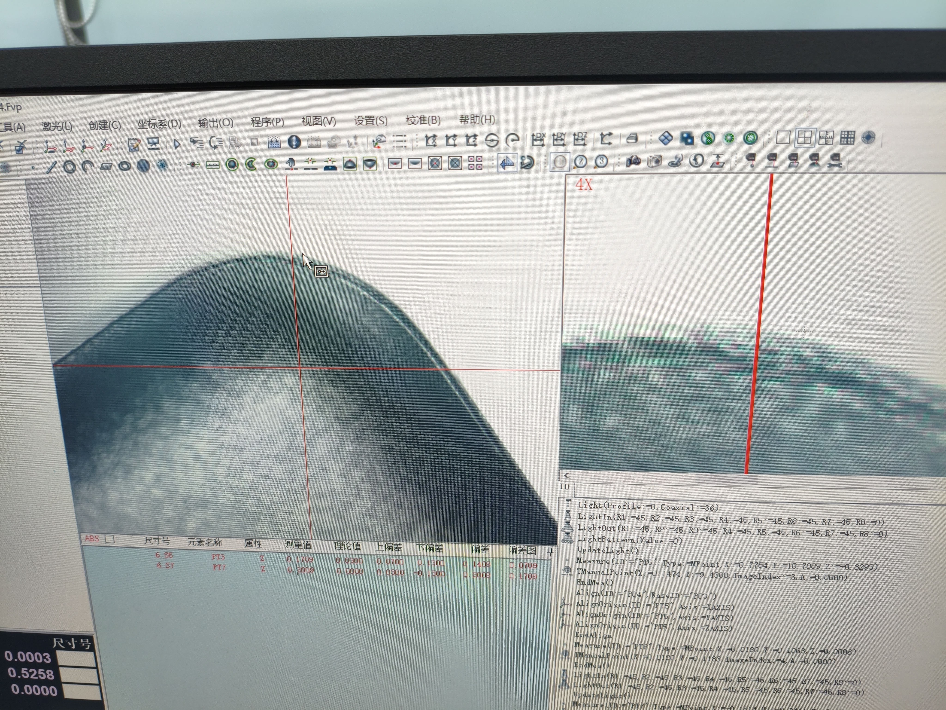
IMG_20260512_161253.jpg
