Cinthanh1998/Du-an-Foxconn/IMG_20260529_130939.jpg

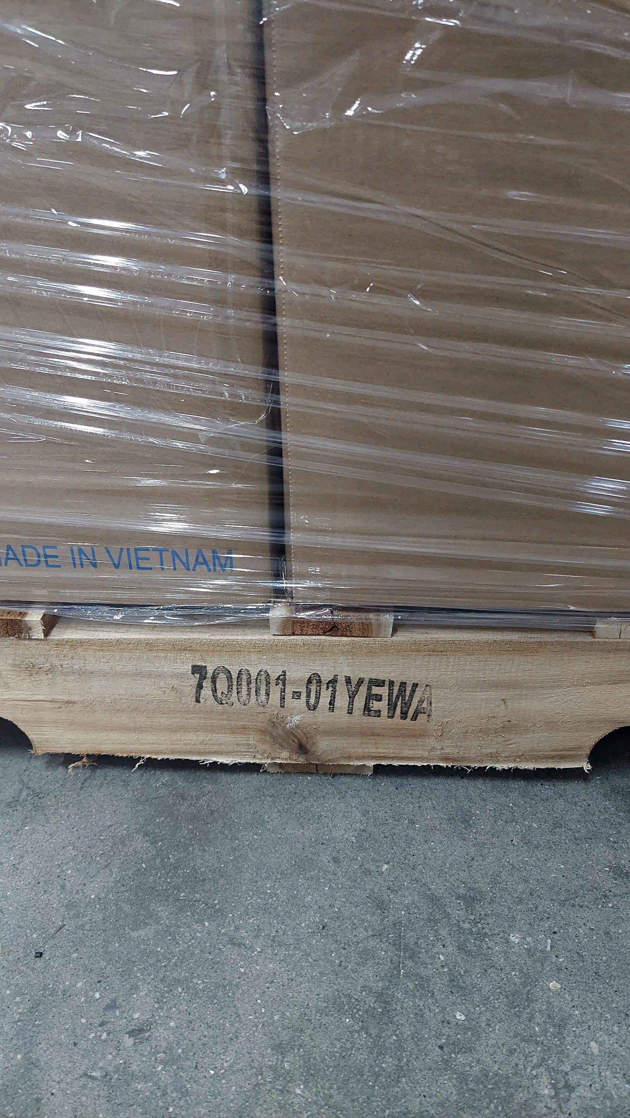
IMG_20260529_130939.jpg
