Cinthanh1998/Du-an-Foxconn/IMG_20260602_085258.jpg

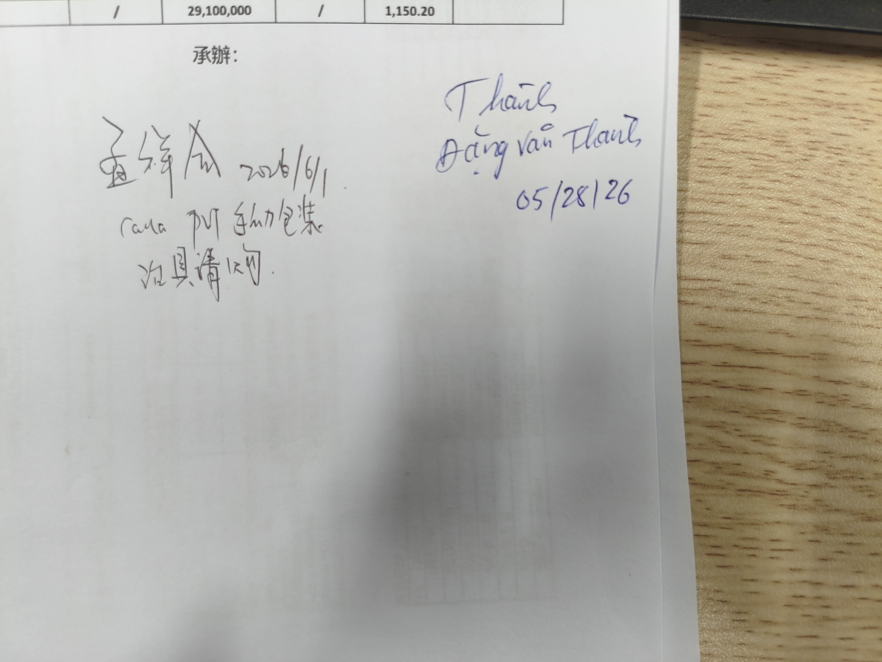
IMG_20260602_085258.jpg
