Cinthanh1998/Du-an-Foxconn/IMG_20260602_211830.jpg

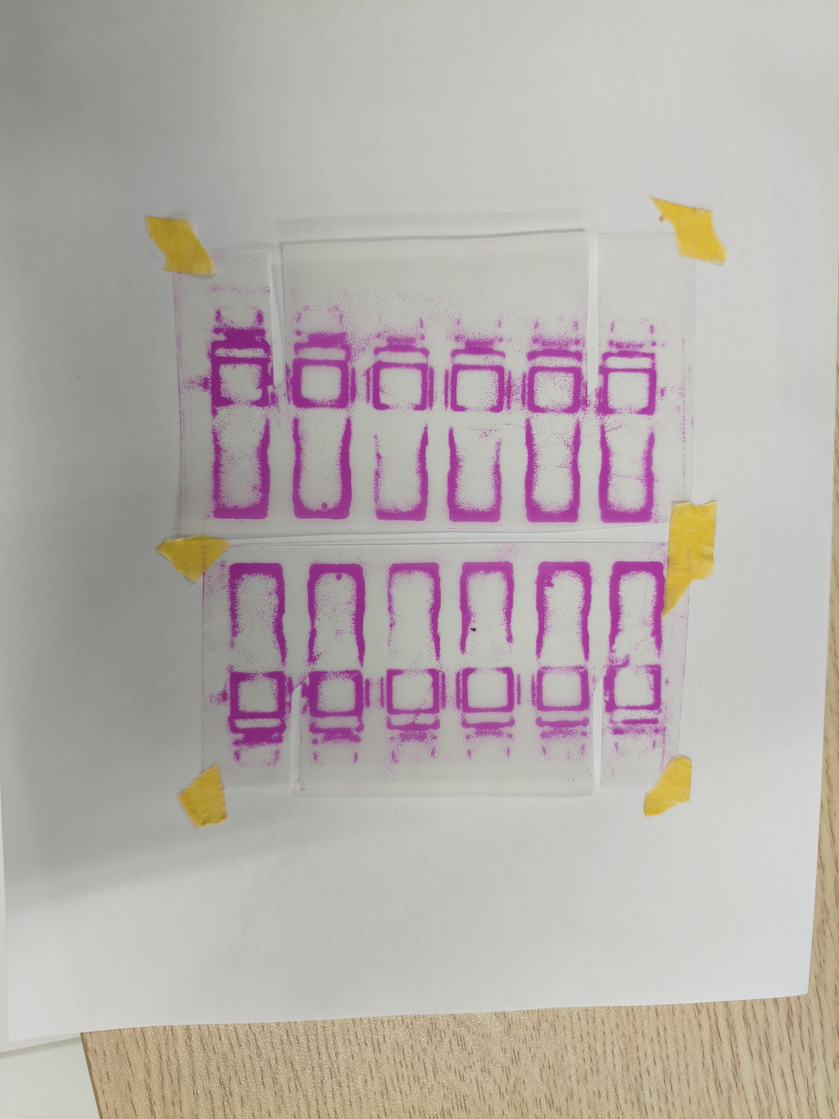
IMG_20260602_211830.jpg
