Cinthanh1998/Du-an-Foxconn/IMG_20260602_212044.jpg

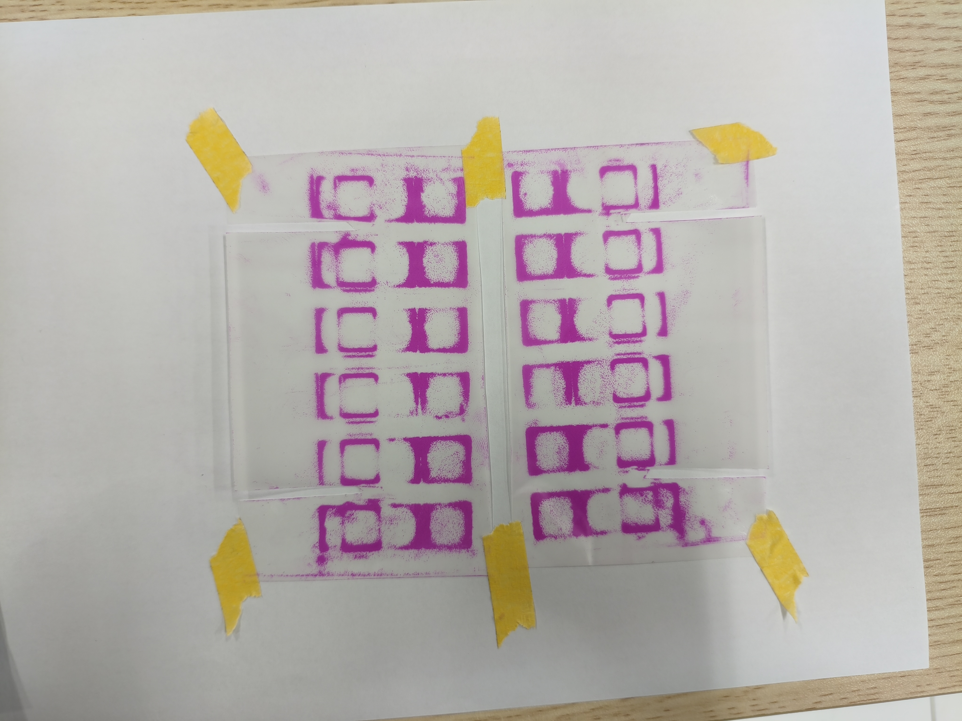
IMG_20260602_212044.jpg
