Cinthanh1998/Du-an-Foxconn/IMG_20260602_212300.jpg

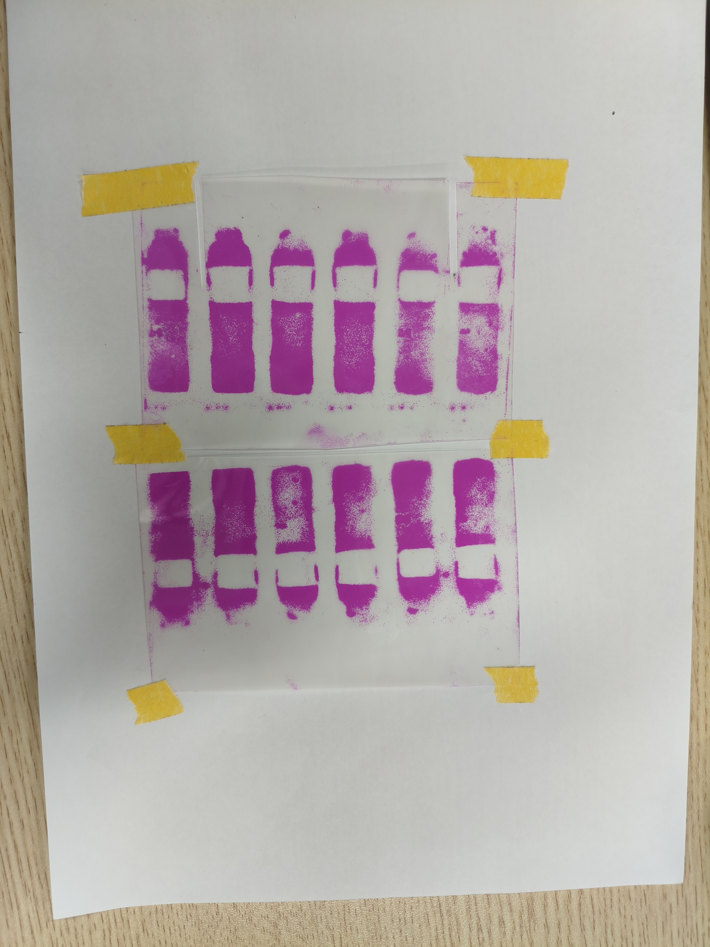
IMG_20260602_212300.jpg
