Cinthanh1998/Du-an-Foxconn/IMG_20260602_212521.jpg

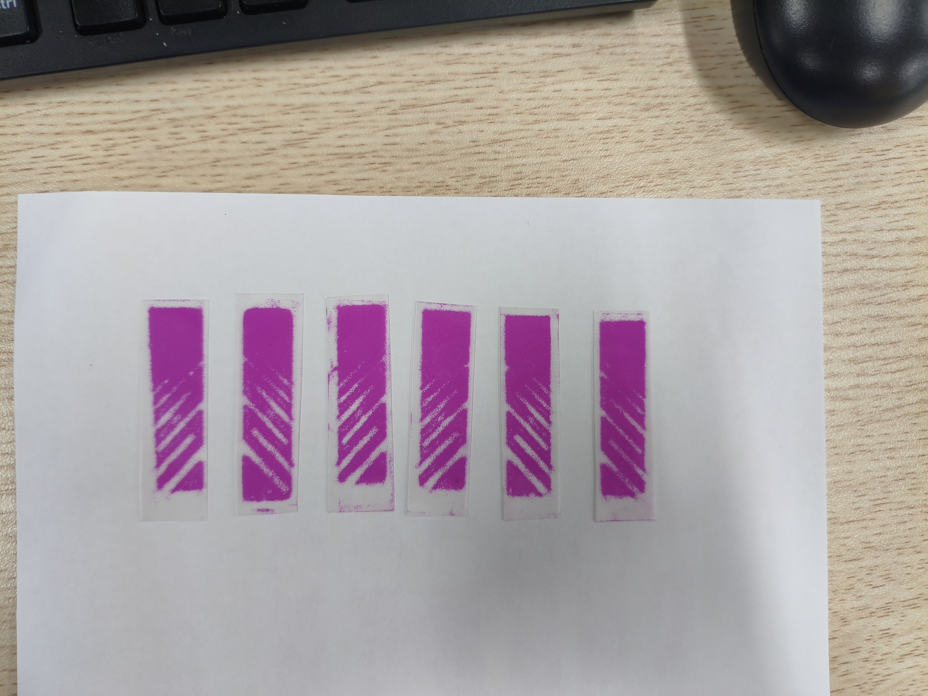
IMG_20260602_212521.jpg
