Cinthanh1998/Du-an-Foxconn/IMG_20260602_212754.jpg

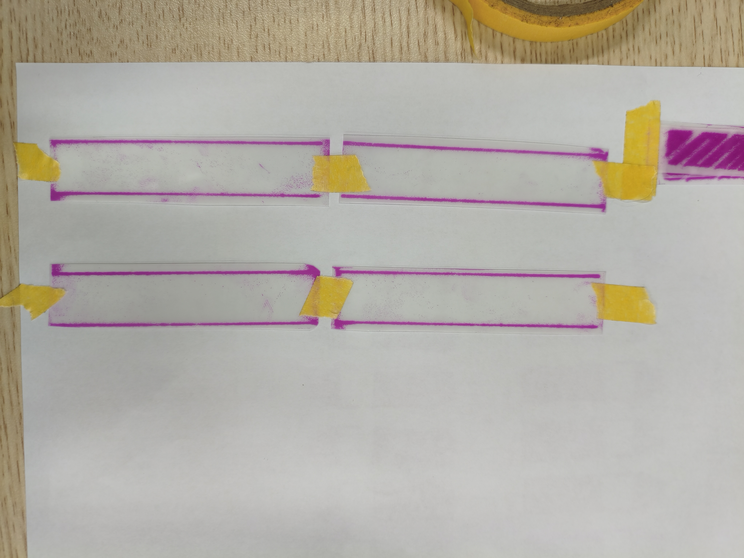
IMG_20260602_212754.jpg
