Cinthanh1998/Du-an-Foxconn/IMG_20260602_213123.jpg

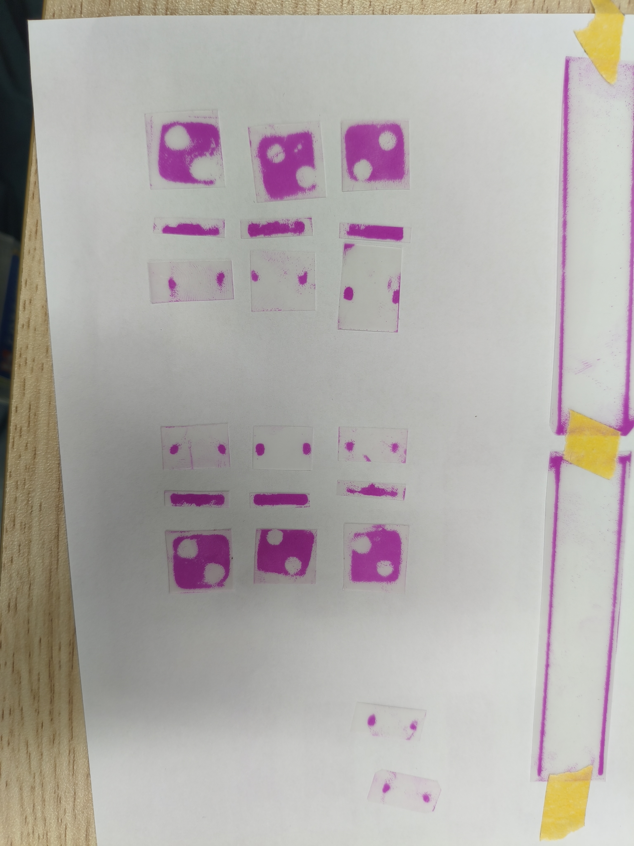
IMG_20260602_213123.jpg
