Cinthanh1998/Du-an-Foxconn/IMG_20260604_105146.jpg

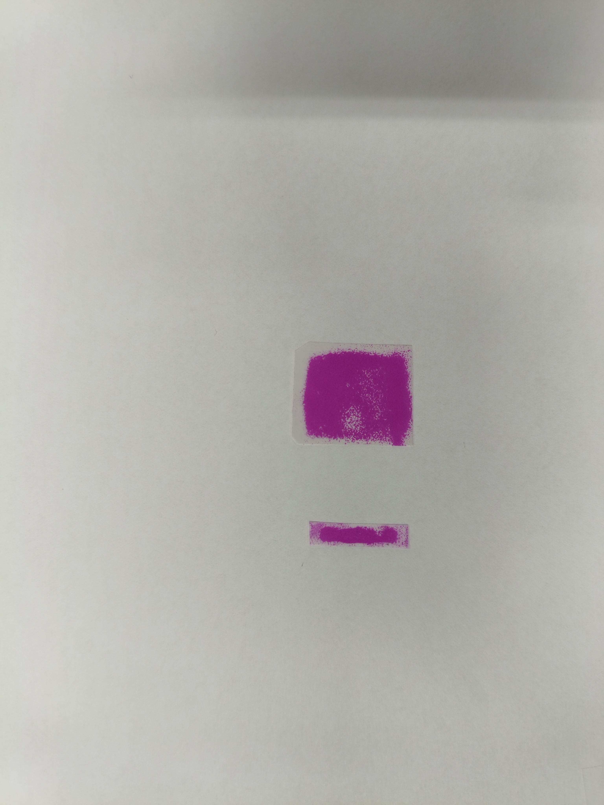
IMG_20260604_105146.jpg
