Cinthanh1998/Du-an-Foxconn/IMG_20260604_105227.jpg

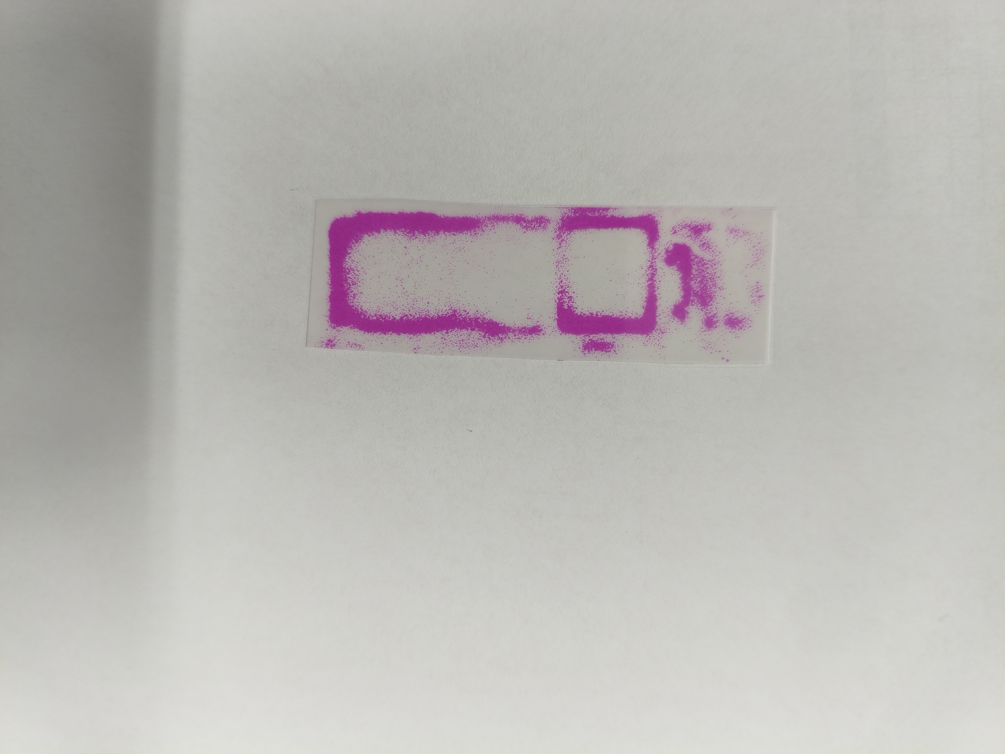
IMG_20260604_105227.jpg
