Cinthanh1998/Du-an-Foxconn/IMG_20260619_093737.jpg

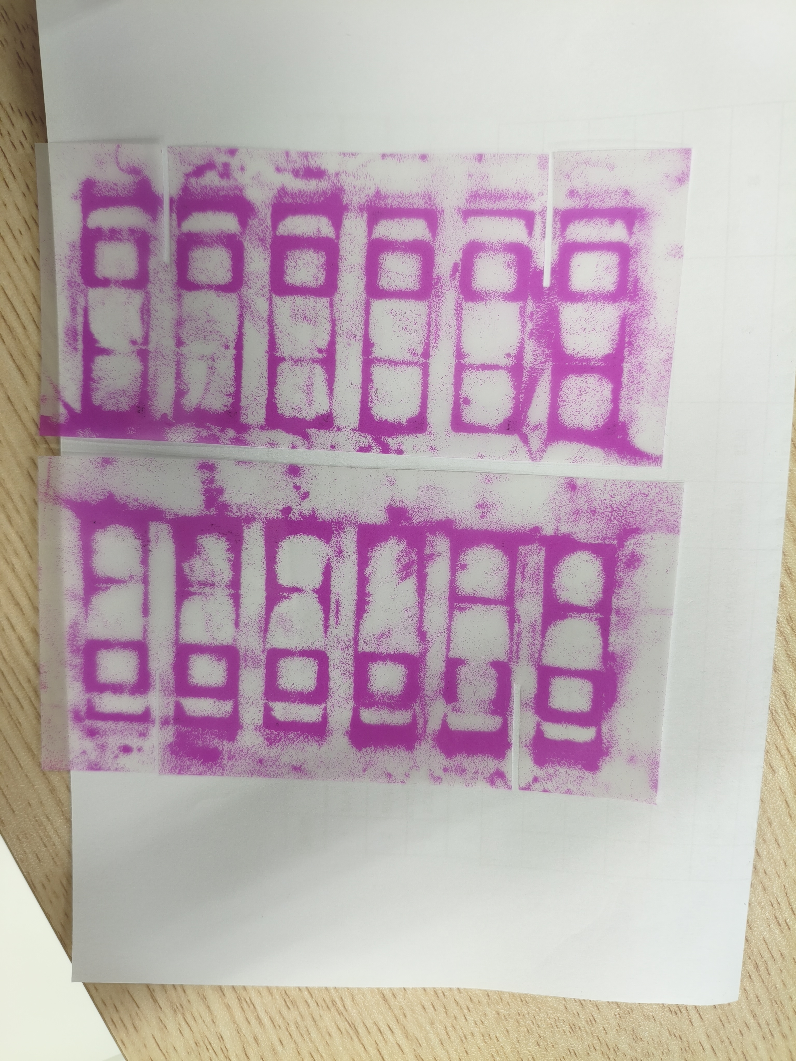
IMG_20260619_093737.jpg
