Cinthanh1998/Du-an-Foxconn/IMG_20260619_095459.jpg

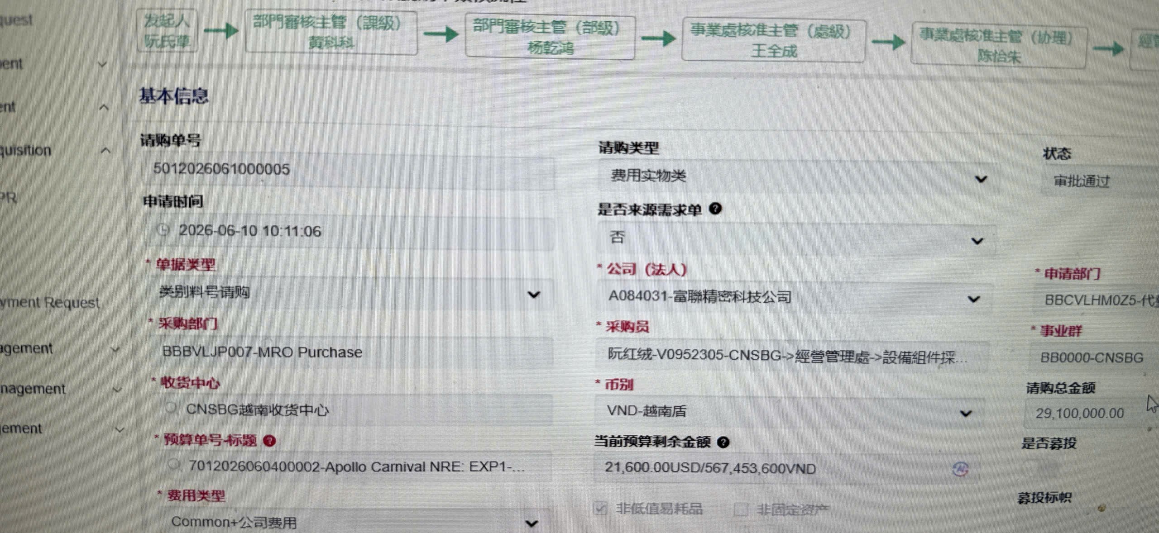
IMG_20260619_095459.jpg
