Cinthanh1998/Du-an-Foxconn/IMG_20260706_202538.jpg

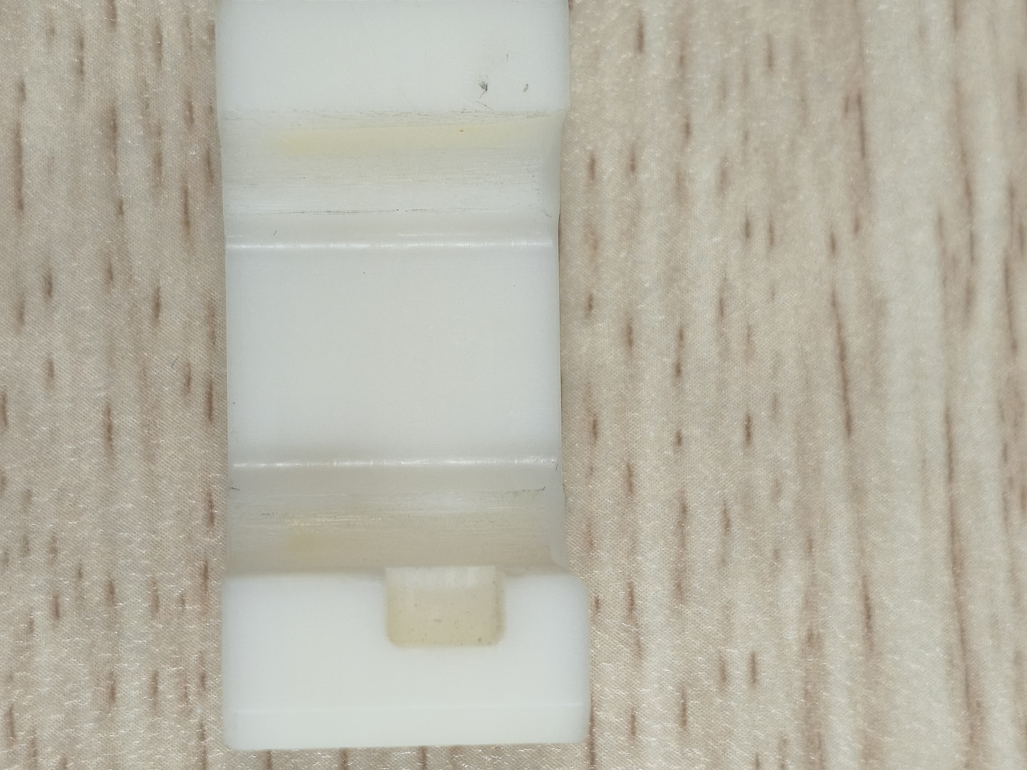
IMG_20260706_202538.jpg
