Cinthanh1998/Du-an-Foxconn/IMG_20260706_202743.jpg

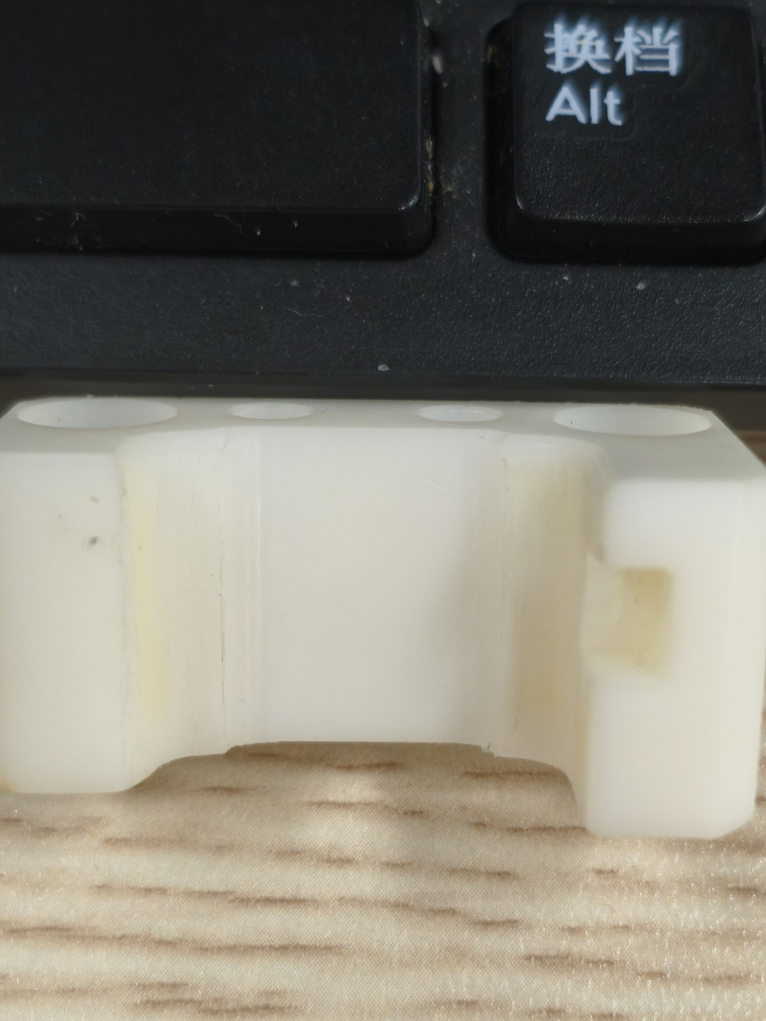
IMG_20260706_202743.jpg
