Cinthanh1998/Du-an-Foxconn/IMG_20260815_170452.jpg

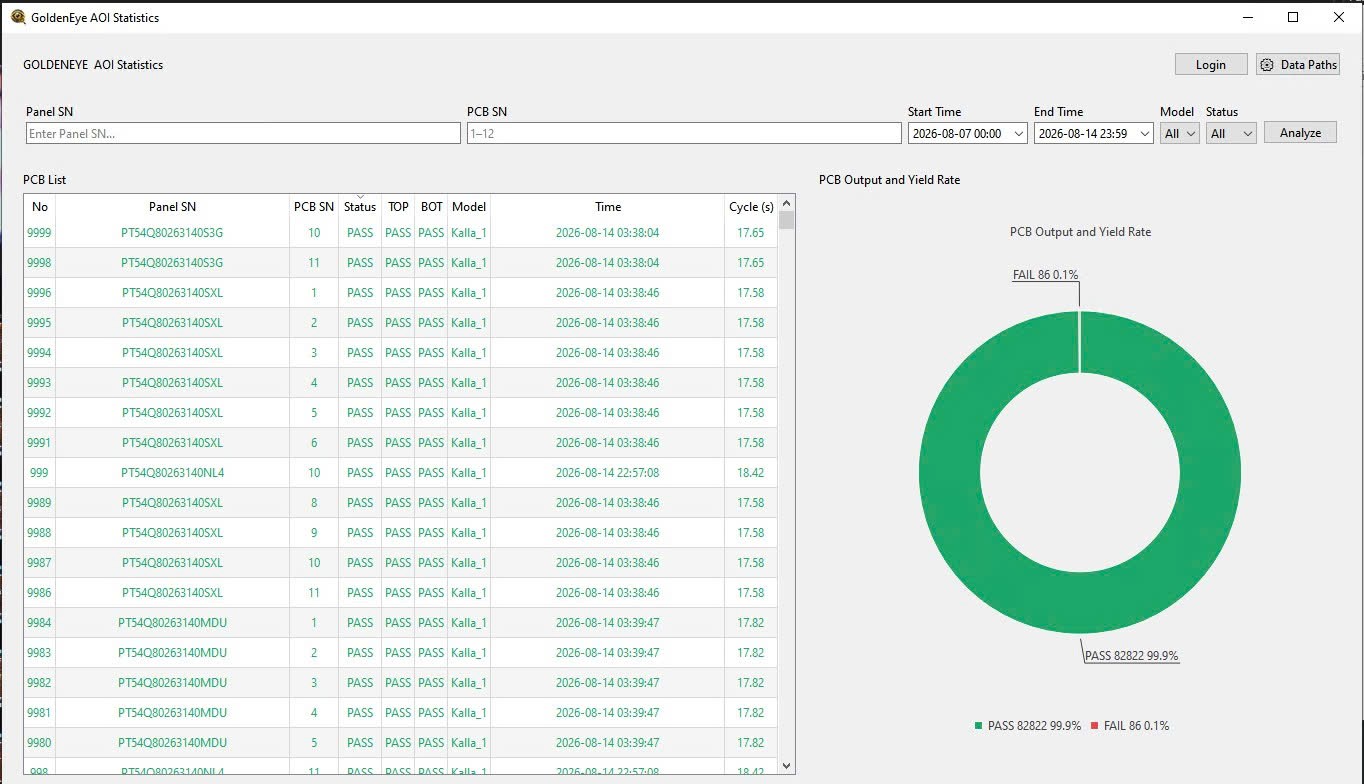
IMG_20260815_170452.jpg
