Cinthanh1998/Du-an-Foxconn/IMG_20260824_111237.jpg

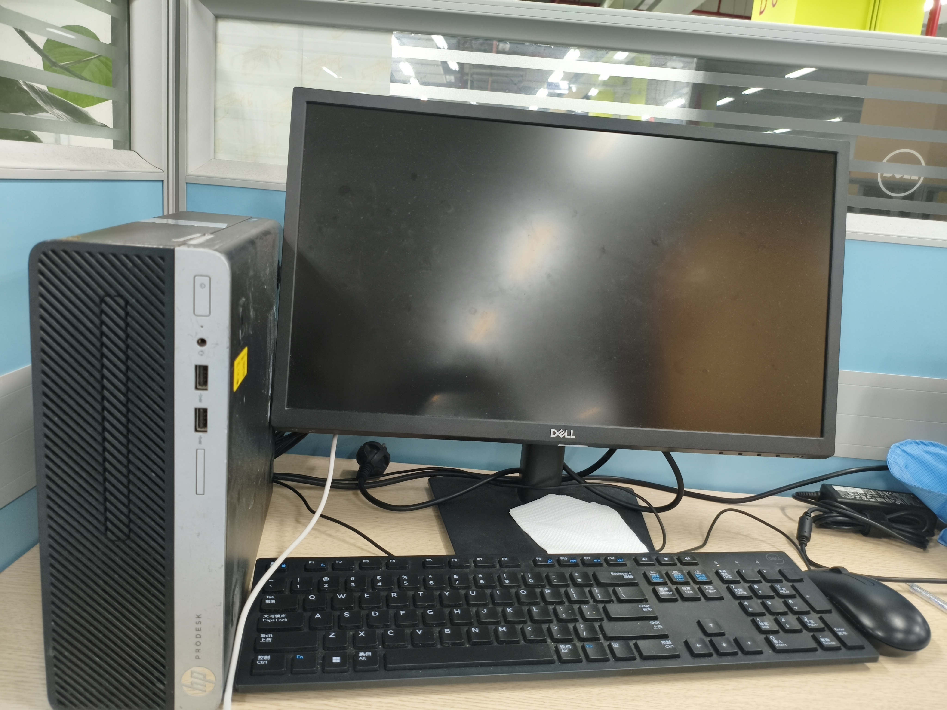
IMG_20260824_111237.jpg
