Cinthanh1998/Du-an-Foxconn/IMG_20260923_132549.jpg

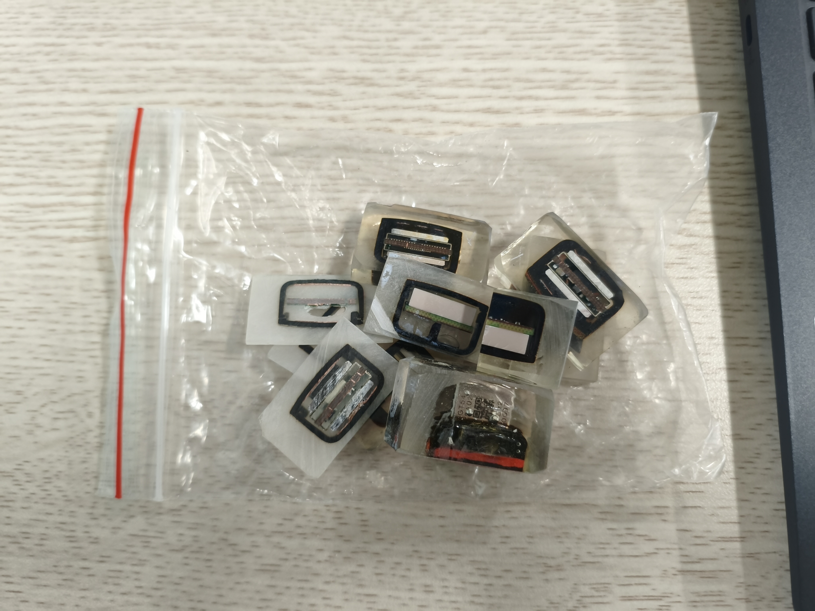
IMG_20260923_132549.jpg
