Cinthanh1998/Du-an-Foxconn/IMG_1760577509197_1760577557538.jpg

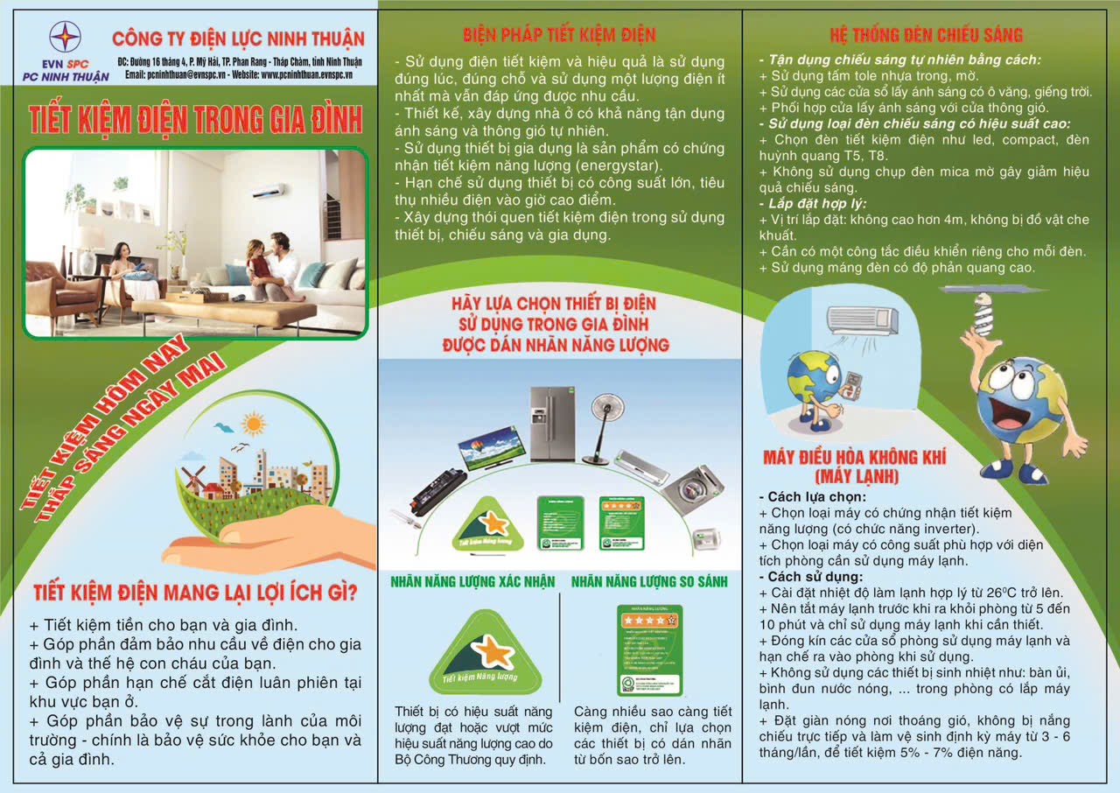
IMG_1760577509197_1760577557538.jpg
