Cinthanh1998/Du-an-Foxconn/IMG_1760577509215_1760577557632.jpg

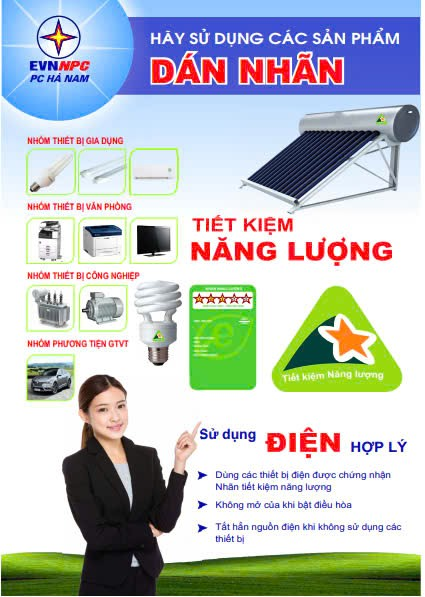
IMG_1760577509215_1760577557632.jpg
