Cinthanh1998/Du-an-Foxconn/IMG_1760577509229_1760577557685.jpg

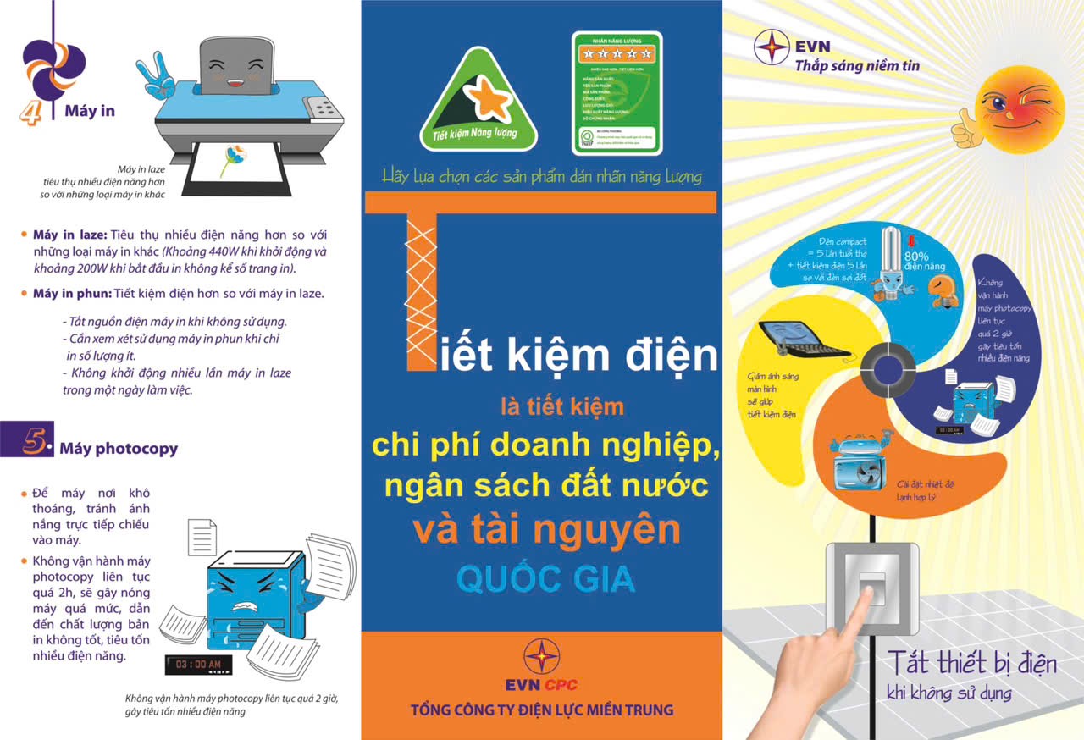
IMG_1760577509229_1760577557685.jpg
