Cinthanh1998/Du-an-Foxconn/IMG_1760577509242_1760577557789.jpg

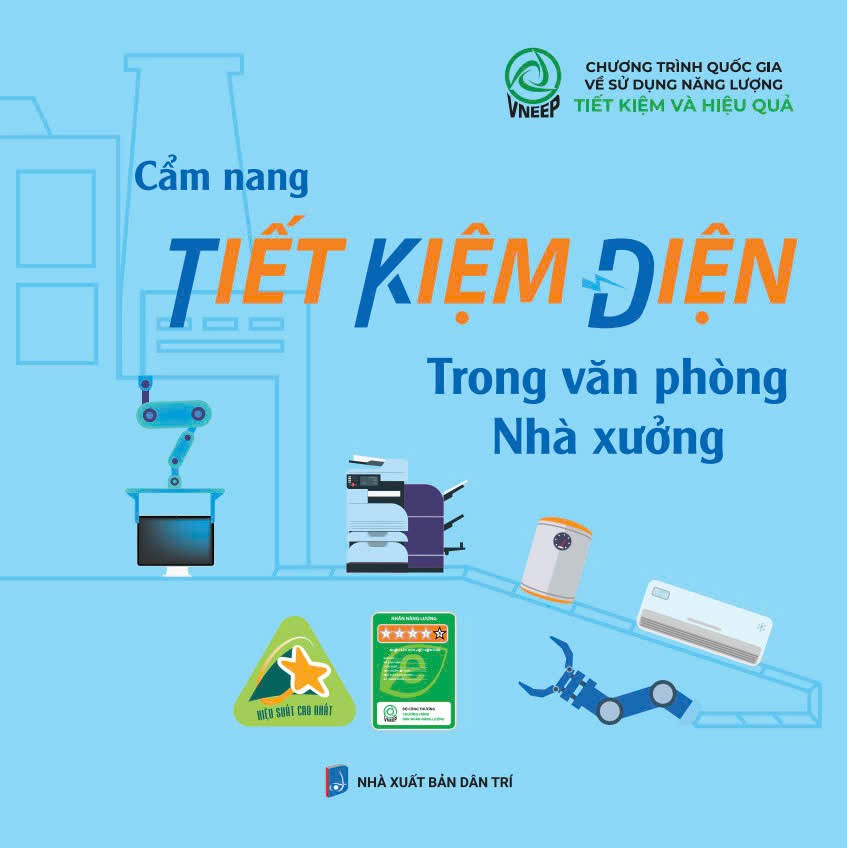
IMG_1760577509242_1760577557789.jpg
