Cinthanh1998/Du-an-Foxconn/IMG_1760577509253_1760577557863.jpg

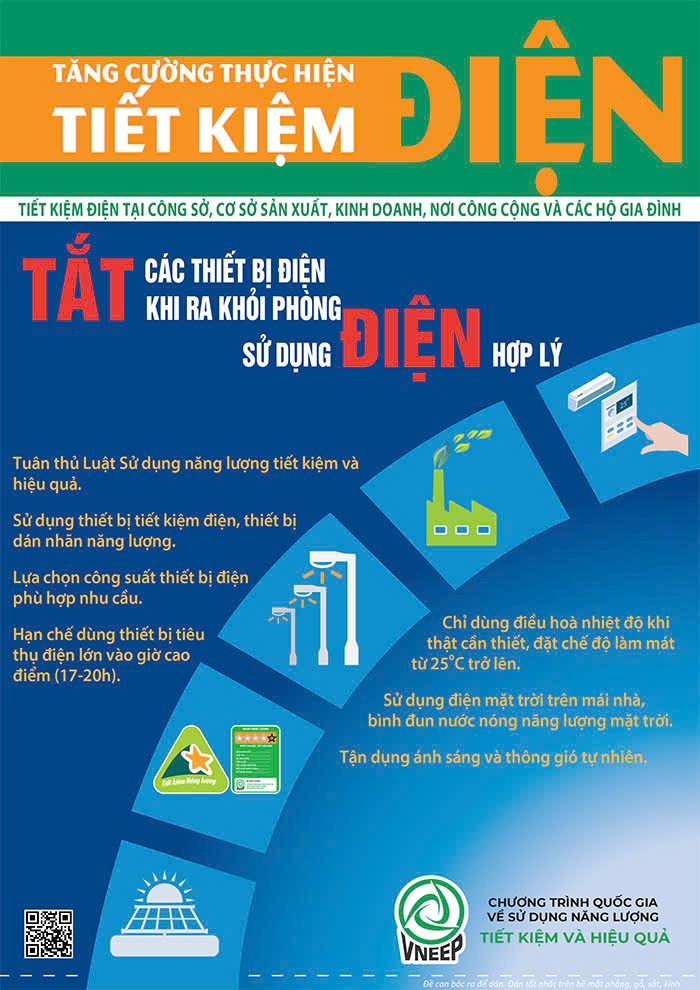
IMG_1760577509253_1760577557863.jpg
