Cinthanh1998/Du-an-Foxconn/IMG_1779934237016_1780034971712.jpg

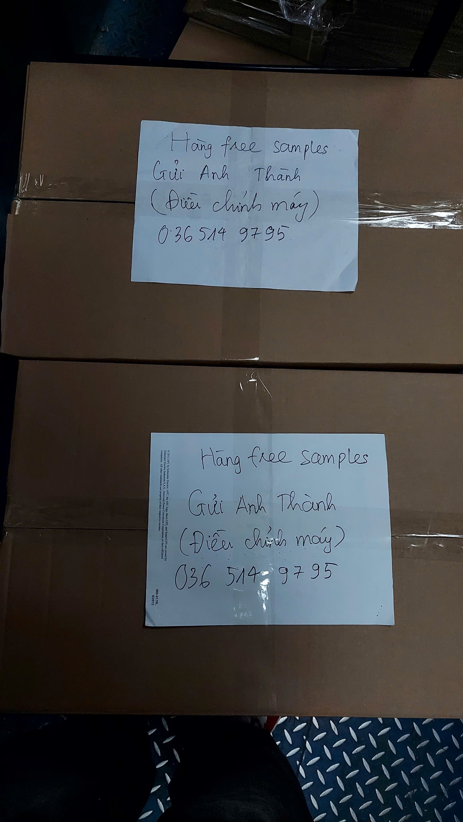
IMG_1779934237016_1780034971712.jpg
