Cinthanh1998/Du-an-Foxconn/IMG_1790230945364_1790230964306.jpg

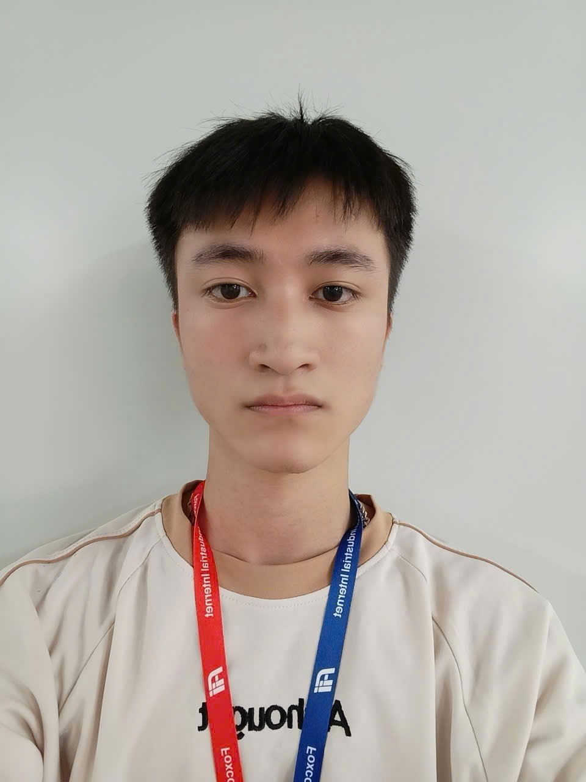
IMG_1790230945364_1790230964306.jpg
