Cinthanh1998/Du-an-Foxconn/mmexport1783994720831.jpg

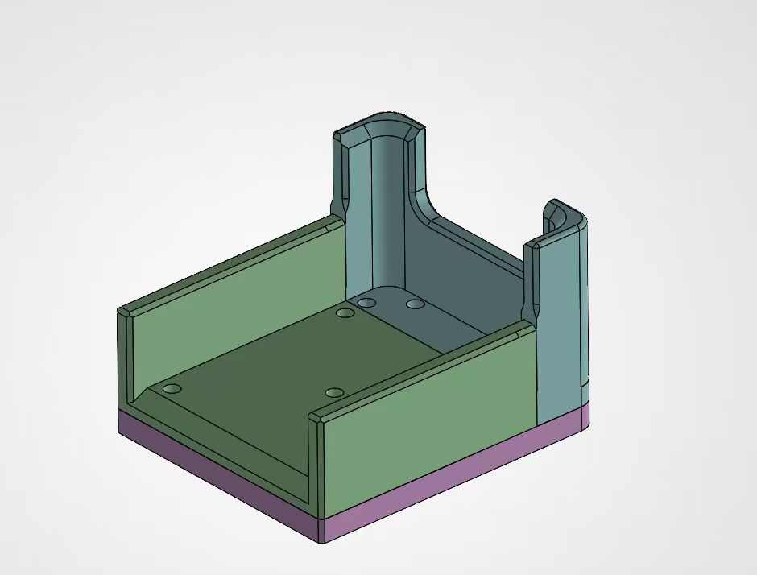
mmexport1783994720831.jpg
