Cinthanh1998/Du-an-Foxconn/MVIMG_20251112_134432.jpg

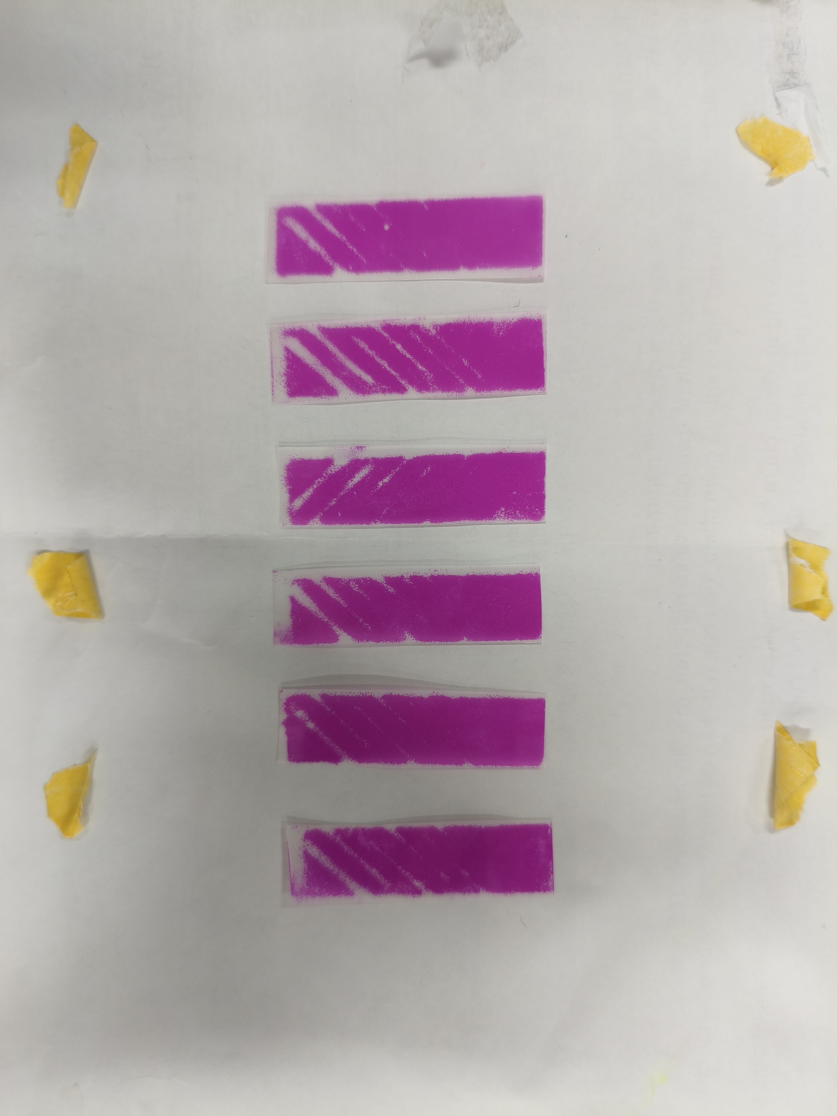
MVIMG_20251112_134432.jpg
