Cinthanh1998/Du-an-Foxconn/MVIMG_20251112_135605.jpg

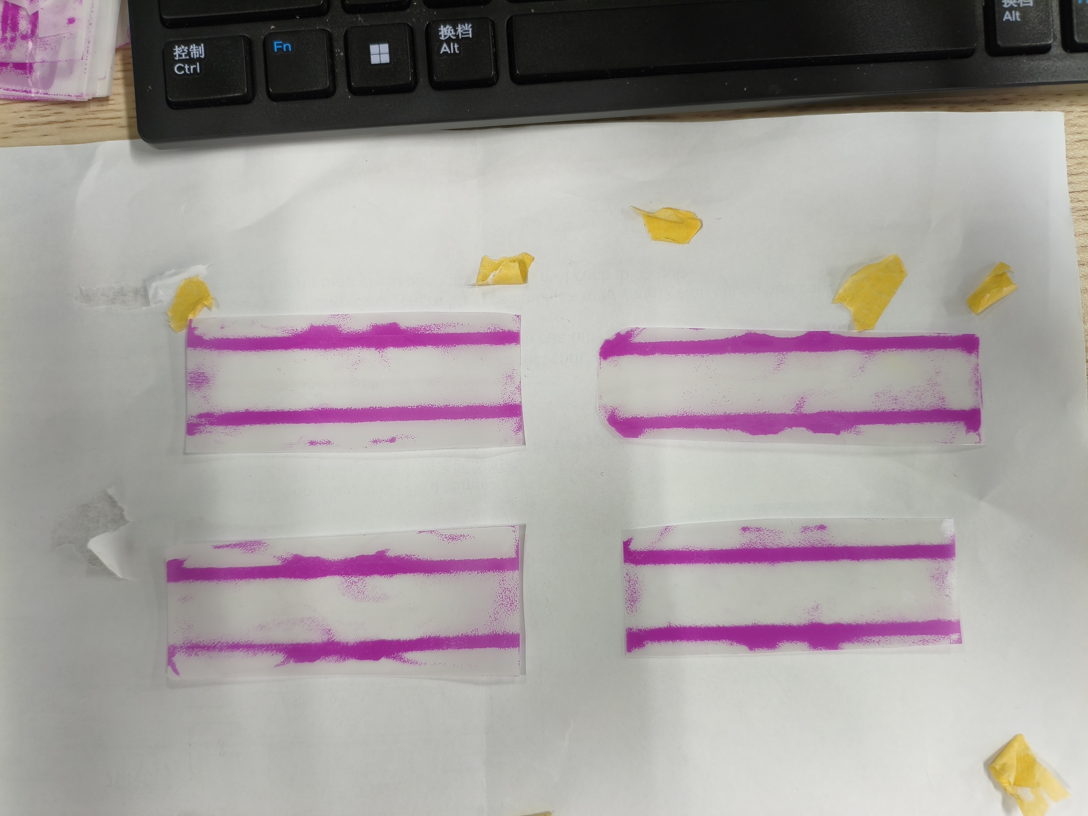
MVIMG_20251112_135605.jpg
