Cinthanh1998/Du-an-Foxconn/MVIMG_20251119_093457.jpg

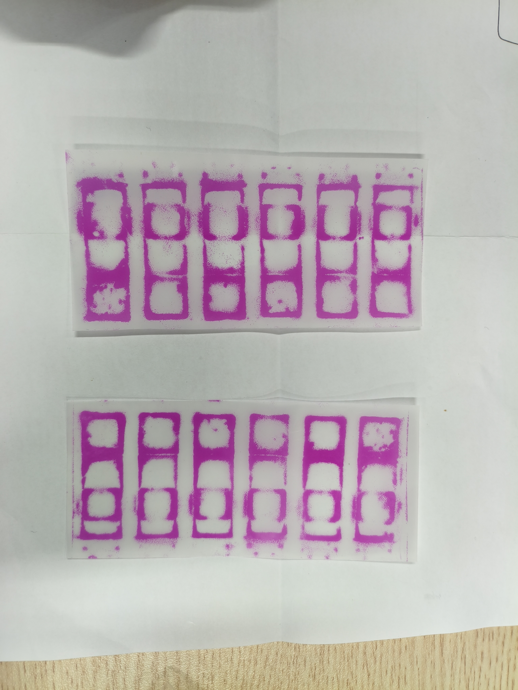
MVIMG_20251119_093457.jpg
