Cinthanh1998/Du-an-Foxconn/MVIMG_20251119_094128.jpg

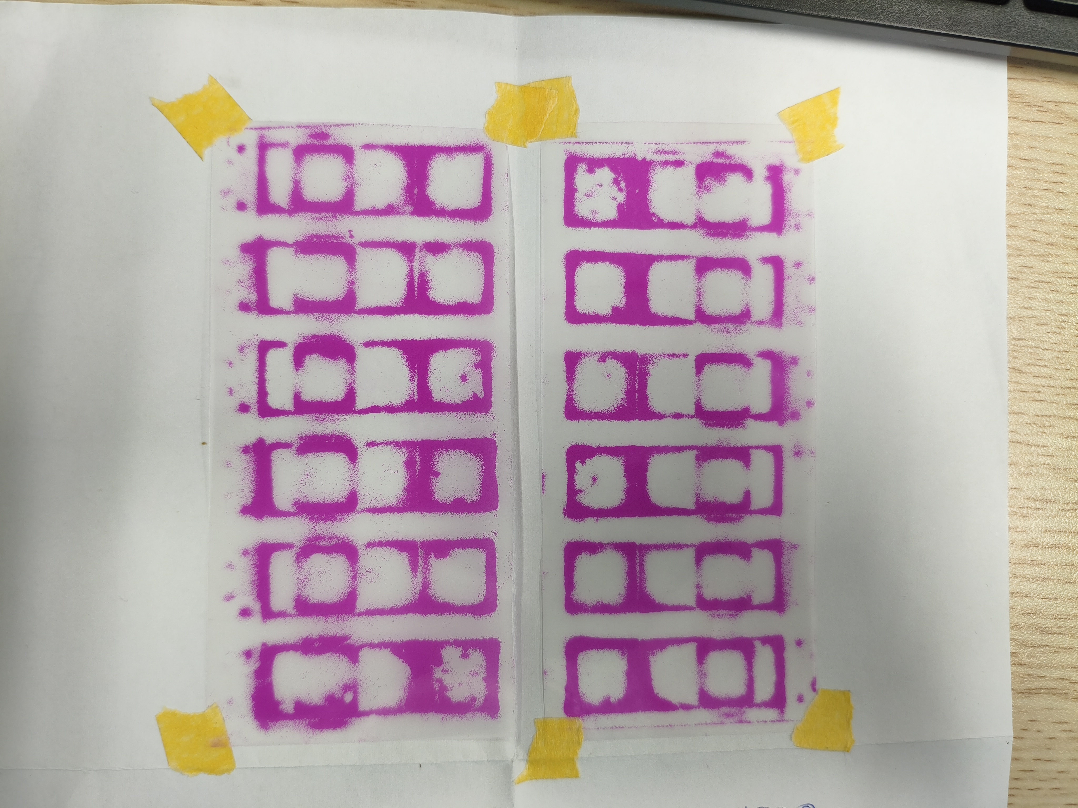
MVIMG_20251119_094128.jpg
