Cinthanh1998/Du-an-Foxconn/MVIMG_20251119_094924.jpg

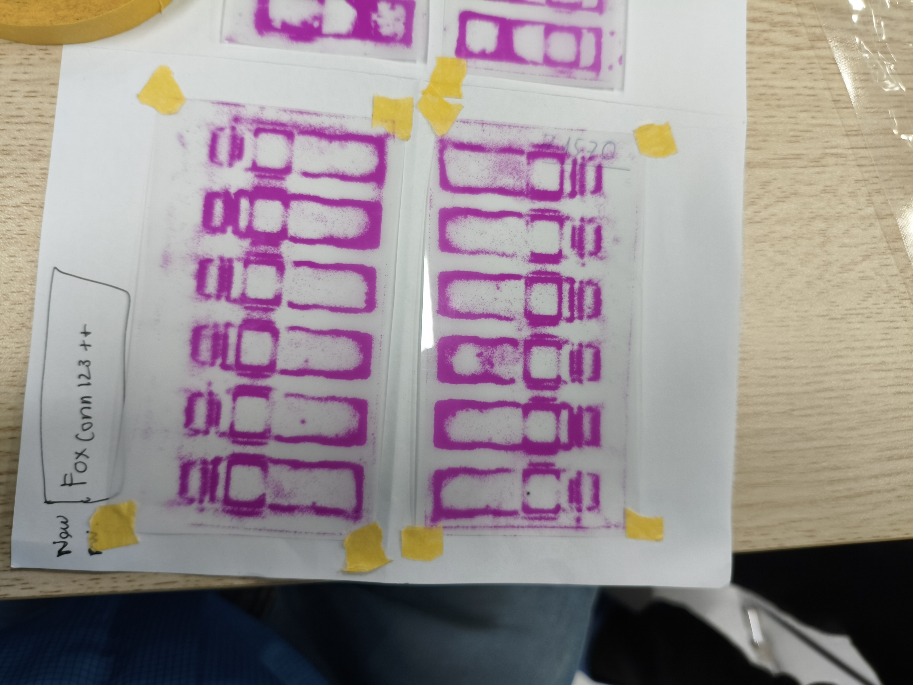
MVIMG_20251119_094924.jpg
