Cinthanh1998/Du-an-Foxconn/MVIMG_20251122_183516.jpg

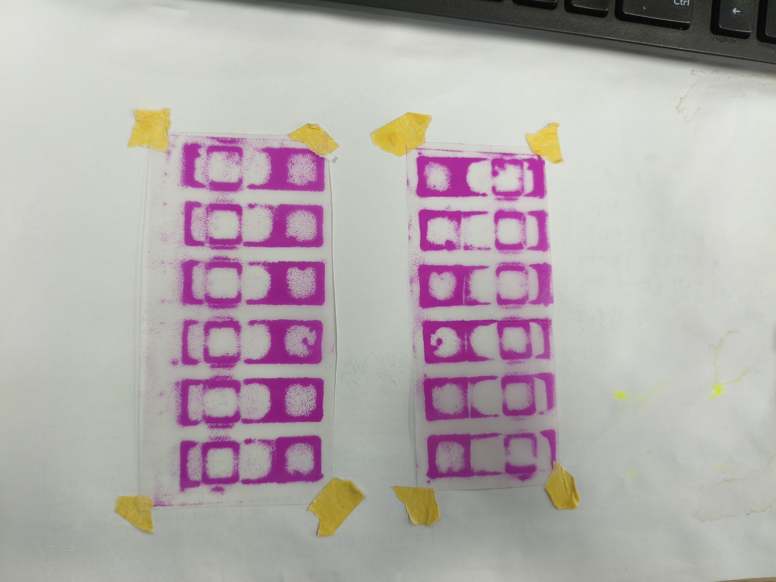
MVIMG_20251122_183516.jpg
