Cinthanh1998/Du-an-Foxconn/MVIMG_20251122_185242.jpg

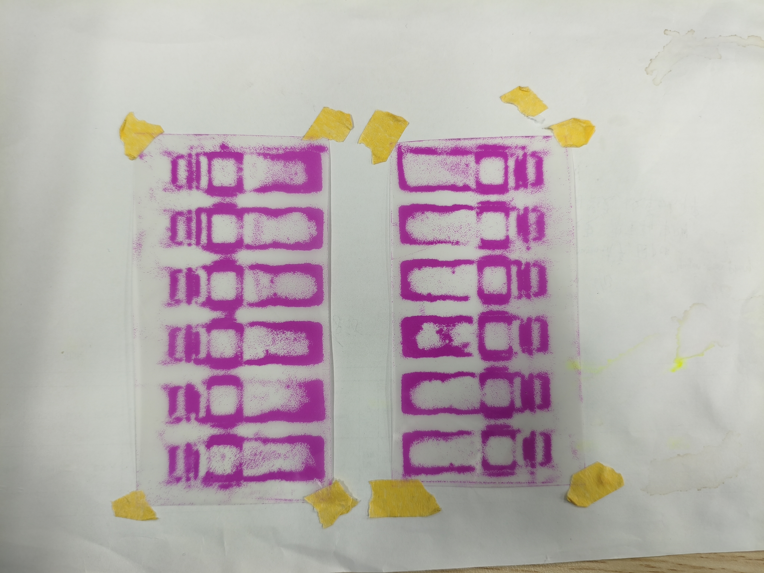
MVIMG_20251122_185242.jpg
