Cinthanh1998/Du-an-Foxconn/MVIMG_20251225_111700.jpg

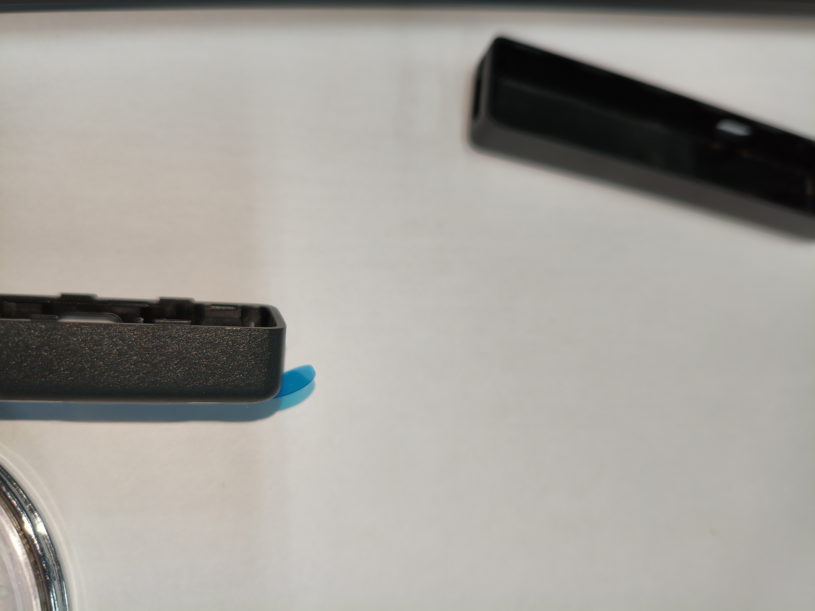
MVIMG_20251225_111700.jpg
