Cinthanh1998/Du-an-Foxconn/MVIMG_20251225_111917.jpg

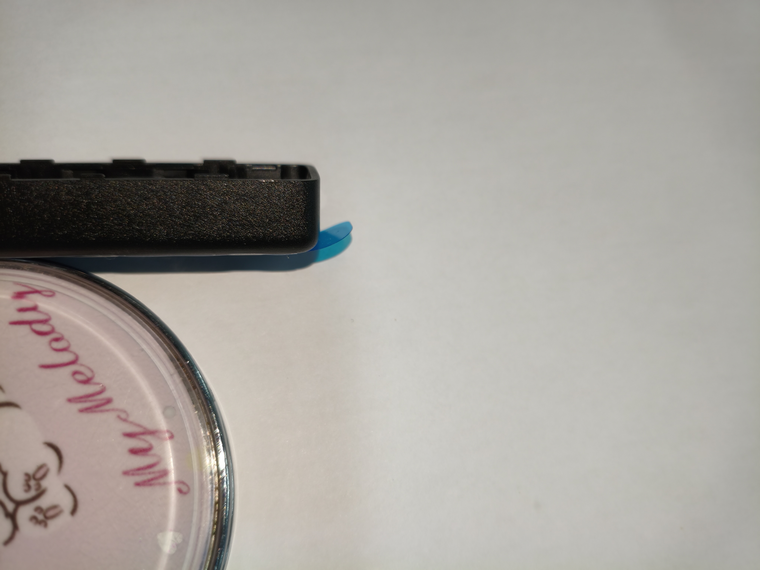
MVIMG_20251225_111917.jpg
