Cinthanh1998/Du-an-Foxconn/MVIMG_20251225_112015.jpg

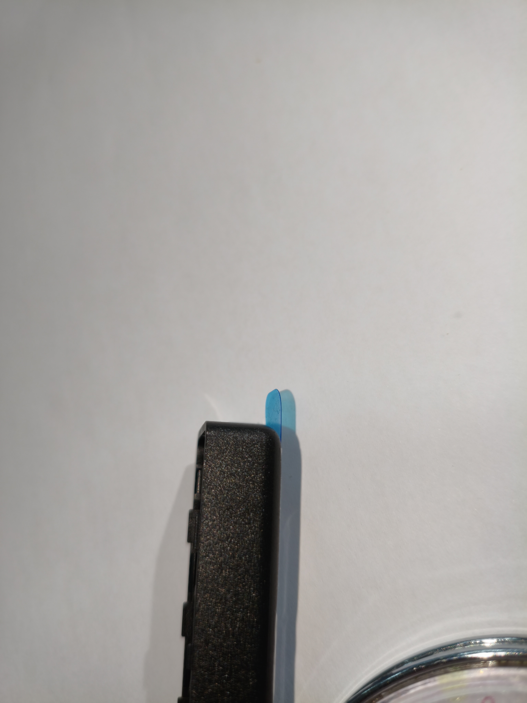
MVIMG_20251225_112015.jpg
