Cinthanh1998/Du-an-Foxconn/MVIMG_20260109_202111.jpg

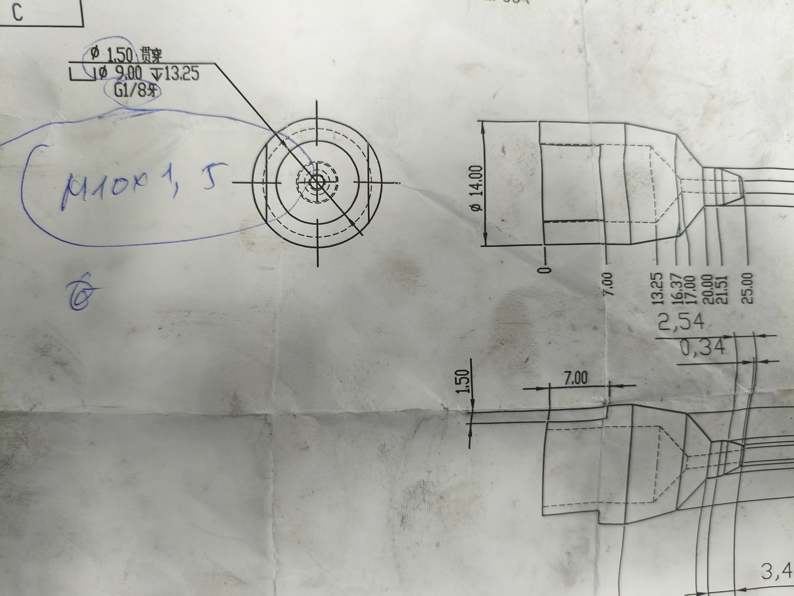
MVIMG_20260109_202111.jpg
