Cinthanh1998/Du-an-Foxconn/Screenshot_2026-09-08-08-31-04-742_com.tencent.mm.jpg

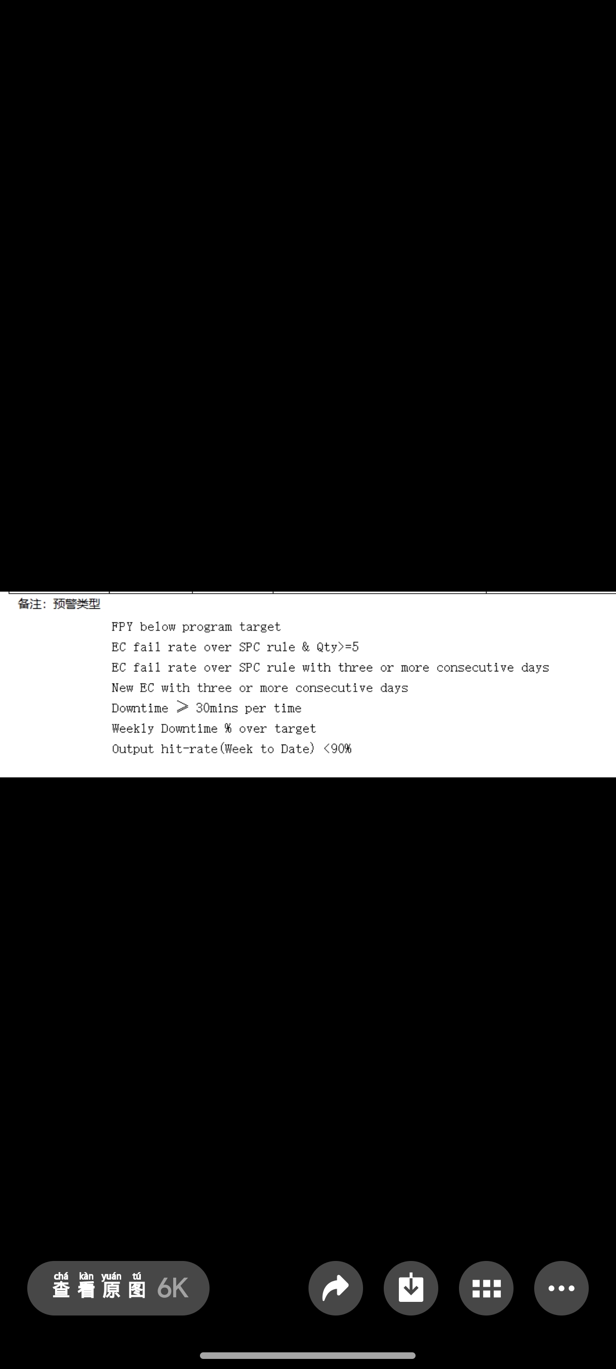
Screenshot_2026-09-08-08-31-04-742_com.tencent.mm.jpg
