Cinthanh1998/Du-an-Foxconn/Calypso manufacturing process healthy evaluation checklist (PVT) 20251001 Manual.xlsx

Sheet: 0 Cover Page
CEP U07 Manufacturing Process Healthy Evaluation Checklist
 | Project Name: | Calypso
Rev | Project Stage | Content | Date | Editor
V01 | PVT | Initial Release
 |  | Function | Name | Date
Prepared by: |  | PE
Reviewed by: |  | PQE
Approved by: |  | Director

Sheet: 1 Introduction
Introduction of Manufacturing Process Healthy Evaluation Checklist
1.0 Purpose
This checklist is used to do risk assessment and mitigation for CM’s wrong and missing part issue, which mean to avoid wrong and missing part issue escape to end user. CM shall complete this checklist to evaluate the risk and validate actions accordingly.
2.0 Scope and Requirement
2.1. This checklist should be applicable to all Amazon devices from HVT until End of Manufacturing.
2.2 CM should complete this checklist as an output at end of HVT, EVT, DVT phase.
2.3 CM should complete and approve this checklist before PVT as mandatory request.
2.4 This checklist should be updated while process changed and new SKU added which may cause risk variation.
3.0 Responsibility
Amzon STM shall managing CMs to implement risk assessment and mitigation though this checklist. And shall review and approve before PVT line qualification.
4.0 Content
4.1 Action Summary:
Missing and mixing risk level dashboard; High and middle risk items summary and action tracker.
4.2 Process Mapping and FMEA
The risk analysis and FMEA evaluation of material and process
4.3 Introduction of Process Mapping
The introduction of how to complete each item of "Process Mapping and FMEA"
4.4 Evaluation Standard
The evaluation guidance for Occurrence and Detection of Missing and Mixing.
4.5 Station Evaluation Checklist
The common guidance of station risk evaluation.

Sheet: 2 Dashboard & Action Summary
MPHE Result: |  |  |  | Low Risk
列標籤 | 計數 - Missing |  |  | 列標籤 | 計數 - Mixing
High Risk | 4 |  |  | High Risk | 1
Low Risk | 24 |  |  | Low Risk | 27
總計 | 28 |  |  | 總計 | 28
High& Middle Risk Items Action Tracking
Station # | Station Name | Material(P/N) or Process | Material Description or Process Description | Missing Risk Level | Mixing Risk Level | Action Plan | Missing Risk Level Updated | Mixing Risk Level Updated | market risk assessment | DRI | Due date | Status
1 | Stick back side EMI absorber to PCBA | 20-105301 | Stick back side EMI absorber to PCBA | 25 | 3 | Add CMC to scan borad and upload data to systems, Study to through POR process again | 5 | 3 | 1 | TE: Levey SI: Li Huan | 2025-10-30 | On-going
2 | Stick front side EMI absorber to PCBA | 50-101007 | Stick front side EMI absorber to PCBA | 25 | 3 | Add CMC to scan borad and upload data to systems, Study to through POR process again | 5 | 3 | 1 | TE: Levey SI: Li Huan | 2025-10-30 | On-going
3 | Stick conductive foam*2 and poron foam*1 to front side heatsink | 20-048944 20-105060 | Stick conductive foam*2 and poron foam*1 to front side heatsink | 25 | 3 | Add CMC to scan borad and upload data to systems, Study to through POR process again | 5 | 3 | 1 | TE: Levey SI: Li Huan | 2025-10-30 | On-going
4 | Pack Carton | Put device into carton | Pack devices into carton, then carton sealing, ensure the physical in carton are matched with DSN on carton label. | 5 | 15 | 1. Update pack carton time control 20-->10min in SFC system, and automatic timeout alarm by email. 2. After OP scan 12pcs gift boxes, then pack into carton asap, make sure no WIP in pack carton station.. | 5 | 5 | 1 | TE: Levey SI: Li Huan | 2025-10-25 | On-going
5 | Pack Pallet | 23-002810 | Pallet PAD | 15 | 3 | 1. Op mark on the pad to ensure pad qty after checked 2. FQA check the mark point every pallet 3. Add quantity management for Pallet PAD. Based on one pallet usage, SI OP prepare four pads one time. | 5 | 3 | 1 | ME: Francis IE: Lora SI: Li Huan | 2025-10-25 | On-going

Sheet: 3 Process Mapping and FMEA
 | Project: | Calypso | Risk Level | Category
 |  |  | High Risk | Missing -High Risk | 4
 | CM: | CNT |  | Mixing-High Risk | 1
 |  |  | Middle Risk | Missing-Middle Risk
 | Line#: | Assy/test/Pack |  | Mixing-Middle Risk
 | Station Information |  |  |  |  |  | Missing Prevention |  |  |  |  |  |  |  |  |  |  |  |  |  | Mixing Prevention |  |  |  |  |  |  |  |  |  |  |  | Risk Evaluation
 | Station # | Station Name | Material(P/N) or Process | Material Description or Process Description | Risk Category: (Mixing occurrence) | Assembly Method (Missing Occurrence) | Missing Summary | MES Scan? | MES Score | Phsyical Fit? | Phsyical Fit Score | AOI/CCD? | AOI/CCD Score | Functional Test? | Function Test Score | Weight | Weight Score | Manual or Other? | Other Score | Detect station | Mixing Summary | MES Scan? | MES Score | Phsyical Fit? | Phsyical Fit Score | AOI/CCD? | AOI/CCD Score | Functional Test? | Function Test Score | Manual or Other? | Other Score | Detect station | Missing Occurence(O1) | Missing Detection(D1) | Mixing Occurence(O2) | Mixing Detection(D2) | Missing Risk Level | Mixing Risk Level | Missing | Mixing
 | 1 | Stick back side copper foil to back housing and press | 20-105058 20-105053 | copper foil Housing | Common Part 1 | Semi-automatic assembly (such as manual loading then equipment assembly) 3 | No MES 5物理防呆，如漏装则下一工位不可组装或进行 1 Physical fool proof like if missed or mixed could not perfrom next process 1无AOI及CCD，或AOI及CCD无法有效拦截 5 No AOI and CCD or couldn't detect effectively 5功能检测无法拦截missing 5 Function test couldn't detect 5无称重，或称重无法有效拦截 5 No weighting or weighting could detect missing 5人工检测或无管控 5 Manual inspection or no control 5 | No MES 5 | 5 | 物理防呆，如漏装则下一工位不可组装或进行 1 Physical fool proof like if missed or mixed could not perfrom next process 1 | 1 | 无AOI及CCD，或AOI及CCD无法有效拦截 5 No AOI and CCD or couldn't detect effectively 5 | 5 | 功能检测无法拦截missing 5 Function test couldn't detect 5 | 5 | 无称重，或称重无法有效拦截 5 No weighting or weighting could detect missing 5 | 5 | 人工检测或无管控 5 Manual inspection or no control 5 | 5 | VI/kazam | 扫描外箱PN 3 out box PN scan 3无物理仿形措施 5 No physical fool proof 5无AOI及CCD，或AOI及CCD无法有效拦截 5 No AOI and CCD or couldn't detect effectively 5功能检测无法拦截Mixing 5 Function test couldn't detect 5人工检测或无管控 5 Manual inspection or no control 5 | 扫描外箱PN 3 out box PN scan 3 | 3 | 无物理仿形措施 5 No physical fool proof 5 | 5 | 无AOI及CCD，或AOI及CCD无法有效拦截 5 No AOI and CCD or couldn't detect effectively 5 | 5 | 功能检测无法拦截Mixing 5 Function test couldn't detect 5 | 5 | 人工检测或无管控 5 Manual inspection or no control 5 | 5 | 上線掃物料料號 | 3 | 1 | 1 | 3 | 3 | 3 | Low Risk | Low Risk
 | 2 | Stick front side copper foil to front housing and press | 20-105059 20-105049 | copper foil Housing | Common Part 1 | Semi-automatic assembly (such as manual loading then equipment assembly) 3 | No MES 5物理防呆，如漏装则下一工位不可组装或进行 1 Physical fool proof like if missed or mixed could not perfrom next process 1无AOI及CCD，或AOI及CCD无法有效拦截 5 No AOI and CCD or couldn't detect effectively 5功能检测无法拦截missing 5 Function test couldn't detect 5无称重，或称重无法有效拦截 5 No weighting or weighting could detect missing 5人工检测或无管控 5 Manual inspection or no control 5 | No MES 5 | 5 | 物理防呆，如漏装则下一工位不可组装或进行 1 Physical fool proof like if missed or mixed could not perfrom next process 1 | 1 | 无AOI及CCD，或AOI及CCD无法有效拦截 5 No AOI and CCD or couldn't detect effectively 5 | 5 | 功能检测无法拦截missing 5 Function test couldn't detect 5 | 5 | 无称重，或称重无法有效拦截 5 No weighting or weighting could detect missing 5 | 5 | 人工检测或无管控 5 Manual inspection or no control 5 | 5 | VI/kazam | 扫描外箱PN 3 out box PN scan 3无物理仿形措施 5 No physical fool proof 5无AOI及CCD，或AOI及CCD无法有效拦截 5 No AOI and CCD or couldn't detect effectively 5功能检测无法拦截Mixing 5 Function test couldn't detect 5人工检测或无管控 5 Manual inspection or no control 5 | 扫描外箱PN 3 out box PN scan 3 | 3 | 无物理仿形措施 5 No physical fool proof 5 | 5 | 无AOI及CCD，或AOI及CCD无法有效拦截 5 No AOI and CCD or couldn't detect effectively 5 | 5 | 功能检测无法拦截Mixing 5 Function test couldn't detect 5 | 5 | 人工检测或无管控 5 Manual inspection or no control 5 | 5 | Kazam/VI | 3 | 1 | 1 | 3 | 3 | 3 | Low Risk | Low Risk
 | 3 | Stick back side EMI absorber to PCBA | 20-105301 | EMI Absorber | Common Part 1 | Manual assembly no automation equipment 5 | No MES 5无物理仿形措施 5 No physical fool proof 5无AOI及CCD，或AOI及CCD无法有效拦截 5 No AOI and CCD or couldn't detect effectively 5功能检测无法拦截missing 5 Function test couldn't detect 5无称重，或称重无法有效拦截 5 No weighting or weighting could detect missing 5人工检测或无管控 5 Manual inspection or no control 5 | No MES 5 | 5 | 无物理仿形措施 5 No physical fool proof 5 | 5 | 无AOI及CCD，或AOI及CCD无法有效拦截 5 No AOI and CCD or couldn't detect effectively 5 | 5 | 功能检测无法拦截missing 5 Function test couldn't detect 5 | 5 | 无称重，或称重无法有效拦截 5 No weighting or weighting could detect missing 5 | 5 | 人工检测或无管控 5 Manual inspection or no control 5 | 5 | VI | 扫描外箱PN 3 out box PN scan 3无物理仿形措施 5 No physical fool proof 5无AOI及CCD，或AOI及CCD无法有效拦截 5 No AOI and CCD or couldn't detect effectively 5功能检测无法拦截Mixing 5 Function test couldn't detect 5人工检测或无管控 5 Manual inspection or no control 5 | 扫描外箱PN 3 out box PN scan 3 | 3 | 无物理仿形措施 5 No physical fool proof 5 | 5 | 无AOI及CCD，或AOI及CCD无法有效拦截 5 No AOI and CCD or couldn't detect effectively 5 | 5 | 功能检测无法拦截Mixing 5 Function test couldn't detect 5 | 5 | 人工检测或无管控 5 Manual inspection or no control 5 | 5 | VI | 5 | 5 | 1 | 3 | 25 | 3 | High Risk | Low Risk
 | 4 | Dispense back side thermal gel to PCBA | 19-000871 | THERMAL GEL | Operation Process 1 | Semi-automatic assembly (such as manual loading then equipment assembly) 3 | 后续扫描本体上的SN或PN 1 Scan single body SN or PN in following process 1无物理仿形措施 5 No physical fool proof 5无AOI及CCD，或AOI及CCD无法有效拦截 5 No AOI and CCD or couldn't detect effectively 5功能检测无法拦截missing 5 Function test couldn't detect 5无称重，或称重无法有效拦截 5 No weighting or weighting could detect missing 5人工检测或无管控 5 Manual inspection or no control 5 | 后续扫描本体上的SN或PN 1 Scan single body SN or PN in following process 1 | 1 | 无物理仿形措施 5 No physical fool proof 5 | 5 | 无AOI及CCD，或AOI及CCD无法有效拦截 5 No AOI and CCD or couldn't detect effectively 5 | 5 | 功能检测无法拦截missing 5 Function test couldn't detect 5 | 5 | 无称重，或称重无法有效拦截 5 No weighting or weighting could detect missing 5 | 5 | 人工检测或无管控 5 Manual inspection or no control 5 | 5 | VI | 扫描外箱PN 3 out box PN scan 3无物理仿形措施 5 No physical fool proof 5无AOI及CCD，或AOI及CCD无法有效拦截 5 No AOI and CCD or couldn't detect effectively 5功能检测无法拦截Mixing 5 Function test couldn't detect 5人工检测或无管控 5 Manual inspection or no control 5 | 扫描外箱PN 3 out box PN scan 3 | 3 | 无物理仿形措施 5 No physical fool proof 5 | 5 | 无AOI及CCD，或AOI及CCD无法有效拦截 5 No AOI and CCD or couldn't detect effectively 5 | 5 | 功能检测无法拦截Mixing 5 Function test couldn't detect 5 | 5 | 人工检测或无管控 5 Manual inspection or no control 5 | 5 | VI | 3 | 1 | 1 | 3 | 3 | 3 | Low Risk | Low Risk
 | 5 | Assemble the back side heatsink to the PCBA | 50-101007 | Heat Spreader | Common Part 1 | Semi-automatic assembly (such as manual loading then equipment assembly) 3 | 后续扫描本体上的SN或PN 1 Scan single body SN or PN in following process 1物理防呆，如漏装则下一工位不可组装或进行 1 Physical fool proof like if missed or mixed could not perfrom next process 1无AOI及CCD，或AOI及CCD无法有效拦截 5 No AOI and CCD or couldn't detect effectively 5功能测试可检missing且结果自动上传MES 1 Function test could detect missing and upload to MES automatically 1无称重，或称重无法有效拦截 5 No weighting or weighting could detect missing 5人工检测或无管控 5 Manual inspection or no control 5 | 后续扫描本体上的SN或PN 1 Scan single body SN or PN in following process 1 | 1 | 物理防呆，如漏装则下一工位不可组装或进行 1 Physical fool proof like if missed or mixed could not perfrom next process 1 | 1 | 无AOI及CCD，或AOI及CCD无法有效拦截 5 No AOI and CCD or couldn't detect effectively 5 | 5 | 功能测试可检missing且结果自动上传MES 1 Function test could detect missing and upload to MES automatically 1 | 1 | 无称重，或称重无法有效拦截 5 No weighting or weighting could detect missing 5 | 5 | 人工检测或无管控 5 Manual inspection or no control 5 | 5 | VI/kazam/SFC | 扫描外箱PN 3 out box PN scan 3物理防呆，如装错则下一工位不可组装或进行 1 Physical fool proof like if missed or mixed could not perfrom next process 1无AOI及CCD，或AOI及CCD无法有效拦截 5 No AOI and CCD or couldn't detect effectively 5功能检测无法拦截Mixing 5 Function test couldn't detect 5人工检测或无管控 5 Manual inspection or no control 5 | 扫描外箱PN 3 out box PN scan 3 | 3 | 物理防呆，如装错则下一工位不可组装或进行 1 Physical fool proof like if missed or mixed could not perfrom next process 1 | 1 | 无AOI及CCD，或AOI及CCD无法有效拦截 5 No AOI and CCD or couldn't detect effectively 5 | 5 | 功能检测无法拦截Mixing 5 Function test couldn't detect 5 | 5 | 人工检测或无管控 5 Manual inspection or no control 5 | 5 | FTS | 3 | 1 | 1 | 1 | 3 | 1 | Low Risk | Low Risk
 | 6 | Stick front side EMI absorber to PCBA | 20-048939 | EMI Absorber | Common Part 1 | Manual assembly no automation equipment 5 | No MES 5无物理仿形措施 5 No physical fool proof 5无AOI及CCD，或AOI及CCD无法有效拦截 5 No AOI and CCD or couldn't detect effectively 5功能检测无法拦截missing 5 Function test couldn't detect 5无称重，或称重无法有效拦截 5 No weighting or weighting could detect missing 5人工检测或无管控 5 Manual inspection or no control 5 | No MES 5 | 5 | 无物理仿形措施 5 No physical fool proof 5 | 5 | 无AOI及CCD，或AOI及CCD无法有效拦截 5 No AOI and CCD or couldn't detect effectively 5 | 5 | 功能检测无法拦截missing 5 Function test couldn't detect 5 | 5 | 无称重，或称重无法有效拦截 5 No weighting or weighting could detect missing 5 | 5 | 人工检测或无管控 5 Manual inspection or no control 5 | 5 | VI | 扫描外箱PN 3 out box PN scan 3无物理仿形措施 5 No physical fool proof 5无AOI及CCD，或AOI及CCD无法有效拦截 5 No AOI and CCD or couldn't detect effectively 5功能检测无法拦截Mixing 5 Function test couldn't detect 5人工检测或无管控 5 Manual inspection or no control 5 | 扫描外箱PN 3 out box PN scan 3 | 3 | 无物理仿形措施 5 No physical fool proof 5 | 5 | 无AOI及CCD，或AOI及CCD无法有效拦截 5 No AOI and CCD or couldn't detect effectively 5 | 5 | 功能检测无法拦截Mixing 5 Function test couldn't detect 5 | 5 | 人工检测或无管控 5 Manual inspection or no control 5 | 5 | VI | 5 | 5 | 1 | 3 | 25 | 3 | High Risk | Low Risk
 | 7 | Dispense front side thermal gel to PCBA | 19-000915 | THERMAL GEL | Operation Process 1 | Semi-automatic assembly (such as manual loading then equipment assembly) 3 | 后续扫描本体上的SN或PN 1 Scan single body SN or PN in following process 1无物理仿形措施 5 No physical fool proof 5无AOI及CCD，或AOI及CCD无法有效拦截 5 No AOI and CCD or couldn't detect effectively 5功能检测无法拦截missing 5 Function test couldn't detect 5无称重，或称重无法有效拦截 5 No weighting or weighting could detect missing 5人工检测或无管控 5 Manual inspection or no control 5 | 后续扫描本体上的SN或PN 1 Scan single body SN or PN in following process 1 | 1 | 无物理仿形措施 5 No physical fool proof 5 | 5 | 无AOI及CCD，或AOI及CCD无法有效拦截 5 No AOI and CCD or couldn't detect effectively 5 | 5 | 功能检测无法拦截missing 5 Function test couldn't detect 5 | 5 | 无称重，或称重无法有效拦截 5 No weighting or weighting could detect missing 5 | 5 | 人工检测或无管控 5 Manual inspection or no control 5 | 5 | VI | 扫描外箱PN 3 out box PN scan 3无物理仿形措施 5 No physical fool proof 5无AOI及CCD，或AOI及CCD无法有效拦截 5 No AOI and CCD or couldn't detect effectively 5功能检测无法拦截Mixing 5 Function test couldn't detect 5人工检测或无管控 5 Manual inspection or no control 5 | 扫描外箱PN 3 out box PN scan 3 | 3 | 无物理仿形措施 5 No physical fool proof 5 | 5 | 无AOI及CCD，或AOI及CCD无法有效拦截 5 No AOI and CCD or couldn't detect effectively 5 | 5 | 功能检测无法拦截Mixing 5 Function test couldn't detect 5 | 5 | 人工检测或无管控 5 Manual inspection or no control 5 | 5 | VI | 3 | 1 | 1 | 3 | 3 | 3 | Low Risk | Low Risk
 | 8 | Assemble the front side heatsink to the PCBA | 50-101006 | Heat spreader | Parameters Relate 1 | Semi-automatic assembly (such as manual loading then equipment assembly) 3 | 后续扫描本体上的SN或PN 1 Scan single body SN or PN in following process 1物理防呆，如漏装则下一工位不可组装或进行 1 Physical fool proof like if missed or mixed could not perfrom next process 1无AOI及CCD，或AOI及CCD无法有效拦截 5 No AOI and CCD or couldn't detect effectively 5功能测试可检missing且结果自动上传MES 1 Function test could detect missing and upload to MES automatically 1无称重，或称重无法有效拦截 5 No weighting or weighting could detect missing 5人工检测或无管控 5 Manual inspection or no control 5 | 后续扫描本体上的SN或PN 1 Scan single body SN or PN in following process 1 | 1 | 物理防呆，如漏装则下一工位不可组装或进行 1 Physical fool proof like if missed or mixed could not perfrom next process 1 | 1 | 无AOI及CCD，或AOI及CCD无法有效拦截 5 No AOI and CCD or couldn't detect effectively 5 | 5 | 功能测试可检missing且结果自动上传MES 1 Function test could detect missing and upload to MES automatically 1 | 1 | 无称重，或称重无法有效拦截 5 No weighting or weighting could detect missing 5 | 5 | 人工检测或无管控 5 Manual inspection or no control 5 | 5 | VI/kazam/SFC | 扫描外箱PN 3 out box PN scan 3物理防呆，如装错则下一工位不可组装或进行 1 Physical fool proof like if missed or mixed could not perfrom next process 1无AOI及CCD，或AOI及CCD无法有效拦截 5 No AOI and CCD or couldn't detect effectively 5功能检测无法拦截Mixing 5 Function test couldn't detect 5人工检测或无管控 5 Manual inspection or no control 5 | 扫描外箱PN 3 out box PN scan 3 | 3 | 物理防呆，如装错则下一工位不可组装或进行 1 Physical fool proof like if missed or mixed could not perfrom next process 1 | 1 | 无AOI及CCD，或AOI及CCD无法有效拦截 5 No AOI and CCD or couldn't detect effectively 5 | 5 | 功能检测无法拦截Mixing 5 Function test couldn't detect 5 | 5 | 人工检测或无管控 5 Manual inspection or no control 5 | 5 | FTS | 3 | 1 | 1 | 1 | 3 | 1 | Low Risk | Low Risk
 | 9 | Stick conductive foam*2 and poron foam*1 to front side heatsink | 20-048944 20-105060 | Conductive Foam | Operation Process 1 | Manual assembly no automation equipment 5 | No MES 5无物理仿形措施 5 No physical fool proof 5无AOI及CCD，或AOI及CCD无法有效拦截 5 No AOI and CCD or couldn't detect effectively 5功能检测无法拦截missing 5 Function test couldn't detect 5无称重，或称重无法有效拦截 5 No weighting or weighting could detect missing 5人工检测或无管控 5 Manual inspection or no control 5 | No MES 5 | 5 | 无物理仿形措施 5 No physical fool proof 5 | 5 | 无AOI及CCD，或AOI及CCD无法有效拦截 5 No AOI and CCD or couldn't detect effectively 5 | 5 | 功能检测无法拦截missing 5 Function test couldn't detect 5 | 5 | 无称重，或称重无法有效拦截 5 No weighting or weighting could detect missing 5 | 5 | 人工检测或无管控 5 Manual inspection or no control 5 | 5 | VI | 扫描外箱PN 3 out box PN scan 3无物理仿形措施 5 No physical fool proof 5无AOI及CCD，或AOI及CCD无法有效拦截 5 No AOI and CCD or couldn't detect effectively 5功能检测无法拦截Mixing 5 Function test couldn't detect 5人工检测或无管控 5 Manual inspection or no control 5 | 扫描外箱PN 3 out box PN scan 3 | 3 | 无物理仿形措施 5 No physical fool proof 5 | 5 | 无AOI及CCD，或AOI及CCD无法有效拦截 5 No AOI and CCD or couldn't detect effectively 5 | 5 | 功能检测无法拦截Mixing 5 Function test couldn't detect 5 | 5 | 人工检测或无管控 5 Manual inspection or no control 5 | 5 | VI | 5 | 5 | 1 | 3 | 25 | 3 | High Risk | Low Risk
 | 10 | Laser DSN to HDMI connector | 16-100198 | HDMI Connector | Operation Process 1 | Semi-automatic assembly (such as manual loading then equipment assembly) 3 | 设备内自动扫描单体SN或PN 1 Scan single body SN or PN in equipment automatically 1物理防呆，如漏装则下一工位不可组装或进行 1 Physical fool proof like if missed or mixed could not perfrom next process 1AOI及CCD进行检查并直接与MES相连接，如不符合几乎不可能流出 1 AOI and CCD inspection and link with MES automatically 1功能测试可检missing且结果自动上传MES 1 Function test could detect missing and upload to MES automatically 1无称重，或称重无法有效拦截 5 No weighting or weighting could detect missing 5人工检测或无管控 5 Manual inspection or no control 5 | 设备内自动扫描单体SN或PN 1 Scan single body SN or PN in equipment automatically 1 | 1 | 物理防呆，如漏装则下一工位不可组装或进行 1 Physical fool proof like if missed or mixed could not perfrom next process 1 | 1 | AOI及CCD进行检查并直接与MES相连接，如不符合几乎不可能流出 1 AOI and CCD inspection and link with MES automatically 1 | 1 | 功能测试可检missing且结果自动上传MES 1 Function test could detect missing and upload to MES automatically 1 | 1 | 无称重，或称重无法有效拦截 5 No weighting or weighting could detect missing 5 | 5 | 人工检测或无管控 5 Manual inspection or no control 5 | 5 | Laser DSN | 设备自动扫单体SN或PN 1 Scan single body SN or PN in equipment automatically 1无物理仿形措施 5 No physical fool proof 5AOI及CCD进行检查并直接与MES相连接，如不符合几乎不可能流出 1 AOI and CCD inspection and link with MES automatically 1功能检测无法拦截Mixing 5 Function test couldn't detect 5人工检测或无管控 5 Manual inspection or no control 5 | 设备自动扫单体SN或PN 1 Scan single body SN or PN in equipment automatically 1 | 1 | 无物理仿形措施 5 No physical fool proof 5 | 5 | AOI及CCD进行检查并直接与MES相连接，如不符合几乎不可能流出 1 AOI and CCD inspection and link with MES automatically 1 | 1 | 功能检测无法拦截Mixing 5 Function test couldn't detect 5 | 5 | 人工检测或无管控 5 Manual inspection or no control 5 | 5 | Laser DSN | 3 | 1 | 1 | 1 | 3 | 1 | Low Risk | Low Risk
 | 11 | Put PCBA into back housing | 31-101122 20-105049 | PCBA housing | Common Part 1 | Semi-automatic assembly (such as manual loading then equipment assembly) 3 | 后续扫描本体上的SN或PN 1 Scan single body SN or PN in following process 1物理防呆，如漏装则下一工位不可组装或进行 1 Physical fool proof like if missed or mixed could not perfrom next process 1无AOI及CCD，或AOI及CCD无法有效拦截 5 No AOI and CCD or couldn't detect effectively 5功能测试可检missing且结果自动上传MES 1 Function test could detect missing and upload to MES automatically 1无称重，或称重无法有效拦截 5 No weighting or weighting could detect missing 5人工检测或无管控 5 Manual inspection or no control 5 | 后续扫描本体上的SN或PN 1 Scan single body SN or PN in following process 1 | 1 | 物理防呆，如漏装则下一工位不可组装或进行 1 Physical fool proof like if missed or mixed could not perfrom next process 1 | 1 | 无AOI及CCD，或AOI及CCD无法有效拦截 5 No AOI and CCD or couldn't detect effectively 5 | 5 | 功能测试可检missing且结果自动上传MES 1 Function test could detect missing and upload to MES automatically 1 | 1 | 无称重，或称重无法有效拦截 5 No weighting or weighting could detect missing 5 | 5 | 人工检测或无管控 5 Manual inspection or no control 5 | 5 | VI/Kazam/SFC | 当工序手动扫单体或单体包装上的SN或PN 3 Scan single SN or PN on body or packing mannually in staion 3使用仿形治具进行组装-仅针对Mixing 3 Use shape similar fix to assemble 3无AOI及CCD，或AOI及CCD无法有效拦截 5 No AOI and CCD or couldn't detect effectively 5功能检测无法拦截Mixing 5 Function test couldn't detect 5人工检测或无管控 5 Manual inspection or no control 5 | 当工序手动扫单体或单体包装上的SN或PN 3 Scan single SN or PN on body or packing mannually in staion 3 | 3 | 使用仿形治具进行组装-仅针对Mixing 3 Use shape similar fix to assemble 3 | 3 | 无AOI及CCD，或AOI及CCD无法有效拦截 5 No AOI and CCD or couldn't detect effectively 5 | 5 | 功能检测无法拦截Mixing 5 Function test couldn't detect 5 | 5 | 人工检测或无管控 5 Manual inspection or no control 5 | 5 | VI/Kazam/SFC | 3 | 1 | 1 | 3 | 3 | 3 | Low Risk | Low Risk
 | 12 | Assemble front housing to back housing | 20-105049 20-105053 | Front housing Back housing | Common Part 1 | Semi-automatic assembly (such as manual loading then equipment assembly) 3 | 后续扫描本体上的SN或PN 1 Scan single body SN or PN in following process 1物理防呆，如漏装则下一工位不可组装或进行 1 Physical fool proof like if missed or mixed could not perfrom next process 1无AOI及CCD，或AOI及CCD无法有效拦截 5 No AOI and CCD or couldn't detect effectively 5功能测试可检missing且结果自动上传MES 1 Function test could detect missing and upload to MES automatically 1无称重，或称重无法有效拦截 5 No weighting or weighting could detect missing 5人工检测或无管控 5 Manual inspection or no control 5 | 后续扫描本体上的SN或PN 1 Scan single body SN or PN in following process 1 | 1 | 物理防呆，如漏装则下一工位不可组装或进行 1 Physical fool proof like if missed or mixed could not perfrom next process 1 | 1 | 无AOI及CCD，或AOI及CCD无法有效拦截 5 No AOI and CCD or couldn't detect effectively 5 | 5 | 功能测试可检missing且结果自动上传MES 1 Function test could detect missing and upload to MES automatically 1 | 1 | 无称重，或称重无法有效拦截 5 No weighting or weighting could detect missing 5 | 5 | 人工检测或无管控 5 Manual inspection or no control 5 | 5 | VI/Kazam/SFC | 当工序手动扫单体或单体包装上的SN或PN 3 Scan single SN or PN on body or packing mannually in staion 3使用仿形治具进行组装-仅针对Mixing 3 Use shape similar fix to assemble 3无AOI及CCD，或AOI及CCD无法有效拦截 5 No AOI and CCD or couldn't detect effectively 5功能测试可检Mixing且结果自动上传MES 1 Function test could detect mixing and upload to MES automatically 1人工检测或无管控 5 Manual inspection or no control 5 | 当工序手动扫单体或单体包装上的SN或PN 3 Scan single SN or PN on body or packing mannually in staion 3 | 3 | 使用仿形治具进行组装-仅针对Mixing 3 Use shape similar fix to assemble 3 | 3 | 无AOI及CCD，或AOI及CCD无法有效拦截 5 No AOI and CCD or couldn't detect effectively 5 | 5 | 功能测试可检Mixing且结果自动上传MES 1 Function test could detect mixing and upload to MES automatically 1 | 1 | 人工检测或无管控 5 Manual inspection or no control 5 | 5 | VI/Kazam/SFC | 3 | 1 | 1 | 1 | 3 | 1 | Low Risk | Low Risk
 | 13 | Cosmetic3 | - | NA | Operation Process 1 | Manual assembly no automation equipment 5 | 后续扫描本体上的SN或PN 1 Scan single body SN or PN in following process 1无物理仿形措施 5 No physical fool proof 5无AOI及CCD，或AOI及CCD无法有效拦截 5 No AOI and CCD or couldn't detect effectively 5功能检测无法拦截missing 5 Function test couldn't detect 5无称重，或称重无法有效拦截 5 No weighting or weighting could detect missing 5人工检测或无管控 5 Manual inspection or no control 5 | 后续扫描本体上的SN或PN 1 Scan single body SN or PN in following process 1 | 1 | 无物理仿形措施 5 No physical fool proof 5 | 5 | 无AOI及CCD，或AOI及CCD无法有效拦截 5 No AOI and CCD or couldn't detect effectively 5 | 5 | 功能检测无法拦截missing 5 Function test couldn't detect 5 | 5 | 无称重，或称重无法有效拦截 5 No weighting or weighting could detect missing 5 | 5 | 人工检测或无管控 5 Manual inspection or no control 5 | 5 | VI | 当工序手动扫单体或单体包装上的SN或PN 3 Scan single SN or PN on body or packing mannually in staion 3无物理仿形措施 5 No physical fool proof 5无AOI及CCD，或AOI及CCD无法有效拦截 5 No AOI and CCD or couldn't detect effectively 5功能检测无法拦截Mixing 5 Function test couldn't detect 5人工检测或无管控 5 Manual inspection or no control 5 | 当工序手动扫单体或单体包装上的SN或PN 3 Scan single SN or PN on body or packing mannually in staion 3 | 3 | 无物理仿形措施 5 No physical fool proof 5 | 5 | 无AOI及CCD，或AOI及CCD无法有效拦截 5 No AOI and CCD or couldn't detect effectively 5 | 5 | 功能检测无法拦截Mixing 5 Function test couldn't detect 5 | 5 | 人工检测或无管控 5 Manual inspection or no control 5 | 5 | VI | 5 | 1 | 1 | 3 | 5 | 3 | Low Risk | Low Risk
 | 14 | FTS | Test | 掃碼後Kazam測試 | Operation Process 1 | Semi-automatic assembly (such as manual loading then equipment assembly) 3 | 设备内自动扫描单体SN或PN 1 Scan single body SN or PN in equipment automatically 1物理防呆，如漏装则下一工位不可组装或进行 1 Physical fool proof like if missed or mixed could not perfrom next process 1无AOI及CCD，或AOI及CCD无法有效拦截 5 No AOI and CCD or couldn't detect effectively 5功能测试可检missing且结果自动上传MES 1 Function test could detect missing and upload to MES automatically 1无称重，或称重无法有效拦截 5 No weighting or weighting could detect missing 5理论上防呆的管控方法，几乎不可能流出 1 Fool-proof action 1 | 设备内自动扫描单体SN或PN 1 Scan single body SN or PN in equipment automatically 1 | 1 | 物理防呆，如漏装则下一工位不可组装或进行 1 Physical fool proof like if missed or mixed could not perfrom next process 1 | 1 | 无AOI及CCD，或AOI及CCD无法有效拦截 5 No AOI and CCD or couldn't detect effectively 5 | 5 | 功能测试可检missing且结果自动上传MES 1 Function test could detect missing and upload to MES automatically 1 | 1 | 无称重，或称重无法有效拦截 5 No weighting or weighting could detect missing 5 | 5 | 理论上防呆的管控方法，几乎不可能流出 1 Fool-proof action 1 | 1 | FPS | 设备自动扫单体SN或PN 1 Scan single body SN or PN in equipment automatically 1物理防呆，如装错则下一工位不可组装或进行 1 Physical fool proof like if missed or mixed could not perfrom next process 1无AOI及CCD，或AOI及CCD无法有效拦截 5 No AOI and CCD or couldn't detect effectively 5功能测试可检Mixing且结果自动上传MES 1 Function test could detect mixing and upload to MES automatically 1理论上防呆的管控方法，几乎不可能流出 1 Fool-proof action 1 | 设备自动扫单体SN或PN 1 Scan single body SN or PN in equipment automatically 1 | 1 | 物理防呆，如装错则下一工位不可组装或进行 1 Physical fool proof like if missed or mixed could not perfrom next process 1 | 1 | 无AOI及CCD，或AOI及CCD无法有效拦截 5 No AOI and CCD or couldn't detect effectively 5 | 5 | 功能测试可检Mixing且结果自动上传MES 1 Function test could detect mixing and upload to MES automatically 1 | 1 | 理论上防呆的管控方法，几乎不可能流出 1 Fool-proof action 1 | 1 | FPS | 3 | 1 | 1 | 1 | 3 | 1 | Low Risk | Low Risk
 | 15 | FPS | Test | 掃Tray 盤碼後Kazam測試 | Operation Process 1 | Semi-automatic assembly (such as manual loading then equipment assembly) 3 | 设备内自动扫描单体SN或PN 1 Scan single body SN or PN in equipment automatically 1物理防呆，如漏装则下一工位不可组装或进行 1 Physical fool proof like if missed or mixed could not perfrom next process 1无AOI及CCD，或AOI及CCD无法有效拦截 5 No AOI and CCD or couldn't detect effectively 5功能测试可检missing且结果自动上传MES 1 Function test could detect missing and upload to MES automatically 1无称重，或称重无法有效拦截 5 No weighting or weighting could detect missing 5理论上防呆的管控方法，几乎不可能流出 1 Fool-proof action 1 | 设备内自动扫描单体SN或PN 1 Scan single body SN or PN in equipment automatically 1 | 1 | 物理防呆，如漏装则下一工位不可组装或进行 1 Physical fool proof like if missed or mixed could not perfrom next process 1 | 1 | 无AOI及CCD，或AOI及CCD无法有效拦截 5 No AOI and CCD or couldn't detect effectively 5 | 5 | 功能测试可检missing且结果自动上传MES 1 Function test could detect missing and upload to MES automatically 1 | 1 | 无称重，或称重无法有效拦截 5 No weighting or weighting could detect missing 5 | 5 | 理论上防呆的管控方法，几乎不可能流出 1 Fool-proof action 1 | 1 | VI | 设备自动扫单体SN或PN 1 Scan single body SN or PN in equipment automatically 1物理防呆，如装错则下一工位不可组装或进行 1 Physical fool proof like if missed or mixed could not perfrom next process 1无AOI及CCD，或AOI及CCD无法有效拦截 5 No AOI and CCD or couldn't detect effectively 5功能测试可检Mixing且结果自动上传MES 1 Function test could detect mixing and upload to MES automatically 1理论上防呆的管控方法，几乎不可能流出 1 Fool-proof action 1 | 设备自动扫单体SN或PN 1 Scan single body SN or PN in equipment automatically 1 | 1 | 物理防呆，如装错则下一工位不可组装或进行 1 Physical fool proof like if missed or mixed could not perfrom next process 1 | 1 | 无AOI及CCD，或AOI及CCD无法有效拦截 5 No AOI and CCD or couldn't detect effectively 5 | 5 | 功能测试可检Mixing且结果自动上传MES 1 Function test could detect mixing and upload to MES automatically 1 | 1 | 理论上防呆的管控方法，几乎不可能流出 1 Fool-proof action 1 | 1 | VI | 3 | 1 | 1 | 1 | 3 | 1 | Low Risk | Low Risk
 | 16 | OBA Pre-Seal (Function) | Pre-seal OBA | Test | Operation Process 1 | Manual assembly no automation equipment 5 | 当工序手动扫描单体或单体包装上的SN或PN 3 Scan single SN or PN on body or packing mannually in staion 3物理防呆，如漏装则下一工位不可组装或进行 1 Physical fool proof like if missed or mixed could not perfrom next process 1AOI及CCD可以侦测但未Link MES，如操作失误有小概率流出 3 AOI and CCD inspection but not link with MES 3功能测试可检missing且结果自动上传MES 1 Function test could detect missing and upload to MES automatically 1称重可检出遗漏并与MES自动连接1 Weighting could detect missing and link with MES automatically 1理论上防呆的管控方法，几乎不可能流出 1 Fool-proof action 1 | 当工序手动扫描单体或单体包装上的SN或PN 3 Scan single SN or PN on body or packing mannually in staion 3 | 3 | 物理防呆，如漏装则下一工位不可组装或进行 1 Physical fool proof like if missed or mixed could not perfrom next process 1 | 1 | AOI及CCD可以侦测但未Link MES，如操作失误有小概率流出 3 AOI and CCD inspection but not link with MES 3 | 3 | 功能测试可检missing且结果自动上传MES 1 Function test could detect missing and upload to MES automatically 1 | 1 | 称重可检出遗漏并与MES自动连接1 Weighting could detect missing and link with MES automatically 1 | 1 | 理论上防呆的管控方法，几乎不可能流出 1 Fool-proof action 1 | 1 | VI | 设备自动扫单体SN或PN 1 Scan single body SN or PN in equipment automatically 1物理防呆，如装错则下一工位不可组装或进行 1 Physical fool proof like if missed or mixed could not perfrom next process 1无AOI及CCD，或AOI及CCD无法有效拦截 5 No AOI and CCD or couldn't detect effectively 5功能测试可检Mixing且结果自动上传MES 1 Function test could detect mixing and upload to MES automatically 1理论上防呆的管控方法，几乎不可能流出 1 Fool-proof action 1 | 设备自动扫单体SN或PN 1 Scan single body SN or PN in equipment automatically 1 | 1 | 物理防呆，如装错则下一工位不可组装或进行 1 Physical fool proof like if missed or mixed could not perfrom next process 1 | 1 | 无AOI及CCD，或AOI及CCD无法有效拦截 5 No AOI and CCD or couldn't detect effectively 5 | 5 | 功能测试可检Mixing且结果自动上传MES 1 Function test could detect mixing and upload to MES automatically 1 | 1 | 理论上防呆的管控方法，几乎不可能流出 1 Fool-proof action 1 | 1 | VI | 5 | 1 | 1 | 1 | 5 | 1 | Low Risk | Low Risk
 | 17 | VI2 | CCD | Auto detect device position | Operation Process 1 | Semi-automatic assembly (such as manual loading then equipment assembly) 3 | 设备内自动扫描单体SN或PN 1 Scan single body SN or PN in equipment automatically 1物理防呆，如漏装则下一工位不可组装或进行 1 Physical fool proof like if missed or mixed could not perfrom next process 1AOI及CCD进行检查并直接与MES相连接，如不符合几乎不可能流出 1 AOI and CCD inspection and link with MES automatically 1功能检测无法拦截missing 5 Function test couldn't detect 5无称重，或称重无法有效拦截 5 No weighting or weighting could detect missing 5理论上防呆的管控方法，几乎不可能流出 1 Fool-proof action 1 | 设备内自动扫描单体SN或PN 1 Scan single body SN or PN in equipment automatically 1 | 1 | 物理防呆，如漏装则下一工位不可组装或进行 1 Physical fool proof like if missed or mixed could not perfrom next process 1 | 1 | AOI及CCD进行检查并直接与MES相连接，如不符合几乎不可能流出 1 AOI and CCD inspection and link with MES automatically 1 | 1 | 功能检测无法拦截missing 5 Function test couldn't detect 5 | 5 | 无称重，或称重无法有效拦截 5 No weighting or weighting could detect missing 5 | 5 | 理论上防呆的管控方法，几乎不可能流出 1 Fool-proof action 1 | 1 | VI | 设备自动扫单体SN或PN 1 Scan single body SN or PN in equipment automatically 1物理防呆，如装错则下一工位不可组装或进行 1 Physical fool proof like if missed or mixed could not perfrom next process 1AOI及CCD进行检查并直接与MES相连接，如不符合几乎不可能流出 1 AOI and CCD inspection and link with MES automatically 1功能检测无法拦截Mixing 5 Function test couldn't detect 5理论上防呆的管控方法，几乎不可能流出 1 Fool-proof action 1 | 后续扫本体SN或PN 1 Scan single body SN or PN in following process 1 | 1 | 物理防呆，如装错则下一工位不可组装或进行 1 Physical fool proof like if missed or mixed could not perfrom next process 1 | 1 | AOI及CCD进行检查并直接与MES相连接，如不符合几乎不可能流出 1 AOI and CCD inspection and link with MES automatically 1 | 1 | 功能检测无法拦截Mixing 5 Function test couldn't detect 5 | 5 | 可以有效检出，但有小几率误操作流出 3 Detect effectively but have wrong operation possibility 3 | 3 | VI | 3 | 1 | 1 | 1 | 3 | 1 | Low Risk | Low Risk
 | 18 | Pack box | 52-100667 | Device | SKU or Similar Parts in Same Station 5 | Manual assembly no automation equipment 5 | 后续扫描本体上的SN或PN 1 Scan single body SN or PN in following process 1物理防呆，如漏装则下一工位不可组装或进行 1 Physical fool proof like if missed or mixed could not perfrom next process 1AOI及CCD进行检查并直接与MES相连接，如不符合几乎不可能流出 1 AOI and CCD inspection and link with MES automatically 1功能检测无法拦截missing 5 Function test couldn't detect 5称重可检出遗漏并与MES自动连接1 Weighting could detect missing and link with MES automatically 1理论上防呆的管控方法，几乎不可能流出 1 Fool-proof action 1 | 后续扫描本体上的SN或PN 1 Scan single body SN or PN in following process 1 | 1 | 无物理仿形措施 5 No physical fool proof 5 | 5 | 无AOI及CCD，或AOI及CCD无法有效拦截 5 No AOI and CCD or couldn't detect effectively 5 | 5 | 功能检测无法拦截missing 5 Function test couldn't detect 5 | 5 | 称重可检出遗漏并与MES自动连接1 Weighting could detect missing and link with MES automatically 1 | 1 | 理论上防呆的管控方法，几乎不可能流出 1 Fool-proof action 1 | 1 | Box | 后续扫本体SN或PN 1 Scan single body SN or PN in following process 1物理防呆，如装错则下一工位不可组装或进行 1 Physical fool proof like if missed or mixed could not perfrom next process 1无AOI及CCD，或AOI及CCD无法有效拦截 5 No AOI and CCD or couldn't detect effectively 5功能检测无法拦截Mixing 5 Function test couldn't detect 5理论上防呆的管控方法，几乎不可能流出 1 Fool-proof action 1 | 当工序手动扫单体或单体包装上的SN或PN 3 Scan single SN or PN on body or packing mannually in staion 3 | 3 | 使用仿形治具进行组装-仅针对Mixing 3 Use shape similar fix to assemble 3 | 3 | 无AOI及CCD，或AOI及CCD无法有效拦截 5 No AOI and CCD or couldn't detect effectively 5 | 5 | 功能检测无法拦截Mixing 5 Function test couldn't detect 5 | 5 | 理论上防呆的管控方法，几乎不可能流出 1 Fool-proof action 1 | 1 | Box IV | 5 | 1 | 5 | 1 | 5 | 5 | Low Risk | Low Risk
s |  |  | 21-004613 | POD label | Common Part 1 | Manual assembly no automation equipment 5 | 当工序手动扫描单体或单体包装上的SN或PN 3 Scan single SN or PN on body or packing mannually in staion 3物理防呆，如漏装则下一工位不可组装或进行 1 Physical fool proof like if missed or mixed could not perfrom next process 1无AOI及CCD，或AOI及CCD无法有效拦截 5 No AOI and CCD or couldn't detect effectively 5功能检测无法拦截missing 5 Function test couldn't detect 5无称重，或称重无法有效拦截 5 No weighting or weighting could detect missing 5理论上防呆的管控方法，几乎不可能流出 1 Fool-proof action 1 | 当工序手动扫描单体或单体包装上的SN或PN 3 Scan single SN or PN on body or packing mannually in staion 3 | 3 | 无物理仿形措施 5 No physical fool proof 5 | 5 | 无AOI及CCD，或AOI及CCD无法有效拦截 5 No AOI and CCD or couldn't detect effectively 5 | 5 | 功能检测无法拦截missing 5 Function test couldn't detect 5 | 5 | 无称重，或称重无法有效拦截 5 No weighting or weighting could detect missing 5 | 5 | 理论上防呆的管控方法，几乎不可能流出 1 Fool-proof action 1 | 1 | Box IV | 当工序手动扫单体或单体包装上的SN或PN 3 Scan single SN or PN on body or packing mannually in staion 3物理防呆，如装错则下一工位不可组装或进行 1 Physical fool proof like if missed or mixed could not perfrom next process 1无AOI及CCD，或AOI及CCD无法有效拦截 5 No AOI and CCD or couldn't detect effectively 5功能检测无法拦截Mixing 5 Function test couldn't detect 5理论上防呆的管控方法，几乎不可能流出 1 Fool-proof action 1 | 当工序手动扫单体或单体包装上的SN或PN 3 Scan single SN or PN on body or packing mannually in staion 3 | 3 | 无物理仿形措施 5 No physical fool proof 5 | 5 | 无AOI及CCD，或AOI及CCD无法有效拦截 5 No AOI and CCD or couldn't detect effectively 5 | 5 | 功能检测无法拦截Mixing 5 Function test couldn't detect 5 | 5 | 理论上防呆的管控方法，几乎不可能流出 1 Fool-proof action 1 | 1 | Box IV | 5 | 1 | 1 | 1 | 5 | 1 | Low Risk | Low Risk
 | 19 | Pack box II | 58-000098 | Battery | Common Part 1 | Manual assembly no automation equipment 5 | No MES 5物理防呆，如漏装则下一工位不可组装或进行 1 Physical fool proof like if missed or mixed could not perfrom next process 1无AOI及CCD，或AOI及CCD无法有效拦截 5 No AOI and CCD or couldn't detect effectively 5功能检测无法拦截missing 5 Function test couldn't detect 5称重可检出遗漏并与MES自动连接1 Weighting could detect missing and link with MES automatically 1理论上防呆的管控方法，几乎不可能流出 1 Fool-proof action 1 | No MES 5 | 5 | 物理防呆，如漏装则下一工位不可组装或进行 1 Physical fool proof like if missed or mixed could not perfrom next process 1 | 1 | 无AOI及CCD，或AOI及CCD无法有效拦截 5 No AOI and CCD or couldn't detect effectively 5 | 5 | 功能检测无法拦截missing 5 Function test couldn't detect 5 | 5 | 称重可检出遗漏并与MES自动连接1 Weighting could detect missing and link with MES automatically 1 | 1 | 理论上防呆的管控方法，几乎不可能流出 1 Fool-proof action 1 | 1 | Weight | 当工序手动扫单体或单体包装上的SN或PN 3 Scan single SN or PN on body or packing mannually in staion 3无物理仿形措施 5 No physical fool proof 5无AOI及CCD，或AOI及CCD无法有效拦截 5 No AOI and CCD or couldn't detect effectively 5功能检测无法拦截Mixing 5 Function test couldn't detect 5理论上防呆的管控方法，几乎不可能流出 1 Fool-proof action 1 | 当工序手动扫单体或单体包装上的SN或PN 3 Scan single SN or PN on body or packing mannually in staion 3 | 3 | 无物理仿形措施 5 No physical fool proof 5 | 5 | 无AOI及CCD，或AOI及CCD无法有效拦截 5 No AOI and CCD or couldn't detect effectively 5 | 5 | 功能检测无法拦截Mixing 5 Function test couldn't detect 5 | 5 | 理论上防呆的管控方法，几乎不可能流出 1 Fool-proof action 1 | 1 | Box V | 5 | 1 | 1 | 1 | 5 | 1 | Low Risk | Low Risk
 |  |  | 55-100633 | USB cable | Common Part 1 | Manual assembly no automation equipment 5 | 当工序手动扫描单体或单体包装上的SN或PN 3 Scan single SN or PN on body or packing mannually in staion 3物理防呆，如漏装则下一工位不可组装或进行 1 Physical fool proof like if missed or mixed could not perfrom next process 1AOI及CCD进行检查并直接与MES相连接，如不符合几乎不可能流出 1 AOI and CCD inspection and link with MES automatically 1功能检测无法拦截missing 5 Function test couldn't detect 5称重可检出遗漏并与MES自动连接1 Weighting could detect missing and link with MES automatically 1理论上防呆的管控方法，几乎不可能流出 1 Fool-proof action 1 | 当工序手动扫描单体或单体包装上的SN或PN 3 Scan single SN or PN on body or packing mannually in staion 3 | 3 | 无物理仿形措施 5 No physical fool proof 5 | 5 | 无AOI及CCD，或AOI及CCD无法有效拦截 5 No AOI and CCD or couldn't detect effectively 5 | 5 | 功能检测无法拦截missing 5 Function test couldn't detect 5 | 5 | 称重可检出遗漏并与MES自动连接1 Weighting could detect missing and link with MES automatically 1 | 1 | 理论上防呆的管控方法，几乎不可能流出 1 Fool-proof action 1 | 1 | Weight | 后续扫本体SN或PN 1 Scan single body SN or PN in following process 1无物理仿形措施 5 No physical fool proof 5无AOI及CCD，或AOI及CCD无法有效拦截 5 No AOI and CCD or couldn't detect effectively 5功能检测无法拦截Mixing 5 Function test couldn't detect 5理论上防呆的管控方法，几乎不可能流出 1 Fool-proof action 1 | 当工序手动扫单体或单体包装上的SN或PN 3 Scan single SN or PN on body or packing mannually in staion 3 | 3 | 使用仿形治具进行组装-仅针对Mixing 3 Use shape similar fix to assemble 3 | 3 | 无AOI及CCD，或AOI及CCD无法有效拦截 5 No AOI and CCD or couldn't detect effectively 5 | 5 | 功能检测无法拦截Mixing 5 Function test couldn't detect 5 | 5 | 理论上防呆的管控方法，几乎不可能流出 1 Fool-proof action 1 | 1 | Box V | 5 | 1 | 1 | 1 | 5 | 1 | Low Risk | Low Risk
 |  | Pack Box III | 52-100613-C | Remote | Common Part 1 | Manual assembly no automation equipment 5 | 当工序手动扫描单体或单体包装上的SN或PN 3 Scan single SN or PN on body or packing mannually in staion 3物理防呆，如漏装则下一工位不可组装或进行 1 Physical fool proof like if missed or mixed could not perfrom next process 1AOI及CCD进行检查并直接与MES相连接，如不符合几乎不可能流出 1 AOI and CCD inspection and link with MES automatically 1功能检测无法拦截missing 5 Function test couldn't detect 5称重可检出遗漏并与MES自动连接1 Weighting could detect missing and link with MES automatically 1理论上防呆的管控方法，几乎不可能流出 1 Fool-proof action 1 | 当工序手动扫描单体或单体包装上的SN或PN 3 Scan single SN or PN on body or packing mannually in staion 3 | 3 | 物理防呆，如漏装则下一工位不可组装或进行 1 Physical fool proof like if missed or mixed could not perfrom next process 1 | 1 | AOI及CCD进行检查并直接与MES相连接，如不符合几乎不可能流出 1 AOI and CCD inspection and link with MES automatically 1 | 1 | 功能检测无法拦截missing 5 Function test couldn't detect 5 | 5 | 称重可检出遗漏并与MES自动连接1 Weighting could detect missing and link with MES automatically 1 | 1 | 人工检测或无管控 5 Manual inspection or no control 5 | 5 | Weight | 后续扫本体SN或PN 1 Scan single body SN or PN in following process 1无物理仿形措施 5 No physical fool proof 5无AOI及CCD，或AOI及CCD无法有效拦截 5 No AOI and CCD or couldn't detect effectively 5功能检测无法拦截Mixing 5 Function test couldn't detect 5理论上防呆的管控方法，几乎不可能流出 1 Fool-proof action 1 | 后续扫本体SN或PN 1 Scan single body SN or PN in following process 1 | 1 | 无物理仿形措施 5 No physical fool proof 5 | 5 | 无AOI及CCD，或AOI及CCD无法有效拦截 5 No AOI and CCD or couldn't detect effectively 5 | 5 | 功能检测无法拦截Mixing 5 Function test couldn't detect 5 | 5 | 理论上防呆的管控方法，几乎不可能流出 1 Fool-proof action 1 | 1 | Box II | 5 | 1 | 1 | 1 | 5 | 1 | Low Risk | Low Risk
 | 20 | Pack Box IV | 22-100250 | QSG | SKU or Similar Parts in Same Station 5 | Manual assembly no automation equipment 5 | 当工序手动扫描单体或单体包装上的SN或PN 3 Scan single SN or PN on body or packing mannually in staion 3无物理仿形措施 5 No physical fool proof 5AOI及CCD进行检查并直接与MES相连接，如不符合几乎不可能流出 1 AOI and CCD inspection and link with MES automatically 1功能检测无法拦截missing 5 Function test couldn't detect 5称重可检出遗漏并与MES自动连接1 Weighting could detect missing and link with MES automatically 1理论上防呆的管控方法，几乎不可能流出 1 Fool-proof action 1 | 设备内自动扫描单体SN或PN 1 Scan single body SN or PN in equipment automatically 1 | 1 | 无物理仿形措施 5 No physical fool proof 5 | 5 | 无AOI及CCD，或AOI及CCD无法有效拦截 5 No AOI and CCD or couldn't detect effectively 5 | 5 | 功能检测无法拦截missing 5 Function test couldn't detect 5 | 5 | 无称重，或称重无法有效拦截 5 No weighting or weighting could detect missing 5 | 5 | 人工检测或无管控 5 Manual inspection or no control 5 | 5 | Box V | 当工序手动扫单体或单体包装上的SN或PN 3 Scan single SN or PN on body or packing mannually in staion 3无物理仿形措施 5 No physical fool proof 5无AOI及CCD，或AOI及CCD无法有效拦截 5 No AOI and CCD or couldn't detect effectively 5功能检测无法拦截Mixing 5 Function test couldn't detect 5理论上防呆的管控方法，几乎不可能流出 1 Fool-proof action 1 | 当工序手动扫单体或单体包装上的SN或PN 3 Scan single SN or PN on body or packing mannually in staion 3 | 3 | 无物理仿形措施 5 No physical fool proof 5 | 5 | 无AOI及CCD，或AOI及CCD无法有效拦截 5 No AOI and CCD or couldn't detect effectively 5 | 5 | 功能检测无法拦截Mixing 5 Function test couldn't detect 5 | 5 | 理论上防呆的管控方法，几乎不可能流出 1 Fool-proof action 1 | 1 | Box I | 5 | 1 | 5 | 1 | 5 | 5 | Low Risk | Low Risk
 |  |  | 22-100251 | WSL | SKU or Similar Parts in Same Station 5 | Manual assembly no automation equipment 5 | 当工序手动扫描单体或单体包装上的SN或PN 3 Scan single SN or PN on body or packing mannually in staion 3无物理仿形措施 5 No physical fool proof 5AOI及CCD进行检查并直接与MES相连接，如不符合几乎不可能流出 1 AOI and CCD inspection and link with MES automatically 1功能检测无法拦截missing 5 Function test couldn't detect 5称重可检出遗漏并与MES自动连接1 Weighting could detect missing and link with MES automatically 1理论上防呆的管控方法，几乎不可能流出 1 Fool-proof action 1 | 设备内自动扫描单体SN或PN 1 Scan single body SN or PN in equipment automatically 1 | 1 | 无物理仿形措施 5 No physical fool proof 5 | 5 | 无AOI及CCD，或AOI及CCD无法有效拦截 5 No AOI and CCD or couldn't detect effectively 5 | 5 | 功能检测无法拦截missing 5 Function test couldn't detect 5 | 5 | 无称重，或称重无法有效拦截 5 No weighting or weighting could detect missing 5 | 5 | 人工检测或无管控 5 Manual inspection or no control 5 | 5 | Box V | 当工序手动扫单体或单体包装上的SN或PN 3 Scan single SN or PN on body or packing mannually in staion 3无物理仿形措施 5 No physical fool proof 5无AOI及CCD，或AOI及CCD无法有效拦截 5 No AOI and CCD or couldn't detect effectively 5功能检测无法拦截Mixing 5 Function test couldn't detect 5理论上防呆的管控方法，几乎不可能流出 1 Fool-proof action 1 | 当工序手动扫单体或单体包装上的SN或PN 3 Scan single SN or PN on body or packing mannually in staion 3 | 3 | 无物理仿形措施 5 No physical fool proof 5 | 5 | 无AOI及CCD，或AOI及CCD无法有效拦截 5 No AOI and CCD or couldn't detect effectively 5 | 5 | 功能检测无法拦截Mixing 5 Function test couldn't detect 5 | 5 | 理论上防呆的管控方法，几乎不可能流出 1 Fool-proof action 1 | 1 | Box I | 5 | 1 | 5 | 1 | 5 | 5 | Low Risk | Low Risk
 | 22 | OBA | Accessories cosmetic check | Cosmetic Inpsection | Operation Process 1 | Manual assembly no automation equipment 5 | 当工序手动扫描单体或单体包装上的SN或PN 3 Scan single SN or PN on body or packing mannually in staion 3物理防呆，如漏装则下一工位不可组装或进行 1 Physical fool proof like if missed or mixed could not perfrom next process 1AOI及CCD可以侦测但未Link MES，如操作失误有小概率流出 3 AOI and CCD inspection but not link with MES 3功能测试可检missing且结果自动上传MES 1 Function test could detect missing and upload to MES automatically 1称重可检出遗漏并与MES自动连接1 Weighting could detect missing and link with MES automatically 1理论上防呆的管控方法，几乎不可能流出 1 Fool-proof action 1 | 当工序手动扫描单体或单体包装上的SN或PN 3 Scan single SN or PN on body or packing mannually in staion 3 | 3 | 物理防呆，如漏装则下一工位不可组装或进行 1 Physical fool proof like if missed or mixed could not perfrom next process 1 | 1 | AOI及CCD可以侦测但未Link MES，如操作失误有小概率流出 3 AOI and CCD inspection but not link with MES 3 | 3 | 功能测试可检missing且结果自动上传MES 1 Function test could detect missing and upload to MES automatically 1 | 1 | 称重可检出遗漏并与MES自动连接1 Weighting could detect missing and link with MES automatically 1 | 1 | 理论上防呆的管控方法，几乎不可能流出 1 Fool-proof action 1 | 1 | Pack carton | 当工序手动扫单体或单体包装上的SN或PN 3 Scan single SN or PN on body or packing mannually in staion 3物理防呆，如装错则下一工位不可组装或进行 1 Physical fool proof like if missed or mixed could not perfrom next process 1AOI及CCD进行检查并直接与MES相连接，如不符合几乎不可能流出 1 AOI and CCD inspection and link with MES automatically 1功能测试可检Mixing且结果自动上传MES 1 Function test could detect mixing and upload to MES automatically 1理论上防呆的管控方法，几乎不可能流出 1 Fool-proof action 1Pack carton | 当工序手动扫单体或单体包装上的SN或PN 3 Scan single SN or PN on body or packing mannually in staion 3 | 3 | 物理防呆，如装错则下一工位不可组装或进行 1 Physical fool proof like if missed or mixed could not perfrom next process 1 | 1 | AOI及CCD进行检查并直接与MES相连接，如不符合几乎不可能流出 1 AOI and CCD inspection and link with MES automatically 1 | 1 | 功能测试可检Mixing且结果自动上传MES 1 Function test could detect mixing and upload to MES automatically 1 | 1 | 理论上防呆的管控方法，几乎不可能流出 1 Fool-proof action 1 | 1 | Pack carton | 5 | 1 | 1 | 1 | 5 | 1 | Low Risk | Low Risk
 | 23 | Stick seal label | 21-004509 | Seal label | Common Part 1 | Manual assembly no automation equipment 5 | No MES 5无物理仿形措施 5 No physical fool proof 5无AOI及CCD，或AOI及CCD无法有效拦截 5 No AOI and CCD or couldn't detect effectively 5功能检测无法拦截missing 5 Function test couldn't detect 5无称重，或称重无法有效拦截 5 No weighting or weighting could detect missing 5理论上防呆的管控方法，几乎不可能流出 1 Fool-proof action 1 | No MES 5 | 5 | 无物理仿形措施 5 No physical fool proof 5 | 5 | 无AOI及CCD，或AOI及CCD无法有效拦截 5 No AOI and CCD or couldn't detect effectively 5 | 5 | 功能检测无法拦截missing 5 Function test couldn't detect 5 | 5 | 无称重，或称重无法有效拦截 5 No weighting or weighting could detect missing 5 | 5 | 理论上防呆的管控方法，几乎不可能流出 1 Fool-proof action 1 | 1 | CHK_SEAL LABEL | No MES 5无物理仿形措施 5 No physical fool proof 5无AOI及CCD，或AOI及CCD无法有效拦截 5 No AOI and CCD or couldn't detect effectively 5功能检测无法拦截Mixing 5 Function test couldn't detect 5理论上防呆的管控方法，几乎不可能流出 1 Fool-proof action 1Pack carton | 扫描外箱PN 3 out box PN scan 3 | 3 | 无物理仿形措施 5 No physical fool proof 5 | 5 | 无AOI及CCD，或AOI及CCD无法有效拦截 5 No AOI and CCD or couldn't detect effectively 5 | 5 | 功能检测无法拦截Mixing 5 Function test couldn't detect 5 | 5 | 理论上防呆的管控方法，几乎不可能流出 1 Fool-proof action 1 | 1 |  | 5 | 1 | 1 | 1 | 5 | 1 | Low Risk | Low Risk
 | 24 | Check, Wipe seal label, scan POD | - | Check, Wipe seal label | Common Part 1 | Manual assembly no automation equipment 5 | No MES 5无物理仿形措施 5 No physical fool proof 5无AOI及CCD，或AOI及CCD无法有效拦截 5 No AOI and CCD or couldn't detect effectively 5功能检测无法拦截missing 5 Function test couldn't detect 5无称重，或称重无法有效拦截 5 No weighting or weighting could detect missing 5理论上防呆的管控方法，几乎不可能流出 1 Fool-proof action 1 | No MES 5 | 5 | 无物理仿形措施 5 No physical fool proof 5 | 5 | 无AOI及CCD，或AOI及CCD无法有效拦截 5 No AOI and CCD or couldn't detect effectively 5 | 5 | 功能检测无法拦截missing 5 Function test couldn't detect 5 | 5 | 无称重，或称重无法有效拦截 5 No weighting or weighting could detect missing 5 | 5 | 理论上防呆的管控方法，几乎不可能流出 1 Fool-proof action 1 | 1 | CHK_SEAL LABEL | No MES 5无物理仿形措施 5 No physical fool proof 5无AOI及CCD，或AOI及CCD无法有效拦截 5 No AOI and CCD or couldn't detect effectively 5功能检测无法拦截Mixing 5 Function test couldn't detect 5理论上防呆的管控方法，几乎不可能流出 1 Fool-proof action 1Pack carton | 设备自动扫单体SN或PN 1 Scan single body SN or PN in equipment automatically 1 | 1 | 无物理仿形措施 5 No physical fool proof 5 | 5 | 无AOI及CCD，或AOI及CCD无法有效拦截 5 No AOI and CCD or couldn't detect effectively 5 | 5 | 功能检测无法拦截Mixing 5 Function test couldn't detect 5 | 5 | 理论上防呆的管控方法，几乎不可能流出 1 Fool-proof action 1 | 1 |  | 5 | 1 | 1 | 1 | 5 | 1 | Low Risk | Low Risk
 |  |  | - | Scan POD | SKU or Similar Parts in Same Station 5 | Manual assembly no automation equipment 5 | No MES 5无物理仿形措施 5 No physical fool proof 5无AOI及CCD，或AOI及CCD无法有效拦截 5 No AOI and CCD or couldn't detect effectively 5功能检测无法拦截missing 5 Function test couldn't detect 5无称重，或称重无法有效拦截 5 No weighting or weighting could detect missing 5理论上防呆的管控方法，几乎不可能流出 1 Fool-proof action 1 | 设备内自动扫描单体SN或PN 1 Scan single body SN or PN in equipment automatically 1 | 1 | 无物理仿形措施 5 No physical fool proof 5 | 5 | 无AOI及CCD，或AOI及CCD无法有效拦截 5 No AOI and CCD or couldn't detect effectively 5 | 5 | 功能检测无法拦截missing 5 Function test couldn't detect 5 | 5 | 无称重，或称重无法有效拦截 5 No weighting or weighting could detect missing 5 | 5 | 人工检测或无管控 5 Manual inspection or no control 5 | 5 | CHK_SEAL LABEL | No MES 5无物理仿形措施 5 No physical fool proof 5无AOI及CCD，或AOI及CCD无法有效拦截 5 No AOI and CCD or couldn't detect effectively 5功能检测无法拦截Mixing 5 Function test couldn't detect 5理论上防呆的管控方法，几乎不可能流出 1 Fool-proof action 1Pack carton | 后续扫本体SN或PN 1 Scan single body SN or PN in following process 1 | 1 | 无物理仿形措施 5 No physical fool proof 5 | 5 | 无AOI及CCD，或AOI及CCD无法有效拦截 5 No AOI and CCD or couldn't detect effectively 5 | 5 | 功能检测无法拦截Mixing 5 Function test couldn't detect 5 | 5 | 理论上防呆的管控方法，几乎不可能流出 1 Fool-proof action 1 | 1 |  | 5 | 1 | 5 | 1 | 5 | 5 | Low Risk | Low Risk
 | 25 | Pack CTN | 23-008238 | Master carton | SKU or Similar Parts in Same Station 5 | Manual assembly no automation equipment 5 | 当工序手动扫描单体或单体包装上的SN或PN 3 Scan single SN or PN on body or packing mannually in staion 3物理防呆，如漏装则下一工位不可组装或进行 1 Physical fool proof like if missed or mixed could not perfrom next process 1无AOI及CCD，或AOI及CCD无法有效拦截 5 No AOI and CCD or couldn't detect effectively 5功能检测无法拦截missing 5 Function test couldn't detect 5无称重，或称重无法有效拦截 5 No weighting or weighting could detect missing 5理论上防呆的管控方法，几乎不可能流出 1 Fool-proof action 1 | 当工序手动扫描单体或单体包装上的SN或PN 3 Scan single SN or PN on body or packing mannually in staion 3 | 3 | 物理防呆，如漏装则下一工位不可组装或进行 1 Physical fool proof like if missed or mixed could not perfrom next process 1 | 1 | 无AOI及CCD，或AOI及CCD无法有效拦截 5 No AOI and CCD or couldn't detect effectively 5 | 5 | 功能检测无法拦截missing 5 Function test couldn't detect 5 | 5 | 无称重，或称重无法有效拦截 5 No weighting or weighting could detect missing 5 | 5 | 理论上防呆的管控方法，几乎不可能流出 1 Fool-proof action 1 | 1 | Pack carton | 当工序手动扫单体或单体包装上的SN或PN 3 Scan single SN or PN on body or packing mannually in staion 3无物理仿形措施 5 No physical fool proof 5无AOI及CCD，或AOI及CCD无法有效拦截 5 No AOI and CCD or couldn't detect effectively 5功能检测无法拦截Mixing 5 Function test couldn't detect 5理论上防呆的管控方法，几乎不可能流出 1 Fool-proof action 1Pack carton | 当工序手动扫单体或单体包装上的SN或PN 3 Scan single SN or PN on body or packing mannually in staion 3 | 3 | 无物理仿形措施 5 No physical fool proof 5 | 5 | 无AOI及CCD，或AOI及CCD无法有效拦截 5 No AOI and CCD or couldn't detect effectively 5 | 5 | 功能检测无法拦截Mixing 5 Function test couldn't detect 5 | 5 | 可以有效检出，但有小几率误操作流出 3 Detect effectively but have wrong operation possibility 3 | 3 | Pack carton | 5 | 1 | 5 | 3 | 5 | 15 | Low Risk | High Risk
 |  |  | Pack carton | 將產品裝入carton | Operation Process 5 | Manual assembly no automation equipment 5 | No MES 5无物理仿形措施 5 No physical fool proof 5无AOI及CCD，或AOI及CCD无法有效拦截 5 No AOI and CCD or couldn't detect effectively 5功能检测无法拦截missing 5 Function test couldn't detect 5无称重，或称重无法有效拦截 5 No weighting or weighting could detect missing 5理论上防呆的管控方法，几乎不可能流出 1 Fool-proof action 1 | No MES 5 | 5 | 无物理仿形措施 5 No physical fool proof 5 | 5 | 无AOI及CCD，或AOI及CCD无法有效拦截 5 No AOI and CCD or couldn't detect effectively 5 | 5 | 功能检测无法拦截missing 5 Function test couldn't detect 5 | 5 | 无称重，或称重无法有效拦截 5 No weighting or weighting could detect missing 5 | 5 | 理论上防呆的管控方法，几乎不可能流出 1 Fool-proof action 1 | 1 |  | No MES 5物理防呆，如装错则下一工位不可组装或进行 1 Physical fool proof like if missed or mixed could not perfrom next process 1无AOI及CCD，或AOI及CCD无法有效拦截 5 No AOI and CCD or couldn't detect effectively 5功能检测无法拦截Mixing 5 Function test couldn't detect 5可以有效检出，但有小几率误操作流出 3 Detect effectively but have wrong operation possibility 3 | No MES 5 | 5 | 物理防呆，如装错则下一工位不可组装或进行 1 Physical fool proof like if missed or mixed could not perfrom next process 1 | 1 | 无AOI及CCD，或AOI及CCD无法有效拦截 5 No AOI and CCD or couldn't detect effectively 5 | 5 | 功能检测无法拦截Mixing 5 Function test couldn't detect 5 | 5 | 可以有效检出，但有小几率误操作流出 3 Detect effectively but have wrong operation possibility 3 | 3 |  | 5 | 1 | 5 | 1 | 5 | 5 | Low Risk | Low Risk
 | 26 | Pack pallet | 210-1161-00 | Pallet label | Operation Process 1 | Manual assembly no automation equipment 5 | 当工序手动扫描单体或单体包装上的SN或PN 3 Scan single SN or PN on body or packing mannually in staion 3无物理仿形措施 5 No physical fool proof 5AOI及CCD进行检查并直接与MES相连接，如不符合几乎不可能流出 1 AOI and CCD inspection and link with MES automatically 1功能测试可检missing且结果自动上传MES 1 Function test could detect missing and upload to MES automatically 1无称重，或称重无法有效拦截 5 No weighting or weighting could detect missing 5理论上防呆的管控方法，几乎不可能流出 1 Fool-proof action 1 | 当工序手动扫描单体或单体包装上的SN或PN 3 Scan single SN or PN on body or packing mannually in staion 3 | 3 | 无物理仿形措施 5 No physical fool proof 5 | 5 | AOI及CCD进行检查并直接与MES相连接，如不符合几乎不可能流出 1 AOI and CCD inspection and link with MES automatically 1 | 1 | 功能测试可检missing且结果自动上传MES 1 Function test could detect missing and upload to MES automatically 1 | 1 | 无称重，或称重无法有效拦截 5 No weighting or weighting could detect missing 5 | 5 | 理论上防呆的管控方法，几乎不可能流出 1 Fool-proof action 1 | 1 | 成品入庫掃描 | 当工序手动扫单体或单体包装上的SN或PN 3 Scan single SN or PN on body or packing mannually in staion 3无物理仿形措施 5 No physical fool proof 5AOI及CCD进行检查并直接与MES相连接，如不符合几乎不可能流出 1 AOI and CCD inspection and link with MES automatically 1功能测试可检Mixing且结果自动上传MES 1 Function test could detect mixing and upload to MES automatically 1理论上防呆的管控方法，几乎不可能流出 1 Fool-proof action 1成品入庫掃描 | 当工序手动扫单体或单体包装上的SN或PN 3 Scan single SN or PN on body or packing mannually in staion 3 | 3 | 无物理仿形措施 5 No physical fool proof 5 | 5 | AOI及CCD进行检查并直接与MES相连接，如不符合几乎不可能流出 1 AOI and CCD inspection and link with MES automatically 1 | 1 | 功能测试可检Mixing且结果自动上传MES 1 Function test could detect mixing and upload to MES automatically 1 | 1 | 理论上防呆的管控方法，几乎不可能流出 1 Fool-proof action 1 | 1 | 成品入庫掃描 | 5 | 1 | 1 | 1 | 5 | 1 | Low Risk | Low Risk
 |  |  | 23-000165 | Foam pallet | Operation Process 1 | Manual assembly no automation equipment 5 | No MES 5物理防呆，如漏装则下一工位不可组装或进行 1 Physical fool proof like if missed or mixed could not perfrom next process 1AOI及CCD进行检查并直接与MES相连接，如不符合几乎不可能流出 1 AOI and CCD inspection and link with MES automatically 1功能检测无法拦截missing 5 Function test couldn't detect 5称重可检出遗漏并与MES自动连接1 Weighting could detect missing and link with MES automatically 1理论上防呆的管控方法，几乎不可能流出 1 Fool-proof action 1 | No MES 5 | 5 | 物理防呆，如漏装则下一工位不可组装或进行 1 Physical fool proof like if missed or mixed could not perfrom next process 1 | 1 | AOI及CCD进行检查并直接与MES相连接，如不符合几乎不可能流出 1 AOI and CCD inspection and link with MES automatically 1 | 1 | 功能检测无法拦截missing 5 Function test couldn't detect 5 | 5 | 称重可检出遗漏并与MES自动连接1 Weighting could detect missing and link with MES automatically 1 | 1 | 理论上防呆的管控方法，几乎不可能流出 1 Fool-proof action 1 | 1 | 成品入庫稱重 | No MES 5无物理仿形措施 5 No physical fool proof 5AOI及CCD进行检查并直接与MES相连接，如不符合几乎不可能流出 1 AOI and CCD inspection and link with MES automatically 1功能检测无法拦截Mixing 5 Function test couldn't detect 5理论上防呆的管控方法，几乎不可能流出 1 Fool-proof action 1成品入庫稱重 | No MES 5 | 5 | 无物理仿形措施 5 No physical fool proof 5 | 5 | AOI及CCD进行检查并直接与MES相连接，如不符合几乎不可能流出 1 AOI and CCD inspection and link with MES automatically 1 | 1 | 功能检测无法拦截Mixing 5 Function test couldn't detect 5 | 5 | 理论上防呆的管控方法，几乎不可能流出 1 Fool-proof action 1 | 1 | 成品入庫稱重 | 5 | 1 | 1 | 1 | 5 | 1 | Low Risk | Low Risk
 |  |  | 24-102544 | Wood pallet | Operation Process 1 | Manual assembly no automation equipment 5 | No MES 5物理防呆，如漏装则下一工位不可组装或进行 1 Physical fool proof like if missed or mixed could not perfrom next process 1AOI及CCD进行检查并直接与MES相连接，如不符合几乎不可能流出 1 AOI and CCD inspection and link with MES automatically 1功能检测无法拦截missing 5 Function test couldn't detect 5称重可检出遗漏并与MES自动连接1 Weighting could detect missing and link with MES automatically 1理论上防呆的管控方法，几乎不可能流出 1 Fool-proof action 1 | No MES 5 | 5 | 物理防呆，如漏装则下一工位不可组装或进行 1 Physical fool proof like if missed or mixed could not perfrom next process 1 | 1 | AOI及CCD进行检查并直接与MES相连接，如不符合几乎不可能流出 1 AOI and CCD inspection and link with MES automatically 1 | 1 | 功能检测无法拦截missing 5 Function test couldn't detect 5 | 5 | 称重可检出遗漏并与MES自动连接1 Weighting could detect missing and link with MES automatically 1 | 1 | 理论上防呆的管控方法，几乎不可能流出 1 Fool-proof action 1 | 1 | 成品入庫稱重 | No MES 5无物理仿形措施 5 No physical fool proof 5AOI及CCD进行检查并直接与MES相连接，如不符合几乎不可能流出 1 AOI and CCD inspection and link with MES automatically 1功能检测无法拦截Mixing 5 Function test couldn't detect 5理论上防呆的管控方法，几乎不可能流出 1 Fool-proof action 1成品入庫稱重 | No MES 5 | 5 | 无物理仿形措施 5 No physical fool proof 5 | 5 | AOI及CCD进行检查并直接与MES相连接，如不符合几乎不可能流出 1 AOI and CCD inspection and link with MES automatically 1 | 1 | 功能检测无法拦截Mixing 5 Function test couldn't detect 5 | 5 | 理论上防呆的管控方法，几乎不可能流出 1 Fool-proof action 1 | 1 | 成品入庫稱重 | 5 | 1 | 1 | 1 | 5 | 1 | Low Risk | Low Risk
 |  |  | 23-002810 | Pallet PAD | Common Part 1 | Manual assembly no automation equipment 5 | No MES 5物理防呆，如漏装则下一工位不可组装或进行 1 Physical fool proof like if missed or mixed could not perfrom next process 1无AOI及CCD，或AOI及CCD无法有效拦截 5 No AOI and CCD or couldn't detect effectively 5功能检测无法拦截missing 5 Function test couldn't detect 5无称重，或称重无法有效拦截 5 No weighting or weighting could detect missing 5可以有效检出，但有小几率误操作流出 3 Detect effectively but have wrong operation possibility 3 | No MES 5 | 5 | 无物理仿形措施 5 No physical fool proof 5 | 5 | 无AOI及CCD，或AOI及CCD无法有效拦截 5 No AOI and CCD or couldn't detect effectively 5 | 5 | 功能检测无法拦截missing 5 Function test couldn't detect 5 | 5 | 无称重，或称重无法有效拦截 5 No weighting or weighting could detect missing 5 | 5 | 可以有效检出，但有小几率误操作流出 3 Detect effectively but have wrong operation possibility 3 | 3 |  | No MES 5无物理仿形措施 5 No physical fool proof 5无AOI及CCD，或AOI及CCD无法有效拦截 5 No AOI and CCD or couldn't detect effectively 5功能检测无法拦截Mixing 5 Function test couldn't detect 5可以有效检出，但有小几率误操作流出 3 Detect effectively but have wrong operation possibility 3 | No MES 5 | 5 | 无物理仿形措施 5 No physical fool proof 5 | 5 | 无AOI及CCD，或AOI及CCD无法有效拦截 5 No AOI and CCD or couldn't detect effectively 5 | 5 | 功能检测无法拦截Mixing 5 Function test couldn't detect 5 | 5 | 可以有效检出，但有小几率误操作流出 3 Detect effectively but have wrong operation possibility 3 | 3 |  | 5 | 3 | 1 | 3 | 15 | 3 | High Risk | Low Risk
 | 27 | Stock in | Shipping | Shipping | Operation Process 1 | Manual assembly no automation equipment 5 | 当工序手动扫描单体或单体包装上的SN或PN 3 Scan single SN or PN on body or packing mannually in staion 3物理防呆，如漏装则下一工位不可组装或进行 1 Physical fool proof like if missed or mixed could not perfrom next process 1AOI及CCD进行检查并直接与MES相连接，如不符合几乎不可能流出 1 AOI and CCD inspection and link with MES automatically 1功能测试可检missing且结果自动上传MES 1 Function test could detect missing and upload to MES automatically 1称重可检出遗漏并与MES自动连接1 Weighting could detect missing and link with MES automatically 1理论上防呆的管控方法，几乎不可能流出 1 Fool-proof action 1 | 当工序手动扫描单体或单体包装上的SN或PN 3 Scan single SN or PN on body or packing mannually in staion 3 | 3 | 物理防呆，如漏装则下一工位不可组装或进行 1 Physical fool proof like if missed or mixed could not perfrom next process 1 | 1 | AOI及CCD进行检查并直接与MES相连接，如不符合几乎不可能流出 1 AOI and CCD inspection and link with MES automatically 1 | 1 | 功能测试可检missing且结果自动上传MES 1 Function test could detect missing and upload to MES automatically 1 | 1 | 称重可检出遗漏并与MES自动连接1 Weighting could detect missing and link with MES automatically 1 | 1 | 理论上防呆的管控方法，几乎不可能流出 1 Fool-proof action 1 | 1 |  | 设备自动扫单体SN或PN 1 Scan single body SN or PN in equipment automatically 1无物理仿形措施 5 No physical fool proof 5AOI及CCD进行检查并直接与MES相连接，如不符合几乎不可能流出 1 AOI and CCD inspection and link with MES automatically 1功能测试可检Mixing且结果自动上传MES 1 Function test could detect mixing and upload to MES automatically 1理论上防呆的管控方法，几乎不可能流出 1 Fool-proof action 1 | 设备自动扫单体SN或PN 1 Scan single body SN or PN in equipment automatically 1 | 1 | 无物理仿形措施 5 No physical fool proof 5 | 5 | AOI及CCD进行检查并直接与MES相连接，如不符合几乎不可能流出 1 AOI and CCD inspection and link with MES automatically 1 | 1 | 功能测试可检Mixing且结果自动上传MES 1 Function test could detect mixing and upload to MES automatically 1 | 1 | 理论上防呆的管控方法，几乎不可能流出 1 Fool-proof action 1 | 1 |  | 5 | 1 | 1 | 1 | 5 | 1 | Low Risk | Low Risk

Sheet: 4 Introduction of Process Map
表格填写指南
Items | Description
Station #： | Fill the number according to the flow chart, such as 1, 2, 3……. 按照Follow chart进行编号录入，如1,2,3…….
Station Name： | Fill in station name according to the flow chart 按照Follow chart 工站名进行录入
Material(P/N) or Process： | Fill in according to the materials involved in the flow chart station. Including auxiliary materials or virtual materials,Process (Control log, online upgrade software,glue, welding, etc.) material number writing and entry 按照Follow Chart 工站中涉及的物料包含辅料或虚拟的物料、制程等（Control log、在线升级软件、点胶、焊接等）编写进行录入
Material Description or Process Description： | Fill in the material name or process description of the current station. 按照Follow Chart 工站中涉及的物料名称和制程描述，进行编写录入
Risk Category： | Choose the category accordingly: 1. Same Series or Similar Parts in Different Lines& Stations; 2.SKU or Similar Parts in Same Station; 3. Common Part; 4.Operation Process1; 5.Parameters Related; 挑选当前项目的种类包括: 1.在不同线或工站组装的同系列或相似物料；2.在同工站组装的不同SKU或者相似物料；3.通用物料；4.制程操作1（制程操作，无流出风险，因为后工序有AOI检查或CCD检查或RFID检查或MES检查）；4.制程操作3（操作小概率流出风险，后工序有人工100%检查或半自动化检查）；4.制程操作5（操作大概率流出风险，后工序无检查）5.参数相关
Assembly Method： | 1. Manual Assemble; 2. Semi- Automatic; 3. Automatic 1.手动组装；2.半自助组装；3.全自动组装运行
Prevention method： | 1) MES Scan?: Choose follow station MES status； 根据当前小项MES应用状况在下拉选项中选取对应状态
 | 2) Physical Fit?: Choose follow station physical fit status; 根据当前小项物理防呆状况在下拉选项中选取对应状态。
 | 3) AOI/CCD?: Choose follow station AOI/CCD status； 根据当前小项AOI/CCD应用状况在下拉选项中选取对应状态
 | 4) Functional Test?: Choose follow station Functional Test status； 根据当前小项功能测试应用状况在下拉选项中选取对应状态
 | 5) Weight?: Choose follow station weight status； 根据当前小项称重应用状况在下拉选项中选取对应状态
 | 6) Manual or Other?: Choose follow station Manual or other action status； 根据当前小项手动检测或其他应用在下拉选项中选取对应状态
Occurrence: | Refer to the evaluation standard and will come out automatically after choose risk category； 参考评价标准，当选择风险类型后会自动评分。
Detection: | Refer to the evaluation standard and will come out automatically after complete all prevention method, and will choose tighten one. 参考评价标准，当完成当前项目所有预防措施后会自动评分
Risk Level： | High Risk 高风险: Missing or Mixing risk Level score >=15, need take mitigate actions; 漏装和错装评分>=15，需要制定风险降低措施 High risk action need tracking in "Action summary" sheet accordingly; 高风险的项目需要在Action Summary的表格中进行相应改善跟踪。 Middle Risk 中风险: Missing or Mixing risk level score is 9, need keep monitor in "Action summary" sheet and improve while necessary; 漏装和错装风险分数为9，需要在Action Summary的表格中进行监控，有必要时进行改善。 Low Risk 低风险: Missing or Mixing risk level socre <9; 漏装和错装评分<9分

Sheet: 5 Evaluation Standard
风险得分评价标准
Missing | Score | Mising Occurance | Missing Detection
 |  | Risk Category | MES Control | AOI&CCD | Function Test | Physical fit | Weighting | Manual and Other
 | 1 | Fully automatic assembly, almost no problems 全自动组装，几乎不会漏装 | Scan single body SN or PN in the equipment automatically在设备内部自动扫描单体上的SN或PN以检查是否组装及正确，几乎不可能发生问题 Scan single body SN or PN in following station manually在后续工位手动或自动扫描物料本体上的SN或 | AOI及CCD进行检查并直接与MES相连接，如不符合几乎不可能流出 AOI and CCD inspection and link with MES automatically , | 功能检测可以探测出Missing，且测试结果自动上传MES Function test could 00% detect missing and upload result to MES automatically , | 物理防呆，如漏装则下一工位不可组装或进行 Physical fool proof like if missed or mixed could not perfrom next process , | 称重可检出遗漏并与MES自动连接 Weighting could detect missing and link with MES automatically , | 理论上防呆的管控方法，几乎不可能流出 Fool-proof action ,
 | 3 | Semi-automatic assembly, less probability of problems (such as manual loading then equipment assembly) 半自动组装，很少概率发生问题（比如手动上料，设备自动组装） | Scan single SN or PN on body or packing mannually 在当工序手动扫描单体或单体包装上的SN或PN以检查是否组装或正确，有小概率操作失误 | N/A | 功能检测可以探测出Missing，但测试结果未自动MES（手动扫码） Function test could detect missing but didn't upload result to MES automatically , | NA | 称重可检出该遗漏但未自动上传MES Weighting could detect missing but not link with MES automatically , | 可以有效检出，但有小几率误操作流出 Detect effectively but have wrong operation possibility ,
 | 5 | Manual assembly, no automation equipment 手动组装，无自动化设备 | Not use MES control 没有使用MES进行管控 | 1.无AOI及CCD，或AOI及CCD无法有效拦截 1. No AOI and CCD or couldn't detect effectively 2.AOI及CCD可以侦测但未Link MES，如操作失误有小概率流出 2.AOI and CCD inspection but not link with MES | 功能检测无法拦截Missing Function test couldn't detect effectively | 无物理仿形措施 No physical fool proof | 无称重，或称重无法有效拦截 No weighting or weighting could detect missing | 人工检测或无管控 Manual inspection or no control ,
Mixing | Score | Mixing Occurance | Mixing Detection
 |  | Risk Category | MES Control | AOI&CCD | Function Test | Physical fit | Weighting | Manual and Other
 | 1 | Common Part, almost cannot mix; 通用不了几乎不会混用 Operation Process , cannot mix; 制程操作不会造成混料 Parameters Relate, cannot mix; 参数相关不会造成混料 | 在设备内部自动扫描单体上的SN或PN以检查是否组装及正确，几乎不可能发生问题 Scan single body SN or PN in the equipment automatically 在后续工位手动或自动扫描物料本体上的SN或PN, Scan single body SN or PN in following station manually | AOI及CCD进行检查并直接与MES相连接，如不符合几乎不可能流出 AOI and CCD inspection and link with MES automatically | 功能检测可以探测出Mixing，且测试结果自动上传MES Function test could 00% detect mixing and upload result to MES automatically | 物理防呆，如装错则下一工位不可组装或进行 Physical fool proof like if missed or mixed could not perfrom next process | NA | 理论上防呆的管控方法，几乎不可能流出 Fool-proof action ,
 | 3 | Same Series or Similar Parts in Different Lines& Stations, low risk of mixing. 在不同线体或工位组装的相同系列或者相似物料，有混料风险但风险较小 | 在当工序手动扫描单体或单体包装上的SN或PN以检查是否组装或正确，有小概率操作失误 Scan single SN or PN on body or packing mannually 手动扫描外包上的SN用来区分特别的物料 Scan lot SN to distinguish specify material mannually | N/A | 功能检测可以探测出Mixing，但测试结果未自动MES（手动扫码） Function test could detect mixing but didn't upload result to MES automatically | 使用仿形治具进行组装-仅针对Mixing Use shape similar fix to assemble | NA | 可以有效检出，但有小几率误操作流出 Detect effectively but have wrong operation possibility ,
 | 5 | SKU or Similar Parts in Same Station, high risk of mixing. 在同工站组装的不同SKU或者相似物料 | 没有使用MES进行管控 Not use MES control | 1. 无AOI及CCD，或AOI及CCD无法有效拦截 1. No AOI and CCD or couldn't detect effectively 2. AOI及CCD可以侦测但未Link MES，如操作失误有小概率流出 2. AOI and CCD inspection but not link with MES | 功能检测无法拦截Mixing Function test couldn't detect effectively | 无物理仿形措施 No physical fool proof | NA | 人工检测或无管控 Manual inspection or no control ,

Sheet: 7 Station Evaluation -中文
工站评估指导
错漏混识别参照表
序号 | 工站类别 | 识别事项
0 | 线体区分 | 该项目是否有不同的线体？如有不同的线体需要根据线体不同分别识别，评估！ （如手工线，自动线；不同线体的制程有区别等）
1 | 前置加工 | 前置加工工站是否有混料的风险？如果有风险，能否在后续FATP发现 包括仓库，物料分发中心和offline线
2 | SMT | 有没有用错测试程序的风险，怎么管控测试程序的升级更改
 |  | 有没有offline 程序下载
 |  | 针对不同的SKU有没有不同的设置，如果有，怎么防呆，怎么检查
 |  | 测试站别有针对烧录软件版本的管控，有没有错误的下载链接，能否检测出
 |  | 是否有针对不同SKU的测试，包括检测内存容量，EMMC，SIM卡等
 |  | 有没有对试做产品进行MES管控，避免和量产的产品混合
 |  | 测试站别是否有自动上传结果功能，怎么管理避免遗漏
3 | 装配工序 （纯粹人工作业） （无点胶、无焊接、无测试,无自动化） | 所有SOP中定义的物料有无漏失风险，有无防呆措施导入 1）物料单体有无增加二维码标签，产线有无实现扫描上MES 2）有无增加检具或者CCD100%识别拦截 3）漏作业测试工站是否可100%拦截 4）漏作业后续的工艺是否可100%拦截（不做后工站无法作业）
 |  | 所有SOP中定义的混淆物料有无混淆风险或同系列物料混淆风险，有无防呆措施导入 1）物料单体有无增加二维码标签，产线实现扫描上MES且自动检查正确性 2）有无增加检具或者CCD100%识别拦截 3）测试工站是否可100%拦截
 |  | 该工站作业内容有无漏失风险，违规操作有无漏失系统防呆监控机制，而不是单单执行人工作业纪律约束
 |  | 是否有kitting错误的风险，扫描A实际组装B
 |  | 试制品、验证品有无做MES系统控制，避免和量产产品混料
4 | 点胶工序 | 所有SOP中定义的物料有无漏失风险，有无防呆措施导入 1）物料单体有无增加二维码标签，产线实现扫描上MES 2）有无增加检具或者CCD100%识别拦截 3）漏作业测试工站是否可100%拦截 4）漏作业后续的工艺是否可100%拦截（不做后工站无法作业）
 |  | 所有SOP中定义的混淆物料有无混淆风险或同系列物料混淆风险，有无防呆措施导入 1）物料单体有无增加二维码标签，产线实现扫描上MES且自动检查正确性 2）有无增加检具或者CCD100%识别拦截 3）测试工站是否可100%拦截
 |  | 该工站作业内容有无漏失风险，违规操作有无漏失系统防呆监控机制，而不是单单执行人工作业纪律约束
 |  | 依据SOP中定义的辅料胶水有无漏作业风险，有无可拦截工站
 |  | SOP中定义的胶水有无过期使用风险，有无防呆管控措施导入（胶水有无实现料号上线系统Check）
 |  | 该工站有无混入同系列项目物料或胶水风险，有无防呆措施导入
 |  | 胶水重量如何进行管控？有无胶重自动获取与自动记录功能，有无胶重异常报警功能
 |  | 设备参数的监控如何进行？有无有效的防呆监控措施（上传MES并异常预警）
 |  | 点胶异常品是否可有效拦截（测试站或CCD拦截或AOI检查）
 |  | 试制品、验证品有无做MES系统锁定，以防混入大货品
 |  | 试错验证有无漏失或混淆风险
 |  | 点胶后有没有静置要求，如果有，怎么管控
5 | 压合工序 | 所有SOP中定义的物料有无漏失风险，有无防呆措施导入 1）物料单体有无增加二维码标签，产线实现扫描上MES 2）有无增加检具或者CCD100%识别拦截 3）漏作业测试工站是否可100%拦截 4）漏作业后续的工艺是否可100%拦截（不做后工站无法作业）
 |  | 所有SOP中定义的混淆物料有无混淆风险或同系列物料混淆风险，有无防呆措施导入 1）物料单体有无增加二维码标签，产线实现扫描上MES且自动检查正确性 2）有无增加检具或者CCD100%识别拦截 3）测试工站是否可100%拦截
 |  | 设备参数的监控如何进行？有无有效的防呆监控措施（上传MES并异常预警）
 |  | 不同SKU的是否使用不同压合治具，如果是，怎么管控
 |  | 该工站作业内容有无漏失风险，违规操作有无漏失系统防呆监控机制，而不是单单执行人工作业纪律约束
 |  | 压合后是否有静置要求，是否有管控机制
 |  | 焊接不良品是否可有效被拦截？（测试站是否可测试出）
 |  | 试制品、验证品有无做MES系统锁定，以防混入大货品
 |  | 试错验证有无漏失或混淆风险
6 | 焊接工序 | 所有SOP中定义的物料有无漏失风险，有无防呆措施导入 1）物料单体有无增加二维码标签，产线实现扫描上MES 2）有无增加检具或者CCD100%识别拦截 3）漏作业测试工站是否可100%拦截 4）漏作业后续的工艺是否可100%拦截（不做后工站无法作业）
 |  | 所有SOP中定义的混淆物料有无混淆风险或同系列物料混淆风险，有无防呆措施导入 1）物料单体有无增加二维码标签，产线实现扫描上MES且自动检查正确性 2）有无增加检具或者CCD100%识别拦截 3）测试工站是否可100%拦截
 |  | 设备参数的监控如何进行？有无有效的防呆监控措施（上传MES并异常预警）
 |  | 焊接不良品是否可有效被拦截？（测试站是否可测试出）
 |  | 试制品、验证品有无做MES系统锁定，以防混入大货品
 |  | 试错验证有无漏失或混淆风险
7 | 镭雕工序 | 镭雕内容有无镭雕漏失风险，是如何进行漏失防呆管控的?
 |  | 如果不同SKU有不同镭雕内容，怎么管控保证没有镭雕错误
 |  | 如果镭雕是在供应商处进行，怎么管控
 |  | 镭雕内容如果是可变的，比如含有系统日期信息，怎么管控
 |  | 怎么管控镭雕文件，有没有防错机制
 |  | 镭雕内容有无镭雕错误风险？是如何进行防呆管控的？
 |  | 试制品、验证品有无做MES系统锁定，以防混入大货品
8 | 标签打印工站 | 产品标签（单体SN标签、彩盒标签、中箱标签）有无漏贴风险？有无进行IT系统校验，是如何进行防呆管控的？
 |  | 有没有机制防范打印内容被人为误改
 |  | 产品标签有无混淆风险？是如何进行防呆管控的？
 |  | 试制品、验证品有无做MES系统锁定，以防混入大货品
 |  | 补印流程有无风险？权限管控有无风险？
9 | 外观检查1 | 外观检验工序有无漏失风险？目前的检验动作是否能够实现时时监控检验内容？ 所有的检验内容落实情况是否可有效追溯查询？
 |  | 各种易混或缺失物料的产品该工站放蛇是否可拦截？
 |  | 试制品、验证品有无做MES系统锁定，以防混入大货品
 |  | 该工序有无上料动作，有无漏失或混淆风险？现场试错验证
10 | 静置工站 | 静置工站混淆管理有无实现防呆管控？
 |  | 静置时间的管理有无实现系统卡控？
 |  | 试制品、验证品有无做MES系统锁定，以防混入大货品
11 | 称重工站 | 称重工站是否存在短装拦截风险？有无设置上下限，有无实现上下限系统查询与预警机制
12 | 测试工序 | 测试程序版本控制有无使用错误风险，测试软件的变更如何进行管理的？管理有无作业漏失点？
 |  | 有没有任何offline image 下载
 |  | 有没有测试部件遗漏在产品里的风险，比如 TF卡
 |  | 针对不同的SKU有没有不同的设置，如果有，怎么防呆，怎么检查
 |  | 测试工站有无涉及烧录软件版本，有无漏失环节？漏失有无拦截工站或拦截
 |  | 测试工站有无涉及上锁等特殊的操作指令？有无漏失环节？
 |  | 试错验证有无漏失或混淆风险
 |  | 混淆产品有无有无防呆措施导入（不同SKU的程序可防呆拦截，不同Memory Size是否可拦截）
 |  | 试制品、验证品有无做MES系统锁定，以防混入大货品
 |  | 测试工站有无涉及自动触发Control log上传工站，是如何进行防呆漏失管控的？
13 | OBA检验工序 | OBA检验有无错漏混风险，OBA有无存在更换材料使用错误的风险？是如何进行防呆控制的？
14 | 包装工序 | 所有SOP中定义的混淆物料有无混淆风险，有无防呆措施导入 1）物料单体有无增加二维码标签，产线实现扫描上MES且自动校验正确性， 2）有无增加检具或者CCD100%识别 3）包装站有无对前面所有功能测试站，所有工站漏作业拦截措施
 |  | 试制品、验证品有无做MES系统锁定，以防混入大货品
 |  | OBA产品重新包装的管控，有无错漏风险，MES怎么管控
 |  | 检验有无错漏混风险，OBA有无存在更换材料使用错误的风险？是如何进行防呆控制的？
 |  | 所有SOP中定义的物料有无漏上传风险，物料所有带条码的有无实现MES上料管控？未有条码的是如何实现漏失管控的？
 |  | 超时的产品重新检查包装流程的风险，MES的管控
 |  | 彩盒、说明书、保修卡、充电线等附件，需要增加二维码标签设计，供生产线扫描用。
15 | Control LOG上传工站 | 依据项目排查所有的Control log上传的工站，有无漏上传风险？实现方式有无风险？
16 | 装箱 | 装箱工站有无卡控混淆或漏装风险？防呆管控措施有无风险，试错验证
17 | 打托 | 打托有无混淆风险，混淆是否可卡控？试错验证
18 | 发货 | 发货有无发错或漏失风险？如何进行卡控的？

Sheet: 6 Station Evaluation-EN
Station Evaluation Guidance
Missing and Mixing Identification Reference Table
No | Station Category | Identification items
0 | Line Difference | 1. Is there a different line for the project? If there are different lines, they need to be identified and evaluated according to the different lines! (Such as manual thread, automatic thread; different thread bodies have different manufacturing processes, etc.) 2. Is there any different process or fixture don't inlcude the checklist?
1 | Preparation | 1. Preparation station if have mix risk? If mix if could detect at FATP? 2. Include warehouse/Material center/Production line
2 | SMT | Is there a risk of using error in the version control of the test program, and how is the change of the test software managed? Are there any missing points in management?
 |  | Is there any offline download image process?
 |  | Is there any different default setting in device by SKU different? How to foolproof control? How to check?
 |  | Does the testing station involve burning software versions, and are there any missing links? Missing with interception station or interception
 |  | whether the product has foolproof measures introduced (different SKU programs can prevent foolish interception, and whether different Memory Size/eMMC/SIM Card/ can be intercepted)
 |  | Whether trial products and verification products are locked by MES system to prevent mixing into bulk products
 |  | Does the test station involve automatically triggering the Control log to upload the station, and how is it managed to prevent leakage?
3 | Assembly Process (Manual work) (No dispensing, no welding, no testing, no automation) | Whether all materials defined in the SOP have the risk of loss and whether there are foolproof measures introduced 1) Whether to add a QR code label to the material monomer, whether to scan the MES on the production line 2) Is there any additional inspection tool or CCD 100% identification interception 3) Whether the missed job test station can be intercepted 100% 4) Whether the subsequent process of missed operation can be intercepted 100% (the station cannot be operated after it is not done)
 |  | Is there any risk of confusion for all the confusing materials defined in the SOP or the risk of confusing materials of the same series, and whether there are foolproof measures introduced 1) Whether the material monomer is added with a QR code label, is the QR code is unique? the production line realizes scanning on the MES and automatically checks the correctness 2) Is there any additional inspection tool or CCD 100% identification interception 3) Whether the test station can be intercepted 100%
 |  | Whether there is a risk of missing the work content of the station, whether there is any missing in the illegal operation, the system is a fool-proof monitoring mechanism, instead of a manual operation disciplinary constraint
 |  | Whether there is a risk of confuse kitting material? Scan A material,but assembly B material?
 |  | Any MES control for trail run product to prevent from mixing with POR device of mass production
4 | Glue Process | Whether all materials defined in the SOP have the risk of loss and whether there are foolproof measures introduced 1) Whether the material monomer is added with a QR code label, and the production line realizes scanning on the MES 2) Is there any additional inspection tool or CCD 100% identification interception 3) Whether the missed job test station can be intercepted 100% 4) Whether the subsequent process of missed operation can be intercepted 100% (the station cannot be operated after it is not done)
 |  | Is there any risk of confusion for all the confusing materials defined in the SOP or the risk of confusing materials of the same series, and whether there are foolproof measures introduced 1) Whether the material monomer is added with a QR code label, the production line realizes scanning on the MES and automatically checks the correctness 2) Is there any additional inspection tool or CCD 100% identification interception 3) Whether the test station can be intercepted 100%
 |  | Whether there is a risk of missing the work content of the station, whether there is any missing in the illegal operation, the system is a fool-proof monitoring mechanism, instead of a manual operation disciplinary constraint
 |  | According to the SOP defined in the SOP, whether there is a risk of leakage of the auxiliary material and whether there is a station that can be intercepted
 |  | Whether the glue defined in the SOP has the risk of expiration use, and whether the foolproof control measures are introduced (whether the glue has realized the part number online system Check)
 |  | Whether the station has the risk of mixing the same series of project materials or glue, and whether there are foolproof measures introduced
 |  | How to control the glue weight? With or without glue weight automatic acquisition and automatic recording function, with or without glue weight abnormal alarm function
 |  | How to monitor equipment parameters? Are there any effective foolproof monitoring measures (upload MES and early warning of abnormalities)
 |  | Whether abnormal dispensing products can be effectively intercepted (test station or CCD interception or AOI inspection)
 |  | Whether trial products and verification products are locked by MES system to prevent mixing into bulk products
 |  | Whether there is a risk of loss or confusion in trial and error verification
 |  | Whether this is any stationary time requirement after dispense glue? Is there any foolproof control mechanism?
5 | Bonding Process | Whether all materials defined in the SOP have the risk of loss and whether there are foolproof measures introduced 1) Whether to add a QR code label to the material monomer, whether to scan the MES on the production line 2) Is there any additional inspection tool or CCD 100% identification interception 3) Whether the missed job test station can be intercepted 100% 4) Whether the subsequent process of missed operation can be intercepted 100% (the station cannot be operated after it is not done)
 |  | Is there any risk of confusion for all the confusing materials defined in the SOP or the risk of confusing materials of the same series, and whether there are foolproof measures introduced 1) Whether the material monomer is added with a QR code label, the production line realizes scanning on the MES and automatically checks the correctness 2) Is there any additional inspection tool or CCD 100% identification interception 3) Whether the test station can be intercepted 100%
 |  | How to monitor equipment parameters? Are there any effective foolproof monitoring measures (upload MES and early warning of abnormalities)
 |  | Whether the bonding fixture is different as different SKU material? Is there any foolproof control mechanism?
 |  | Whether there is a risk of missing the work content of the station, whether there is any missing in the illegal operation, the system is a fool-proof monitoring mechanism, instead of a manual operation disciplinary constraint
 |  | Whether this is any stationary time requirement after bonding? Is there any foolproof control mechanism?
 |  | Whether abnormal bonding products can be effectively intercepted (test station or CCD interception or AOI inspection)
 |  | Whether trial products and verification products are locked by MES system to prevent mixing into bulk products
 |  | Whether there is a risk of loss or confusion in trial and error verification
6 | Welding Process | Whether all materials defined in the SOP have the risk of loss and whether there are foolproof measures introduced 1) Whether the material monomer is added with a QR code label, and the production line realizes scanning on the MES 2) Is there any additional inspection tool or CCD 100% identification interception 3) Whether the missed job test station can be intercepted 100% 4) Whether the subsequent process of missed operation can be intercepted 100% (the station cannot be operated after it is not done)
 |  | Is there any risk of confusion for all the confusing materials defined in the SOP or the risk of confusing materials of the same series, and whether there are foolproof measures introduced 1) Whether the material monomer is added with a QR code label, the production line realizes scanning on the MES and automatically checks the correctness 2) Is there any additional inspection tool or CCD 100% identification interception 3) Whether the test station can be intercepted 100%
 |  | How to monitor equipment parameters? Are there any effective foolproof monitoring measures (upload MES and early warning of abnormalities)
 |  | Can defective welding products be effectively intercepted? (Can the test station be tested?)
 |  | Whether trial products and verification products are locked by MES system to prevent mixing into bulk products
 |  | Whether there is a risk of loss or confusion in trial and error verification
7 | Laser Process | Does the laser engraving content have any risk of leakage of the laser engraving? How to control the loss and prevent foolishness?
 |  | If laser artwork is more than 2 types, how to control for different SKU? How to make sure there is no mix or wrong?
 |  | Is laser process from supplier? How to control and check?
 |  | Is there any avriable content in laser artwork? How to foolproof control? How to check? For example: Week code.
 |  | Is there any foolproof mechanism to control laser parameter file name?
 |  | Is there any risk of laser engraving errors? How to control foolproof?
 |  | Whether trial products and verification products are locked by MES system to prevent mixing into bulk products
8 | Label Printing Station | Is there any risk of missing product labels (single SN label, color box label, middle box label)? Is there any IT system verification, and how is the foolproof control performed?
 |  | If there any risk of modify the label template by un-authorized person? How to control foolproof?
 |  | Is there a risk of confusion on product labels? How to control foolproof?
 |  | Whether trial products and verification products are locked by MES system to prevent mixing into bulk products
 |  | Is there any risk in the reprint process? Is there any risk in authority control?
9 | Cosmetic Inspection | Is there a risk of loss in the visual inspection process? Can the current inspection actions be implemented to constantly monitor the inspection content? Can the implementation of all inspection contents be traced back effectively?
 |  | Can all kinds of products with miscellaneous or missing materials be intercepted by snakes at the station?
 |  | Whether trial products and verification products are locked by the MES system to prevent mixing into bulk products
 |  | Is there any feeding action in this process, and is there a risk of loss or confusion? On-site trial and error verification
10 | Stationary Station | Does the confusion management of the stationary work station achieve fool-proof control?
 |  | Does the management of resting time realize system card control?
 |  | Whether trial products and verification products are locked by MES system to prevent mixing into bulk products
11 | Weighting Station | Is there a risk of short-load interception at the weighing station? Whether to set the upper and lower limits, whether to realize the system query and early warning mechanism of the upper and lower limits
12 | Test Station | Is there a risk of using error in the version control of the test program, and how is the change of the test software managed? Are there any missing points in management?
 |  | Is there any offline download image process?
 |  | Is there station to check whether test fixture leave in device? Example: TF Card
 |  | Is there any different default setting in device by SKU different? How to foolproof control? How to check?
 |  | Does the testing station involve burning software versions, and are there any missing links? Missing with interception station or interception
 |  | Does the test station involve special operating instructions such as locking? Are there any missing links?
 |  | Whether there is a risk of loss or confusion in trial and error verification
 |  | Confused whether the product has foolproof measures introduced (different SKU programs can prevent foolish interception, and whether different Memory Size/eMMC/SIM Card/ can be intercepted)
 |  | Whether trial products and verification products are locked by MES system to prevent mixing into bulk products
 |  | Does the test station involve automatically triggering the Control log to upload the station, and how is it managed to prevent leakage?
13 | OBA Station | Is there a risk of mistakes and omissions in OBA inspection, and is there a risk of replacement of materials and incorrect use of OBA? How to control foolproof?
14 | Packing Process | Whether there is a risk of confusion for all the confusing materials defined in the SOP, and whether there are foolproof measures introduced 1) Whether to add a QR code label to the material monomer, the production line realizes scanning on the MES and automatically verifies the correctness, 2) Is there any additional inspection tool or CCD 100% recognition 3) Whether the packaging station has interception measures for all the previous functional test stations and all work stations for missing operations
 |  | Whether trial products and verification products are locked by MES system to prevent mixing into bulk products
 |  | Is there any risk for OBA device re-pack process, return which station?
 |  | Is there any risk of missing upload for all materials defined in SOP, and are all materials with barcodes realized MES feeding control? How to realize the control of leakage if there is no barcode?
 |  | Whether auto-link PSN of MES when device return previous station for overtime control device?
 |  | Color box, manual, warranty card, charging cable and other accessories need to add QR code label design for production line scanning.
15 | Control LOG Upload Station | According to the project, check all the stations uploaded by the Control log. Is there any risk of missing uploads? Is there any risk in the implementation method?
16 | Carton | Is there any risk of card control confusion or missing loading at the packing station? Whether there are risks in fool prevention control measures, trial and error verification
17 | Pallet | Is there a risk of confusion in pallet, and can the confusion be controlled? Trial and error verification
18 | Shipping | Is there any risk of wrong or missing shipment? How to control the card?
