Cinthanh1998/Du-an-Foxconn/Calypso+PVT+Readiness+Review_V0_20251106.xlsx

Sheet: Project Milestone
SMT line | 3A
FATP line | 4A
Package line | 5M
Project | Site | Line | Retrofit timing | Transfer to VN | Line set up & debug | Line qual | FATP Trial run date | FAT Trial run q'ty | Packing trial run | Line qual Approval | SMT OP qual approval | FATP OP qual approval | Shift | PVT SMT | PVT FATP Ramp | FAI report submission | FAI approval | Cut-off data for reports | REL | CET test report submission | Internal PO shipment date | Internal PO-validation result | Submit reports date | OK2ship | FFS | Remark
Calypso | VN | Line 1: POR line SMT * 1 + FATP * 1 + Packing * 1 | / | / | POR line (Use from DVT) | 11/03~11/12 | 2025-11-12 | 60pcs (5 panels) | 12pcs | SMT: 11/13/2025 FATP: 11/12/2025 Packing: 11/15/2025 | 2025-11-13 | 2025-11-15 | DS | 2025-11-14 | 11/17~12/02 | 2025-11-15 | 2025-11-15 | 2025-12-01 | TBD | 2025-12-01 | WK11/16: 1681x (Before OK2S) WK12/07: 940x (after OK2S) | TBD | 2025-12-02 | 2025-12-08 | 2025-12-10 | Ramp up to 95% eficiency until cut off date
 |  |  |  |  |  |  |  |  |  |  |  |  | NS |  | 11/18~12/03 | 11/19/2025 9:00am | 11/19/2025 10:00am |  |  |  |  |  |  |  |  | Ramp up to 95% eficiency until cut off date
 |  | Line 2: FATP Retrofit from VN Sheldon SMT * 1 + FATP * 1 + Packing * 1 | 09/15~10/18 | 10/20~11/06 | 11/07~11/11 | 11/12~11/15 | 2025-11-17 | 60pcs (5 panels) | 12pcs | SMT: 11/18/2025 FATP: 11/18/2025 Packing: 11/19/2025 | 2025-11-18 | 2025-11-19 | DS | 2025-11-19 | 11/20~12/05 | 11/20/2025 1:00pm | 11/20/2025 2:00pm |  |  |  |  |  |  |  |  | Ramp up to 85% eficiency until cut off date
 |  |  |  |  |  |  |  |  |  |  |  |  | NS |  | 11/21~12/06 | 11/22/2025 9:00am | 11/22/2025 10:00am |  |  |  |  |  |  |  |  | Ramp up to 80% eficiency until cut off date
 |  | Line 3: FATP Retrofit from LH Sheldon. (Auto HSG assembly line retrofit from Callie VN) SMT * 1 + FATP * 1 + Packing * 1 | 09/15~11/08 | 10/20~11/15 | 11/10~11/15 | 11/15~11/19 | 2025-11-20 | 60pcs (5 panels) | 12pcs | SMT: 11/22/2025 FATP: 11/21/2025 Packing: 11/24/2025 | 2025-11-22 | 2025-11-22 | DS | 2025-11-24 | 11/24~12/09 | 11/24/2025 1:00pm | 11/24/2025 2:00pm |  |  |  |  |  |  |  |  | Ramp up to 60% eficiency until cut off date
 |  |  |  |  |  |  |  |  |  |  |  |  | NS |  | 11/25~12/10 | 11/26/2025 9:00am | 11/26/2025 10:00am |  |  |  |  |  |  |  |  | Ramp up to 50% eficiency until cut off date
 |  | Line 4: FATP Retrofit from LH Sheldon. (Auto HSG assembly line retrofit from Callie VN) FATP * 1 + Packing * 2 | 09/15~11/08 | 10/20~11/15 | 11/12~11/15 | 11/17~11/22 | 2025-11-24 | 60pcs (5 panels) | 12pcs/line | FATP: 11/25/2025 Packing: 11/27/2025 | / | 2025-11-26 | DS | / | 11/27~12/12 | 11/27/2025 1:00pm | 11/27/2025 2:00pm |  |  |  |  |  |  |  |  | Ramp up to 30% eficiency until cut off date
 |  |  |  |  |  |  |  |  |  |  |  |  | NS |  | 11/28~12/13 | 11/29/2025 9:00am | 11/29/2025 10:00am |  |  |  |  |  |  |  |  | Ramp up to 20% eficiency until cut off date
Plan
On-going
Closed
Summary:
Risk:

Sheet: Line qual Milestone
PVT Auto fungible 1.0 line * 4 |  |  |  |  |  |  |  |  |  |  |  |  |  |  |  |  | Actual
No | Process | Lines | Items | Start date | End date | Lead time | Status | 2025-09-01 |  |  |  |  |  |  |  |  |  |  |  |  |  |  |  |  |  |  |  |  |  |  |  |  |  |  |  | 2025-10-01
 |  |  |  |  |  |  |  | 2025-09-07 |  |  |  |  |  |  | 2025-09-14 |  |  |  |  |  |  | 2025-09-21 |  |  |  |  |  |  | 2025-09-28 |  |  |  |  |  |  | 2025-10-05 |  |  |  |  |  |  | 2025-10-12 |  |  |  |  |  |  | 2025-10-19 |  |  |  |  |  |  | 2025-10-26
 |  |  |  |  |  |  |  | 7 | 8 | 9 | 10 | 11 | 12 | 13 | 14 | 15 | 16 | 17 | 18 | 19 | 20 | 21 | 22 | 23 | 24 | 25 | 26 | 27 | 28 | 29 | 30 | 1 | 2 | 3 | 4 | 5 | 6 | 7 | 8 | 9 | 10 | 11 | 12 | 13 | 14 | 15 | 16 | 17 | 18 | 19 | 20 | 21 | 22 | 23 | 24 | 25 | 26 | 27 | 28
1 | SMT | SMT S2 line | Line setup (HDMI press) | 2025-11-07 | 2025-11-08 | 2 | On-going
 |  |  | Line debug and qualification | 2025-11-10 | 2025-11-11 | 2 | Open
 |  |  | Approve | 2025-11-12 | 2025-11-13 | 2 | Open
 |  | SMT S12 line | HDMI press machine transfer | 2025-11-05 | 2025-11-10 | 5 | On-going
 |  |  | Line setup (HDMI press) | 2025-11-11 | 2025-11-12 | 2 | Open
 |  |  | Line debug and qualification | 2025-11-12 | 2025-11-17 | 5 | Open
 |  |  | Approve | 2025-11-18 | 2025-11-18 | 1 | Open
 |  | SMT S1 line | HDMI press machine transfer | 2025-11-05 | 2025-11-10 | 5 | On-going
 |  |  | Line setup (HDMI press) | 2025-11-11 | 2025-11-12 | 2 | Open
 |  |  | Line debug and qualification | 2025-11-15 | 2025-11-20 | 5 | Open
 |  |  | Approve | 2025-11-21 | 2025-11-22 | 2 | Open
2 | BFT testing | Test Line #1 Auto BFT (Reuse from DVT) L1 start date: 11/17 | Debug | 2025-10-22 | 2025-10-25 | 3 | Closed |  |  |  |  |  |  |  |  |  |  |  |  |  |  |  |  |  |  |  |  |  |  |  |  |  |  |  |  |  |  |  |  |  |  |  |  |  |  |  |  |  |  |  |  |  | Debug
 |  |  | Line qual | 2025-11-03 | 2025-11-10 | 7 | On-going
 |  |  | Trial run | 2025-11-12 | 2025-11-12 | 1 | Open
 |  |  | Approve | 2025-11-12 | 2025-11-13 | 2 | Open
 |  | Test Line #2 Auto BFT (Transfer from LH) L2 start date: 11/20 | Transfer from LH | 2025-09-15 | 2025-09-27 | 12 | Closed |  |  |  |  |  |  |  |  | Line transfer from LH
 |  |  | Fixture modification | 2025-09-22 | 2025-10-25 | 33 | Closed |  |  |  |  |  |  |  |  |  |  |  |  |  |  |  | PR,PO |  |  |  |  |  |  | Fabrication
 |  |  | Line setup & Debug | 2025-10-27 | 2025-11-08 | 12 | On-going |  |  |  |  |  |  |  |  |  |  |  |  |  |  |  |  |  |  |  |  |  |  |  |  |  |  |  |  |  |  |  |  |  |  |  |  |  |  |  |  |  |  |  |  |  |  |  |  |  |  | Setup & debug
 |  |  | Line qual | 2025-11-10 | 2025-11-14 | 5 | Open
 |  |  | Trial run | 2025-11-17 | 2025-11-17 | 1 | Open
 |  |  | Approve | 2025-11-15 | 2025-11-17 | 2 | Open
 |  | Test Line #3 Auto BFT L3 start date: 11/24 | Fixture modification | 2025-09-22 | 2025-10-29 | 37 | Closed |  |  |  |  |  |  |  |  |  |  |  |  |  |  |  | PR,PO |  |  |  |  |  |  | Fabrication
 |  |  | Line setup & Debug | 2025-10-30 | 2025-11-12 | 13 | On-going
 |  |  | Line qual | 2025-11-13 | 2025-11-18 | 5 | Open
 |  |  | Trial run | 2025-11-20 | 2025-11-20 | 1 | Open
 |  |  | Approve | 2025-11-19 | 2025-11-20 | 2 | Open
 |  | Test Line #4 Auto BFT L4 start date: 11/27 | Fixture modification | 2025-09-22 | 2025-11-01 | 40 | On-going |  |  |  |  |  |  |  |  |  |  |  |  |  |  |  | PR,PO |  |  |  |  |  |  | Fabrication
 |  |  | Line setup & Debug | 2025-11-03 | 2025-11-15 | 12 | Open
 |  |  | Line qual | 2025-11-17 | 2025-11-21 | 5 | Open
 |  |  | Trial run | 2025-11-24 | 2025-11-24 | 1 | Open
 |  |  | Approve | 2025-11-22 | 2025-11-24 | 2 | Open
3 | Auto Panel assembly | ASSY AUTO: Panel Line*1 (DVT line) | Line setup & Debug | 2025-10-27 | 2025-11-01 | 5 | Closed |  |  |  |  |  |  |  |  |  |  |  |  |  |  |  |  |  |  |  |  |  |  |  |  |  |  |  |  |  |  |  |  |  |  |  |  |  |  |  |  |  |  |  |  |  |  |  |  |  |  | Set up
 |  |  | Line qual | 2025-11-03 | 2025-11-10 | 7 | On-going
 |  |  | Trial run | 2025-11-12 | 2025-11-12 | 1 | Open
 |  |  | Approve | 2025-11-13 | 2025-11-14 | 2 | Open
 |  | ASSY AUTO: Panel Line*2 (retrofit from Sheldon VN) Glue dispensing machine arrived on 11/6 & set up from 11/7 | Line setup & Debug | 2025-11-07 | 2025-11-11 | 4 | On-going
 |  |  | Line qual | 2025-11-12 | 2025-11-15 | 3 | Open
 |  |  | Trial run | 2025-11-17 | 2025-11-17 | 1 | Open
 |  |  | Approve | 2025-11-17 | 2025-11-18 | 2 | Open
 |  | ASSY AUTO: Panel Line*3 (transfer from China) Start date: 11/24 Batch 1 (80%) arrived on 11/6 Batch 2 (20%) ETA 11/11 - backup by on hand EQ | Line transfer | 2025-10-20 | 2025-11-06 | 17 | Closed |  |  |  |  |  |  |  |  |  |  |  |  |  |  |  |  |  |  |  |  |  |  |  |  |  |  |  |  |  |  |  |  |  |  |  |  |  |  |  |  |  |  |  | Line transfer from LH
 |  |  | Line setup & Debug | 2025-11-10 | 2025-11-14 | 5 | Open
 |  |  | Line qual | 2025-11-15 | 2025-11-19 | 4 | Open
 |  |  | Trial run | 2025-11-20 | 2025-11-20 | 1 | Open
 |  |  | Approve | 2025-11-20 | 2025-11-21 | 2 | Open
 |  | ASSY AUTO: Panel Line*4 (transfer from China) Start date: 11/27 | Line transfer | 2025-10-20 | 2025-11-11 | 22 | On-going |  |  |  |  |  |  |  |  |  |  |  |  |  |  |  |  |  |  |  |  |  |  |  |  |  |  |  |  |  |  |  |  |  |  |  |  |  |  |  |  |  |  |  | Line transfer from LH
 |  |  | Line setup & Debug | 2025-11-12 | 2025-11-15 | 4 | Open
 |  |  | Line qual | 2025-11-17 | 2025-11-22 | 6 | Open
 |  |  | Trial run | 2025-11-24 | 2025-11-24 | 1 | Open
 |  |  | Approve | 2025-11-24 | 2025-11-25 | 2 | Open
4 | Auto HSG assembly | ASSY AUTO: Housing*1 (POR line) Start date: 11/17 | Line setup & Debug | 2025-10-27 | 2025-11-01 | 5 | Closed |  |  |  |  |  |  |  |  |  |  |  |  |  |  |  |  |  |  |  |  |  |  |  |  |  |  |  |  |  |  |  |  |  |  |  |  |  |  |  |  |  |  |  |  |  |  |  |  |  |  | Set up
 |  |  | Line qual | 2025-11-03 | 2025-11-10 | 7 | On-going
 |  |  | Trial run | 2025-11-12 | 2025-11-12 | 1 | Open
 |  |  | Approve | 2025-11-10 | 2025-11-11 | 2 | Open
 |  | ASSY AUTO: Housing*2 (Retrofit Callie VN HSG line) Start date: 11/24 Pending 2x Link & assemble back housing machine ETA 11/15 | Fixture modification | 2025-10-13 | 2025-11-08 | 26 | On-going |  |  |  |  |  |  |  |  |  |  |  |  |  |  |  |  |  |  |  |  |  |  |  |  |  |  |  |  |  |  |  |  |  |  |  |  | Fabrication
 |  |  | Line setup & Debug | 2025-11-10 | 2025-11-15 | 5 | Open
 |  |  | Line qual | 2025-11-17 | 2025-11-19 | 3 | Open
 |  |  | Trial run | 2025-11-20 | 2025-11-20 | 1 | Open
 |  |  | Approve | 2025-11-21 | 2025-11-22 | 2 | Open
5 | Device testing | Test Line #1 Auto FTS, FPS (Reuse from DVT) | Debug | 2025-10-22 | 2025-10-25 | 4 | Closed |  |  |  |  |  |  |  |  |  |  |  |  |  |  |  |  |  |  |  |  |  |  |  |  |  |  |  |  |  |  |  |  |  |  |  |  |  |  |  |  |  |  |  |  |  | Debug
 |  |  | Line qual | 2025-11-04 | 2025-11-11 | 8 | On-going
 |  |  | Trial run | 2025-11-12 | 2025-11-12 | 1 | Open
 |  |  | Approve | 2025-11-12 | 2025-11-13 | 2 | Open
 |  | Test Line #2 Auto FTS, FPS (Retrofit from Sheldon VN) Start date: 11/20 | Fixture modification | 2025-09-22 | 2025-10-25 | 33 | Closed |  |  |  |  |  |  |  |  |  |  |  |  |  |  |  | PR,PO |  |  |  |  |  |  | Fabrication
 |  |  | Line setup & Debug | 2025-10-28 | 2025-11-08 | 11 | On-going |  |  |  |  |  |  |  |  |  |  |  |  |  |  |  |  |  |  |  |  |  |  |  |  |  |  |  |  |  |  |  |  |  |  |  |  |  |  |  |  |  |  |  |  |  |  |  |  |  |  |  | Setup & debug
 |  |  | Line qual | 2025-11-10 | 2025-11-15 | 6 | Open
 |  |  | Trial run | 2025-11-17 | 2025-11-17 | 1 | Open
 |  |  | Approve | 2025-11-17 | 2025-11-18 | 2 | Open
 |  | Test Line #3 Auto FTS, FPS (Transfer from LH) Start date: 11/24 2x FPS arrived on 11/6 | Fixture modification | 2025-09-22 | 2025-11-01 | 41 | Closed |  |  |  |  |  |  |  |  |  |  |  |  |  |  |  | PR,PO |  |  |  |  |  |  | Fabrication
 |  |  | Transfer from LH | 2025-09-15 | 2025-11-06 | 52 | Closed |  |  |  |  |  |  |  |  | Line transfer from LH
 |  |  | Line setup & Debug | 2025-11-04 | 2025-11-13 | 9 | On-going
 |  |  | Line qual | 2025-11-14 | 2025-11-19 | 5 | Open
 |  |  | Trial run | 2025-11-20 | 2025-11-20 | 1 | Open
 |  |  | Approve | 2025-11-20 | 2025-11-21 | 2 | Open
 |  | Test Line #4 Auto FTS, FPS (Transfer from LH) Start date: 11/27 6x FPS arrived on 11/6 | Fixture modification | 2025-09-22 | 2025-10-29 | 38 | Closed |  |  |  |  |  |  |  |  |  |  |  |  |  |  |  | PR,PO |  |  |  |  |  |  | Fabrication
 |  |  | Transfer from LH | 2025-09-15 | 2025-11-06 | 52 | Closed |  |  |  |  |  |  |  |  | Line transfer from LH
 |  |  | Line setup & Debug | 2025-11-08 | 2025-11-17 | 9 | Open
 |  |  | Line qual | 2025-11-18 | 2025-11-22 | 5 | Open
 |  |  | Trial run | 2025-11-24 | 2025-11-24 | 1 | Open
 |  |  | Approve | 2025-11-24 | 2025-11-25 | 2 | Open
6 | Pack out | VI Station Line #1 (VI fixture modification) | Line setup & Debug | 2025-11-03 | 2025-11-10 | 7 | On-going
 |  |  | Line qual | 2025-11-11 | 2025-11-13 | 3 | Open
 |  |  | Trial run | 2025-11-13 | 2025-11-13 | 1 | Open
 |  |  | Approve | 2025-11-14 | 2025-11-15 | 1 | Open
 |  | VI Station Line #2 (VI fixture modification) | Line setup & Debug | 2025-11-06 | 2025-11-13 | 7 | On-going
 |  |  | Line qual | 2025-11-14 | 2025-11-17 | 3 | Open
 |  |  | Trial run | 2025-11-17 | 2025-11-17 | 1 | Open
 |  |  | Approve | 2025-11-18 | 2025-11-19 | 2 | Open
 |  | VI Station Line #3 (VI fixture modification) | Line setup & Debug | 2025-11-11 | 2025-11-18 | 7 | Open
 |  |  | Line qual | 2025-11-19 | 2025-11-21 | 3 | Open
 |  |  | Trial run | 2025-11-21 | 2025-11-21 | 1 | Open
 |  |  | Approve | 2025-11-22 | 2025-11-24 | 2 | Open
 |  | VI Station Line #4 (VI fixture modification) | Line setup & Debug | 2025-11-14 | 2025-11-21 | 7 | Open
 |  |  | Line qual | 2025-11-22 | 2025-11-25 | 3 | Open
 |  |  | Trial run | 2025-11-25 | 2025-11-25 | 1 | Open
 |  |  | Approve | 2025-11-26 | 2025-11-27 | 2 | Open
 |  | VI Station Line #5 (VI fixture modification) | Line setup & Debug | 2025-11-14 | 2025-11-21 | 7 | Open
 |  |  | Line qual | 2025-11-22 | 2025-11-25 | 3 | Open
 |  |  | Trial run | 2025-11-26 | 2025-11-26 | 1 | Open
 |  |  | Approve | 2025-11-26 | 2025-11-27 | 2 | Open

Sheet: Line Qual Summary
Calypso VN PVT SMT and FATP Line Setup and Qualification Schedule
Station | Qualifiation item | Oct |  |  |  |  |  |  |  |  |  |  |  |  |  |  |  |  |  |  |  |  |  |  |  |  |  |  |  |  |  |  | Nov
 |  | 1 | 2 | 3 | 4 | 5 | 6 | 7 | 8 | 9 | 10 | 11 | 12 | 13 | 14 | 15 | 16 | 17 | 18 | 19 | 20 | 21 | 22 | 23 | 24 | 25 | 26 | 27 | 28 | 29 | 30 | 31 | 1 | 2 | 3 | 4 | 5 | 6 | 7 | 8 | 9 | 10 | 11 | 12 | 13 | 14 | 15 | 16 | 17 | 18 | 19 | 20 | 21 | 22 | 23 | 24 | 25 | 26 | 27
SMT | SMT Line qualification (CPK+GRR) S2 |  |  |  |  |  |  |  |  |  |  |  |  |  |  |  |  |  |  |  |  |  |  |  |  |  |  |  |  |  |  |  |  |  |  |  |  |  | Setup |  |  | Debug |  | Customer approval |  | ※PVT
 | SMT Line qualification (CPK+GRR) S12 |  |  |  |  |  |  |  |  |  |  |  |  |  |  |  |  |  |  |  |  |  |  |  |  |  |  |  |  |  |  |  |  |  |  |  |  |  |  |  |  |  | Setup | Debug |  |  |  |  | Customer approval |  | ※PVT
 | SMT Line qualification (CPK+GRR) S1 |  |  |  |  |  |  |  |  |  |  |  |  |  |  |  |  |  |  |  |  |  |  |  |  |  |  |  |  |  |  |  |  |  |  |  |  |  |  |  |  |  | Setup |  |  |  | Debug |  |  |  |  |  | Customer approval |  |  | ※PVT
Test Station BFT Line1 BF T * 4 | Strain Gauge + GRR + Correlation |  |  |  |  |  |  |  |  |  |  |  |  |  |  |  |  |  |  |  |  |  | Debug |  |  |  |  |  |  |  |  |  |  |  | Line qualificaiton (Strain Gauge + GRR + Correlation) |  |  |  |  |  |  |  | Customer approval |  |  |  |  |  | ※PVT
Test Station BFT Line2 BFT*4 | Strain Gauge + GRR + Correlation |  |  |  |  |  |  |  |  |  |  |  |  |  |  |  |  |  |  |  |  |  |  |  |  |  |  | Set up & debug |  |  |  |  |  |  |  |  |  |  |  |  |  | Line qualificaiton (Strain Gauge + GRR + Correlation) |  |  |  |  | Customer approval |  |  |  |  | ※PVT
Test Station BFT Line3 BFT*4 | Strain Gauge + GRR + Correlation |  |  |  |  |  |  |  |  |  |  |  |  |  |  |  |  |  |  |  |  |  |  |  |  |  |  |  |  |  | Set up & debug |  |  |  |  |  |  |  |  |  |  |  |  |  | Line qualificaiton (Strain Gauge + GRR + Correlation) |  |  |  |  |  | Customer approval |  |  |  |  | ※PVT
Test Station BFT Line4 BFT*4 | Strain Gauge + GRR + Correlation |  |  |  |  |  |  |  |  |  |  |  |  |  |  |  |  |  |  |  |  |  |  |  |  |  |  |  |  |  |  |  |  |  | Set up & debug |  |  |  |  |  |  |  |  |  |  |  |  |  | Line qualificaiton (Strain Gauge + GRR + Correlation) |  |  |  |  | Customer approval |  |  |  |  | ※PVT
ASSY AUTO: Panel Line*4 | Auto Fungible 1.0 Assy line1 (POR line) |  |  |  |  |  |  |  |  |  |  |  |  |  |  |  |  |  |  |  |  |  |  |  |  |  |  | Setup ready |  |  |  |  |  |  | Line qualificaiton (Force CPK + Paper test+ Strain gauge |  |  |  |  |  |  |  |  | Trial run | Customer approval |  | FAI build |  | ※PVT
 | Auto Fungible 1.0 Assy line 2 |  |  |  |  |  |  |  |  |  |  |  |  |  |  |  |  |  |  |  |  |  |  |  |  |  |  |  |  |  |  |  |  |  |  |  |  |  | Setup ready |  |  |  |  | Line qualificaiton (Force CPK + Paper test+ Strain gauge) |  |  |  |  | Customer approval |  |  | ※PVT
 | Auto Fungible 1.0 Assy line 3 |  |  |  |  |  |  |  |  |  |  |  |  |  |  |  |  |  |  |  | Line transfer from LH |  |  |  |  |  |  |  |  |  |  |  |  |  |  |  |  |  |  |  |  | Setup ready |  |  |  |  | Line qualificaiton (Force CPK + Paper test+ Strain gauge) |  |  |  |  | Customer approval |  |  |  | ※PVT
 | Auto Fungible 1.0 Assy line 4 |  |  |  |  |  |  |  |  |  |  |  |  |  |  |  |  |  |  |  | Line transfer from LH |  |  |  |  |  |  |  |  |  |  |  |  |  |  |  |  |  |  |  |  |  |  | Setup ready |  |  |  |  | Line qualificaiton (Force CPK + Paper test+ Strain gauge) |  |  |  |  |  |  | Customer approval |  |  | ※PVT
ASSY AUTO: Housing*2 | Auto Fungible 2.0 Assy line1 (POR line) |  |  |  |  |  |  |  |  |  |  |  |  |  |  |  |  |  |  |  |  |  |  |  |  |  |  | Setup ready |  |  |  |  |  |  | Line qualificaiton (Force Cpk+Paper test+ Strain gauge) |  |  |  |  |  |  |  | Customer approval |  |  |  |  |  | ※PVT
 | Auto Fungible 2.0 Assy line2 (Retrofit Callie VN HSG line) |  |  |  |  |  |  |  |  |  |  |  |  |  |  |  |  |  |  |  |  |  |  |  |  |  |  |  |  |  |  |  |  |  |  |  |  |  |  |  |  | Set up & debug |  |  |  |  |  |  | Line qualification |  |  |  | Customer approval |  |  | ※PVT
Test Station FTS Line1 FTS * 2 Cell (12+12) | GRR + Correlation |  |  |  |  |  |  |  |  |  |  |  |  |  |  |  |  |  |  |  |  |  | Debug |  |  |  |  |  |  |  |  |  |  |  |  | Line qualificaiton (GRR + Correlation) |  |  |  |  |  |  |  | Customer approval |  |  |  |  | ※PVT
Test Station FPS Line1 FPS * 4 | Loop Test |  |  |  |  |  |  |  |  |  |  |  |  |  |  |  |  |  |  |  |  |  | Debug |  |  |  |  |  |  |  |  |  |  |  |  | Line qualificaiton (GRR + Correlation) |  |  |  |  |  |  |  | Customer approval |  |  |  |  | ※PVT
Test Station FTS Line2 FTS * 2Cell (12+12) | GRR + Correlation |  |  |  |  |  |  |  |  |  |  |  |  |  |  |  |  |  |  |  |  |  |  |  |  |  |  |  | Set up & debug |  |  |  |  |  |  |  |  |  |  |  |  | Line qualificaiton (GRR + Correlation) |  |  |  |  |  |  | Customer approval |  |  | ※PVT
Test Station FPS Line2 FPS*4 | Loop Test |  |  |  |  |  |  |  |  |  |  |  |  |  |  |  |  |  |  |  |  |  |  |  |  |  |  |  | Set up & debug |  |  |  |  |  |  |  |  |  |  |  |  | Line qualificaiton (GRR + Correlation) |  |  |  |  |  |  | Customer approval |  |  | ※PVT
Test Station FTS Line3 FTS*2Cell (12+12) | GRR + Correlation |  |  |  |  |  |  |  |  |  |  |  |  |  |  |  |  |  |  |  |  |  |  |  |  |  |  |  |  |  |  |  |  |  |  | Set up & debug |  |  |  |  |  |  |  |  |  | Line qualificaiton (GRR + Correlation) |  |  |  |  |  | Customer approval |  |  |  | ※PVT
Test Station FPS Line3 FPS*4 | Loop Test |  |  |  |  |  |  |  |  |  |  |  |  |  |  |  |  |  |  |  |  |  |  |  |  |  |  |  |  |  |  |  |  |  |  | Set up & debug |  |  |  |  |  |  |  |  |  | Line qualificaiton (GRR + Correlation) |  |  |  |  |  | Customer approval |  |  |  | ※PVT
Test Station FTS Line4 FTS*2Cell (12+12) | GRR + Correlation |  |  |  |  |  |  |  |  |  |  |  |  |  |  |  |  |  |  |  |  |  |  |  |  |  |  |  |  |  |  |  |  |  |  |  |  |  |  | Set up & debug |  |  |  |  |  |  |  |  |  | Line qualificaiton (GRR + Correlation) |  |  |  |  |  | Customer approval |  |  | ※PVT
Test Station FPS Line4 FPS*4 | Loop Test |  |  |  |  |  |  |  |  |  |  |  |  |  |  |  |  |  |  |  |  |  |  |  |  |  |  |  |  |  |  |  |  |  |  |  |  |  |  | Set up & debug |  |  |  |  |  |  |  |  |  | Line qualificaiton (GRR + Correlation) |  |  |  |  |  | Customer approval |  |  | ※PVT
Pack out line #1 Manual | VI Station (Fault injection) |  |  |  |  |  |  |  |  |  |  |  |  |  |  |  |  |  |  |  |  |  |  |  |  |  |  |  |  |  |  |  |  |  | Set up & debug |  |  |  |  |  |  |  | Line qualificaiton & Trial run |  |  | Customer approval |  |  |  |  | ※PVT
Pack out line #2 Manual | VI Station (Fault injection) |  |  |  |  |  |  |  |  |  |  |  |  |  |  |  |  |  |  |  |  |  |  |  |  |  |  |  |  |  |  |  |  |  |  |  |  | Set up & debug |  |  |  |  |  |  |  | Line qualificaiton & Trial run |  |  |  | Customer approval |  |  | ※PVT
Pack out line #3 Manual | VI Station (Fault injection) |  |  |  |  |  |  |  |  |  |  |  |  |  |  |  |  |  |  |  |  |  |  |  |  |  |  |  |  |  |  |  |  |  |  |  |  |  |  |  |  |  | Set up & debug |  |  |  |  |  |  |  | Line qualificaiton & Trial run |  |  | Customer approval |  |  |  | ※PVT
Pack out line #4 Manual | VI Station (Fault injection) |  |  |  |  |  |  |  |  |  |  |  |  |  |  |  |  |  |  |  |  |  |  |  |  |  |  |  |  |  |  |  |  |  |  |  |  |  |  |  |  |  |  |  |  | Set up & debug |  |  |  |  |  |  |  | Line qualificaiton & Trial run |  |  |  | Customer approval
Pack out line #5 Manual | VI Station (Fault injection) |  |  |  |  |  |  |  |  |  |  |  |  |  |  |  |  |  |  |  |  |  |  |  |  |  |  |  |  |  |  |  |  |  |  |  |  |  |  |  |  |  |  |  |  | Set up & debug |  |  |  |  |  |  |  | Line qualificaiton & Trial run |  |  |  | Customer approval
Pack out line #1 Auto (Ramp after OK2S) | Fault injection

Sheet: OBA Readiness
OBA Readiness Review for PVT
No. | Contents | PVT |  | Remark
 | Contents | Status | Due date | Remark
1 | Product build Milestone | Closed | 2025-10-10 | Follow up OPM Build Matrix
2 | Escalation List | Closed | 2025-09-19
3 | OBA Facility Check List | on-going | 2025-11-10 | Add 3 Shielding rooms with TV and fixture to Calypso: - Onhand 3 Shielding rooms - Already Moved 3 Shielding rooms to Calypso, on-going to setup electric, network, TV. - 20pcs
4 | OBA Layout | Closed | 2025-11-10 | Set up shielding room and setup to Calypso
5 | OBA Operator Training Plan | on-going | 2025-11-15 | Start from 11/08, complete by 11/15
6 | SIP - based on TCD | Closed | 2025-10-27 | Update SIP based on new OBA TCD provide by DQM.
7 | OBA Capacity--OBA | Closed | 2025-10-10
8 | CET Plan | Closed | 2025-11-10
9 | Weekly Review action item list | on-going | Daily
10 | OBA PVT Regression test | Closed | 2025-11-01 | GMC regression test user image 19
Summary:
No risk

Sheet: IQC Readiness
Calypso IQC Readiness Summary
No. | Items | CM/AMZ DRI | Due date | Status
1 | MMIL(Material Major Issue list) through build | Tongzhang/Evan | 2025-10-18 | Closed | All material issues have been closed
2 | Team list | Tongzhang/Evan | 2025-01-08 | Closed
3 | Project schedule | Tongzhang/Evan | 2025-01-08 | Closed
4 | Key part list&material ETA&IQC plan | Tongzhang/Evan | 2025-01-08 | Closed
5 | Key parts vendors OQC/IQC alignment | Tongzhang/Evan | 2025-01-26 | Closed
6 | SIP/MSOP readiness | Tongzhang/Evan | 2025-08-16 | Closed
7 | Reference/Limit/Golden/Construction samples list | Tongzhang/Evan | 2025-10-18 | Closed | PVT golden and limit sample ID has been signed
8 | Equipment/Fixture readiness | Tongzhang/Evan | 2025-01-08 | Closed
9 | IQC inspector list/training | Tongzhang/Evan | 2025-01-08 | Closed
10 | Measurement&Inspection Qualification(GRR/ARR & Correlation) | Tongzhang/Evan | 2025-11-10 | Ongoing | IQC need to do ARR follow limit sample
11 | Supplier audit plan(For key Non-A parts) | Tongzhang/Evan | 2025-01-08 | Closed
12 | SI arrange plan(For key ME parts) | Tongzhang/Evan | 2025-11-10 | Ongoing | Arrange VN IQC team go to VN N.W.E SI.
13 | Material vendor on-site support plan | Tongzhang/Evan | 2025-01-08 | Closed
14 | Material vendor sorting area & capacity | Tongzhang/Evan | 2025-01-08 | Closed

Sheet: DGL pre-launch
Calypso | Pre-Lauch Checking List
OK to ship day: | 2025-12-08
Planned first ship day: | 2025-12-10
*CM needs to consult with CMM on which column (D or E) when working on new program checklist
 |  |  |  |  |  | Updated by CM
Category | Item | Start Date | Device PIC | Remark | Parking lot | Weekly Status | Weekly Highlights
CM Checking List | Vendor Code /Customer Code | 2 month before OK2S | OEM |  |  | Completed
 | DTMS configuration setup checking for Manual ASIN weights and DIMS, Program configuration, Vendor configuration | 4 weeks before ok2ship | N/A to device |  |  | N/A | Not required for Devices
 | SSCC pre-fix apply with GS1(new CM) | 2 months before OK2ship | DGL NPI |  |  | Completed
 | Ring: SSCC requirement with complaince checking | 4 weeks before ok2ship |  |  |  | N/A | Not required for Devices
 | Check whether Leather Contained or not, if yes, check Leather source with vendor, get prepared to issue Declaration of Leather source for shipment to India and Italy, get prepared to issue COO for India. | 2 month before OK2Ship | MM |  |  | N/A | No leather
 | Battery Documents (UN38.3, MSDS, 3M Drop Test) & Device level Certificate(Safe Transportation Certificate), DG license & process (if any) Readiness and send to LSPs for pre-check, details refer to SOP 4.3 attachment | 1 month before OK2Ship | DGL CMM |  |  | Completed | Have enough MSDS, Test report. No requirement for 3M Drop test.
 | For Magnet document (MSDS / Magnet testing report/Safe Transportation Certificate) | 1 month before OK2S | DGL CMM |  |  | N/A | Non-magnetic Dry battery only
 | CM logistics are required to check the new project whether include below sensitive materials (refer to a sensitive materials in file 4.3 master check list) which may impact the product transportation and need prepare the related certificate to forwarder to check for booking acceptance in advance. | 1 month before OK2S | CM | Sensitive materials 含液体的产品 - Liquid 含磁的产品 - Magnetism 含电池的产品 – battery 含有马达的电器 – Motor 含有粉末 – Powder 化学物质 - Chemicals 含爆炸易燃 - the inflammables and explosives |  | Completed | Dry battery only
 | BOM & Customs registration Readiness | 1 week before OK2SHIP | CM |  |  | In progress | Due date: 28-Nov-2025
 | Shipment in/to CN FCs (if any) Process Review | 2 month before okship | DGL CMM |  |  | In progress | Due date: 10-Nov-2025
 | Pallet type Matrix Check in Agile | 1 month before okship | DGL NPI |  |  | Completed | Follow Pallet Matrix 05-000818 ver 28
 | Vendor Central PO Receiving | 1 month before okship | FP |  |  | Completed | PO received
 | HTS code & PD readiness | 1 month before okship | Global Trade Compliance |  |  | Completed
 | Check ECCN for shipment to IC2S/ICA2 (MX, AU, BR OFFLINE) | 1 month before okship | Global Trade Compliance |  |  | In progress | Due date: 10-Nov-2025
 | Authorization Letter / IPR registration (if applicable) | 1 month before okship | Global Trade Compliance |  |  | N/A | In Vietnam: inapplicable
 | Booking for the first shipment | per timeline of different ship mode | DGL CMM |  |  | Not start | Due date: 26-Nov-2025
 | Check internal counterpart whether FCC certificate was granted for US shipments. | 1 month before okship | DGL NPI |  |  | In progress | Due date: 10-Nov-2025
 | Check internal counterpart whether ISED certificate was granted for Canada shipments. | 1 month before ok2ship | DGL NPI |  |  | In progress | Due date: 10-Nov-2025
 | Check internal counterpart whether WPC import license and AAR filing ready for India shipments | 1 month before ok2ship | DGL NPI |  |  | In progress | Due date: 10-Nov-2025
 | Ring: Pallet packing reliability testing passing confirmation: viabration reliability testing, static storage simulation testing, truck loading/unloading simulation testing, and etc. | 1 month before ok2ship | N/A to device |  |  | N/A | No requirement for Devices
 | Ring: Ring carton and pallet label guide confirmation: please refer to the doc of "5-026425-11_Ring_PACK_LabelGuide_v11a" | 1 month before ok2ship | N/A to device |  |  | N/A | No requirement for Devices
 | Ring: Adile BOM readiness checking | 1 month before ok2ship | N/A to device |  |  | N/A | No requirement for Devices
 | Product packing information confirmation: (1) carton and pallet packing design frozen confirmation, (2) Carton and pallet packing SOP confirmation, (3) pallet usage matrix confirmation, (4) all kinds of length/wedith/height dimension and weight information confirmation, (5) carton and pallet SSCC bar code design confirmation, (6) double pallet stacking design confirmation. (7) Ring - Retail box design drawing passed | 4 weeks before ok2ship | N/A to device |  |  | N/A | No requirement for Devices
 | Required documents for shipping: 1. MSDS documents for dry batteries 2. Test Reports for dry batteries 3. Letters of Indemnity confirming that our batteries comply with the rules for transportation of dangerous goods | per shipment | OEM | Already on hand |  | Completed
Completed
In progress
Not start
N/A

Sheet: OP Trainning plan
Stage | Process | Training contents | Line | OP Hiring | Ops On Board | Training date | OP Training Report | Online | Status
PVT | SMT | a. ESD/ occupational safety b.Feed PCB board c.Machine operation d.Abnormal handing e.Form check f.VI | Line S2 | / | / | 2025/11/05 - 2025/11/10 | 2025-11-12 | 2025-11-14 | Line is allocating for other projects
 |  |  | Line S12 | / | / | 2025/11/11 - 2025/11/16 | 2025-11-17 | 2025-11-19 | Line is allocating for other projects
 |  |  | Line S1 | / | / | 2025/11/15- 2025/11/19 | 2025-11-21 | 2025-11-24 | Line is allocating for other projects
 | BFT | a. ESD/ occupational safety b. Feed PCBA board c. Machine operation d. Abnormal handing e. Form check f. VI | Line 1 ~ Line 4 | / | / | 2025/11/08-2025/11/11 | 2025-11-12 | 2025-11-14 | Follow SMT line start date
 | Routing | PCBA routing | Routing machine | / | / | 2025/11/11-2025/11/14 | 2025-11-14 | 2025-11-17
 | Assembly & Test | a. ESD/ occupational safety b. Fixture operation c. Abnormal handing d. Form check e. VI | Line1 | / | / | 2025/11/11-2025/11/14 | 2025-11-14 | 2025-11-17
 |  |  | Line2 | / | / | 2025/11/13-2025/11/17 | 2025-11-18 | 2025-11-20
 |  |  | Line 3 | / | / | 2025/11/17-2025/11/20 | 2025-11-21 | 2025-11-24
 |  |  | Line 4 | / | / | 2025/11/20-2025/11/24 | 2025-11-25 | 2025-11-27
 | PACKING | a.SOP learning b.Abnormal handing c.Form check d.VI | Manual line 1 | / | / | 2025/11/11-2025/11/14 | 2025-11-15 | 2025-11-18
 |  |  | Manual line 2 | / | / | 2025/11/13-2025/11/17 | 2025-11-18 | 2025-11-20
 |  |  | Manual line 3 | / | / | 2025/11/18-2025/11/21 | 2025-11-22 | 2025-11-25
 |  |  | Manual line 4 | / | / | 2025/11/21-2025/11/25 | 2025-11-26 | 2025-11-28
 |  |  | Manual line 5 | / | / | 2025/11/24-2025/11/27 | 2025-11-28 | 2025-12-01

Sheet: VN layout
1. SMT LAYOUT
2. FATP LAYOUT
Remark: Move packing POR line next to left over 4 packing lines after DVT for PVT

Sheet: Ramp up plan by line
 |  |  |  |  |  |  |  |  |  |  |  |  |  |  |  | 12500
Calypso- PVT/MP SMT input Plan |  |  |  |  |  |  |  |  |  |  |  |  |  |  |  |  |  |  |  |  |  |  |  | Cut off data | Submit reports | Review reports |  |  |  |  | OK2Ship |  | FFS
 |  | Sun | Mon | Tue | Wed | Thu | Fri | Sat | Sun | Mon | Tue | Wed | Thu | Fri | Sat | Sun | Mon | Tue | Wed | Thu | Fri | Sat | Sun | Mon | Tue | Wed | Thu | Fri | Sat | Sun | Mon | Tue | Wed | Thu | Fri | Sat
 |  | 2025-11-09 | 2025-11-10 | 2025-11-11 | 2025-11-12 | 2025-11-13 | 2025-11-14 | 2025-11-15 | 2025-11-16 | 2025-11-17 | 2025-11-18 | 2025-11-19 | 2025-11-20 | 2025-11-21 | 2025-11-22 | 2025-11-23 | 2025-11-24 | 2025-11-25 | 2025-11-26 | 2025-11-27 | 2025-11-28 | 2025-11-29 | 2025-11-30 | 2025-12-01 | 2025-12-02 | 2025-12-03 | 2025-12-04 | 2025-12-05 | 2025-12-06 | 2025-12-07 | 2025-12-08 | 2025-12-09 | 2025-12-10 | 2025-12-11 | 2025-12-12 | 2025-12-13
SMT S2 (6H2G) |  |  |  |  |  |  | 204 | 1200 |  | 2400 | 3600 | 4800 | 6000 | 7200 | 8400 |  | 9600 | 10800 | 12000 | 12000 | 12000 | 12000 |  | 12000 | 12000 | 12000 | 12000 | 12000 | 12000 |  | 12000 | 12000 | 12000 | 12000 | 12000 | 12000
SMT S12 (5H2G) |  |  |  |  |  |  |  |  |  |  |  | 204 | 1200 | 2400 | 3600 |  | 4800 | 6000 | 7200 | 8400 | 9600 | 10800 |  | 12000 | 12000 | 12000 | 12000 | 12000 | 12000 |  | 12000 | 12000 | 12000 | 12000 | 12000 | 12000
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
Efficiency | Plan lines |  |  |  |  |  |  |  |  | 1 | 1 | 1 | 2 | 2 | 2 | 2 | 3 | 3 | 3 | 4 | 4 | 4 |  | 4 | 4 | 4 | 4 | 4 | 4 |  | 4 | 4 | 4 | 4 | 4 | 4
 | Plan shifts |  |  |  |  |  |  |  |  | 2 | 1 | 1 | 4 | 3 | 3 | 3 | 6 | 5 | 5 | 7 | 7 | 7 |  | 8 | 8 | 8 | 8 | 8 | 8 |  | 8 | 8 | 8 | 8 | 8 | 8
Fungible 1.0*UPH*498-Line 1 | DS |  |  |  |  |  |  | FAI |  | 15% | Yield review | 20% | 30% | 40% | 50% |  | 60% | 70% | 80% | 85% | 90% | 95% |  | 95% | 95% | 95% | 95% | 95% | 95% |  | 95% | 95% | 95% | 95% | 95% | 95%
 | NS |  |  |  |  |  |  |  |  |  | 15% | Yield review | 20% | 30% | 40% |  | 50% | 60% | 70% | 80% | 85% | 90% |  | 95% | 95% | 95% | 95% | 95% | 95% |  | 95% | 95% | 95% | 95% | 95% | 95%
Fungible 1.0*UPH*498-Line 2 | DS |  |  |  |  |  |  |  |  |  |  |  | 15% | Yield review | 20% |  | 30% | 40% | 50% | 60% | 70% | 80% |  | 85% | 90% | 95% | 95% | 95% | 95% |  | 95% | 95% | 95% | 95% | 95% | 95%
 | NS |  |  |  |  |  |  |  |  |  |  |  |  | 15% | Yield review |  | 20% | 30% | 40% | 50% | 60% | 70% |  | 80% | 85% | 90% | 95% | 95% | 95% |  | 95% | 95% | 95% | 95% | 95% | 95%
Fungible 1.0*UPH*498-Line 3 | DS |  |  |  |  |  |  |  |  |  |  |  |  |  |  |  | 15% | Yield review | 20% | 30% | 40% | 50% |  | 60% | 70% | 80% | 85% | 90% | 95% |  | 95% | 95% | 95% | 95% | 95% | 95%
 | NS |  |  |  |  |  |  |  |  |  |  |  |  |  |  |  |  | 15% | Yield review | 20% | 30% | 40% |  | 50% | 60% | 70% | 80% | 85% | 90% |  | 95% | 95% | 95% | 95% | 95% | 95%
Fungible 1.0*UPH*498-Line 4 | DS |  |  |  |  |  |  |  |  |  |  |  |  |  |  |  |  |  |  | 15% | Yield review | 20% |  | 30% | 40% | 50% | 60% | 70% | 80% |  | 85% | 90% | 95% | 95% | 95% | 95%
 | NS |  |  |  |  |  |  |  |  |  |  |  |  |  |  |  |  |  |  |  | 15% | Yield review |  | 20% | 30% | 40% | 50% | 60% | 70% |  | 80% | 85% | 90% | 95% | 95% | 95%
 | Working hour |  |  |  |  |  |  |  |  | 19 | 9.5 | 9.5 | 38 | 28.5 | 28.5 | 28.5 | 57 | 47.5 | 47.5 | 66.5 | 66.5 | 66.5 | 0 | 76 | 76 | 76 | 76 | 76 | 76 | 0 | 76 | 76 | 76 | 76 | 76 | 76
Calypso- PVT/MP Packout input Plan |  |  |  |  |  |  |  |  |  |  |  |  |  |  |  |  |  |  |  |  |  |  |  |  |  |  |  |  |  |  | OK2Ship |  | FFS
 | Shift | Sun | Mon | Tue | Wed | Thu | Fri | Sat | Sun | Mon | Tue | Wed | Thu | Fri | Sat | Sun | Mon | Tue | Wed | Thu | Fri | Sat | Sun | Mon | Tue | Wed | Thu | Fri | Sat | Sun | Mon | Tue | Wed | Thu | Fri | Sat
 |  | 2025-11-09 | 2025-11-10 | 2025-11-11 | 2025-11-12 | 2025-11-13 | 2025-11-14 | 2025-11-15 | 2025-11-16 | 2025-11-17 | 2025-11-18 | 2025-11-19 | 2025-11-20 | 2025-11-21 | 2025-11-22 | 2025-11-23 | 2025-11-24 | 2025-11-25 | 2025-11-26 | 2025-11-27 | 2025-11-28 | 2025-11-29 | 2025-11-30 | 2025-12-01 | 2025-12-02 | 2025-12-03 | 2025-12-04 | 2025-12-05 | 2025-12-06 | 2025-12-07 | 2025-12-08 | 2025-12-09 | 2025-12-10 | 2025-12-11 | 2025-12-12 | 2025-12-13
Manual Packing - Line 1 | DS |  |  |  |  | 12 |  |  |  |  | 12 | 760 | 1140 | 1520 | 1900 |  | 2281 | 2661 | 3041 | 3231 | 3421 | 3611 |  | 3801 | 3801 | 3801 | 3801 | 3801 | 3801 | 0 | 3801 | 3801 | 3801 | 3801 | 3801 | 3801
 | NS |  |  |  |  |  |  |  |  |  |  |  | 698 | 1048 | 1397 |  | 1746 | 2096 | 2445 | 2794 | 2969 | 3144 |  | 3318 | 3493 | 3493 | 3493 | 3493 | 3493 | 0 | 3493 | 3493 | 3493 | 3493 | 3493 | 3493
Manual Packing - Line 2 | DS |  |  |  |  |  |  |  |  | 12 |  |  | 12 | 760 | 1140 |  | 1520 | 1900 | 2281 | 2661 | 3041 | 3231 |  | 3421 | 3611 | 3801 | 3801 | 3801 | 3801 | 0 | 3801 | 3801 | 3801 | 3801 | 3801 | 3801
 | NS |  |  |  |  |  |  |  |  |  |  |  |  |  | 698 |  | 1048 | 1397 | 1746 | 2096 | 2445 | 2794 |  | 2969 | 3144 | 3318 | 3493 | 3493 | 3493 | 0 | 3493 | 3493 | 3493 | 3493 | 3493 | 3493
Manual Packing - Line 3 | DS |  |  |  |  |  |  |  |  |  |  |  |  | 12 |  |  |  | 12 | 760 | 1140 | 1520 | 1900 |  | 2281 | 2661 | 3041 | 3231 | 3421 | 3623 | 0 | 3801 | 3801 | 3801 | 3801 | 3801 | 3801
 | NS |  |  |  |  |  |  |  |  |  |  |  |  |  |  |  |  |  |  | 698 | 1048 | 1397 |  | 1746 | 2096 | 2445 | 2794 | 2969 | 3154 | 0 | 3318 | 3493 | 3493 | 3493 | 3493 | 3493
Manual Packing - Line 4 | DS |  |  |  |  |  |  |  |  |  |  |  |  |  |  |  |  | 12 |  |  | 12 | 760 |  | 1140 | 1520 | 1900 | 2281 | 2661 | 3052 | 0 | 3231 | 3421 | 3611 | 3801 | 3801 | 3801
 | NS |  |  |  |  |  |  |  |  |  |  |  |  |  |  |  |  |  |  |  |  |  |  | 698 | 1048 | 1397 | 1746 | 2096 | 2455 | 0 | 2794 | 2969 | 3144 | 3318 | 3493 | 3493
Manual Packing - Line 5 | DS |  |  |  |  |  |  |  |  |  |  |  |  |  |  |  |  |  | 12 |  |  |  |  | 12 | 760 | 1140 | 1520 | 1900 | 2292 | 0 | 2661 | 3041 | 3231 | 3421 | 3611 | 3801
 | NS |  |  |  |  |  |  |  |  |  |  |  |  |  |  |  |  |  |  |  |  |  |  |  |  | 698 | 1048 | 1397 | 1755 | 0 | 2096 | 2445 | 2794 | 2969 | 3144 | 3318
 | Total daily |  |  |  |  | 12 |  |  |  | 12 | 12 | 760 | 1850 | 3340 | 5135 | 0 | 6595 | 8078 | 10285 | 12620 | 14456 | 16837 | 0 | 19386 | 22134 | 25034 | 27208 | 29032 | 30919 | 0 | 32489 | 33758 | 34662 | 35391 | 35931 | 36295
 | Cum total |  |  |  |  | 12 | 12 | 12 | 12 | 24 | 36 | 796 | 2646 | 5986 | 11121 | 11121 | 17716 | 25794 | 36079 | 48699 | 63155 | 79992 | 79992 | 99378 | 121512 | 146546 | 173754 | 202786 | 233705 | 233705 | 266194 | 299952 | 334614 | 370005 | 405936 | 442231
 | WIP |  |  |  |  |  |  |  |  | 843 | 1495 | 1699 | 2964 | 3546 | 3558 | 3558 | 5186 | 7064 | 8886 | 12073 | 15679 | 19518 | 19518 | 24007 | 28062 | 31531 | 34657 | 37347 | 39539 | 39539 | 41067 | 41788 | 42068 | 41841 | 41074 | 39943
Manual Packing - Line 1 | DS |  |  |  |  |  |  |  |  |  | FAI | 20% | 30% | 40% | 50% |  | 60% | 70% | 80% | 85% | 90% | 95% |  | 100% | 100% | 100% | 100% | 100% | 100% |  | 100% | 100% | 100% | 100% | 100% | 100%
 | NS |  |  |  |  |  |  |  |  |  |  |  | 20% | 30% | 40% |  | 50% | 60% | 70% | 80% | 85% | 90% |  | 95% | 100% | 100% | 100% | 100% | 100% |  | 100% | 100% | 100% | 100% | 100% | 100%
Manual Packing - Line 2 | DS |  |  |  |  |  |  |  |  |  |  |  | FAI | 20% | 30% |  | 40% | 50% | 60% | 70% | 80% | 85% |  | 90% | 95% | 100% | 100% | 100% | 100% |  | 100% | 100% | 100% | 100% | 100% | 100%
 | NS |  |  |  |  |  |  |  |  |  |  |  |  |  | 20% |  | 30% | 40% | 50% | 60% | 70% | 80% |  | 85% | 90% | 95% | 100% | 100% | 100% |  | 100% | 100% | 100% | 100% | 100% | 100%
Manual Packing - Line 3 | DS |  |  |  |  |  |  |  |  |  |  |  |  |  |  |  |  | FAI | 20% | 30% | 40% | 50% |  | 60% | 70% | 80% | 85% | 90% | 95.3% |  | 100% | 100% | 100% | 100% | 100% | 100%
 | NS |  |  |  |  |  |  |  |  |  |  |  |  |  |  |  |  |  |  | 20% | 30% | 40% |  | 50% | 60% | 70% | 80% | 85% | 90.3% |  | 95% | 100% | 100% | 100% | 100% | 100%
Manual Packing - Line 4 | DS |  |  |  |  |  |  |  |  |  |  |  |  |  |  |  |  |  |  |  | FAI | 20% |  | 30% | 40% | 50% | 60% | 70% | 80.3% |  | 85% | 90% | 95% | 100% | 100% | 100%
 | NS |  |  |  |  |  |  |  |  |  |  |  |  |  |  |  |  |  |  |  |  |  |  | 20% | 30% | 40% | 50% | 60% | 70.3% |  | 80% | 85% | 90% | 95% | 100% | 100%
Manual Packing - Line 5 | DS |  |  |  |  |  |  |  |  |  |  |  |  |  |  |  |  |  |  |  |  |  |  | FAI | 20% | 30% | 40% | 50% | 60.3% |  | 70% | 80% | 85% | 90% | 95% | 100%
 | NS |  |  |  |  |  |  |  |  |  |  |  |  |  |  |  |  |  |  |  |  |  |  |  |  | 20% | 30% | 40% | 50.25% |  | 60% | 70% | 80% | 85% | 90% | 95%
 | FATP WIP VS Daily demand |  |  |  |  |  |  |  |  | 70.25 | 124.58 | 2.24 | 1.60 | 1.06 | 0.69 |  | 0.79 | 0.87 | 0.86 | 0.96 | 1.08 | 1.16 |  | 1.24 | 1.27 | 1.26 | 1.27 | 1.29 | 1.28 |  | 1.26 | 1.24 | 1.21 | 1.18 | 1.14 | 1.10
SMT Learning Curve
SMT input |  | Day1 | Day2 | Day3 | Day4 | Day5 | Day6 | Day7 | Day8 | Day9 | Day10
Efficiency | Max capacity | 10% | 20% | 30% | 40% | 50% | 60% | 70% | 80% | 90% | 100%
SMT S2 (6H2G) | 12000 | 1200 | 2400 | 3600 | 4800 | 6000 | 7200 | 8400 | 9600 | 10800 | 12000
SMT S12 (5H2G) | 12000 | 1200 | 2400 | 3600 | 4800 | 6000 | 7200 | 8400 | 9600 | 10800 | 12000
SMT S1 (6H2G) | 12000 | 1200 | 2400 | 3600 | 4800 | 6000 | 7200 | 8400 | 9600 | 10800 | 12000
FATP line Learning Curve (Fungible 1.0 *498)
FATP input |  | Day1 | Day2 | Day3 | Day4 | Day5 | Day6 | Day7 | Day8 | Day9 | Day10 | Day11 | Day12 | Day13
Efficiency (Fungible 1.0) |  | 15% | 20% | 30% | 40% | 50% | 60% | 70% | 80% | 85% | 90% | 95% | 95% | 95%
Pack-out line-Learning Curve (Pack out UPH 411/manual line, UPH 500/Auto line)
Pack out input |  | Day1 | Day2 | Day3 | Day4 | Day5 | Day6 | Day7 | Day8 | Day9 | Day10 | Day11 | Day12 | Day13 | Day14 | Day15 | Day16
Efficiency - Manual line |  | 15% | 30% | 40% | 50% | 60% | 70% | 80% | 85% | 90% | 95% | 100% | 100% | 100% | 100% | 100% | 100%
Efficiency - Auto line |  | 3% | 5% | 10% | 20% | 30% | 45% | 55% | 60% | 65% | 70% | 75% | 80% | 85% | 90% | 95% | 95%
Items | Fungible 1.0
UPH/line | 524
Line Qty | 4
Efficiency | 95%
Target Yield Rate | 99.50%
Working hours/Day | 17.75
Working day/Week | 6
DRR | 35167
WRR | 211002
Items | Fungible 1.0
UPH/line | 524
Line Qty | 4
Efficiency | 95%
Target Yield Rate | 99.50%
Working hours/Day | 17.75
Working day/Week | 7
DRR | 35167
WRR | 246169

Sheet: Calypso FCST
FCST version: 20251024145808
Cum FCST | 3441000
Project | PartNumber | SKU | 2025-11-16 | 2025-11-23 | 2025-11-30 | 2025-12-07 | 2025-12-14 | 2025-12-21 | 2025-12-28 | 2026-01-04 | 2026-01-11 | 2026-01-18 | 2026-01-25 | 2026-02-01 | 2026-02-08 | 2026-02-15 | 2026-02-22 | 2026-03-01 | 2026-03-08 | 2026-03-15 | 2026-03-22 | 2026-03-29 | 2026-04-05
Calypso | 53-100275 | US | 9575 | 9017 | 46046 | 63299 | 63408 | 68944 | 49562 | 80453 | 79835 | 63982 | 36103 | 67633 | 54703 | 0 | 69356 | 44582 | 74435 | 30338 | 118143 | 46780 | 66597
Calypso | 53-100276 | DE,FR,IT,ES | 0 | 9434 | 35812 | 104701 | 106381 | 94788 | 37035 | 45473 | 48658 | 59145 | 85211 | 48096 | 63071 | 0 | 30940 | 67535 | 29872 | 31127 | 64154 | 37953 | 97123
Calypso | 53-100763 | AU/NZ | 0 | 40000 | 53060 | 0 | 0 | 1093 | 12 | 5281 | 2377 | 2336 | 2502 | 8128 | 6311 | 0 | 2369 | 3442 | 0 | 5159 | 5265 | 5006 | 2520
Calypso | 53-100764 | JP | 0 | 6240 | 10915 | 20558 | 30048 | 18160 | 12180 | 18428 | 17754 | 21158 | 20766 | 18861 | 16351 | 0 | 15777 | 91945 | 77176 | 106369 | 24635 | 13601 | 10851
Calypso | 53-100765 | IN | 0 | 0 | 0 | 0 | 0 | 0 | 0 | 0 | 0 | 0 | 0 | 0 | 0 | 0 | 13063 | 10463 | 0 | 24357 | 14766 | 24174 | 4720
Calypso | 53-100766 | BR | 0 | 0 | 0 | 0 | 0 | 17839 | 2670 | 7854 | 2664 | 2648 | 2656 | 5555 | 2639 | 0 | 5439 | 2769 | 0 | 35865 | 5417 | 5509 | 12372
Calypso | 53-100767 | MX | 0 | 1496 | 4140 | 5253 | 5125 | 4082 | 1050 | 46430 | 2664 | 2604 | 2664 | 2851 | 2664 | 0 | 2651 | 12552 | 26961 | 8872 | 5476 | 3985 | 8855
Calypso | 53-100769 | ROW-DE | 0 | 0 | 739 | 475 | 523 | 493 | 493 | 537 | 985 | 1130 | 1358 | 1656 | 2198 | 0 | 981 | 976 | 931 | 1217 | 1379 | 911 | 923
Calypso | 53-101569 | CA | 0 | 1622 | 5549 | 5490 | 5517 | 5603 | 2499 | 6546 | 3315 | 5249 | 6992 | 5472 | 9127 | 0 | 2676 | 11315 | 36794 | 2865 | 6934 | 2749 | 7033
 |  |  |  |  |  |  |  |  |  |  |  |  |  |  |  | 0
 | Weekly Cum | (a) | 9575 | 67809 | 156261 | 199776 | 211002 | 211002 | 105501 | 211002 | 158252 | 158252 | 158252 | 158252 | 157064 | 0 | 143252 | 245579 | 246169 | 246169 | 246169 | 140668 | 210994
 | Cum |  | 9575 | 77384 | 233645 | 433421 | 644423 | 855425 | 960926 | 1171928 | 1330180 | 1488432 | 1646684 | 1804936 | 1962000 | 1962000 | 2105252 | 2350831 | 2597000 | 2843169 | 3089338 | 3230006 | 3441000
 | Internal demand | (b) | 1681
 | Trial Run | © | 24 | 24 | 12
 |  | Ramp capacity (d) | 11109 | 68871 | 153713 | 208526
 |  | Gap (d) - (a+b+c) | -171 | 1038 | -2560 | 8750
 |  | Cum | -171 | 867 | -1693 | 7057

Sheet: CTB status
Calypso CTB summary based on 11/07 ver
Project | Item | LPN | Vendor | Description | PVT Shortage date (on CTB) | CNT comments (PVT material status) | Risk level
Calypso | SMT | 17-004193 | AMPHENOL | ANTENNA,CERAMIC,DK30,SMT-2,(16.2x16.2x4. | 2025-12-12 | Amotech can't be used in DVT, need to ask SAA to pull in, next batch 85k ETA VN 12/18, 100k ETA VN 12/25, will keep tracking with supplier | Middle
Calypso | SMT | 15-001086 | Nexperia | DIODE,TVS,UNI-DIR,CAT-2,H/S,2020Q4,0201( | 2025-12-24 | Nexperia export control, can not support. Need to find 2nd source | Middle
Calypso | SMT | 14-010551 | Silergy | IC,PWR MONITOR,Vs=2.7V-5.5V,CMAI=0V-28V, | 2025-11-22 | Silergy replied they had shipped out the 15k materials. Checking with distributor about the ETA | Low
 |  |  |  | HSG

Sheet: Capacity
Case 1: 6 working days, Max WRR 211,002
VN site | SMT * 3A lines |  |  | FATP * 4A lines | Packing * 5M lines
Items | S1 (B+B) | S2 (T+T) | S12 (B+T) | Fungible 1.0 | Manual line
UPH/line | 1250 | 1250 | 460 | 524 | 411
Line Qty | 1 | 1 | 1 | 4 | 5
Efficiency | 90% |  |  | 95% | 100%
Yieldrate | 99.5% |  |  | 99.50% | 100%
Working hours/day | 24 |  |  | 17.75 | 17.75
Working days/week | 6 |  |  | 6 | 6
DRR | 26865 | 26865 | 9886 | 35167 | 36476
CUM DRR | 36751 |  |  | 35167 | 36476
WRR | 161190 | 161190 | 59316 | 211002 | 218856
CUM WRR | 220506 |  |  | 211002 | 218856
Case 2: 7 working days, Max WRR 246,169
VN site | SMT * 3A lines |  |  | FATP * 4A lines | Packing * 5M lines
Items | S1 (B+B) | S2 (T+T) | S12 (B+T) | Fungible 1.0 | Manual line
UPH/line | 1250 | 1250 | 460 | 524 | 411
Line Qty | 1 | 1 | 1 | 4 | 5
Efficiency | 90% |  |  | 95% | 100%
Yieldrate | 99.5% |  |  | 99.50% | 100%
Working hours/day | 24 |  |  | 17.75 | 17.75
Working days/week | 7 |  |  | 7 | 7
DRR | 26865 | 26865 | 9886 | 35167 | 36476
CUM DRR | 36751 |  |  | 35167 | 36476
WRR | 188055 | 188055 | 69202 | 246169 | 255332
CUM WRR | 257257 |  |  | 246169 | 255332

Sheet: Tooling status
No. | Site | Part | LPN | Q'ty | WRR/Tool | Cum WRR (6 working days) | Tooling status
1 | VN | Main housing | 20-105049 | 9 | 38016 | 342144 | Divide into 3 batches: * Batch 1 = 3 Main housing (C01/C05/C06) + 3 Lid housing (C01/C06/C08). Copytool qualification on-going. Tooling ready to use date: 11/10 * Batch 2 = 3 Main housing (C03/C04/C07) + 3 Lid housing (C03/C04/C07). Copytool qualification on-going. Tooling ready to use date: 11/24 * Batch 3 = 3 Main housing (C06/C02/C05) + 2 Lid housing (C02/C09). Tooling ready to use date: 12/01 (with lid housing tool C08 which was qualified from Batch 1)
2 |  | Housing lid | 20-105053 | 8 | 40550 | 324400
※ Risk: No risk so far. First batch's capacity can cover until the remaining tools got qualified
※ Remark:
1. Peak DRR 52,750 ,Peak WRR316,500
2. For Main housing * total 8 sets Copy tools+ 1set Engineering tool, for Housing lid * total 7 sets Copy tools+1 set Engineering tool.
3. Engineering tool need to be replaced with new Cavtiy & Slider by the MP artwork.
※ Capacity by batch:
Batch # | WRR | Part | LPN | Q'ty | WRR/Tool | Cum WRR (6 working days) | Remark
1 | 114048 | Main housing | 20-105049 | 3 | 38016 | 114048
 |  | Housing lid | 20-105053 | 3 | 40550 | 121650
2 | 114048 | Main housing | 20-105049 | 3 | 38016 | 114048
 |  | Housing lid | 20-105053 | 3 | 40550 | 121650
3 | 81100 | Main housing | 20-105049 | 3 | 38016 | 114048 | Will qualify with 1 lid housing tool which was qualified from Batch 1
 |  | Housing lid | 20-105053 | 2 | 40550 | 81100

Sheet: Copy tooling schedule
 |  | OK2Tool |  |  |  |  |  | 8/1 Get final logo artwork
 |  | 2025-06-26 | 2025-06-29 | 2025-07-06 | 2025-07-13 | 2025-07-20 | 2025-07-27 | 2025-08-03 | 2025-08-10 | 2025-08-17 | 2025-08-24 | 2025-08-31 | 2025-09-07 | 2025-09-14 | 2025-09-21 | 2025-09-28 | 2025-10-05 | 2025-10-12 | 2025-10-19 | 2025-10-26 | 2025-11-02 | 2025-11-09 | 2025-11-16 | 2025-11-23 | 2025-11-30 | 2025-12-07
weeks |  | 0 | 1 | 2 | 3 | 4 | 5 | 6 | 7 | 8 | 9 | 10 | 11 | 12 | 13 | 14 | 15 | 16 | 17 | 18 | 19 | 20 | 21 | 22 | 23 | 24
Group | Part Name
1 | Engineering tool | Modify Fabrication--Verify two gating solutions simultaneously (Original Engineering tool +one set of copy tool) |  |  |  | T0 | T1 trial | Texture | T2 | TF/FAI/CMK | LBU DVT 4K Molding in LH | Improve cosmetic |  | DVT main build | transfer to VN | Tool trial FAI ,CPK,DVT 1K molding in VN |  | Tool trial change PVT normal logo | Control Run Molding in VN | CNT FATP+HuaNan Measurement+RREL/ Drop & Tumble+Amazon approve |  | Ramp up
2 | Copy Tools: 4 sets Main housing + 4 sets Housing lid |  | Modify Fabrication |  |  |  | Waiting for gate verification results |  | Complete the reserved processing+T0 |  | T1 | Wait for the engineering tool improve cosmetic result |  | Texture | T2 | TF,FAI/CMK | National Day | transfer VN, TF/FAI/CMK |  |  | Control Run Molding in VN | CNT FATP+HuaNan Measurement+RREL/ Drop & Tumble+Amazon approve |  | Ramp up
3 | Copy Tools: 4 sets Main housing + 3 sets Housing lid |  |  | Modify Fabrication |  |  |  | Waiting for gate verification results |  | Complete the reserved processing+T0 |  | T1 | Wait for the engineering tool improve cosmetic result | Waiting in line for Texture | Texture | T2 |  | TF,FAI/CMK | transfer VN, TF/FAI/CMK |  |  | Control Run Molding in VN | CNT FATP+HuaNan Measurement+RREL/ Drop & Tumble+Amazon approve |  | Ramp up
Remark:
1. Copy tool kick off by 2 group, Main housing 8sets, Housing lid 7sets
2. Group1& Group2 MP in VN,
3. The above Schedule does not include holidays.
4. If there is design modify, the time will be calculated separately.

Sheet: BOM Matrix
Project | Region | 53- PN | 52-PN | 31-PN | Remote | Cable | Pallet q'ty | If have FCST | ASIN | UPC | Packout start date | Build qty (from PVT to OK2ship)
Calypso | US | 53-100275 | 52-100667 | 31-101122 | 52-006181 (primary) 52-100494 (alternate) | 55-100633 | 2664 | Y | B0DJGDC3BD | 840414612631 | 2025-11-12 | 230358
 | DE-FR-IT-ES-GB-IE | 53-100276 | 52-100667 | 31-101122 | 52-006182 | 55-100633 | 2664 | Y | B0DJGCX6Q2 | 840414634510 | 2025-11-18 | 29145
 | AU | 53-100763 | 52-100667 | 31-101122 | 52-006182 | 55-100633 | 2664 | Y | B0DVJ8VJT7 | 840414664043 | 2025-11-20 | 49
 | JP | 53-100764 | 52-100667 | 31-101122 | 52-005905 | 55-100633 | 2628 | Y | B0DVJ64ZLT | 840414695122 | 2025-11-20 | 5317
 | IN | 53-100765 | 52-100667 | 31-101122 | 52-100663 | 55-100633 | 2628 | Y | B0DVJF7528 | 840414652538 | 2025-11-19 | 79
 | BR | 53-100766 | 52-100667 | 31-101122 | 52-100502 (primary) 52-100617 (alternate) | 55-100633 | 2664 | Y | B0DVK166SV | 840414689107 | 2025-11-21 | 58
 | MX | 53-100767 | 52-100667 | 31-101122 | 52-100500 (primary) 52-100615 (alternate) | 55-100633 | 2664 | Y | B0DVJX97PM | 840414612198 | 2025-11-21 | 58
 | NL-PL-SE-ROW | 53-100769 | 52-100667 | 31-101122 | 52-100501 (primary) 52-100619 (alternate) | 55-100633 | 2664 | Y | B0DVK2RPFK | 840414684737 | 2025-11-20 | 8
 | CA | 53-101569 | 52-100667 | 31-101122 | 52-100498 (primary) 52-100611 (alternate) | 55-100633 | 2664 | Y | B0F7K67DY2 | 840414698758 | 2025-11-21 | 62

Sheet: Internal PO build
 |  |  |  |  |  |  |  | PVT start |  |  |  |  |  |  |  |  |  |  |  |  |  |  |  |  |  |  |  |  | OK2ship
Model | SKU | Internal PO qty |  | Total internal PO qty | Packout date | Ship date |  | Mon | Tue | Wed | Thu | Fri | Sat | Sun | Mon | Tue | Wed | Thu | Fri | Sat | Sun | Mon | Tue | Wed | Thu | Fri | Sat | Sun | Mon | Tue | Wed | Thu
 |  | Priority-1 | Priority-2/3/4 | Qty |  | Priority-1 | Priority-2/3/4 | 2025-11-17 | 2025-11-18 | 2025-11-19 | 2025-11-20 | 2025-11-21 | 2025-11-22 | 2025-11-23 | 2025-11-24 | 2025-11-25 | 2025-11-26 | 2025-11-27 | 2025-11-28 | 2025-11-29 | 2025-11-30 | 2025-12-01 | 2025-12-02 | 2025-12-03 | 2025-12-04 | 2025-12-05 | 2025-12-06 | 2025-12-07 | 2025-12-08 | 2025-12-09 | 2025-12-10 | 2025-12-11
53-100275 | US | 952 | 502 | 1454 | 11/19 & 20 | 2025-11-21 | 2025-12-09 |  |  | 339 | 613 | ship out |  |  |  |  |  |  |  |  |  |  |  |  |  |  |  |  | 502 | ship out
53-100276 | DE-FR-IT-ES-GB-IE | 354 | 230 | 584 | 11/18 & 19 | 2025-11-20 | 2025-12-09 |  | 12 | 342 | ship out |  |  |  |  |  |  |  |  |  |  |  |  |  |  |  |  |  | 230 | ship out
53-100763 | AU | 49 | 17 | 66 | 2025-11-20 | 2025-11-21 | 2025-12-09 |  |  |  | 49 | ship out |  |  |  |  |  |  |  |  |  |  |  |  |  |  |  |  | 17 | ship out
53-100764 | JP | 61 | 26 | 87 | 2025-11-20 | 2025-11-21 | 2025-12-09 |  |  |  | 61 | ship out |  |  |  |  |  |  |  |  |  |  |  |  |  |  |  |  |  | 26 | ship out
53-100765 | IN | 79 | 102 | 181 | 2025-11-19 | 2025-11-20 | 2025-12-09 |  |  | 79 | ship out |  |  |  |  |  |  |  |  |  |  |  |  |  |  |  |  |  |  | 102 | ship out
53-100766 | BR | 58 | 8 | 66 | 2025-11-21 | 2025-11-22 | 2025-12-09 |  |  |  |  | 58 | ship out |  |  |  |  |  |  |  |  |  |  |  |  |  |  |  |  | 8 | ship out
53-100767 | MX | 58 | 17 | 75 | 2025-11-21 | 2025-11-22 | 2025-12-09 |  |  |  |  | 58 | ship out |  |  |  |  |  |  |  |  |  |  |  |  |  |  |  |  |  | 17 | ship out
53-100769 | DE-NL-PL-SE-ROW | 8 | 11 | 19 | 2025-11-20 | 2025-11-21 | 2025-12-09 |  |  |  | 8 | ship out |  |  |  |  |  |  |  |  |  |  |  |  |  |  |  |  |  |  | 11 | ship out
53-101569 | CA | 62 | 27 | 89 | 2025-11-21 | 2025-11-22 | 2025-12-09 |  |  |  |  | 62 | ship out |  |  |  |  |  |  |  |  |  |  |  |  |  |  |  |  |  | 27 | ship out
 |  | 1681 | 940 | 2621 |  |  |  |  | 12 | 760 | 731 | 178 | 0
 |  |  |  |  |  |  |  |  | 0 | 0 | 1119 | 3150 | 5135

Sheet: Readines checklist
 |  | Project | Calypso
SMT line | 3A | Line transfer kick off date | /
FATP line | 4A | LBU build wk | PVT 11/17/2025
Package line | 5M | OK2ship date/Approve date | 12/08/2025
 |  | FFS date | 12/10/2025
Category | # | Item | Remark | AMZ DRI | CNT DRI | Status | Due date | Remark
Production line | 1 | Line Set up & Qualification plan | Refer to sheet "Project milestone" & "Line qual summary" | STM Duke Miao/Francis Hu | ME Ryan/Hansen; TE Rain | Open | 2025-11-13
 | 2 | SMT line | Refer to sheet "Project milestone" & "Line qual summary" | STM Francis Hu | ME Hansen | Open | 2025-11-13
 | 3 | FATP line | Refer to sheet "Project milestone" & "Line qual summary" | STM Duke Miao | ME Ryan; TE Rain | Open | 2025-11-15
 | 4 | OBA | Refer to OBA Readiness list | DQM James Hu | PQE a Max/Leon | Open | 2025-11-10
Product identity | 5 | Site Code/Plant code | Site Code: S008538 FULIAN PRECISION TECHNOLOGY LIMITED Lot CN1, Quang Chau Industrial Zone, Nenh Ward, Bac Ninh Province, 22000 |  | PM Ceecee | Close
 | 6 | Project name | Keep no change |  | PM Ceecee | Close
 | 7 | Product # | Keep no change |  | PM Ceecee | Close
 | 8 | BOM | Final BOM need release before PVT start 1 month | NPI PM Luis | PM Ceecee | On-going | 2025-11-10 | BOM list was shared, need Townsend BOM update status to Production before PVT
 | 9 | Device code | Device PN: 52-100667. Device code: 42A | NPI PM Luis | PM Ceecee | Close | /
 | 10 | SN Rule | Will be ready before PVT | / | PE Sally | On-going | 2025-11-10
 | 11 | MAC/Key | Auto MAC/Key will be keep tracking before PVT build 1 wk | NPI PM Luis | PM Ceecee | On-going | 2025-11-10 | DVT leftover MACs & keys can transfer to PVT
 | 12 | Label doc | Label document will be prepared once final BOM released | Package Engineer Do Suh | Package RD Meredith | On-going | 2025-11-11
 | 13 | SOP | SOP will be prepared and get approval before PVT start ~1 wk | STM Duke Miao/Francis Hu | IE Lora | On-going | 2025-11-10 | SOP was sent to AMZ team on 11/4
 | 14 | SIP | SIP will be prepared and get approval before PVT start ~1 wk | DQM James Hu | PQE Max/Leon | On-going | 2025-11-10
Operation | 15 | FCST | FCST has been released | Planning Christy Hu | PM Ceecee | Monitoring | / | Keep tracking with PF update
 | 16 | PO Sequence plan | Need AMZ to release PO 6 wks before ok2ship week (2 wks package material preparation+ 0.5 wk IQC trial run checking + 3 wks ramp up production) | Planning Christy Hu | PM Ceecee | Monitoring | /
 | 17 | ETAC | ETAC running with 53-level BOM from 11/03 | / | PM Ceecee | Close | / | ETAC running every Monday
 | 18 | CTB | Keep tracking for PVT |  | MPM April | On-going | Daily
 | 22 | Shipment plan | Follow PO sequence to arrange | Planning Christy Hu | PM Ceecee | Monitoring | /
 | 23 | Pick up plan | FFS date: 12/10, pick up port: B08 1st floor | DGL Rick Pu | PMC Emma | Open | 2025-12-10
 | 24 | Export customs documents (packing list and invoice) | Exporter title/address | / | PMC Emma | Open | 2025-12-08
Operation system | 25 | Agile/SAP | Follow BOM list to maintain BOM on system | / | PM Ceecee | Close | /
 | 26 | EDI/SFTP | Keep no channel change from AMZ to CNT | / | IT Sunnyone | Close
Control Log | 27 | Control log | OCL, ECL, WCL verification in PVT stage | STM Duke Miao/DQM James Hu | PM Ceecee PQE Leon | Open | 2025-11-13 | Log files are grabbed from Trial run (11/12 input FATP) Control log document to be submitted to AMZ by 11/8
Audit | 28 | QMS audit | Audit items base on AMZ's standard document before trial run. | AMZ team | PQE Max/Leon | Open | 2025-11-11
Summary:

Sheet: Action items
Calypso PVT readiness review action item
No | Item | Contents | CNT DRI | AMZ DRI | Due Date | Status | Remark
3 | Ramp up plan | CNT update ramp up plan which will be add 1 Auto Packing line and reduce 1 manual packing line in ramp period --> Due to abnormal damage during logistics, Auto packing line timeline is extended. Mitigation plan: set up 5th manual packing line for PVT. | PM Ceecee | PM Luis | Weekly | Closed
5 | PVT cost | CNT check and update Total related cost for Calypso PVT --> 1st version quotation sent on 10/17. Need AMZ release PO by 11/17 | BPM Sherine | PM Luis | 2025-11-17 | On-going
9 | Shipping paperworks | Work closely on certification tracking for shipments | PMC Emma | DGL & GTC | 2025-11-10 | On-going
10 | CTB | Update CTB status during PVT to OK2ship | MPM April | MM Tung | Daily | Closed | Refer to CTB status sheet
12 | Pre-CET 2 | Update Pre-CET 2 plan Pending carton ETA 11/8. Loading test ETC 11/13 | PQE Leon | DQM James | 2025-11-08 | On-going

Sheet: Team roster
Calypso's Amazon Core Team
No | Function | Name | Current DRI's email | Remark
1 | Factory OPM | Tran, Teana | maiteana@amazon.com.vn | Involve PVT phase + MP phase
2 | OPM Manager | Sally, Guo | gjianyin@amazon.com.vn
3 | SMT STM | Francis, Hu | frahusuz@amazon.com | PVT + MP phase
4 | FATP STM | Duke Miao | dukemiao@amazon.com | PVT + MP phase
5 | MM |  |  | MP phase
6 | FMQM | Evan Zhong | xiaoyoz@amazon.com | PVT phase
7 | REL |  |  | MP phase
8 | ORT | Khanh, Luong | lpkhanh@amazon.com.vn | PVT + MP phase
9 | DQM | Hu, James | hushin@amazon.com | PVT phase
10 | SOPM
11 | MPM
Calypso- CNT Team Members
No | Function | Names | Email | Remark | OPM / ME / TE / IE /Quality / MFG
1 | OPM | Ceecee Liang | ceecee.qe.liang@fii-foxconn.com
2 | MPM | April Peng | april.zf.peng@fii-foxconn.com
3 | PC | Shi Miao | shi-miao.chen@fii-foxconn.com
4 | MC | Gina Pei | gina.xj.pei@mail.foxconn.com
5 | PMC | Peter Tang | chun-jing.tang@fii-foxconn.com
6 | BPM | Sherine Ye | sherine.sy.ye@fii-foxconn.com
7 | TPM | Cindy Wang | cindy.wc.wang@fii-foxconn.com
8 | RF (VN) | Justin Wei | justin.dw.wu@fii-foxconn.com
9 | EE (TW) | Ken Huang | kenh.hk.huang@fii-foxconn.com
10 | SW (LH) | Sunny Lu | sunny.gz.lu@fii-foxconn.com
11 | SW (VN) | Nora Ruan | nora.by.ruan@fii-foxconn.com
12 | PD | Randy Bai | randy.wf.bai@fii-foxconn.com
13 | RD Packaging | Meredith Huang | meredith.yx.huang@fii-foxconn.com
14 | ME FATP | John Chen | ru-guang.chen@fii-foxconn.com
15 | ME SMT | Hansen Zheng | hansen.gh.zheng@fii-foxconn.com
16 | ME program | Cinamon Wu | cinamon.sg.wu@fii-foxconn.com
17 | TE | Rain Huang | rain.ww.huang@fii-foxconn.com
18 | PE (FA) | Ryann Ruan | ryann.wx.ruan@fii-foxconn.com
19 | PE (BOM) | Sally Ruan | sally.jc.ruan@fii-foxconn.com
20 | IE | Lora Ruan | lora.st.ruan@fii-foxconn.com
21 | AE | Fisher Zhang | fisher.c.zhang@fii-foxconn.com
22 | PQE | Leon Fan | leon.wl.fan@fii-foxconn.com
23 | SQE | Tong Zhang | tong-zhang.yan@fii-foxconn.com
24 | IQC | Tran Thi Nuong | shi-niang.chen@fii-foxconn.com
25 | SMT | Nguyen Van Cuong | csd-vn-smt@mail.foxconn.com
26 | HDMI | Nguyen Kha Son | csd-vn-smt@mail.foxconn.com
27 | SI | Le Van Thuy | csd-vn-si@mail.foxconn.com
28 | Kitting SMT | Nguyen Thi Thom | cbd-vn-kitting@mail.foxconn.com
29 | Kitting SI | Nguyen Van Huy | cbd-vn-kittingb08-3f@fii-foxconn.com
30 | REL | Tonny Pan | tonny.dy.pan@fii-foxconn.com
31 | IT SF | Ly Van Hop | vngz-cbd-sfc@fii-foxconn.com
32 | Security | Daisy Ruan | daisy.sh.nguyen@fii-foxconn.com
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
