Cinthanh1998/Du-an-Foxconn/go-nogo_carnival_asm.stp

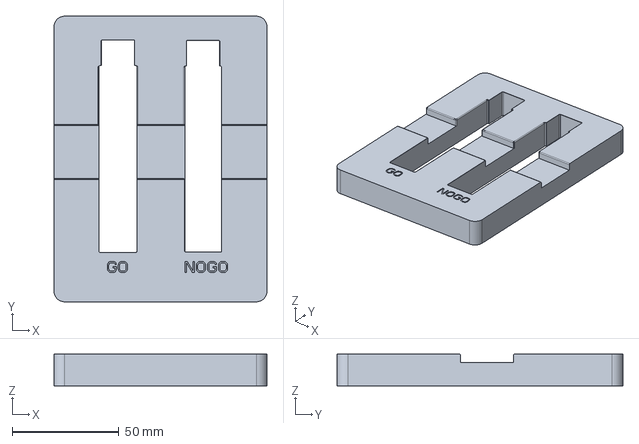
[picture p290: CAD file, 2026-08-19]
go-nogo_carnival_asm.stp
100.0 x 134.1 x 15.0 mm
