Cinthanh1998/Du-an-Foxconn/Assembly CALYPSO ROUTER - rev 02.stp

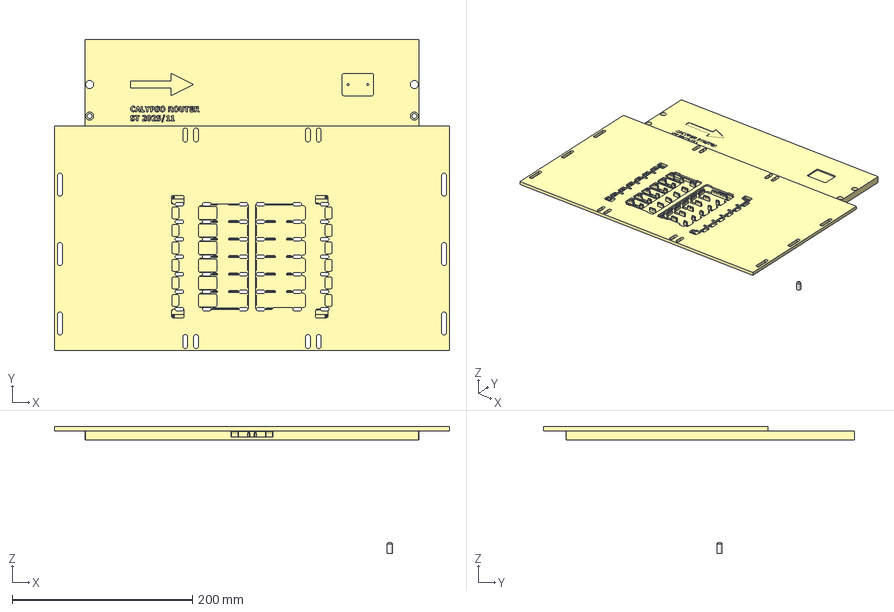
[picture p291: CAD file, 2025-11-17]
Assembly CALYPSO ROUTER - rev 02.stp
438.0 x 345.0 x 140.9 mm
CALYPSO ROUTER - 01
CALYPSO ROUTER - 03
CALYPSO ROUTER - 02
