Cinthanh1998/Du-an-Foxconn/CallaCCD checking EMI fixture.stp

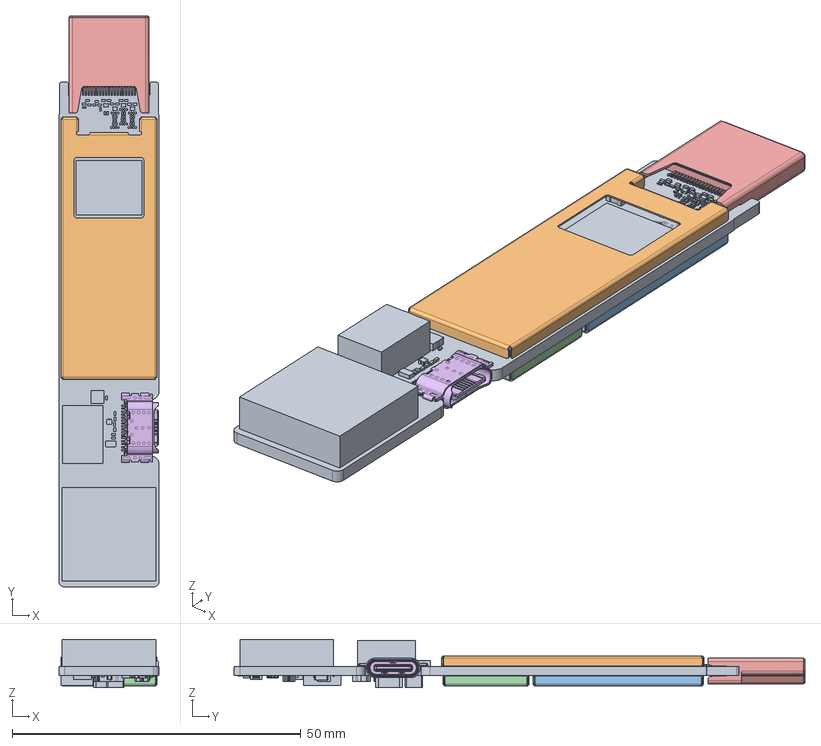
[picture p294: CAD file, 2026-08-10]
CallaCCD checking EMI fixture.stp
17.4 x 98.9 x 8.38 mm
002_CARNIVAL_PCB_1
003_CARNIVAL_SOC_SC_1
003_CARNIVAL_EMMC_SC_1
003_CARNIVAL_WIFI_SC_1
16_PIN_TYPE_1
CARNIVAL_2G_ANTENNA_1
CARNIVAL_5G_ANTENNA_1
COR_P01_30-101383-E3-V2_REV1_1
001_CARNIVAL_TOP_HS_SUB_ASM_1_ASM
CARNIVAL_EMI_ABSORBER_BTM_1
