Cinthanh1998/Du-an-Foxconn/san pham mau..stp

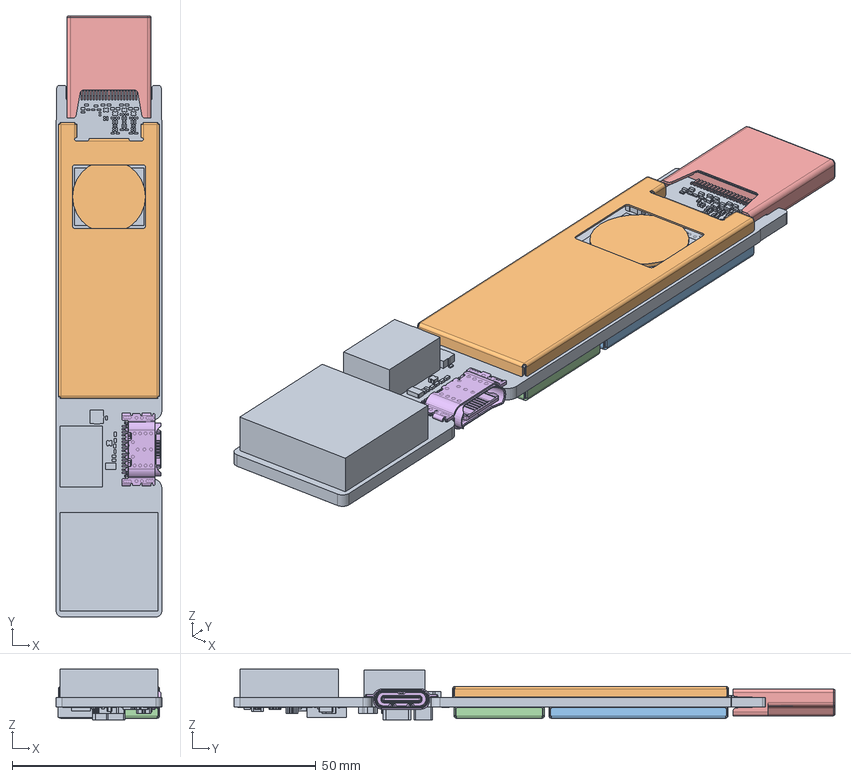
[picture p295: CAD file, 2026-07-22]
san pham mau..stp
17.4 x 98.9 x 8.38 mm
002_CARNIVAL_PCB_1
003_CARNIVAL_SOC_SC_1
003_CARNIVAL_EMMC_SC_1
003_CARNIVAL_WIFI_SC_1
16_PIN_TYPE_1
CARNIVAL_2G_ANTENNA_1
CARNIVAL_5G_ANTENNA_1
COR_P01_30-101383-E3-V2_REV1_1
CARNIVAL_SOC_TOP_THERMAL_GEL_1
CARNIVAL_EMI_ABSORBER_BTM_1
