Cinthanh1998/Du-an-Foxconn/Giftbox packing holder fixture_V1.stp

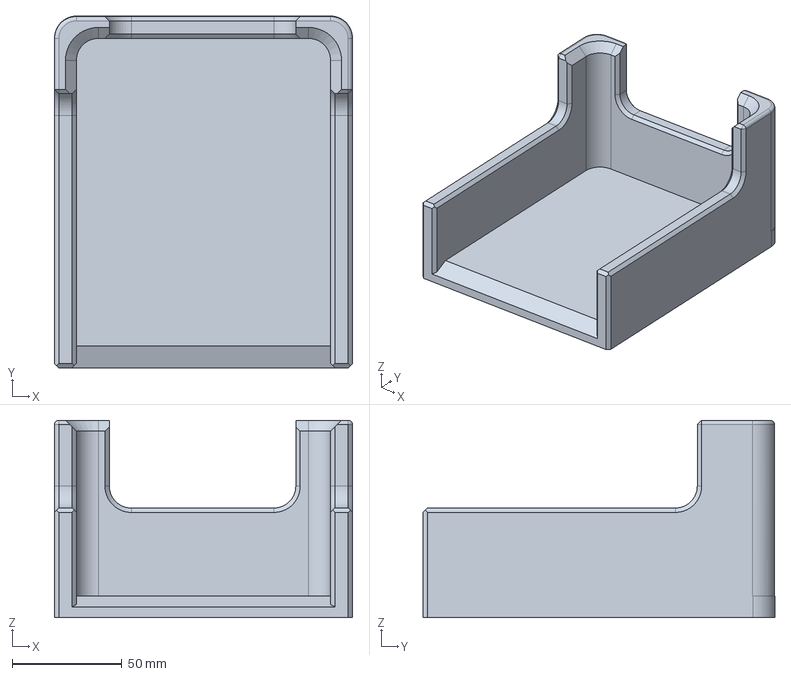
[picture p296: CAD file, 2026-06-20]
Giftbox packing holder fixture_V1.stp
135.8 x 160.4 x 90.0 mm
