Cinthanh1998/Du-an-Foxconn/Refer auto routing fixture drawing Ver 02.stp

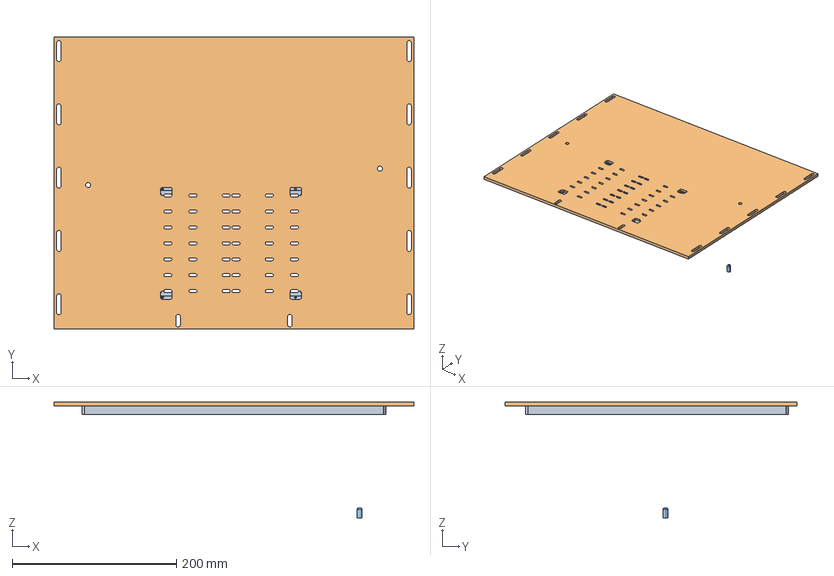
[picture p297: CAD file, 2026-03-19]
Refer auto routing fixture drawing Ver 02.stp
438.0 x 355.0 x 140.9 mm
CALYPSO_ROUTER_-_01_1_1_1_1_1
CALYPSO_ROUTER_-_03_1_1_1_1_1
CALYPSO_ROUTER_-_02_1_1_1_1_1
