Cinthanh1998/Du-an-Foxconn/Refer auto routing fixture drawing Ver 01 .stp

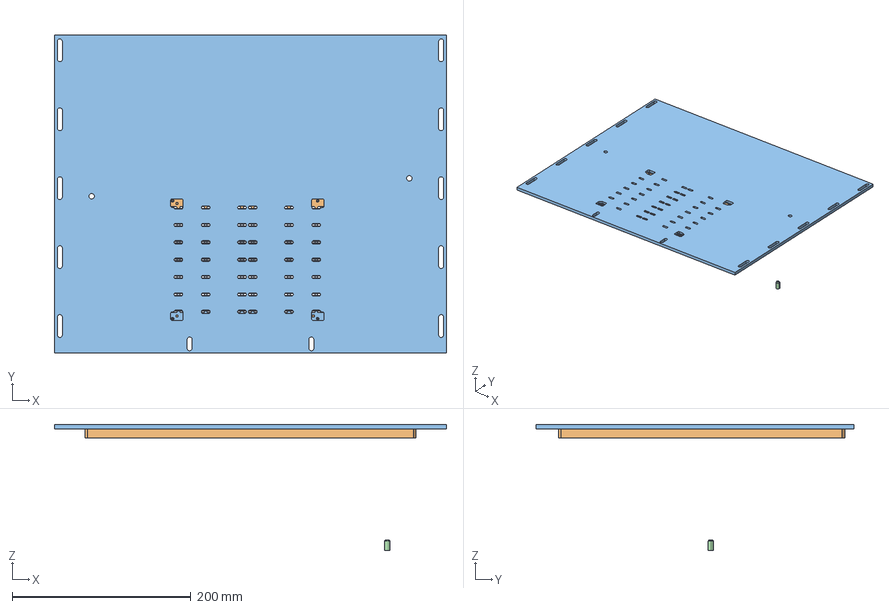
[picture p298: CAD file, 2026-03-18]
Refer auto routing fixture drawing Ver 01 .stp
438.0 x 355.0 x 140.9 mm
CALYPSO_ROUTER_-_01_1_1_1
CALYPSO_ROUTER_-_03_1_1_1
CALYPSO_ROUTER_-_02_1_1_1
003_CARNIVAL_WIFI_SC-2_1_1_1 x 12
2G_PATCH_ANT-2_1_1_1 x 12
5G_PATCH_ANT-2_1_1_1 x 12
003_CARNIVAL_EMMC_SC-2_1_1_1 x 12
003_CARNIVAL_SOC_SC-2_1_1_1 x 12
002_CARNIVAL_PCB-2_1_1_1 x 12
16_PIN_TYPE_C_LONGER-2_1_1_1_1 x 12
16_PIN_TYPE_C_LONGER-2_1_2_1_1 x 12
16_PIN_TYPE_C_LONGER-2_1_3_1_1 x 12
16_PIN_TYPE_C_LONGER-2_1_4_1_1 x 12
16_PIN_TYPE_C_LONGER-2_1_5_1_1 x 12
16_PIN_TYPE_C_LONGER-2_1_6_1_1 x 12
