Cinthanh1998/Du-an-Foxconn/96PCS step-20251121-17H.xlsx

 |  |  |  |  | Part Number : | 52-100667-DVT |  |  |  |  |  |  |  | Supplier : | Amazon |  |  |  |  |  |  | Tool# : | N/A |  |  |  |  |  |  | Date : | 2025-11-21
 |  |  |  |  | Part Description : | Calypso |  |  |  |  |  |  |  | H.H. P/N. : | N/A |  |  |  |  |  |  | Cavity# : | N/A |  |  |  |  |  |  | Work No. : | CNF2500690_1
 |  |  |  |  | Revision : | N/A |  |  |  |  |  |  |  | Revision : | N/A |  |  | -1 |  |  |  | Material : | N/A |  |  |  |  |  |  | Inspector : | S.T.Pan/Y.H.Ning
 |  |  |  |  |  | Front '上 | C04-1 | C04-2 | C03-4 | C03-1 | C07-2 | C03-4 | C03-3 | C03-4 | C03-2 | C07-2 | C07-1 | C04-3 | C03-1 | C07-3 | C03-3 | C04-3 | C04-1 | C04-4 | C04-4 | C04-3 | C03-1 | C03-1 | C04-2 | C04-3 | C07-1 | C07-4 | C03-2 | C07-2 | C03-3 | C07-1 | C04-2 | C04-1 | C04-2 | C07-3 | C07-1 | C07-1 | C03-3 | C03-3 | C03-4 | C07-4 | C03-4 | C03-4 | C04-2 | C07-4 | C07-2 | C04-3 | C07-3 | C07-2 | C07-3 | C04-1 | C07-4 | C03-1 | C07-2
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
